efekrkyn/UGV-01/UGV-01/docs/renders/UGV-01-A1-exterior-concept.png

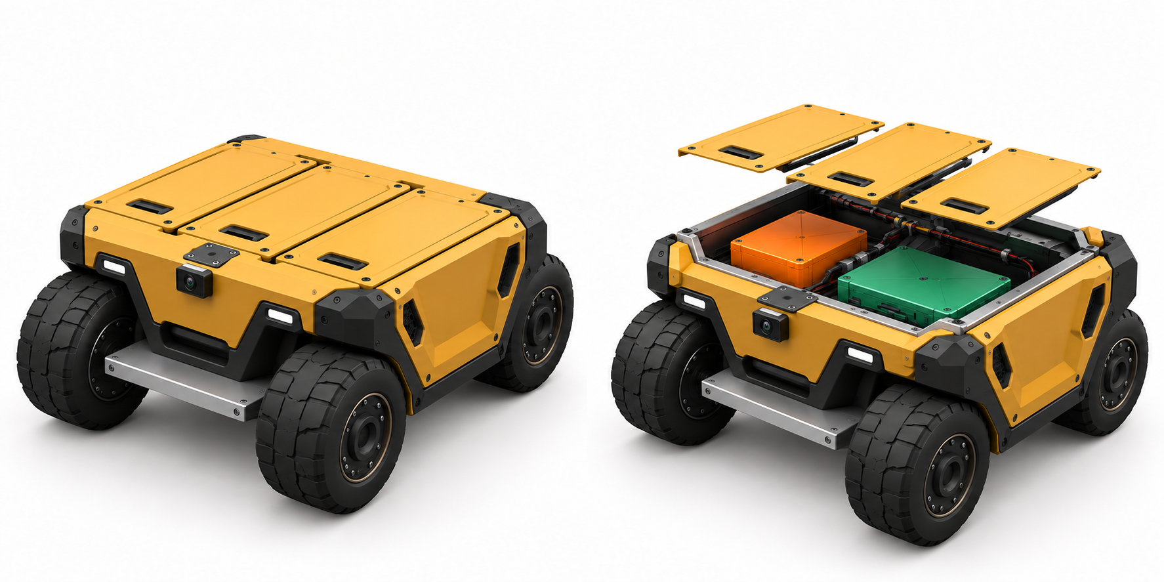
UGV-01/docs/renders/UGV-01-A1-exterior-concept.png
