efekrkyn/UGV-01/README.md

# UGV-01

Küçük, dört tekerli, iki kamera gözlü ve 5 eksenli kollu bir 3D baskı Ar-Ge robotu. Sesli komut ve yapay zekâ ile yönetilecek şekilde tasarlandı; her komut yerelde denetlenir, "dur" ve donanım acil stop her zaman öndedir.

- **Proje, CAD, elektronik, firmware ve yazılım:** [UGV-01/README.md](UGV-01/README.md)
- **Tanıtım filmi ve müziği:** [UGV-01/media/film](UGV-01/media/film/README.md)

Durum: tasarım ve masaüstü kontrolleri tamam; baskı ve fiziksel testler henüz yapılmadı.
