efekrkyn/UGV-01/UGV-01/electronics/ugv_lite_01/README.md

# UGV-LITE-01 bağlantı şeması

A3 Lite: hazır modüllerle (ESP32-S3-DevKitC-1, 2 × TB6612FNG, 3 × Mini560 (mantık rayı + M3'te iki servo rayı A/B, EN = `ACT_EN`), 2 × VL53L0X, 74AHCT1G125) delikli pertinaks kurulumu. DD69: her motor çıkışında 7,5 Ω 10 W balast (R301–R304), dört motorda enkoder A kanalı, E-stop'un ikinci NC kontağı GPIO2'de (SW903, R921/R922/C921), batarya bölücüsü 100 k/22 k. [Şema](lite_wiring.kicad_sch) ve [PDF](lite_wiring.pdf) `tools/build_lite_wiring.py` ile [pin haritasından](../../config/esp32_pinmap.json) üretilir; `tests/check_lite_wiring.py` netlist ve ERC'yi denetler. Ayrıntı: [Lite elektronik](../../docs/lite_electronics_A3.md). **PCB değildir; modül pin sıraları satın alınan kartla doğrulanır.**
