efekrkyn/UGV-01/UGV-01/docs/design_review_response.md

# D2A bağımsız tasarım incelemesi — teknik karşılık

23.09.2026 · Kaynak: [gelen inceleme](design_review_findings.md). Bu belge karar ve açık kanıtları ayırır. Masaüstü kontrolü üretim, montaj veya saha PASS sonucu değildir. Raporda “8” denmesine karşın TIM1/TIM8 başlığıyla **dokuzuncu** teknik bulgu da vardır.

| Bulgu | Doğrulama ve karar | Bu revizyonda yapılan | Kapanış kanıtı |
|---|---|---|---|
| 1.1 J-PWR montajı | İncelemenin z81'i çıplak PCB yüzeyi sayması düzeltildi: z57–81 **kart+bileşen hacmi**, önerilen PCB yüzeyi z58,6; 16,78 mm takılı yükseklik z75,38'e çıkar. Bu yalnız nominal dikey uygunluktur. 4 pin dik açılı **76825-0004** adayı korunur; yatay çıkış/servis ve dış y kenarı hâlâ açık. | [Pin/footprint sözleşmesi](../config/pwr_mcu_connector.json), KiCad pad testi, [kesit ve servis hesabı](electronics_packaging_gate.md) kaydedildi. | Üretici 3B model + mating housing + AWG12 büküm ve mandal/alet süpürmesi tam montaj CAD'inde çakışmasız; sökme sırası belgeli; termal pin derating geçer. **Açık/P0.** |
| 1.2 Kütle | D2A `5,9328 kg` hesap, `67,2 g` boşluk. Kablo ve bağlantı elemanları için 0,30+0,20 kg **zaten bütçede**; tekrar eklemek çifte sayım olur. Gerçek kalemler bu tahsisleri aşabilir. 0,25 kg tasarım marjı için en az `0,1828 kg`, 0,30 kg için `0,2328 kg` ilave net kazanım gerekir. Dört taşıyıcıdan 25 g silmek yalnız 0,10 kg kazandırır; 101 g/parçanın yaklaşık %25'i olduğundan körlemesine cep açılmaz. | [Kütle bütçesi](mass_budget.md) ve karar kapısı düzeltildi. | Gerçek BOM/slicer/harness/vida tartımı; seçilen hafifletme için yatak ve M4 yük yolu/yorgunluk hesabı; montaj marjı ≥0,25 kg veya gerekçeli kütle gereksinimi revizyonu. **Açık/P1.** |
| 1.3 TPU yanağı | D1'de iki jant omzu ve sekiz tork tırnağı var; bunlar pozitif aksiyel kilit kanıtı değil. 8 kg dört teker statik eşit yükte μ=1 için yaklaşık 19,6 N/teker; rapordaki 40 N bir yük aktarımı/pivot tarama senaryosu olabilir, sabit ölçüm değildir. | Risk ve T16'ya yanağın işaretlenmesi/eksenel kayma kontrolü eklendi. | Beadlock/dovetail prototip CAD'i, sökülebilirlik ve baskı yönü; iki yönde 40 N ön tarama + pivot çevrimleri sonrası ayrılma yok. **Açık/P1.** |
| 1.4 Oldham/eksenel | Kaplin serbest diskli; CAD'deki `UGV-MECH-044` aslında **dış rulman bileziği**, kaplin `REF-RULAND-OLDHAM`. Mevcut 21,5 mm nominal zincir endplay'i kanıtlamıyor. Raporun “sıfır aksiyel boşluk” şartı tolerans/ısıl genleşmede rulmanı sıkıştırabilir; ölçülmüş kontrollü endplay gerekir. 1–1,5 mm kaplin aralığı da üretici ve gerçek motor miliyle doğrulanmadan sayısallaştırılamaz. | [Karar kaydı](design_decisions.md) ve test kapısı netleştirildi. | Üretici kaplin montaj açıklığı, rulman/segman/şim tolerans yığını, ölçülmüş sıcak/soğuk endplay ve eksenel yükte serbest dönüş. **Açık/P1.** |
| 2.1 Kabloda I²C | 0,4 m tek uçlu I²C, motor ortamı için doğrulanmamış; **P0 kabul edilmedi**. INA228 ve Kelvin şönt PWR üzerinde yakın kalır; 0,4 m yüksek ortak modlu mikrovolt Kelvin girişini MCU'ya taşımak da ölçüm/arıza riski yaratır. [NXP PCA9615](https://www.nxp.com/products/interfaces/ic-spi-i3c-interface-devices/ic-bus-repeaters-hubs-extenders/two-channel-multipoint-fast-mode-plus-differential-ic-bus-buffer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) ile SCL ve SDA ayrı diferansiyel çiftler olur. | J-SIG 10→12 pin, [KiCad kablo çizimi](../electronics/interconnect/pwr_mcu_harness.kicad_sch) 16 net; [iki PCA9615 referans devresi](../electronics/interconnect/differential_i2c_reference.kicad_sch) 3,3 V/5 V besleme, çift uç sonlandırma ve `EN` bağlantılarıyla ERC'den geçti. | `PGOOD` kaynakları ve PCA9615 gerçek kart şematiklerine taşınacak; 100 kHz EMI/tek damar kopuğu/bus recovery bench testi. Akım sınırlama ölçüm telemetrisinden bağımsız. **Referans devre çizildi; üretim kart devresi açık/P0.** |
| 2.2 PGND referansı | 50–150 mV DC düşüm tek başına tipik 3,3 V dijital eşikleri aşmaz; endüktif transient ve ortak dönüş akımı yine ölçülmelidir. RC'yi MCU_WDI'ya körlemesine koymak sağlıklı darbenin kenarını da bozabilir. PWR_ACT_EN fiziksel izin, yerel pulldown ve nSLEEP/break'e doğrudan etki etmeli. | [Arayüz sözleşmesinde](pwr_mcu_interface.md) tek-GND/ground-bounce ve test gereği korundu; sayısal eşik uydurulmadı. | T02'de 15 A yük/tek GND açık, osiloskopla referans ve kenar ölçümü; şematikte alıcı eşik/histerezis/filtre ve darbe genişliği hesabı; yanlış izin yok. **Açık/P1.** |
| 2.3 Geri besleme | PWR aktif/MCU kapalıyken gelen altı High hat ESD diyodu üzerinden rayı besleyebilir. 1 kΩ ile tek girişte yaklaşık `(3,3−0,7)/1000 ≈ 2,6 mA`; altı girişte yaklaşık 15,6 mA toplam olabilir. Seri direnç **tek başına** güçsüz rayı güvenli yapmaz. | [SN74LVC244APWR kısmi KiCad sayfası](../electronics/ugv_mcu_01/status_receiver.kicad_sch): VCC=0 `Ioff` ≤20 µA/pin, altı kanal, 10 kΩ çıkış pulldown ve OE pull-up netlistte doğrulandı; altı PWR sürücüsü henüz bağlı olmadığından ERC açık. | Gerçek kartta OE/`PGOOD` ve nSLEEP bağlantısı, 0–1,65 V brownout, tüm hatlar ve güç kombinasyonları için hesap + ölçüm; PWR_ACT_EN kopukta Low. **Parça ve kısmi çizim var; açık/P0.** |
| 3.1 E-stop eğim | `8×9,80665×sin(15°)≈20,3 N` geri kaydırır; coast elektriksel enerjiyi keser ama aracı tutmaz. `11` fren enerjisi/VM clamp/kesici sırası ölçülmeden E-stop'un güvenli duruşu yerine geçmez. | [Güvenlik sınırı](safety_architecture.md) ve [T16](test_plan.md) halat+takoz+geri kayma ölçümüne bağlandı. | T13/T16 düşük enerjili eğim testi; bağımsız tether. Sahipsiz eğim/park hedeflenirse normalde kapalı mekanik fren ek gereksinimi. **V1 operasyonel kısıt; fiziksel test açık/P1.** |
| 3.2 TIM1/TIM8 | İki timer faz kayması istenmeyen `11` darbesi oluşturabilir. Master/slave başlatma tek başına atomik güncelleme garantisi değildir; `00` ara durum, preload/update sırası ve break birlikte ölçülmeli. | [Firmware sözleşmesi](software_architecture.md) ve T05 logic analyzer kabulü eklendi. | Gerçek STM32 timer kurulumu, tüm dört IN1/IN2 izleri, reset/duty/yön geçişi ve fault testinde istenmeyen `11` yok. **Açık/P1.** |

Tam kart şematiği, tam montaj CAD'i, PCB layout ve fiziksel numune henüz yok. P0 arayüz tanımı, diferansiyel I²C referansı ve iki kısmi kart arayüz sayfası ilerledi; güvenlik zinciri ve fiziksel doğrulama bunların dışında. PH4/5/6/7 kapıları açık kalır. D2A'nın baskı ve gerçek testleri kullanıcının belirttiği süre boyunca beklemededir.
