efekrkyn/UGV-01/UGV-01/docs/k2_reference_schematic.md

# K2 referans şeması ve ayar zarfı

24.09.2026 · PH6/P0. [KiCad K2 referans şeması](../electronics/ugv_pwr_01/k2_reference.kicad_sch) ve [PDF](../electronics/ugv_pwr_01/k2_reference.pdf), `MID → Q1 → 1 mΩ Kelvin şönt → Q2 → ACT_BUS` adayını gerçek pinlerle gösterir. Bu, **tam UGV-PWR-01 şeması veya güvenlik onayı değildir**. Değerler [TI LM74900-Q1 Rev C](https://www.ti.com/lit/ds/symlink/lm74900-q1.pdf) ve [CSD18540Q5B Rev B](https://www.ti.com/lit/ds/symlink/csd18540q5b.pdf) üzerinden hesaplandı. Şöntün exact MPN/footprint'i, K1, ön şarj/bleed, güvenlik izni, motor yükü ve PCB bakırı henüz tamamlanmadı.

| Ağ / parça | Aday | İşlev ve sınır |
|---|---|---|
| Q1/Q2 | 2×CSD18540Q5BT, 60 V | Q1 ideal diyot, Q2 seri kesici; ortak dren bölgesine R1 girer. K2 kısa arızasında K1 bağımsız kesmelidir. |
| U1 | LM74900QRGERQ1, Texas RGE0024C 4×4 mm | `DGATE` Q1 gate; `HGATE` Q2 gate; `A=MID`, `C/VS` R1 önünde, `OUT=ACT_BUS`. Pad25 `RTN` **GND'ye bağlanmaz**; yalnız elektriksel olarak yüzen lehimli bakır ada. |
| R1/R2 | 1 mΩ ±%1 dört uçlu / 49,9 Ω ±%1 | R1'in iki Kelvin ucu kontrol pinlerine ayrılır; yüksek akım padleri ölçüm yolu değildir. R2 `CS+` ölçekleme direncidir. R1 footprint ve ≥3 W sınıfı sıcaklık/darbe kapasitesi exact ürünle kapanacak. |
| R3/R4/C1 | 31,6 kΩ ±%1 / 100 kΩ / 68 nF ±%10 | Yaklaşık 18,95 A nominal OCP; R4 üreticinin latch-off örneği; timer yaklaşık 0,99 ms nominal. OCP sonrası `EN` yeniden High edilerek kendiliğinden ARM yok: ayrı manuel-reset güvenlik kilidi gerekir. |
| `ISCP` | Pin18 doğrudan `VS`/şöntün yukarı tarafına | Varsayılan 20 mV kısa devre eşiği. `ISCP` boş bırakılamaz: bu, korumayı kaldırır. |
| C2/C3/C4 | 100 nF CAP–VS / 100 nF VS–PGND / 10 nF CS+–CS− | Yerleşimde IC ve şönt yakınlığı gerekli; CS filtresi hızlı SCP gecikmesini laboratuvarda etkilemediği gösterilmeli. İki FET'in katalog azami `Ciss` toplamı 8,46 nF, TI `C_CAP ≥ 10×ΣCiss` önerisi ≥84,6 nF; 100 nF nominal yalnız %10 kapasitör alt sınırında da 90 nF ile geçer. DC bias ve sıcaklık düşüşü ayrıca kontrol edilir. |
| R5 / `SAFE_EN` | 10 kΩ PGND pulldown, SLEEP=EN | Güvenlik donanımı `EN`'i Low tutar. `SLEEP Low / EN High` iç bypass nedeniyle E-stop değildir. `SAFE_EN` kaynağı [güvenlik kapısında](../electronics/ugv_pwr_01/safety_gate.kicad_sch) NC-B beslemeli SN74LVC1T45'tir (`SAFE_GATE ∧ K2_CMD`). |
| R8–R11 | UV 200k/10k, OV 300k/10k, ±%1 | UV kesme 11,55 V nominal, ilk yükselme 12,6 V; OV açma 18,6 V nominal. Bunlar BMS/TVS veya rejeneratif ACT clamp'in yerine geçmez. |
| R6/R7 | FLT için 10 kΩ 3,3 V pull-up; IMON için 5,6 kΩ PGND | FLT, [ARM I/O](../electronics/ugv_pwr_01/arming_io.kicad_sch) TCA9534A P6 girişine gider; UVLO'da da düştüğü için donanım latch girişi bilerek bağlanmadı. IMON 23 A tipikte yaklaşık 2,32 V; ADS1115 AIN3'e 1 kΩ seri dirençle gider. |

**Eşik toleransları:** TI OCP tipik formülü `I_OC = 12·RSET/(RSENSE·RILIM)` verir: `12·49,9/(0,001·31600)=18,95 A`. TI yükselen karşılaştırıcı sınırları 1,08/1,22/1,32 V ve üç direncin ±%1 kombinasyonu ile ilk yaklaşık OCP aralığı **16,28–21,13 A** olur. SCP katalog 17,86/20/22,77 mV ve 1 mΩ ±%1 ile **17,68–23,00 A** olur. SCP bazı tolerans köşelerinde OCP'den önce, bazı köşelerde sonra gelir; bu iki koruma aynı kesin sınır gibi sunulmaz. Katalog timer akımı 65–97 µA, kesme gerilimi 1,1–1,4 V ve C1 ±%10 ile basit `C·V/I` taraması **0,69–1,61 ms** verir; TI'nin nominal 82,3 µA formülü yaklaşık0,99 ms. PCB paraziti, filtre ve gerçek transient ayrıca ölçülecek.

**Neden 31,6 kΩ:** Dört DRV8874 için her köprüde 2,915 A statik üst akım sınırı taslağı 11,66 A eder. 6 V×4 A servo rayı, 12,4 V batarya ve varsayılan %85 verimde 2,28 A giriş ister; birlikte yaklaşık **13,94 A**. OCP'nin 15 A tipik seçimi alt toleransta yaklaşık12,8 A'a düşerek bu zarfı kesebilir. 31,6 kΩ'un alt köşesi 16,28 A'dır; yine servo stall/dinamik akım ölçülmeden yeterli marj ilan edilmez. F1=15 A sigorta anlık 15 A kıskacı değildir ve `I²t`/kablo koordinasyonu açık. K2'nin 15 A sürekli termal onayı da açık; OCP yüksek ayarı onu vermez. Motorlar normal çalışmada ayrı köprü akım sınırlaması ve MCU RMS kısıtı altında kalmalıdır.

**Güç/ısı:** R1'de 15/20/23 A için sırasıyla0,225/0,400/0,529 W; sıcak FET `RDS(on)=2×2,2 mΩ` senaryosunda iki FET toplamı1,98/3,52/4,66 W. Bu senaryo garantili sıcak maksimum değildir. 50 °C kasa havası ve her FET için 1 in²/2 oz bakıra dayanan 50 °C/W katalog termal koşulu 120×80 mm PWR kartında otomatik sağlanmaz. MOSFET SOA, 60 V dren transiyenti, ters/yenilemeli akım ve R1 sıcaklığı gerçek yerleşimle incelenmeden PCB serbest bırakılamaz.

**Şema kontrolü:** [Netlist testi](../tests/check_k2_reference.py) U1 fiziksel pinleri, iki FET, Kelvin ucu, EN/SLEEP ve elektriksel yüzen pad25'i kontrol eder. 24.09.2026'dan beri sayfa [UGV-PWR-01 kısmi hiyerarşisinin](pwr_safety_path.md) parçasıdır: sayfalar arası ağlar global etikettir ve `PGND` PWR_FLAG'i arayüz sayfasına taşındı. Tek başına ERC artık 1 beklenen hata (U1 GND pin13 `PGND`'nin sürücüsü başka sayfada) ve 4 uyarı verir: 3 yerel `UGV` kütüphane çözümlemesi ve harici `PWR_3V3` tek-pin etiketi. Birleşik kök ERC'si 0 hatadır; [check_pwr_board](../tests/check_pwr_board.py) `SAFE_EN` sürücüsünü, pad25'in yüzdüğünü ve izin mantığını denetler. Netlist/şema fiziksel T01/T13 ölçümü yerine geçmez.
