efekrkyn/UGV-01/UGV-01/docs/review_dd92_dd93_2026-09-30.md

# DD92–DD93 bağımsız doğrulama — 30.09.2026

**Sonuç: düzeltmelerin önemli bir bölümü doğrulandı; “A01–A08 ve M01–M03 tamamen kapandı” sonucu desteklenmiyor.** İki P1 ve dört P2 bulgu kaldı. Mevcut testlerin geçmesi bu karşı örnekleri kapsamıyor. Üretim veya sürüş onayı verilmedi.

İnceleme, `42524c9d271edaa842ca49b30e2747520887d61b` üzerine bırakılmış, commit edilmemiş DD92/DD93 çalışma ağacına yapıldı. Kaynak, config ve mevcut dokümanlar değiştirilmedi. Yalnız bu rapor ve yeniden üretim kanıtları eklendi. Önceki [tam inceleme](review_full_2026-09-29.md) ve Claude'un [kapanış kaydı](review_full_closure_2026-09-29.md) korunmuştur. Bu rapor kapanış iddialarını doğrular; önceki tam incelemenin fiziksel kabul kapılarını kaldırmaz.

## Doğrulama sonucu

| Kontrol | Bağımsız sonuç | Sınır |
|---|---|---|
| `tests/README.md` masaüstü takımı | **34/34 PASS** | Modeller ve yazılım testleri |
| ESP-IDF 5.3.2 Docker derlemeleri | **ESP32-S3 ve ESP32-CAM PASS** | Donanıma yükleme yapılmadı |
| Graf/pin/hesap/CAD/baskı planı yeniden üretimi | **8/8 komut PASS**, manifestte anlamsal fark yok | İzole çalışma kopyasında |
| Üretilen mekanik | **103 STEP parçası, 74 baskı parçası, 42 M3 insert** | Satın alınan referans zarfları da STEP sayısında |
| Nominal kol açıklığı | park→kaldır **4,75 mm**, hazır→öne-orta **5,26 mm** | 1° örnekleme; sürekli hareket ispatı değil |
| Parktaki ±1° beş eklem toleransı | **4,1 mm**, 32 köşe | Baskı, boşluk, esneme ve kalibrasyon ölçülmedi |
| Fiziksel T01–T20 / TL1–TL6 | **NOT_RUN** | Tasarımın çalıştığı iddiası kurulamaz |
| Başlangıç kaynak parmak izleri | **219/219 değişmemiş** | İnceleme sırasında mevcut dosyalar korunmuş |

Komutlar ve sonuçlar [verification.json](review_evidence/dd92_dd93_2026-09-30/verification.json) içindedir. Yeni karşı örnekler aşağıda ayrıca listelenmiştir; bunları mevcut 34 testin PASS sonucuna katmadım.

## Önceki bulguların kapanışı

| Kimlik | Durum | Gerekçe |
|---|---|---|
| A01 | Doğrulandı | 32 baytlık anahtar şartı; eksik/geçersiz anahtarla komut ve telemetri reddi |
| A02 | **Kısmi — R01** | Eski `1200 mm + hata` örneği kapanmış; `8190/8191 + hata` hâlâ açık yol |
| A03 | Doğrulandı | Gerçek yerel WebSocket sunucusunda yabancı/eksik Origin 403, ikinci sahip 1008, yanıt doğru sokete, kopuşta izin düşüyor |
| A04 | Eski örnek kapandı; **yeni R02 açık** | Kaybolan aç komutu sürüşü serbest bırakmıyor; reset ve manuel park pençe bilgisini güvenli biçimde uzlaştırmıyor |
| A05 | **Kısmi — R03** | Tek hedefte 255 cevapsız komut hatası doğru; tekrarlanan hedeflerde 12 bit yankı yine alias yapıyor |
| A06 | Doğrulandı | Semantik olarak reddedilen kenar uygulanmış-komut yankısını ilerletmiyor |
| A07 | Doğrulandı | Açık yeniden kurma yeni oturum ve doğrulanmış telemetriyle bağı yeniliyor; reset ortasında hareket sahte başarıya dönüşmüyor |
| A08 | Ana sayısal düzeltmeler doğrulandı | 15 A, baş 1,6 mm, açıklık taraması 1°, güncel CG kayıtları; yeni pençe kavrama datumu için R06 kaldı |
| M01 | **Kısmi — R05/R06** | Hareketli çeneler gerçekten modellenmiş; B çenesinin eksenel tutma/montajı ve gerçek kavrama noktası tamamlanmamış |
| M02 | Bağlantı konsepti doğrulandı | Sekiz cıvata ve insert/delikler var; aşağıdaki G01 dayanım doğrulaması açık |
| M03 | **Kısmi — R04** | Omuz bileziği/pul var; sol üst kolun sonraki bağlantısının yük yolu yok |

## Kalan bulgular

### R01 — P1: Geçersiz ToF sonucu açık yol olarak kullanılıyor

Kaynak: [vl53l0x.c:150](../firmware/lite/vl53l0x.c#L150), özellikle `reading()` içindeki `status 4/6/9 && mm >= 8190` dalı. [Mevcut test](../tests/vl53l0x_test.c#L125) bu istisnayı beklenen davranış olarak kodluyor.

Gerçek sürücüyü register modeliyle çalıştırdım: iki sensörde raw status 4, 6 ve 9 + 8190 mm ayrı ayrı **8190,8190** döndürüyor. Çekirdek bu sayıyı geçerli uzak mesafe gibi kullanıyor; sıfır/200 mm engel kilidi devreye girmiyor. Raw kod ile API `RangeStatus` kodu aynı şey değildir; bu kodların sinyal/faz hatası olması, ortamın boş olduğunu kanıtlamaz. ST, sinyal hatasını yetersiz mesafe güveni, faz hatasını wraparound/gürültü olarak tanımlar. [ST UM2039, §5.3/Table 1](https://www.st.com/resource/en/user_manual/um2039-world-smallest-timeofflight-ranging-and-gesture-detection-sensor-application-programming-interface-stmicroelectroni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).

Bu, fiziksel olarak siyah/cam bir hedefe çarpıldığı iddiası değildir; yazılımın güvensiz ölçümü “açık” sınıfına yükselttiğinin kanıtıdır. Açık alanda bir kez aynı kodu görmek bu ayrımı doğrulamaz. Geçersiz ölçümü bilinmeyen/engelli tut; açık alan politikasını gerekiyorsa ayrıca tasarla ve açıkça sınırlandır. Kalıcı testte 8190 ve 8191 dahil tüm hata kombinasyonları eski geçerli ölçümü düşürmeli ve ileri kilidini korumalı.

Kanıt: [tof_invalid.c](review_evidence/dd92_dd93_2026-09-30/tof_invalid.c).

### R02 — P1: Yeniden başlatma ve manuel park pençe güvenlik durumunu geri getiriyor

Kaynak: [lite_core.c:29](../firmware/lite/lite_core.c#L29), [park_confirm():38](../firmware/lite/lite_core.c#L38).

İki bağımsız C karşı örneği:

1. `ready`de pençeyi tamamen aç → IDLE ile aktüatörleri kapat → elle kol parkı için 0x123 → yeniden ARM. **Kol STOW, pençe hedefi/konumu 6000, PWM 2167 µs, ACT_EN=1.** `park_confirm` beş kol eklemini parkta varsayıyor, pençenin eski açık hedefini koruyor. Operatör pençeyi elle kapatmış olsa bile yeniden kurulunca eski açık PWM geri gönderilir. Açık STOW katı modelinde çene 055 ile yan panel 010 kesişimi **236,965 mm³**; ayrıca kapak/çamurluk kesişimleri var. DD93'ün kendi mekanik kuralına göre de parkta açık çene yan duvara çarpar; yeni bir “aç” komutu gerekli değildir. Bu fiziksel çarpışma deneyi değil, gerçek firmware çıkışı ile CAD'in birlikte gösterdiği tehlikedir.
2. `reach_low`da kavrama kapanışı → park: **empty=0, sürüş yasak**. MCU yeniden başlat → IDLE/park onayı/ARM; pençe açılmadan **empty=1, sürüş izinli, dört PWM=287‰**. `lite_core_init` nesnenin bırakıldığına ilişkin kanıt olmadan boş işaretini geri kuruyor. Bu bir durum modeli karşı örneğidir; gerçek bir nesneyle fiziksel deney yapılmadı.

Ek gözlem: `ready`de aç→kapat da boş işaretini temizlemiyor; yalnız üç GRASP düğümü nesne kavrayabilir varsayımı mekanik olarak garanti edilmiyor. Bunu reset düzeltmesinden ayrı bir politika testi olarak ele al.

Kurtarmada kol, pençe hedefi/konumu ve boş/bilinmeyen bilgisi birlikte uzlaştırılmalı. Otomatik açma veya kapanmayı parkta çözüm sayma; yeni hareket güvenli poz bilinmeden başlatılmamalı. Manuel onay kullanılacaksa operatörün **kapalı ve boş pençeyi** doğruladığı açık sözleşme, host mesajı ve firmware kapısı olmalı. Watchdog, güç kesme, IDLE, E-stop, eski aç hedefi, paket kaybı ve yeni oturum kombinasyonlarını kalıcı testlere taşı.

Kanıt: [gripper_park_open.c](review_evidence/dd92_dd93_2026-09-30/gripper_park_open.c), [gripper_empty_reset.c](review_evidence/dd92_dd93_2026-09-30/gripper_empty_reset.c).

### R03 — P2: 12 bit ACK tekrarlanan hatalarda hâlâ sahte onay veriyor

Kaynak: [vehicle.py:194](../software/ugv_lite/vehicle.py#L194), özellikle `_answers`, `set_arm` ve `hold_arm`.

Aynı oturumda **bütün 0x122 paketlerini düşür**, `arm stow` isteğini 17 kez tekrarla. İlk 16 istek 255 gönderimde doğru hata verir. 17. istekte **seq=4097, echo=0, answered=True, sonuç ok=True**. Çekirdek hiçbir kol komutu almamıştır. Yeni hedef `arm_fault`u temizler; hedef başına 255 sınırı toplam cevapsız akışı 4096'dan önce durdurmaz.

Bu örnekte kol zaten stow'dadır; yanlış duruşa ulaşıldığı veya doğrudan çarpışma olduğu iddia edilmez. Sorun “çekirdek bu isteği aldı” sözleşmesinin bozulmasıdır. Önceki ACK ile yeni komut penceresini alias yapamayacak biçimde ayır; cevapsız hatadan sonra açık oturum kurtarması da bir seçenek. Yalnız sıfır yankıyı atlamak yetmez: eski sıfır olmayan ACK de 4096 sonra eşleşebilir. Testler ardışık başarısız hedefleri, hold, eski sıfır olmayan yankı ve 16 bit sarımını kapsamalı.

Kanıt: [software_recheck.py](review_evidence/dd92_dd93_2026-09-30/software_recheck.py).

### R04 — P2: Pasif sol kolun A→B bağlantısı modellenmemiş

Kaynak: [build_concept.py:548](../cad/assembly/build_concept.py#L548), [sağ kola özel adaptör:606](../cad/assembly/build_concept.py#L606); [mekanik belge](lite_mechanical_A3.md) “sol eklemler kendi cıvatalarıyla sabit” diyor.

Sol kol sağın boş servo/rulman yuvalarını kullanıyor. B'nin iki M3 deliği sağ kolda 059 adaptörüne gider; **sol 059, twist rulmanı veya bunların yerini alan sabit bağlantı yok**. Bağımsız CAD ölçümünde sol 050 ve 051 arasında **1,0 mm minimum boşluk** var. Omuzda tasarlanan bilezik bu sonraki eklemi bağlamaz; vida listesi de sol için tamamlanmış alternatif bağlantı vermez.

Pasif sol uzuvlar için gerçek sabit bağlantı/ara parça tasarla veya açıkça tanımlanmış birleşik üretim parçasına dönüştür. Cıvata karşılıkları, eksenel tutma ve yük yolu CAD/BOM/montajda bulunmalı. Diğer pasif eklemleri de aynı yük yolu incelemesinden geçir; yalnız çarpışma testi yeterli değildir.

### R05 — P2: B çenesinin pim bağlantısında sıkma ile dönme ayrılmamış

Kaynak: [palm postu:585](../cad/assembly/build_concept.py#L585), [B çenesi:603](../cad/assembly/build_concept.py#L603), [vida listesi:140](../tools/print_plan.py#L140).

7 mm kalınlıktaki dönen çene M3 geçiş deliğiyle, avucun 2,5 mm pilot deliğine giren M3×16 vida altında tutuluyor. Post ile çene arasında 0,5 mm açıklık var. **Omuzlu pim, sıkmayı taşıyan burç/spacer, belirlenmiş eksenel boşluk veya gevşek vidayı kilitleme prosedürü yok.** Vida normal montaj gibi sıkılırsa çeneyi sıkıştırır; gevşek bırakılacaksa boşluk ve tutma tarif edilmemiştir. İdeal eksen etrafında CAD dönüşü bu montaj sorununu denetlemiyor.

Bu bulgu fiziksel sıkışma ölçümü değil, tekrarlanabilir üretim/montaj tarifinin eksikliğidir. Eksenel tutma ve serbest dönmeyi ayıran bir çözüm seç, ölçülendir, BOM'a ekle; çene/post boşluğu ve montaj torkunu tanımla. Kupon testinde vida son montaj koşulundayken 0–60° hareketi ve boşluğu ölç.

### R06 — P2: Yeni çenelerin gerçek kavrama merkezi eski datumdan yaklaşık 18 mm farklı

Kaynak: [grip_point():723](../cad/assembly/build_concept.py#L723), [TPU pedler:622](../cad/assembly/build_concept.py#L622), [payload hesabı:98](../tools/body_mass_screen.py#L98).

`grip_point()` hâlâ eski `xw+L3, side*YA, zs` noktasını “kavrama merkezi” olarak yayınlıyor. Yeni kapalı TPU pedlerin ortak yüzünün orta noktasını katılardan bağımsız hesapladım:

| Poz | Belgelenen/manifest nokta mm | Gerçek ped orta noktası mm | Fark |
|---|---|---|---:|
| öne-orta | 265,3 / −10,0 / 45,3 | 281,13 / −11,83 / 53,53 | **17,94 mm** |
| depola | 125,0 / −25,8 / 233,0 | 108,50 / −18,95 / 231,42 | **17,93 mm** |

Diğer pozlarda da yaklaşık aynı rijit ofset var. Bu nokta belge ve manifestin yanı sıra eldeki nesne/kargodaki yük yerleşimi hesabına giriyor. Kargo ağzının kaçırıldığı veya mevcut devrilme kriterinin bozulduğu gösterilmedi; mevcut yayınlanan kavrama koordinatı gerçek parçayla aynı değil.

Gerçek tool/grasp datumunu çene/ped geometrisinden tek kaynakta tanımla; kapalı/açık ve farklı nesne kalınlıklarının anlamını belirt. Manifest, doküman, fizik modeli ve ilgili dönüşümleri yeniden üret. Gerçek kargo merkezini, bırakma noktasından ayrı tut. Geometriye karşı datum testi ekle; kalibre edilmiş kamera→kol dönüşümü daha sonra bunun üzerine kurulmalı.

Kanıt: [geometry_recheck.py](review_evidence/dd92_dd93_2026-09-30/geometry_recheck.py), [ölçümler](review_evidence/dd92_dd93_2026-09-30/geometry_measured.json).

## Açık doğrulama kapıları

**G01 — Şasi eki dayanımı:** sekiz bağlantı gerçekten var. Ancak mekanik belgedeki “3,5 N·m → 90 N cıvata kesmesi → 6 MPa PETG ezilmesi → 6 kat pay” hesabı, düşey cıvatalı plaka/kiriş ekinin düzlem dışı eğilmede oluşturduğu **eksenel cıvata/insert çekmesi, plaka esnemesi ve prying** yüklerini kapsamıyor. Mevcut hesabı tüm ekin doğrulanmış güvenlik katsayısı gibi kullanma. Serbest cisim diyagramı ve gerçek kol mesafeleriyle yük yolunu hesapla; baskı yönü, insert çekip çıkarma ve sehim deneyi gerekli.

**G02 — Baskı/servo/pençe:** park toleransının 4,1 mm olması olumlu. Bağımsız ek **0,25° çene taramasında 241 örnekte kendi parçalarıyla çarpışma yok**. Park→kaldır boyunca 91 omuz açısı ×32 adet ±1° hata köşesinde, sağ yan panellere minimum açıklık **4,100013 mm**. Bu ikinci tarama yalnız yan duvarlara yöneliktir; bütün engellerin toleranslı taraması değildir. Katı model sonuçları gerçek servo hatası, dişli boşluğu, kablo yükü ve PETG esnemesini kapsamaz. 150 g tutma kuvveti ve TPU sürtünmesi katalog/model varsayımıdır. Sol omuz için 0,24/(0,0151×0,5) ≈32 N hesabı tutarlı; gerçek sürtünme ve creep ölçülmemiştir.

**G03 — Elektrik ve özgün kapsam:** E-stop DC kesme değeri, 15 A sigorta koordinasyonu, Mini560 EN ve termal/geri sürülme sınırları önceki rapordaki gibi açık. Aktif revizyon A3 Lite ESP32 + MacBook mimarisidir; ilk CM5/STM32/özel PCB/ROS 2 hedefinin tamamlandığı anlamına gelmez. Tanıtım filmi yeni çenelerin doğrulama kanıtı değildir.

## Yeniden üretim

Depo kökünde çalıştır. Gerçek anahtar, donanım veya ücretli API kullanılmaz. C karşı örnekleri mevcut test yardımcılarını yeniden kullanır. Betiklerde kusurlu mevcut çıktıların assert edilmesi **hata üretildi** demektir; güvenli davranış kabul testi PASS'i değildir. Düzeltirken beklentileri güvenli davranışa çevirip kalıcı testlere taşı.

```sh
cc -std=c11 -Wall -Wextra -Werror docs/review_evidence/dd92_dd93_2026-09-30/tof_invalid.c firmware/lite/vl53l0x.c -o /tmp/ugv-review-tof
/tmp/ugv-review-tof
cc -std=c11 -Wall -Wextra -Werror docs/review_evidence/dd92_dd93_2026-09-30/gripper_park_open.c firmware/lite/lite_core.c firmware/lite/arm_path.c firmware/lite/lite_link.c firmware/lite/hmac_sha256.c firmware/stm32/can_protocol.c firmware/stm32/servo_control.c firmware/stm32/light_bar.c -lm -o /tmp/ugv-review-park
/tmp/ugv-review-park
cc -std=c11 -Wall -Wextra -Werror docs/review_evidence/dd92_dd93_2026-09-30/gripper_empty_reset.c firmware/lite/lite_core.c firmware/lite/arm_path.c firmware/lite/lite_link.c firmware/lite/hmac_sha256.c firmware/stm32/can_protocol.c firmware/stm32/servo_control.c firmware/stm32/light_bar.c -lm -o /tmp/ugv-review-empty
/tmp/ugv-review-empty
python3 docs/review_evidence/dd92_dd93_2026-09-30/software_recheck.py
python3 docs/review_evidence/dd92_dd93_2026-09-30/websocket_recheck.py
.venv/bin/python docs/review_evidence/dd92_dd93_2026-09-30/geometry_recheck.py
```

WebSocket kontrolü kurulu `websockets` paketini gerektirir; CAD venv'inde bulunmayabilir. Geometri betiği ihracat yapmaz, sonuçları stdout'a yazar ve uzun tarama birkaç dakika sürebilir.

## Claude'a verilecek düzeltme promptu

```text
UGV-01 deposunda docs/review_dd92_dd93_2026-09-30.md raporunu ve
docs/review_evidence/dd92_dd93_2026-09-30/ kanıtlarını oku. DD92/DD93'ün
mevcut 34/34 ve iki ESP32 build PASS sonuçları tüm bulguların kapanışı değildir.

Önce karşı örnekleri mevcut kodla yeniden üret. Sırasıyla:
1. R01: hatalı ToF sonucunu 8190/8191 olsa da açık yol sayma. Raw/API kodlarını
   ayır; hata ölçümü eski değeri düşürsün. İleri engel kilidini uçtan uca test et.
2. R02: reset/IDLE/E-stop/manuel park/yeniden ARM sırasında kol ve pençe
   durumunu birlikte uzlaştır. Eski açık hedef STOW'da PWM'e geri dönmesin;
   nesne boş bilgisi resetle kazanılmasın. Manuel kapalı+boş onayı kullanılacaksa
   açık operatör sözleşmesini host/protokol/firmware'e birlikte uygula.
   READY/STORE kapanışının boş varsayımını da gözden geçir.
3. R03: tekrarlanan başarısız hedeflerde 12 bit ACK alias'ını kökten önle.
   17 ardışık kayıp, eski sıfır olmayan ACK, hold ve 16 bit sarımı test et.
4. R04: pasif sol kol için gerçek sabit A→B bağlantısı ve diğer eklemlerin
   yük yolunu CAD, vida karşılıkları, BOM ve montajda tamamla.
5. R05: B çenesinin piminde eksenel tutma ile serbest dönmeyi ayır;
   boşluk, kilitleme ve montaj torkunu tanımla, gerçek montaj kupon testi ekle.
6. R06: gerçek kavrama datumunu çene/ped geometrisinden yönet; manifest,
   belge ve payload/kargo modellerini güncelle. Kargo CG'sini bırakma noktasıyla
   aynı kabul etme. Geometriye karşı koordinat testi ekle.
7. G01'in şasi eki eğilme/insert çekmesi/prying hesabını tamamla; yalnız
   cıvata kesmesinden çıkarılan 6 kat payı tüm ek için doğrulanmış sayma.

Yeni güvenlik kararlarını design_decisions.md'ye kaydet. Üretilen dosyaları
kaynaklardan yeniden üret; mevcut test takımını ve iki ESP-IDF build'ini çalıştır.
Her kimliği ancak kendi karşı örneği ve güvenli davranış testiyle kapat.
Mevcut Codex raporlarını yeniden yazma; yeni kapanış kaydında kanıt göster.
Donanım deneylerini NOT_RUN tut; üretim/sürüş onayı veya proje %100 iddiası yazma.
Gerçek .env/anahtarları okuma, ücretli API çağırma, commit/push yapma.
```
