efekrkyn/UGV-01/UGV-01/docs/review_dd94_2026-10-01.md

# DD94 bağımsız kapanış incelemesi — 01.10.2026

Claude'un R01–R06 ve G01 düzeltmelerinin büyük kısmı doğrulandı. **Bütün bulguların kapandığını henüz doğrulayamıyorum:** kurtarılan sürümde iki yazılım hatası ve bir mekanik belge tutarsızlığı var. İncelenen kaynak, Claude'un bildirdiği son sürümün eksiksiz kopyası değildir.

## Kapsam ve sürüm

İlk okumada çalışma ağacında DD94 vardı. İnceleme sırasında dışarıdan yapılan reset/temizlik sonrasında ana depo temiz DD91 durumuna döndü: `42524c9d271edaa842ca49b30e2747520887d61b`. Reflog'da 01.10.2026 00:47:23 +03 reset kaydı var; bu işlem Codex tarafından yapılmadı.

Git'teki `5176afb2fab9e48603102e4c3349ef1a9e6b772c` WIP anlık görüntüsü (00:39:52 +03) geçici dizine çıkarıldı. Kaynak, config, CAD, baskı planı, firmware ve kontroller burada incelendi. **Ana depoya DD94 geri yüklenmedi.** Bu görüntüde Claude'un sonradan düzelttiğini söylediği kütle testi hâlâ eski; dört yeni inceleme/kapanış belgesi de yok. Dolayısıyla bulgular bu kurtarılan sürüme aittir; son DD94 kaynaklarında tekrar doğrulanmalıdır. Aşağıdaki kaynak bağlantıları DD91'e değil, bu geçici inceleme dizinine gider.

**Yöntem:** ce-code-review; kullanıcı talebine göre yalnız inceleme ve kanıt dosyaları. Kaynak düzeltmesi, commit veya push yapılmadı. Doğruluk, testler, proje kuralları, bakım, insan/AI arayüzü ve geçmiş kararlar incelendi; oturum değişikliği için güvenilirlik, güvenlik ve sınır durumları ayrıca kontrol edildi.

## Kontrol sonuçları

| Kontrol | Sonuç | Kapsam |
|---|---|---|
| Masaüstü kontrol takımı | 32/34 PASS | İki başarısızlık aşağıda açıklanıyor |
| ESP32-S3 | PASS, 0 derleyici uyarısı | ESP-IDF 5.3.2, temiz Docker derlemesi |
| ESP32-CAM | PASS, 0 derleyici uyarısı | ESP-IDF 5.3.2, ayrı temiz Docker derlemesi |
| CAD yeniden üretim | PASS | 115 STEP parçası, manifest anlamlı farkı yok |
| Baskı planı | PASS | 84 baskı parçası, 50 insert |
| Görüntüleyici yeniden üretim | PASS | 115 parça, 290.956 üçgen |
| Görüntüleyici rota testleri | 3/3 PASS | Yeniden üretimden sonra çalıştırıldı |
| Yeni pençe karşı örneği | Hata doğrulandı | Gerçek C çekirdeği + bellek içi bağlantı |
| Yeni oturum yarış karşı örneği | Hata doğrulandı | İmzalı paketler + iki thread |
| Fiziksel T01–T20 / TL1–TL6 | NOT_RUN | Donanım kabulü yapılmadı |

Derlemeler ve ağır CAD işlemleri sırayla çalıştırıldı. ESP32-S3 imajı `0xcd770`, kamera imajı `0xed7e0` byte; uygulama bölmelerinde sırasıyla %20 ve %37 yer kalıyor.

**32/34 sonucunun açıklaması:** `check_body_mass.py:47`, parkta tutulan nesnenin CG'sinin y sınırı dışında olmasını bekliyor. Yeni sol kol ile hesap y=−8,947 mm; 10 mm sınırının içinde. Ondan önceki grup kütleleri, filament ve izin verilen sürüş duruşlarının CG kontrolleri geçti. Bu eski negatif örnek artık geçerli değil; kullanıcı mesajında Claude'un tam da bu testi sonradan düzelttiği bildiriliyor. `check_markdown_links.py` ise anlık görüntüde bulunmayan dört belge nedeniyle kırıldı: 29.09 genel inceleme ve kapanışı, 30.09 DD92/DD93 incelemesi ve 01.10 kapanışı. **Bu iki sonucu son Claude sürümünde hata veya başarısız test iddiası olarak kullanmıyorum.** Son sürüm olmadan 34/34 iddiasını da onaylayamıyorum.

Kanıt: [verification.json](review_evidence/dd94_2026-10-01/verification.json), [kütle logu](review_evidence/dd94_2026-10-01/check_logs/04.log), [belge logu](review_evidence/dd94_2026-10-01/check_logs/26.log), [S3 logu](review_evidence/dd94_2026-10-01/build_logs/esp32s3.log), [kamera logu](review_evidence/dd94_2026-10-01/build_logs/eye.log). SHA-256 kayıtları hangi kaynakların incelendiğini belirtir.

## Doğrulanan bulgular

### P2 — Orta

| # | Dosya | Sorun | İnceleme | Güven |
|---|---|---|---|---|
| 1 | [docs/lite_mechanical_A3.md:56](</var/folders/43/yr2vdg1x1hn35fd2b1l0drkm0000gn/T/ugv-dd94-recovered-20261001-9o0a_yli/checkout/UGV-01/docs/lite_mechanical_A3.md:56>) | Duruş tablosu eski kavrama koordinatlarını veriyor | bakım, ana inceleme | 100 |
| 2 | [firmware/lite/lite_core.c:332](</var/folders/43/yr2vdg1x1hn35fd2b1l0drkm0000gn/T/ugv-dd94-recovered-20261001-9o0a_yli/checkout/UGV-01/firmware/lite/lite_core.c:332>) | PWM kapalıyken pençe başarı bildiriyor | doğruluk, sınır durumları, ana inceleme | 100 |
| 3 | [software/ugv_lite/vehicle.py:141](</var/folders/43/yr2vdg1x1hn35fd2b1l0drkm0000gn/T/ugv-dd94-recovered-20261001-9o0a_yli/checkout/UGV-01/software/ugv_lite/vehicle.py:141>) | Eski telemetri yeni oturuma yazılabiliyor | güvenilirlik, ana inceleme | 100 |

- **#1:** R06 paragrafı yeni kavrama noktasını doğru tanımlıyor; 56–65. satırlardaki tablo eski noktaya ait. Örneğin park tablosu `(−151, −138, 163)`, manifest `stow` ise `(−156, −143, 146,5)` mm. `reach_center` tabloda `(265, −10, 45)`, CAD'de `(281,1, −11,8, 53,5)` mm. Ayrıca 44. satır hâlâ eski 96 mm kavrama mesafesini kullanıyor; yeni nokta 101 mm ve düzlemden y/z ofsetli. Bu değerler montaj veya kalibrasyon referansı olarak birlikte kullanılamaz. Tabloyu manifestin `grip_mm` verilerinden üret veya güncelle; nominal uzuv boyu ile gerçek ped kavrama noktasını açıkça ayır.

- **#2:** Kol `ready` durumunda pençeyi aç, disarm et, 0x123 park onayı vermeden yeniden arm et, ardından pençeyi kapat. DD94 doğru biçimde pençe PWM'ini sıfırda tutuyor. Ancak servo modeli ilerliyor; 0x1A2 bit3 `gripper_settled` veriyor ve MacBook `gripper close` için `ok=True` dönüyor. Bağımsız tekrar çalıştırmada `arm=limp`, `gripper=closed`, **`servo_us[7]=0`** gözlendi. İlgili akış: `lite_core.c:274–279`, `:332–334`, `vehicle.py:286–294`, `executor.py:259–275`. Sürüş kilidi korunuyor; kontrolsüz sürüş gösterilmedi. Sorun, hiç sürülmeyen pençenin tamamlanmış sayılması. Limp/bilinmeyen durum pençe tamamlanmasını da geçersiz kılmalı: host `unknown` görmeli, komut başarıya ulaşmamalı; firmware yerleşti/boş modelini PWM bastırılırken geçerli hareket kanıtı üretmeyecek şekilde yönetmeli.

- **#3:** `pump()` paket doğrulaması ve kabulünü kilit dışında yapıyor (88–107); `request_arm()` ise aynı anda kilit içinde oturumu, sayaçları ve telemetriyi sıfırlıyor (133–144). Eski oturumda doğrulanmış bir paket araya reset girdikten sonra yeni `last_ext` ve `status` alanına yazılabiliyor. İki thread ile eski `DRIVING`, lease=70000 paketi doğrulandıktan hemen sonra re-arm yapıldı: host eski durumu kabul etti ve `armed=True` döndü. Geçerli yeni oturum `IDLE`, lease=1 paketi imzası doğru olmasına rağmen sıralama kapısında reddedildi. Eski durum bayatlayınca host artık armed görmüyor; yeni sayaç eski sayıyı geçene veya yeni, yarışsız bir reset yapılana kadar toparlanma bozuluyor. Gerçek gateway'de pump ve görev ayrı thread'lerdir (`gateway.py:209–218`); bu yalnız yapay bir API çağrı düzeni değildir. Fiziksel kontrolsüz hareket doğrulanmadı. Oturuma bağlı doğrulama/kabul ve reset aynı atomik korumayı kullanmalı; alternatif olarak kabul anında kilit içinde oturum nesli kontrol edilmeli.

### Düzeltme kuyruğu

| # | Dosya | İş | Yönlendirme | Kontrol |
|---|---|---|---|---|
| 2 | `firmware/lite/lite_core.c:332` | Limp pençenin geçerlilik ve başarı bilgisini düzelt | downstream-resolver | PWM=0 iken başarı yok |
| 3 | `software/ugv_lite/vehicle.py:141` | Telemetri kabulünü oturum resetiyle eşleştir | downstream-resolver | Eşzamanlı re-arm testi |
| 1 | `docs/lite_mechanical_A3.md:56` | Kavrama tablosunu güncel CAD ile eşleştir | downstream-resolver | Tablo/manifest fark kontrolü |

Kanıt betikleri: [pençe](review_evidence/dd94_2026-10-01/repro_unknown_claw.py), [oturum yarışı](review_evidence/dd94_2026-10-01/repro_rearm_telemetry_race.py). Her ikisi de açıkça verilen UGV-01 dizinini kullanır; gerçek anahtar, cihaz veya ücretli API istemez. Bunlar **hatalı davranışı doğrulayan tanı betikleridir**; başarılı çıkışları aracın güvenli olduğu anlamına gelmez. Düzeltme sırasında güvenli sonucu isteyen kalıcı regresyon testlerine çevrilmelidir.

## R01–R06 / G01 kapanış durumu

| Kimlik | Kurtarılan sürümde doğrulama | Kalan |
|---|---|---|
| R01 | `no-target` ayrı kör değer; geçerli/invalid okuma ayrılıyor; çekirdek sürünme hedefi 100 mm/s; AI segmenti 0,3 m'de duruyor | Koyu/cam hedef fiziksel davranışı; panel kör durumu görünürlüğü |
| R02 | Reset boş varsayımı kaldırılmış; kapalı+boş park onayı zorunlu; eski açık PWM park sonrası geri gelmiyor | #2 nedeniyle tam kapanmadı |
| R03 | ACK oturum boyunca izleniyor; 255 yanıtsız komut sınırı; hata kilitli; 12-bit echo alias örneği tekrar bulunmadı | Yeni oturum/toparlanma için #3 |
| R04 | 14 nominal arayüz teması geçiyor; taklitler ve montaj elemanları tanımlı; sol kol modeli üretilebiliyor | Pasif twist açısal boşluğu için tolerans ve tutunma kontrolü |
| R05 | Ø5 burç, Ø5,2 delik, 7/7,5 mm istif; vida burcu sıkıyor; nominal dönme boşluğu var | Basılmış parçada sıkma torku ve serbest dönme kuponu |
| R06 | Kavrama noktası ped yüzü orta noktasına <0,1 mm uyuyor; kütle hesabı güncel datum kullanıyor | #1 nedeniyle belge kapanışı eksik |
| G01 | Serbest cisim momenti, kiriş gerilmesi, cıvata/insert yükleri incelendi | Insert çekme ve ek yeri sehim deneyi; malzeme varsayımları |

G01'de 5,1 kg, 210 mm aks açıklığı ve arkadan 70 mm ek yeri için statik moment 1,167 N·m; 3g ile 3,50 N·m ve kiriş başına 1,75 N·m doğru. Kiriş hesabı 3,9 MPa, eksenel kuvvet çifti yaklaşık 88 N/cıvata ve 5,8 MPa yataklama veriyor; 15/30 mm istasyonlarda 23/47 N çekme momenti karşılıyor. **Kesme kuvvet çifti ve prying, tam momenti ayrı ayrı taşıyan iki idealize yük yolu olarak sunulmalı**, iki tam-moment yükü birlikte toplanmamalı. 300 N insert tutunması ölçülmüş sonuç değildir.

Kütle kontrolü, kol grubunun yaklaşık 708 g baskı/model tahminini 720 g tahsis içinde doğruluyor. Kalan yaklaşık 12 g pay ölçülmüş parça ağırlığı değildir; vida/kablo ve gerçek baskı farkları fiziksel doğrulamada korunmalı.

## Fiziksel ve arayüz açıkları

- Pasif twist taklidi 066, A cebi ve kapak tarafından tutuluyor; **serbestçe dönüyor veya hiç bağlı değil** iddiası doğru değil. STEP dönüş kontrolü nominalde yaklaşık 0,5/1 mm duvar boşluğu, yaklaşık 2,5–3° dönmeden sonra duvar teması gösteriyor. 14 temas testi bu açısal boşluğu değerlendirmiyor. İzin verilen park açısı toleransını ve kapakla tutunmayı tanımla; kabul edilen tolerans sağlanmıyorsa boşluğu azalt veya anti-rotation geometrisi ekle. Şu aşamada üretim hatası kesinleşmiş değildir.
- `front_blind` AI durumuna gidiyor, fakat panel `say/ask/status` mesajlarını gösteriyor; kör sürünme başlangıcını canlı belirtmiyor. Operatör denetimine dayanan kabulün arayüzde görünürlüğü eksik. Kör moda giriş/çıkış bilgisini göster veya denetimin nasıl yapılacağını açıkça belgele.
- Kör 0,3 m bütçesi her hareket çağrısında yenileniyor; iki çağrıda toplam 0,6 m mümkün. Her hareket sonucu yeni kamera görüntüleriyle modele sunuluyor. Bu, mevcut "dur ve tekrar bak" politikasına uyuyor; tek başına yazılım hatası sayılmadı. Kesintisiz körlük boyunca toplam 0,3 m isteniyorsa bu **yeni bir politika** ve kalıcı kilit gerektirir.
- Servo modeli gerçek nesne bırakılmasını veya fiziksel yerleşmeyi ölçmez. Bu açıklanan tasarım varsayımı, #2'de PWM hiç uygulanmadan başarı verilmesinden ayrı tutulmalı.
- Baskı anisotropisi, insert çekme, burç sürtünmesi, pasif omuz ön yükü, gerçek servo sapması, termal sınırlar ve gerçek yüzeyde ToF davranışı T/TL testleriyle ölçülmeden fiziksel kabul yok. Mevcut park ±1° taraması ve nominal açıklıklar bu testleri ikame etmez.

## Önceden var olan davranış

`request_arm()`/`disarm()` eski teker hız hedeflerini koruyabiliyor. Doğrudan API ile tekrar hareket üretilebilir; ancak bu davranış DD94'ten önce de vardı ve üretim gateway görev sonundaki `stop()` + `disarm()` yolu hedefleri sıfırlıyor. Bu incelemede normal gateway akışından ulaşılabilir bir DD94 regresyonu olarak sayılmadı. Paylaşılan driver ileride başka arayüzden kullanılırsa re-arm'ın sıfır hedefle başlaması için koruma ve test eklenmeli.

## Kapsam ve eleme

Üç birincil bulgu, ana incelemede doğrudan tekrar doğrulandı. P0/P1 doğrulanmadı. Güvenlik kontrolünde imza/oturum reddi, yalnız operatör park onayı, strict JSON `true`, görev sırasında park reddi ve lokal panel sınırı korundu. ACK sınır taraması, geç/yinelenen/bayat/yabancı oturum paketleri ek bir R03 alias hatası göstermedi. Tüm değerlendirici çıktıları geçici ce-code-review çalışma dizininde saklandı.

Sınırsız pasif twist iddiası geometrik cep tutunması nedeniyle elendi; yalnız tolerans açığı korundu. Eski parça/insert sayılarının belgede kaldığı yönündeki bir aday elendi: kontrol ve baskı bölümleri zaten 115/84/50 güncel değerlerini veriyor. Kör bütçenin çağrı başına olması mevcut gözlem politikasıyla çelişmediği için hata listesine alınmadı. Tam DD94 kapanış belgeleri ve son kütle testi mevcut olmadığından bu tur **nihai sürüm incelemesi değildir**.

---

> **Karar:** DD94 için tam kapanış onayı verilmiyor.
>
> **Gerekçe:** Kurtarılan sürümde #2 ve #3 davranış hataları, #1 belge tutarsızlığı var; Claude'un son kaynak ve kapanış dosyaları eksiksiz doğrulanamadı.
>
> **Düzeltme sırası:** Tam DD94 sürümünü belirle -> #2 pençe -> #3 oturum yarışı -> #1 tablo -> son sürümde bütün kontroller ve derlemeler -> fiziksel kapılar.

## Claude'a verilecek devam promptu

```text
UGV-01 DD94 düzeltmelerinin son sürümünü tamamla ve yeniden doğrula.
Önce docs/review_dd94_2026-10-01.md ve docs/review_evidence/dd94_2026-10-01/verification.json dosyalarını oku.

Sürüm sınırını koru: Codex incelemesi sırasında ana depo dışarıdan DD91/42524c9'a resetlendi. İncelenen DD94, Git WIP5176afb'nin kurtarılan ARA sürümüdür. Son kütle testi düzeltmesi ve dört untracked inceleme/kapanış belgesi bu görüntüde yok. Önce kendi tam son DD94 kaynaklarını ve kapanış belgelerini bulup doğrula; eski DD91'e körlemesine patch uygulama. git reset/clean ile kullanıcı işini silme. 32/34 sonucunu son sürümün sonucu veya üretim onayı diye sunma.

1. arm_limp iken pençe PWM=0 kalırken modelin tamamlandı demesini düzelt. Firmware telemetrisi ve LiteVehicle.gripper_state bilinmeyen pençeyi başarı saymasın; executor gripper close için ok=True dönmesin. Mevcut sürüş kilidini koru. ready -> open -> disarm -> rearm (0x123 yok) -> close karşı örneğini önce doğrula; sonra PWM=0 ve başarı yok koşullarını kalıcı teste bağla. Geçerli operatör park onayı sonrasında normal pençe komutları çalışmalı.
2. LiteVehicle.pump telemetri doğrulama/kabulü ile request_arm oturum resetini atomik eşleştir. Eski oturumda doğrulanıp yeni oturum açıldıktan sonra kabul edilen paket yeni status/last_ext alanına yazılamasın. İki thread ile doğrulama sonrası reset yarışını test et: yeni oturumdan ext0/1 paketleri kabul edilmeli, eski DRIVING yeni armed durumu olamamalı. Bloklayan I/O varsa kilidi buna göre sınırla.
3. lite_mechanical_A3.md duruş tablosunu manifest grip_mm koordinatlarıyla güncelle; 96 mm nominal referans ile 101 mm gerçek ofsetli kavrama datumunu ayır. Tek kaynaktan üretme veya fark kontrolü ekle.
4. R04 pasif twist cebinin yaklaşık 2,5–3 derece boşluğu için izin verilen açısal toleransı ve tutunma kontrolünü tanımla. Parça cebin içinde tutuluyor; sınırsız dönüyor iddiasına göre yeniden tasarlama. Tolerans karşılanmazsa uygun düzeltme yap.
5. Operatör denetimiyle kabul edilen kör sürünme durumunun panelde görünmesini sağla veya denetim koşulunu açıkça belgele. Çağrı başına 0,3 m + her sonuçta yeni kamera görüntüsü mevcut politikadır; bunun toplam mesafe limiti olduğu izlenimini verme.
6. Son DD94 kütle testi düzeltmesini ve eksik dört kapanış belgesini tamamla. Codex eski inceleme/kanıtlarını değiştirme. Yeni düzeltme kaydı aç; kimlik bazında karşı örnek, düzeltme, test ve açık fiziksel kapıyı göster.
7. Tam kaynak sürümünde CAD, baskı planı ve viewer üret; bellek için işlemleri ve 34 kontrolü sırayla çalıştır. İki ESP-IDF temiz derlemesini son firmware değişikliğinden sonra tekrar çalıştır, uyarıları ve kaynak SHA'larını kaydet. T01–T20/TL1–TL6 donanım olmadan NOT_RUN kalmalı.
Gerçek .env/anahtarları veya ücretli AI API'sini testlerde kullanma. Bu prompt commit/push onayı değildir.
```
