efekrkyn/UGV-01/UGV-01/docs/front_camera_A1.md

# A1 ön kamera mekanik tahsisi — seçim kapısı

> **A2 ile yerini aldı (24.09.2026):** ön tek kamera kaldırıldı; iki göz kamerası boyunlu başa taşındı. Güncel sınırlar: [A2 karakter revizyonu](exterior_language_A2.md). Bu belge A1 kaydı olarak korunur.

24.09.2026. A1 için tek sabit öne bakan RGB kamera öngörülür; çift kameralı göz/pan-tilt sonraki revizyona bırakılmıştır. Satın alma kararı açık olan BOM B14, başlangıçta UVC öneriyordu. A1 CAD tahsisinde ölçüsü belgeli **Raspberry Pi Camera Module 3 Standard** mekanik referans olarak kullanıldı; bu, CSI/UVC işletim sistemi seçimini kesinleştirmez.

[Raspberry Pi ürün sayfası](https://www.raspberrypi.com/products/camera-module-3/) standard modülün 25×24×11,5 mm, 4 g ve 15 pin/1 mm FPC olduğunu belirtir; [mekanik çizim](https://datasheets.raspberrypi.com/camera/camera-module-3-standard-mechanical-drawing.pdf) delik/lens yerlerini gösterir. [CM5 IO Board](https://www.raspberrypi.com/products/compute-module-5-io-board/) 22 pin/0,5 mm MIPI FPC kullanır; [Raspberry Pi kamera bağlantı kılavuzu](https://www.raspberrypi.com/documentation/accessories/camera.html) bu kombinasyon için Standard–Mini kamera kablosu gerektiğini söyler. 200 mm stok FPC uzunluğu tedarikçide doğrulanır; kablo bükülmesi ve EMI/strain relief CAD'de henüz yer almaz. Ubuntu 24.04 üzerindeki kamera sürücüsü/görüntü gecikmesi de gerçek CM5 ile T18'de ölçülür.

Koordinat kabulü: Kamera tahsis kutusu 11,5 mm **x derinlik** ×25 mm **y genişlik** ×24 mm **z yükseklik**, merkezi (156,0,132) mm'dir. Dış yüzün azami x'i 161,75 mm; mevcut 330 mm teker/araç dış zarfının ön sınırı x165 ile yalnız **3,25 mm** kalır. Altı z120 mm'de mevcut tampon üstüyle nominal düzlem teması yapar. Ön duvardaki 24×16 mm açıklık merkez z130'dadır; 25×24 mm kart buradan **geçemez**. Bu açıklık, gelecek kablo/pencere adaptörü için kavram arayüzüdür; kart dıştan sökülebilir bir podda tutulmalıdır.

**P0 açık işler:** Dış podun en az iki duvarı + pencere + montaj toleransı mevcut 3,25 mm x payına sığdığı kanıtlanmadı. Podun takılma/çıkarılma yönü, M2 kamera kartı delik konumlarının üretici çiziminden aktarımı, lens optik ekseni, FPC geçişi/servis kıvrımı, gövde içi su/toz yolu ve ön darbe yükü çözülmelidir. Gerekirse kamera üst küçük çıkıntısı veya ön bumper geometrisi, 330 mm hedefinin mühendislik revizyonuyla değiştirilir. A1 kutusu yalnız **çakışmasız hacim kontrolüdür**, üretilebilir kamera yuvası değildir.
