efekrkyn/UGV-01/UGV-01/docs/k2_separator_selection.md

# K2 elektronik ayırıcı — koşullu bileşen seçimi

23.09.2026 · PH6/P0. Bu dosya hesaplı **aday** seçimidir; tamamlanmış şematik, emniyet onayı veya sipariş listesi değildir. K2, `F1 → K1 → MID → K2 → ACT_BUS` hattında ikinci seri kesicidir. K1 kaynaklı kalırsa K2 tek başına 16,8 V motor/servo barasını ayırabilmelidir; ters yönden enerjiyi de bloke etmelidir. K2'nin çevresindeki **anahtarlı** 470 Ω ön şarj kolu ayrı bir bypass'tır ve [tek hata tanısı](precharge_and_separator_diagnostics.md) kapsamındadır.

24.09.2026 ek: İki FET, LM74900 pinleri ve 1 mΩ Kelvin şöntü içeren [ayrı K2 referans şeması ve tolerans hesabı](k2_reference_schematic.md) çizildi. Aynı gün ön şarj/bleed/test kolu ve NC-B beslemeli `SAFE_EN` sürücüsü [güç/güvenlik yolu sayfalarına](pwr_safety_path.md) eklendi; birleşik ERC 0 hata. Termal, SOA, şönt MPN ve fiziksel testler açık olduğundan aşağıdaki PH6 bırakma kapısı açık kalır.

| Öğe | Aday / üretici verisi | Tasarım sonucu |
|---|---|---|
| Kontrolcü | [TI LM74900QRGERQ1](https://www.ti.com/product/LM74900-Q1/part-details/LM74900QRGERQ1), 24 pin VQFN, 3–65 V çalışma, iki common-drain N-FET için `DGATE/HGATE` | Giriş 12,4–16,8 V içinde; ters besleme, OV/UV ve aşırı akım fonksiyonları hesaplanacak. Sipariş/stok açık. |
| Seri FET, Q1/Q2 | 2 × [TI CSD18540Q5BT](https://www.ti.com/product/CSD18540Q5B/part-details/CSD18540Q5BT), 60 V, `VGS=±20 V`, `RDS(on)≤2,2 mΩ` @ 10 V/25 °C, `Qg≤53 nC` @ 10 V | İki FET seri; tek FET güvenlik ayırıcı değildir. 60 V drain transient sınırı TVS/yerleşim hesabıyla korunacak. Sipariş/stok açık. |

**Topoloji ve kapatma:** LM74900'un [veri sayfası](https://www.ti.com/lit/ds/symlink/lm74900-q1.pdf), Q1 ideal diyot ve Q2 yük ayırıcı olarak ortak dren yerleşimi tarif eder. `SAFE_GATE=0`, `EN` girişini **donanımla Low** yapar; `EN` için harici varsayılan Low bias gerekir. `SLEEP=Low` / `EN=High` çıkışa tipik 7 Ω iç yol ile yaklaşık 100 mA tepe akım sağlayabildiğinden **E-stop yolu olamaz**; kullanılmayan SLEEP üretici önerisiyle EN'e bağlanır. K2 kapatıldığında Q1/Q2 gate'leri kaynaklarına çekilmelidir. `FLT` açık-drenaj çıkışı latch'e girer; kontrolcünün varsayılan aşırı akım döngüsü kendiliğinden yeniden açabileceğinden yalnız otomatik retry'e güvenilmez. TMR'ye yaklaşık 100 kΩ paralel dirençle üreticinin latch-off seçeneği incelenir; eşiği, zamanlaması ve manuel reset bağlantısı henüz seçilmedi. Kontrolcünün açık termal pad'i üreticiye göre **floating** kalmalıdır; KiCad pad'i GND'ye bağlanmayacak.

**İletim hesabı:** 15 A motor dalı tasarım zarfında, 25 °C katalog maksimumlarıyla `P(Q1+Q2)=15²×2×0,0022=0,99 W`, her FET yaklaşık 0,495 W. 20 A arıza/başlangıç taramasında toplam 1,76 W, FET başına 0,88 W; F1=15 A sigorta 20 A'yı anında kesen akım regülatörü değildir. Sıcak `RDS(on)` için veri sayfası normalize eğrisinden yaklaşık **2,0× senaryo varsayımı** uygulanır; bu garantili sıcak maksimum değildir. Böylece 15 A'da çift 1,98 W / FET 0,99 W, 20 A'da çift 3,52 W / FET 1,76 W çıkar. [MOSFET veri sayfasındaki](https://www.ti.com/lit/ds/symlink/csd18540q5b.pdf) `RθJA≤50 °C/W` yalnız FET başına 1 in² 2 oz bakır için; minimum pad'de `≤125 °C/W` örneklenir. 50 °C yerel hava ve 50 °C/W **gerçekten sağlanırsa**, sıcak senaryoda tahmini Tj 15 A için ~100 °C, 20 A için ~138 °C olur. Minimum-pad 125 °C/W ile 15 A bile ~174 °C'ye çıkar ve 175 °C mutlak sınırına dayanır. Bu yüzden 120×80 mm PWR tahsisi içinde her FET için gerçek bakır, via, komşu ısı kaynakları ve muhafaza hava sıcaklığı termal model/ölçümle kapanmadan 15 A sürekli akım onayı yoktur.

**Ek kayıplar ve kapatma:** LM74900 akım/short algısı için K2 yolunda **ayrı Kelvin şönt** gerektirebilir; mevcut 2 mΩ paket INA228 şöntü STAR önündedir ve denetleyicinin `CS+ / CS−` pinlerine doğrudan ikame edilmez. Örnek 1 mΩ şönt, 15 A'da 0,225 W ve 20 A'da 0,4 W harcar; eşik/tolerans/soğuk-stall akımıyla birlikte seçilmelidir. FET iletim hesabı şöntü, via/iz/kontak kaybını ve anahtarlama/transient enerjisini **içermez**. `Qg≤53 nC` ve kontrolcünün gate akımıyla gerçek `EN Low→ACT akım kesilmesi` süresi osiloskopta ölçülür; veri sayfasındaki 0,5 µs ters-akım algısı bu kapatma süresi diye kullanılamaz. Gate-source clamp, TVS, giriş/çıkış lokal kapasitansı ve hat endüktansı 60 V sınırına göre seçilir. Aktüatör barasında rejenerasyon için [ayrı dump clamp](electrical_architecture.md) zorunludur; ideal diyotun ters akım blokajı bunu ortadan kaldırmaz.

**PH6 bırakma kapısı:** Tam K2 + ayrı şönt + ön şarj/bleed/test kolu şematiği; üretici footprint ve termal pad ERC/DRC; 12,4–16,8 V ve 50 °C hava için sürekli/20 A kısa termal tarama; 60 V transient/SOA; `EN` ve SLEEP güç dizisi; `FLT` latch/reset; K1 kaynaklı/K2 kısa/ön şarj kısa fault enjeksiyonu; son WDI→K2 ayırma ≤150 ms dahil T13 osiloskop izi. Bu kanıtlar tamamlanana kadar C12/C13 BOM kalemleri koşulludur.
