efekrkyn/UGV-01/UGV-01/cad/assembly/concept_preview.png

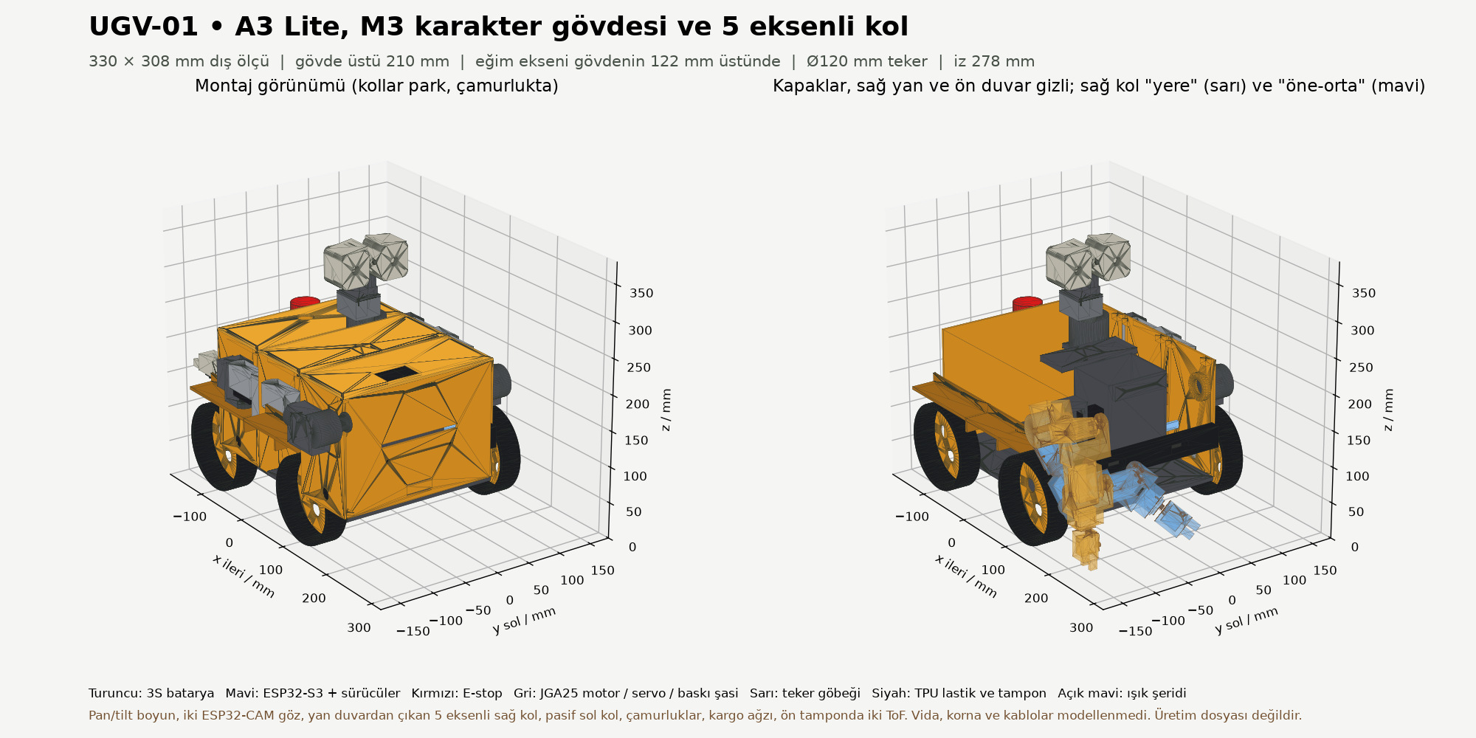
UGV-01/cad/assembly/concept_preview.png
