efekrkyn/UGV-01/UGV-01/cad/drivetrain/module_preview.png

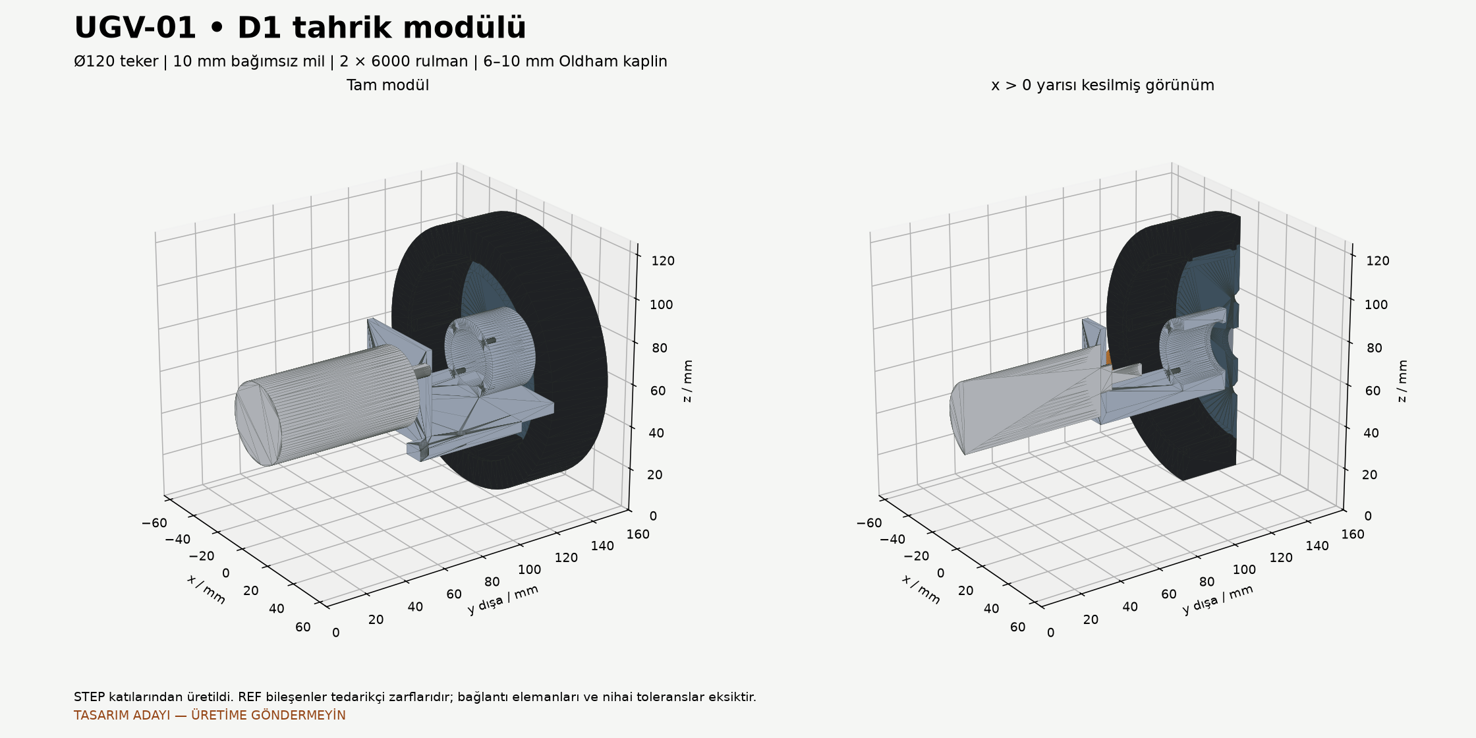
UGV-01/cad/drivetrain/module_preview.png
