efekrkyn/UGV-01/UGV-01/docs/revisions/A1/concept_preview.png

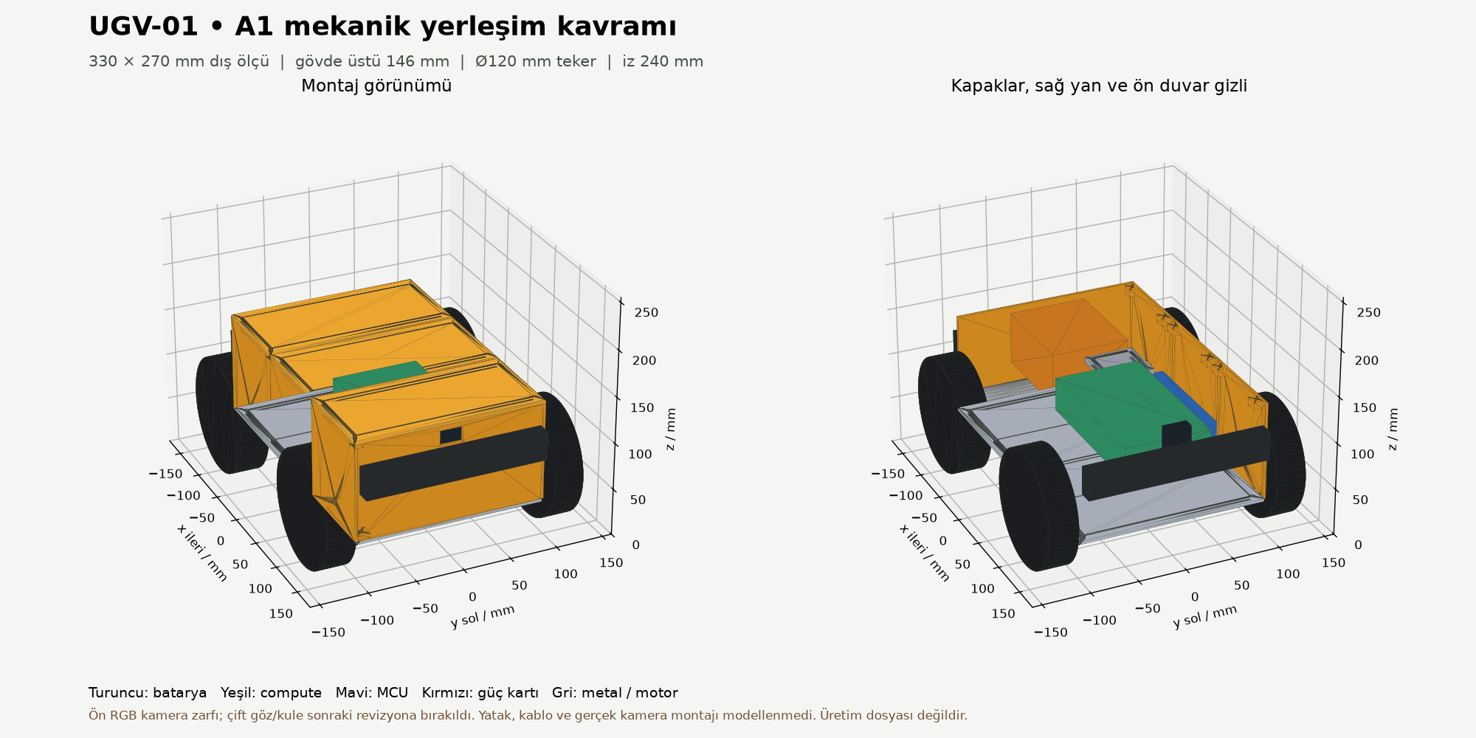
UGV-01/docs/revisions/A1/concept_preview.png
