efekrkyn/UGV-01/UGV-01/docs/revisions/A2/concept_preview.png

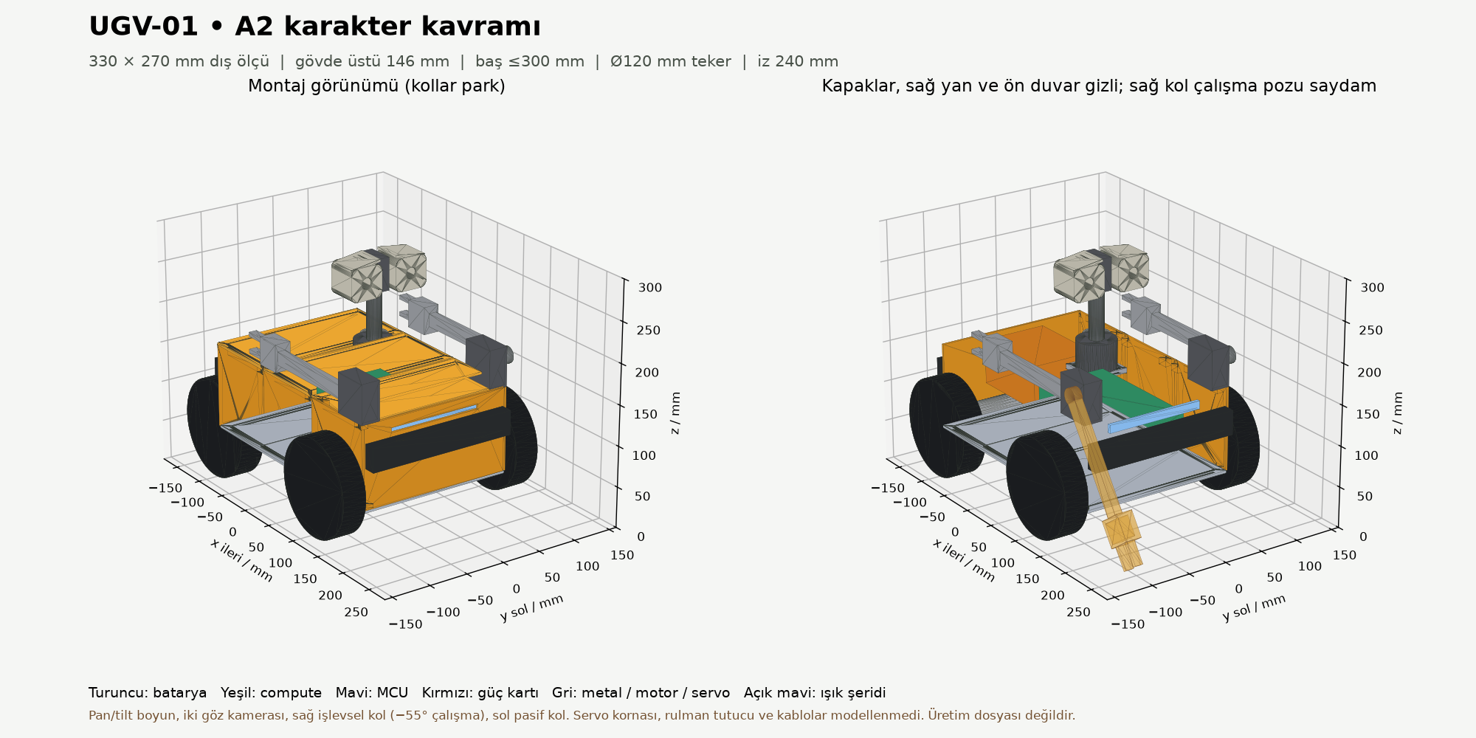
UGV-01/docs/revisions/A2/concept_preview.png
