efekrkyn/UGV-01/UGV-01/docs/sources/motor-drawing.png

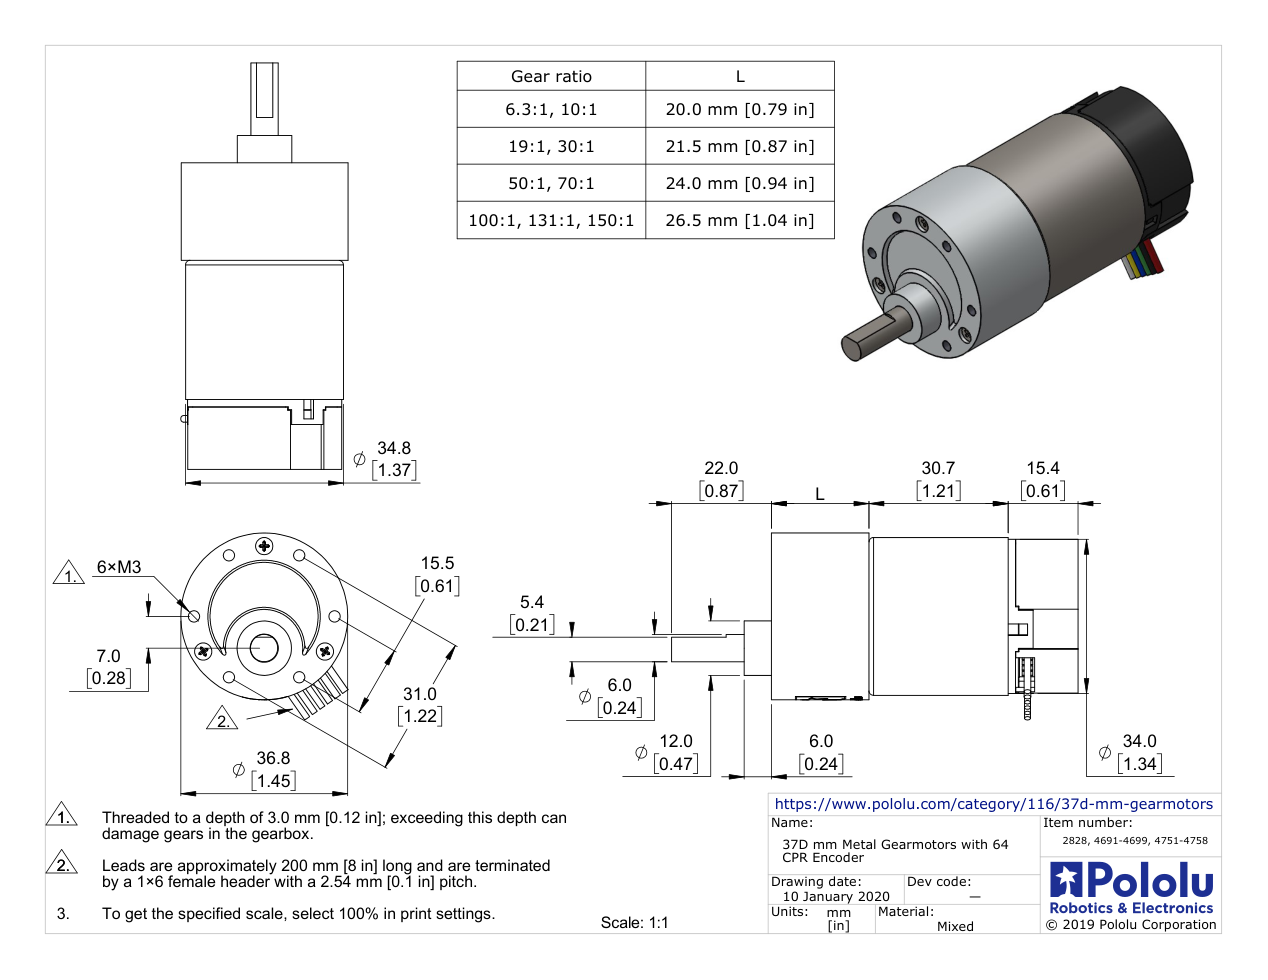
UGV-01/docs/sources/motor-drawing.png
