efekrkyn/UGV-01/UGV-01/manufacturing/bom/initial_bom.csv

id | manufacturer | manufacturer_part_number | description | quantity | estimated_unit_usd | alternative | procurement_status | source | cost_scope
B01 | Pololu | 4754 | 70:1 12 V 37D quadrature motor | 4 | 55 | 4755 100:1; hız yeniden hesap | Ürün doğrulandı; yerel stok sorgulanmadı | https://www.pololu.com/product/4754 | V1
B02 | Raspberry Pi | CM5108032 | CM5 8GB 32GB eMMC wireless | 1 | 195 | CM5104032; RAM bütçesi yeniden ölç | Ürün/fiyat brief kontrol; yerel stok sorgulanmadı | https://pip-assets.raspberrypi.com/categories/944-raspberry-pi-compute-module-5/documents/RP-008181-DS-8-cm5-product-brief.pdf | V1
B03 | Raspberry Pi | Compute Module 5 IO Board | 160x90mm prototip carrier; sipariş SKU teyidi | 1 | 30 | Uyumlu üçüncü taraf CM5 IO; güç/ölçü tekrar doğrula | Ürün doğrulandı; fiyat tahmini | https://www.raspberrypi.com/products/compute-module-5-io-board/ | V1
B04 | Raspberry Pi | Compute Module 5 Cooler | CM5 soğutucu ve fan; sipariş SKU teyidi | 1 | 12 | Özgün heatsink/fan; ısıl doğrulama | Teklif alınacak | https://www.raspberrypi.com/products/compute-module-5/ | V1
B05 | PEAK-System | IPEH-004022 | PCAN-USB FD izole USB-CAN adaptörü | 1 | 350 | SocketCAN uyumlu izole USB-CAN; kernel testi | Ürün doğrulandı; bütçe tahmini | https://www.peak-system.com/products/hardware/external-pc-interfaces/pcan-usb-fd/ | V1
B06 | Molicel | INR-21700-P45B | 4.5Ah hücre; paket üreticisinden eşleşmiş lot | 8 | 9 | P42A; kapasite ve boyut yeniden hesap | Ürün doğrulandı; yetkili tedarik teklifi gerekli | https://www.molicel.com/product/inr-21700-p45b/ | V1
B07 | Paket üreticisi seçilecek | SELECTION-OPEN-BMS | 4S >=20A BMS; hücre telemetrisi NTC balans; kaynak/izolasyon hizmeti | 1 | 100 | Belgeli komple 4S paket; ölçüleri yeniden doğrula | MPN ve üretici seçimi açık; hücre maliyeti hariç | docs/electrical_architecture.md | V1
B08 | Şarj cihazı üreticisi seçilecek | SELECTION-OPEN-CHARGER | 16.8V 2A 4S Li-ion CC/CV şarj cihazı | 1 | 40 | Paket üreticisi onaylı 4S şarj cihazı | Onaylı ürün teklifi bekleniyor | docs/electrical_architecture.md | V1
B09 | UGV-01 / PCBA üreticisi | UGV-MCU-01 | İlk adet özel kontrol kartı komple üretim/montaj bütçesi | 1 | 150 | Revizyon B; aynı arayüz | Tasarım öncesi bütçe; aşağıdaki IC kalemlerini içerir | electronics/ugv_mcu_01/README.md | V1
B10 | UGV-01 / PCBA üreticisi | UGV-PWR-01 | İlk adet güç kartı üretim/montaj bütçesi | 1 | 180 | Modüler prototip DC/DC; kalıcı çözüm özel kart | Tasarım öncesi bütçe; kart IC kalemlerini içerir | electronics/ugv_pwr_01/README.md | V1
B11 | Güvenlik bileşeni üreticisi seçilecek | SELECTION-OPEN-ESTOP | Kilitlenen fiziksel çift NC buton + yerel reset | 1 | 35 | Belgeli çift NC buton; mekanik ölçü tekrar | MPN DC hat/loop gereksinimiyle seçilecek | docs/safety_architecture.md | V1
B12 | Röle üreticisi seçilecek | SELECTION-OPEN-K1 | 4S motor bus DC seri ayırıcı; regüle bobin ve kaynaklı kontak tanısı | 1 | 30 | TE T9AS1D17-5 5V paketleme adayı; Panasonic ACTE3CH2A05V yalnız regüle12V ve14V yük sınırıyla | 16.8V motor yükü kesme ve coil clamp/feedback açık; siparişe hazır değil | docs/k1_relay_selection.md | V1
B13 | Direnç üreticisi seçilecek | SELECTION-OPEN-DUMP | 1.5 ohm şasi direnç; >=20J darbe doğrulaması | 1 | 25 | Enerji/pulse eğrisi eşdeğer direnç | Kesin MPN açık; 100W sınıfı sadece bütçe | https://www.vishay.com/en/resistors/resistor-pulse-selector/ | V1
B14 | Raspberry Pi | Camera Module 3 Standard (SKU doğrulanacak) | A2 iki göz kamerası; 15 pin FPC; CM5 IO CAM0/CAM1 | 2 | 25 | Camera Module 3 Wide; FOV ve stereo kalibrasyon yeniden | Ürün sınıfı seçildi; SKU/stok sorgulanmadı | https://www.raspberrypi.com/products/camera-module-3/ | V1
B15 | Servo üreticisi seçilecek | SELECTION-OPEN-MG90S | A2 pan/tilt/pençe 9 g metal dişli servo; 6 V | 3 | 6 | SG90 yalnız pan için; tork düşük | Taklit riski; tork/stall akımı gelen partide ölçülecek | docs/a2_electronics.md | V1
B16 | AMASS / Molex / JST | HARNESS-ASSEMBLY-A0 | XT60H tutucu; J-PWR Mega-Fit 768250004 dik açılı/1700010104/768230322 AWG12 ACT+ ve 2 GND; 768230321 AWG16 5V+; JST GH BM12B-GHS-TBT/GHR-12V-S 12 pin AWG26 sinyal; sigortalar | 1 | 90 | Aynı akım/anahtarlama özellikli kilitli aileler | Aday MPN; iki uç/krimp/derating/kütle/fiyat teklifle doğrulanacak | docs/pwr_mcu_interface.md | V1
B17 | Metal işleme tedarikçisi | UGV-MECH-001..005 | 6061 alt plaka destek motor yatağı hub ve mil | 1 | 250 | Aynı çizimi sağlayan CNC tedarikçisi | Çizim sonrası teklif; malzeme dahil | docs/mechanical_architecture.md | V1
B18 | Rulman tedarikçisi seçilecek | SELECTION-OPEN-BEARING | Teker başına iki destek yatak başlangıç bütçesi | 8 | 5 | Mil/yatak paketine göre farklı seri | MPN/geçme/yük seçimi PH4 | docs/mechanical_architecture.md | V1
B19 | Filament üreticileri | PRINT-MATERIAL-A0 | ASA PAHT-CF TPU; ilk baskı ve kupon sarf bütçesi | 1 | 100 | PETG sadece uygun serin prototip parçaları | Malzeme üretici TDS ve kurutma profili seçilecek | docs/mechanical_architecture.md | V1
B20 | Bağlantı elemanı tedarikçisi | FASTENERS-A0 | M3/M4 cıvata somun insert pul; gerilim tahliye | 1 | 35 | Aynı malzeme/kalite sınıfı | Kesin boy/adet PH4 çizimlerden | docs/mechanical_architecture.md | V1
B21 | Servo üreticisi seçilecek | SELECTION-OPEN-DS3218MG | A2 sağ omuz 20 kg·cm sınıfı dijital servo; 6 V | 1 | 15 | Eşdeğer 20 kg·cm 25T spline servo | Satıcı tork verisi doğrulanmadı; stall akımı ölçülecek | docs/exterior_language_A2.md | V1
B22 | Rulman tedarikçisi seçilecek | 6804-2RS | A2 pan boynu ince kesitli rulman 20×32×7 mm | 1 | 4 | 61804 eşdeğeri | Tutucu/geçme tasarımı açık | docs/exterior_language_A2.md | V1
B23 | LED şerit tedarikçisi seçilecek | SELECTION-OPEN-LEDBAR | A2 ön ışık şeridi; 8 adreslenebilir LED (WS2812B/SK6812 sınıfı) 5 V | 1 | 5 | SK6812 mini | Firmware parlaklık tavanı ≤0.5 W; IP ve renk seçimi açık | docs/a2_electronics.md | V1
B24 | STMicroelectronics | VL53L1X modülü (kart seçimi açık) | A2 ön tampon ToF mesafe sensörü; I2C + XSHUT | 2 | 12 | VL53L4CD kısa menzil | Modül MPN/pencere/kalibrasyon açık | https://www.st.com/en/imaging-and-photonics-solutions/vl53l1x.html | V1
B25 | Raspberry Pi | Standard–Mini kamera kablosu (boy seçilecek) | CM5 IO 22 pin ↔ kamera 15 pin FPC; boyun burulma yolu | 2 | 3 | Özel FPC uzatma; EMI yeniden | Uzunluk boyun kablo yoluna göre seçilecek | https://www.raspberrypi.com/documentation/accessories/camera.html | V1
B26 | Regülatör üreticisi seçilecek | SELECTION-OPEN-SERVO-BUCK | MCU kartında ACT_BUS→6 V/4 A servo buck; EN girişli | 1 | 6 | Hazır 6 V/5 A buck modülü yalnız prototipte | IC/manyetik alt proje 5; B09 dışı bütçe | docs/a2_electronics.md | V1
C01 | STMicroelectronics | STM32G474VET6 | LQFP100 MCU; B09 içinde | 1 | 12 | STM32G474VET6 eşdeğer tedarik; farklı MCU pin uyumu garanti değil | Aktif ürün; stok sorgulanmadı | https://www.st.com/en/microcontrollers-microprocessors/stm32g474ve.html | DETAIL_INCLUDED
C02 | Texas Instruments | DRV8874PWPR | H-köprü; B09 içinde | 4 | 5 | DRV8243 sınıfı; şema/layout yeniden tasarım | Aday; kesin ambalaj teyidi | https://www.ti.com/product/DRV8874 | DETAIL_INCLUDED
C03 | Bosch Sensortec | BMI088 | SPI IMU; B09 içinde | 1 | 15 | ICM-42688-P; driver/footprint yeniden tasarım | Aday; stok sorgulanmadı | https://www.bosch-sensortec.com/products/motion-sensors/imus/bmi088/ | DETAIL_INCLUDED
C04 | Texas Instruments | LM61495 | 5.1V6A compute buck IC; exact suffix PH6; B10 içinde | 1 | 8 | Uygun36V giriş buck; manyetik/layout değişir | IC aday; kesin sipariş kodu açık | https://www.ti.com/product/LM61495 | DETAIL_INCLUDED
C05 | Texas Instruments | INA228 | Paket akım/enerji ölçümü; B10 içinde | 1 | 6 | INA238 + firmware integrasyon; özellik farkı | IC aday; exact suffix açık | https://www.ti.com/product/INA228 | DETAIL_INCLUDED
C07 | NXP | PCA9615DP | Diferansiyel I2C kablo tamponu; B09/B10 içinde | 2 | 4 | Eşdeğer diferansiyel I2C tamponu ancak şema tekrar tasarım | Aday; 3.3V kart/5V kablo referans devresi hazır; güç sırası ve kart şematiği açık | https://www.nxp.com/products/interfaces/ic-spi-i3c-interface-devices/ic-bus-repeaters-hubs-extenders/two-channel-multipoint-fast-mode-plus-differential-ic-bus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 | DETAIL_INCLUDED
C08 | Texas Instruments | SN74LVC244APWR | Güçsüz PWR durum girişleri için sekiz kanallı Ioff tampon; B09 içinde | 1 | 2 | Aynı Ioff ve pin uyumlu tampon; elektriksel yeniden inceleme | Aday; OE/PGOOD brownout ve nSLEEP bağlantısı açık | https://www.ti.com/product/SN74LVC244A | DETAIL_INCLUDED
C09 | Microchip | MCP2562-E/SN | 5V VDD ve 3.3V VIO CAN transceiver; B09 içinde | 1 | 2 | MCP2562FD-E/SN; footprint/power-up tekrar inceleme | Aday; TVS/terminasyon/güç sırası açık | https://www.microchip.com/en-us/product/MCP2562 | DETAIL_INCLUDED
C06 | Texas Instruments | TPS3431SDRBR | Harici watchdog; 100pF C0G CWD ve PGOOD ile; B09/B10 içinde | 1 | 3 | Uygun bağımsız watchdog; aynı <=100ms azami trip kanıtı gerekir | Aday; 100pF ve besleme sırası PH6 incelemesi açık | https://www.ti.com/lit/ds/symlink/tps3431.pdf | DETAIL_INCLUDED
C10 | Texas Instruments | TCA9534APWR | PWR üzerinde 8-bit I2C ARMING kumanda expander; B10 içinde | 1 | 2 | Eşdeğer güçte giriş resetli I2C GPIO; şema tekrar tasarım | Aday; harici pulldown ve WD/NC gate kanıtı açık | https://www.ti.com/product/TCA9534A/part-details/TCA9534APWR | DETAIL_INCLUDED
C11 | Texas Instruments | ADS1115IDGSR | PWR üzerinde üç ray gerilimi ve bir yedek kanal ADC; B10 içinde | 1 | 4 | Eşdeğer dört kanallı ADC; giriş koruma ve yazılım yeniden tasarım | Aday; güçsüz giriş koruması ve analog hata bütçesi açık | https://www.ti.com/lit/ds/symlink/ads1115.pdf | DETAIL_INCLUDED
C12 | Texas Instruments | LM74900QRGERQ1 | K2 iki NFET ideal-diyot/ayırıcı kontrolcü; B10 içinde | 1 | 6 | LM74910-Q1; OCP ve güç dizisi yeniden doğrula | Koşullu aday; TI doğrudan stok yok; EN/OCP/termal şema açık | https://www.ti.com/product/LM74900-Q1/part-details/LM74900QRGERQ1 | DETAIL_INCLUDED
C13 | Texas Instruments | CSD18540Q5BT | K2 60V 2.2mOhm max @10V/25C seri NFET; B10 içinde | 2 | 3 | Eşdeğer >=60V <=2.2mOhm @10V; termal ve gate yeniden hesap | Koşullu aday; TI doğrudan stok yok; PCB bakır/termal açık | https://www.ti.com/product/CSD18540Q5B/part-details/CSD18540Q5BT | DETAIL_INCLUDED
C14 | Texas Instruments | INA180A2IDBVR | Servo rayı akım yükselteci 50 V/V; B09 içinde | 1 | 1 | INA181A2; pin/kazanç yeniden kontrol | Aday; ADC2_IN5 filtresi 1k/10n | https://www.ti.com/product/INA180 | DETAIL_INCLUDED
C15 | Texas Instruments | SN74LVC1G08DBVR | Servo rayı EN = MCU isteği AND PWR izni; B09 içinde | 1 | 1 | Eşdeğer tek AND kapı | Aday; güçsüz giriş davranışı incelenecek | https://www.ti.com/product/SN74LVC1G08 | DETAIL_INCLUDED
C16 | Texas Instruments | SN74AHCT1G125DBVR | Işık şeridi 3.3 V→5 V veri tamponu; B09 içinde | 1 | 1 | SN74HCT1G125; hız ve VIH kontrol | Aday | https://www.ti.com/product/SN74AHCT1G125 | DETAIL_INCLUDED
C17 | Direnç üreticisi seçilecek | SELECTION-OPEN-SHUNT-2512 | Servo rayı 10 mΩ %1 1 W 2512 şönt; B09 içinde | 1 | 1 | Kelvin 2512 şönt | MPN ve Kelvin iz yerleşimi açık | electronics/ugv_mcu_01/servo_light.kicad_sch | DETAIL_INCLUDED
F01 | Texas Instruments | TPS55288 | 12V2A expansion buck-boost | 1 | 10 | Uygun dört anahtarlı buck-boost | V1 DNP; PH6 tasarım rezervi | https://www.ti.com/product/TPS55288 | FUTURE
F02 | UGV-01 | UGV-COMPUTE-01 | Özel CM5 carrier; 6 katman kontrollü empedans | 1 | 250 | V1 resmi IO korunabilir | Gelecek faz bütçesi; IC/fab kesin değil | electronics/ugv_compute_01/README.md | FUTURE
F03 | Microchip | MCP2518FD | SPI CAN controller; future carrier | 1 | 5 | USB CAN controller; firmware/host değişir | Aday; transceiver ayrıca gerekli | https://www.microchip.com/en-us/product/MCP2518FD | FUTURE
