efekrkyn/UGV-01/UGV-01/cad/assembly/generated/UGV-MECH-003-RR.step

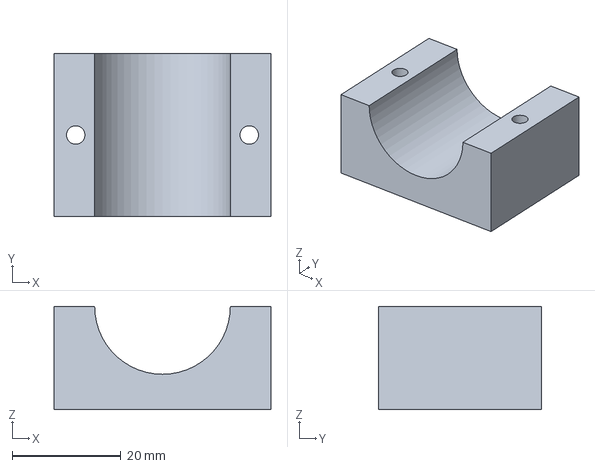
[picture p7: CAD file, 2026-09-30]
UGV-01/cad/assembly/generated/UGV-MECH-003-RR.step
40.0 x 30.0 x 19.0 mm
