efekrkyn/UGV-01/UGV-01/cad/drivetrain/generated/lightweight/UGV-MECH-042-B.step

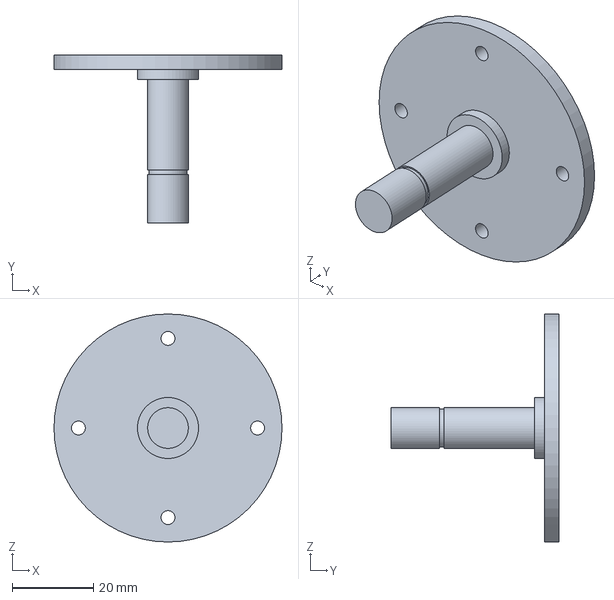
[picture p8: CAD file, 2026-09-27]
UGV-01/cad/drivetrain/generated/lightweight/UGV-MECH-042-B.step
56.0 x 41.2 x 56.0 mm
