efekrkyn/UGV-01/UGV-01/cad/drivetrain/generated/REF-RULAND-OLDHAM.step

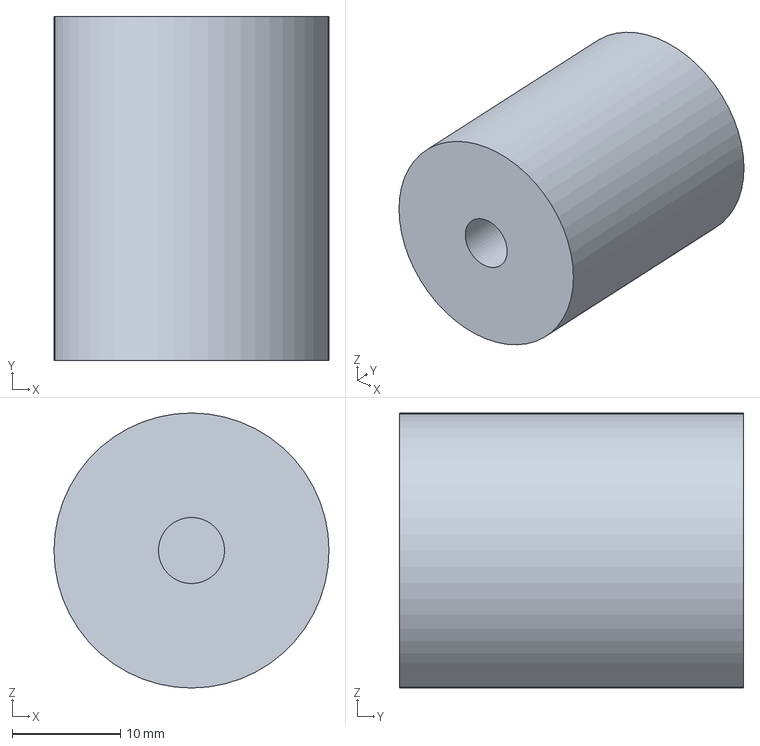
[picture p9: CAD file, 2026-09-27]
UGV-01/cad/drivetrain/generated/REF-RULAND-OLDHAM.step
25.4 x 31.8 x 25.4 mm
