efekrkyn/UGV-01/UGV-01/docs/revisions/A2/UGV-01-A2-concept.step

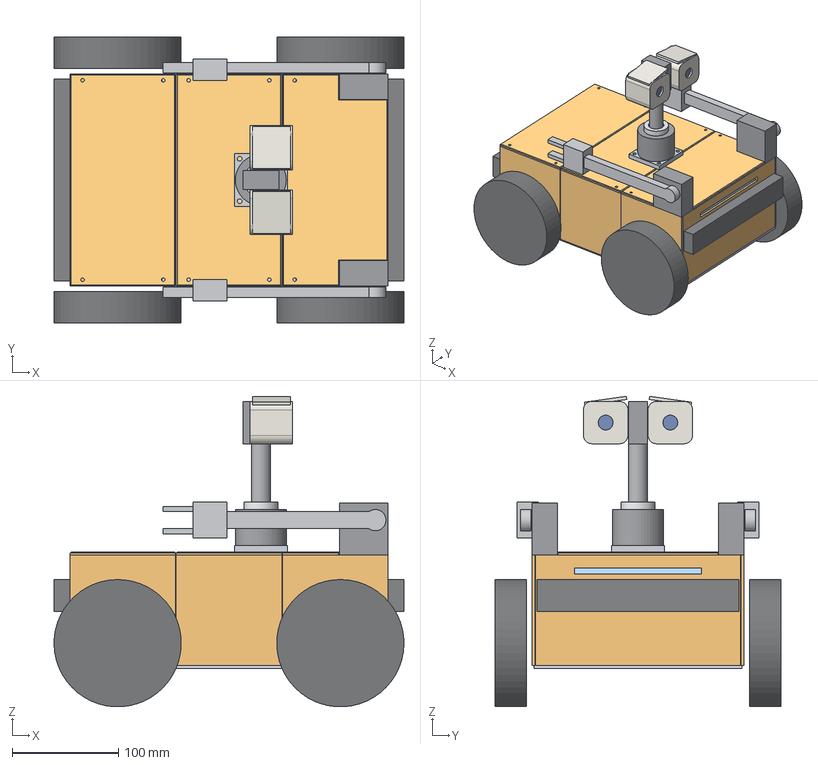
[picture p11: CAD file, 2026-09-27]
UGV-01/docs/revisions/A2/UGV-01-A2-concept.step
330.0 x 270.0 x 292.7 mm
UGV-MECH-001
UGV-MECH-002--1
UGV-MECH-002-+1
UGV-MECH-010--1
UGV-MECH-010-+1
UGV-MECH-013-1
UGV-MECH-011--1
UGV-MECH-011-+1
UGV-MECH-013-2
UGV-MECH-012--1
UGV-MECH-012-+1
UGV-MECH-013-3
UGV-MECH-022--1
UGV-MECH-017--1
UGV-MECH-022-+1
UGV-MECH-017-+1
REF-WHEEL-RR
REF-MOTOR-RR
REF-WHEEL-RL
REF-MOTOR-RL
REF-WHEEL-FR
REF-MOTOR-FR
REF-WHEEL-FL
REF-MOTOR-FL
REF-BATTERY
REF-CM5-IO
REF-PWR-PCB
REF-MCU-PCB
UGV-MECH-030
REF-LIGHT-BAR
UGV-MECH-040
REF-SERVO-PAN
REF-BEARING-PAN
UGV-MECH-041
UGV-MECH-042
REF-SERVO-TILT
UGV-MECH-043--1
REF-EYE-CAMERA--1
UGV-MECH-043-+1
REF-EYE-CAMERA-+1
UGV-MECH-050--1
UGV-MECH-051--1
UGV-MECH-050-+1
UGV-MECH-051-+1
REF-SERVO-SHOULDER-R
REF-SERVO-GRIPPER-R
