efekrkyn/UGV-01/UGV-01/cad/assembly/generated/UGV-MECH-015-RL.step

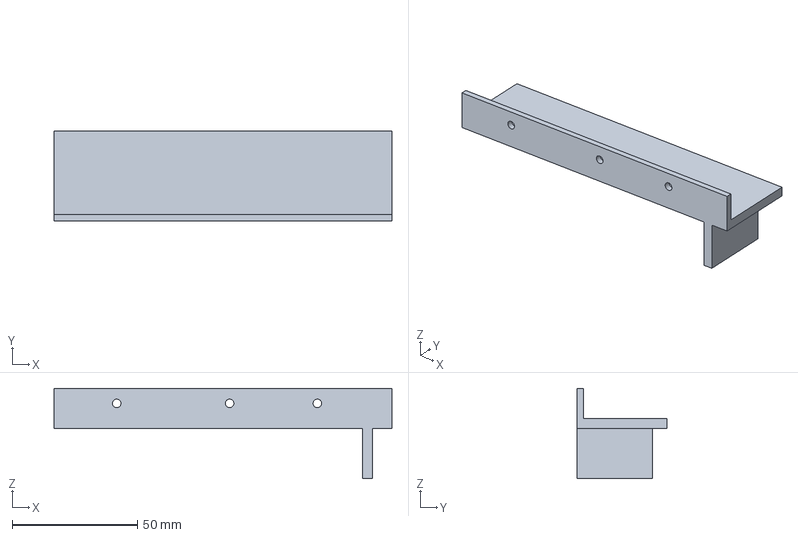
[picture p12: CAD file, 2026-09-30]
UGV-01/cad/assembly/generated/UGV-MECH-015-RL.step
134.8 x 35.8 x 36.0 mm
