efekrkyn/UGV-01/UGV-01/cad/drivetrain/generated/lightweight/UGV-MECH-047-B.step

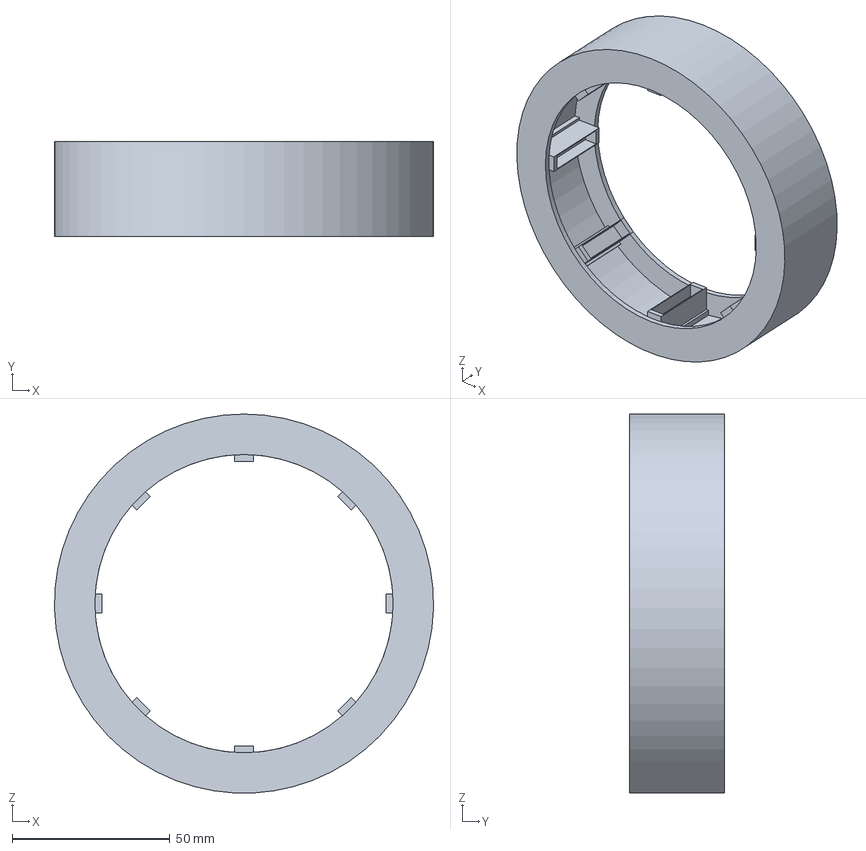
[picture p13: CAD file, 2026-09-27]
UGV-01/cad/drivetrain/generated/lightweight/UGV-MECH-047-B.step
120.0 x 30.0 x 119.9 mm
