efekrkyn/UGV-01/UGV-01/cad/drivetrain/generated/UGV-MECH-043.step

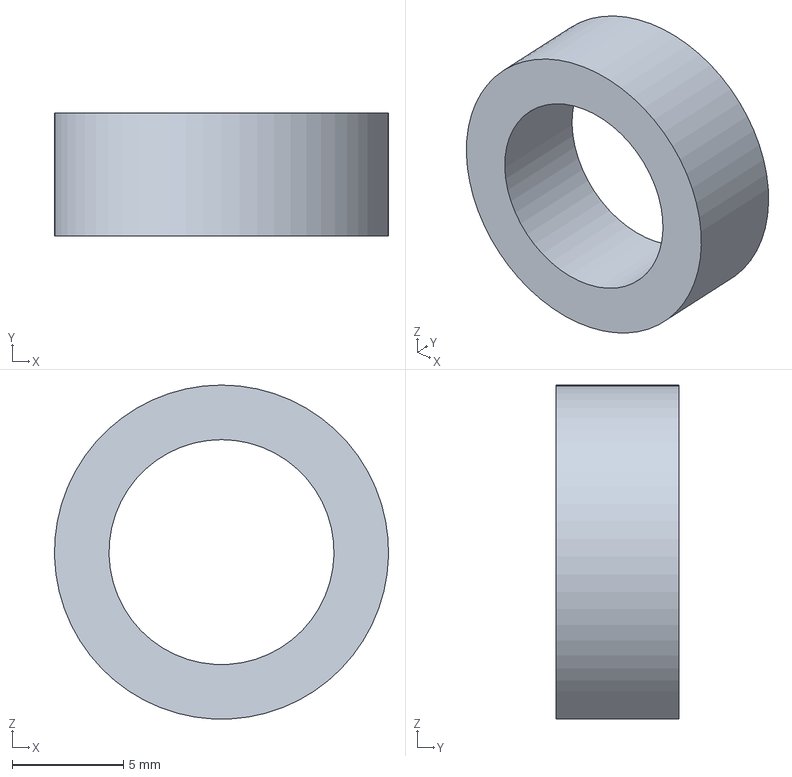
[picture p14: CAD file, 2026-09-27]
UGV-01/cad/drivetrain/generated/UGV-MECH-043.step
15.0 x 5.50 x 15.0 mm
