efekrkyn/UGV-01/UGV-01/cad/assembly/generated/UGV-MECH-046.step

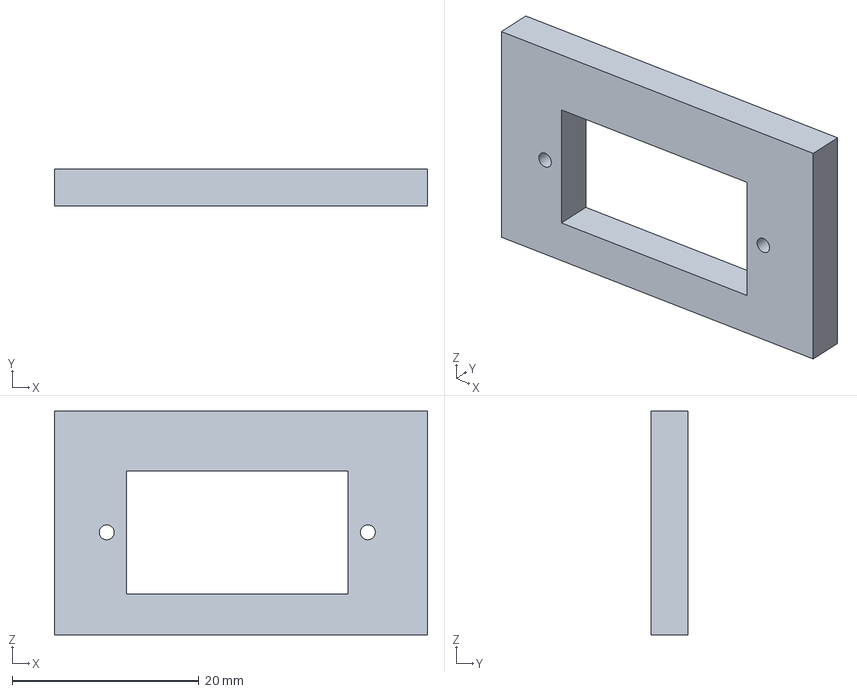
[picture p15: CAD file, 2026-09-30]
UGV-01/cad/assembly/generated/UGV-MECH-046.step
40.0 x 4.00 x 24.0 mm
