efekrkyn/UGV-01/UGV-01/cad/drivetrain/generated/lightweight/UGV-MECH-046-B.step

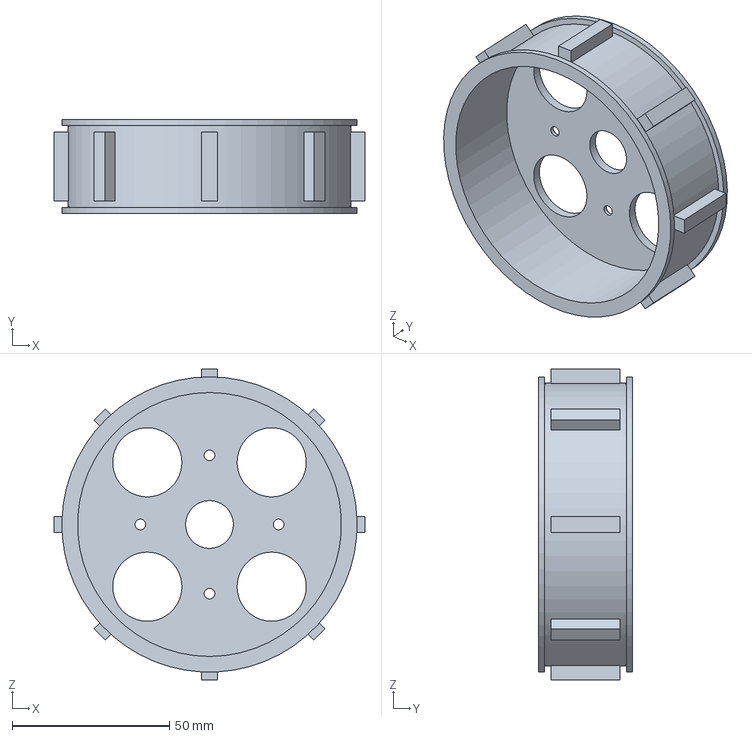
[picture p16: CAD file, 2026-09-27]
UGV-01/cad/drivetrain/generated/lightweight/UGV-MECH-046-B.step
99.0 x 30.0 x 99.0 mm
