efekrkyn/UGV-01/UGV-01/cad/drivetrain/generated/REF-RETAINING-RING-10.step

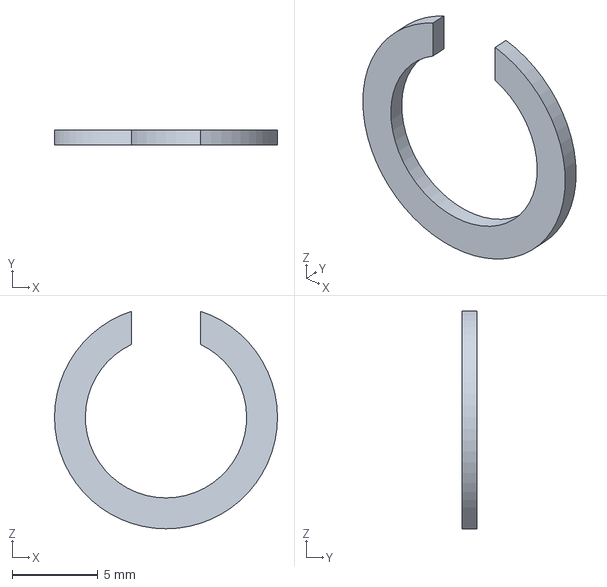
[picture p17: CAD file, 2026-09-27]
UGV-01/cad/drivetrain/generated/REF-RETAINING-RING-10.step
13.0 x 0.9 x 12.7 mm
