efekrkyn/UGV-01/UGV-01/cad/drivetrain/generated/REF-6000-2RSH-1.step

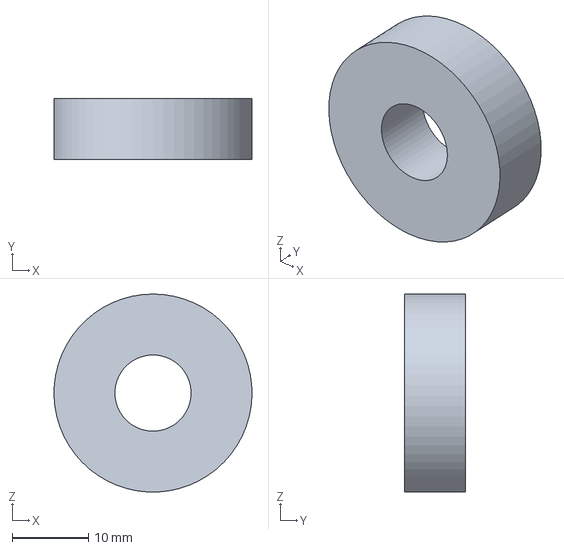
[picture p18: CAD file, 2026-09-27]
UGV-01/cad/drivetrain/generated/REF-6000-2RSH-1.step
26.0 x 8.00 x 26.0 mm
