efekrkyn/UGV-01/UGV-01/cad/drivetrain/generated/UGV-MECH-040.step

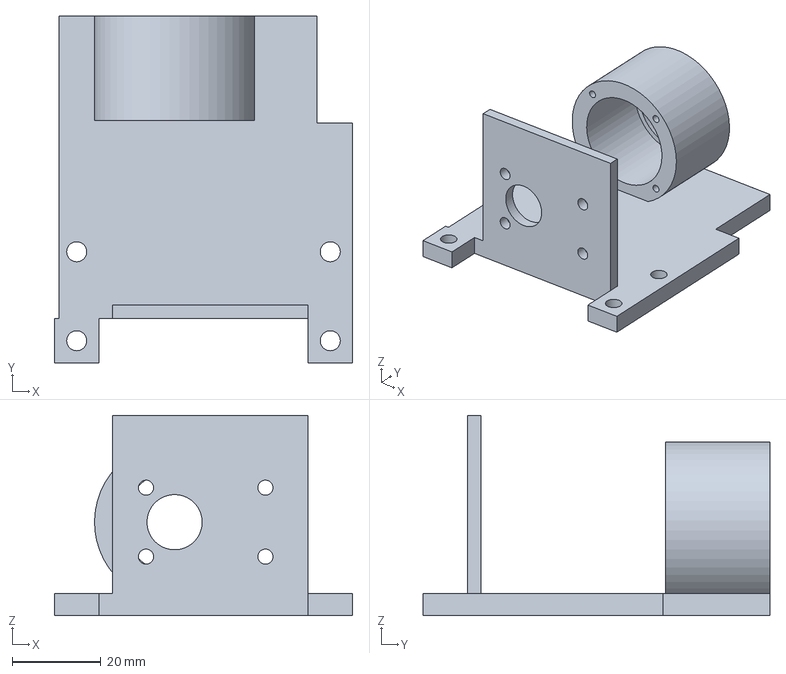
[picture p20: CAD file, 2026-09-27]
UGV-01/cad/drivetrain/generated/UGV-MECH-040.step
67.0 x 78.0 x 45.0 mm
