efekrkyn/UGV-01/UGV-01/cad/assembly/generated/UGV-MECH-073.step

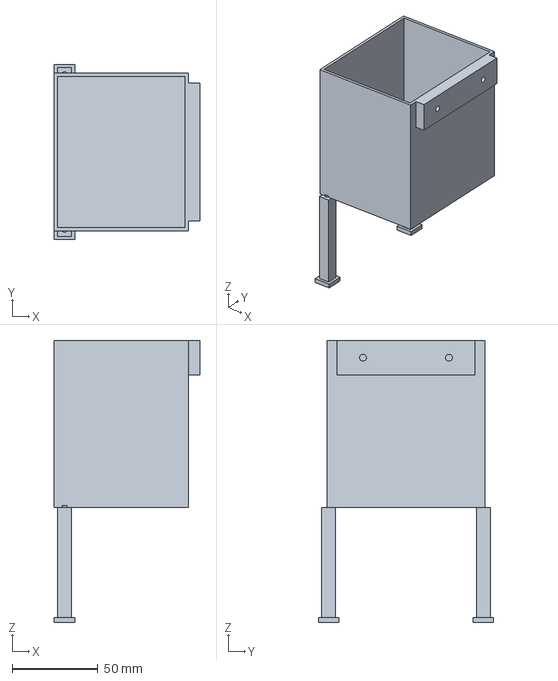
[picture p21: CAD file, 2026-09-30]
UGV-01/cad/assembly/generated/UGV-MECH-073.step
84.8 x 102.0 x 164.0 mm
