efekrkyn/UGV-01/UGV-01/cad/drivetrain/generated/UGV-MECH-040-base-interface-D1.dxf

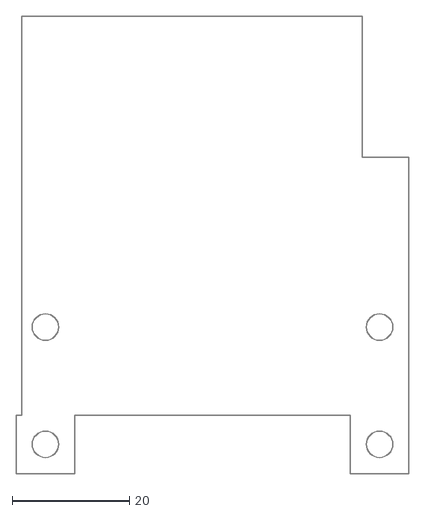
[picture p22: CAD file, 2026-09-27]
UGV-01/cad/drivetrain/generated/UGV-MECH-040-base-interface-D1.dxf
67.0 x 78.0
