efekrkyn/UGV-01/UGV-01/cad/assembly/generated/REF-BALLAST-1.step

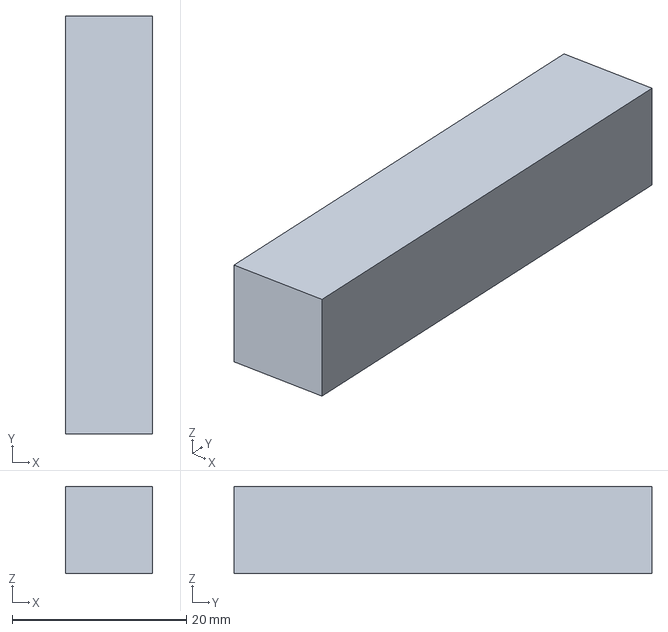
[picture p23: CAD file, 2026-09-30]
UGV-01/cad/assembly/generated/REF-BALLAST-1.step
10.0 x 48.0 x 10.0 mm
