efekrkyn/UGV-01/UGV-01/cad/drivetrain/generated/UGV-MECH-041.step

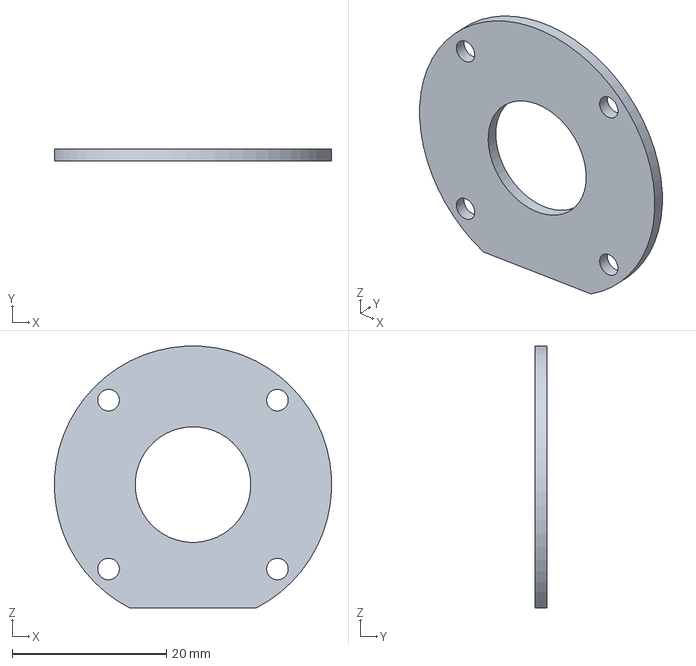
[picture p24: CAD file, 2026-09-27]
UGV-01/cad/drivetrain/generated/UGV-MECH-041.step
36.0 x 1.50 x 34.0 mm
