efekrkyn/UGV-01/UGV-01/cad/assembly/generated/UGV-MECH-075-+1.step

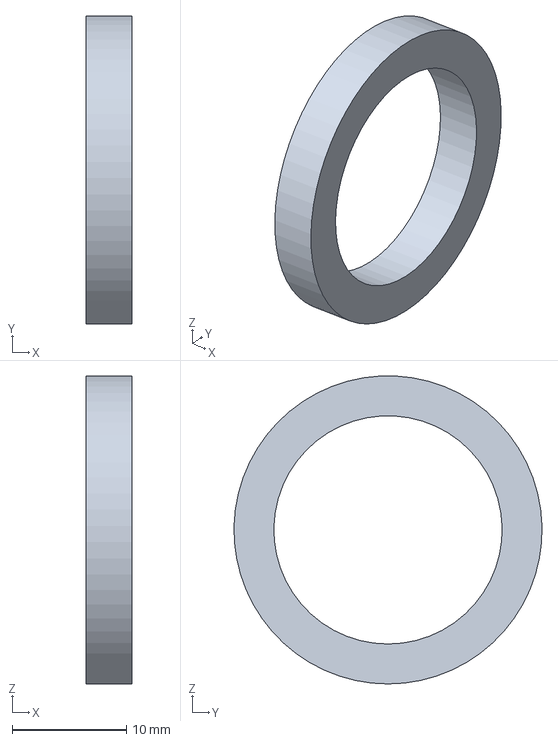
[picture p25: CAD file, 2026-09-30]
UGV-01/cad/assembly/generated/UGV-MECH-075-+1.step
4.00 x 27.0 x 27.0 mm
