efekrkyn/UGV-01/UGV-01/cad/drivetrain/generated/UGV-MECH-040-motor-face-interface-D1.dxf

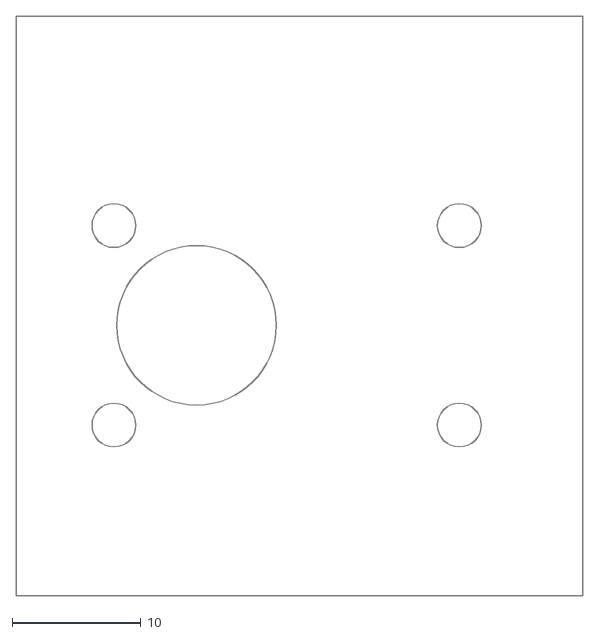
[picture p26: CAD file, 2026-09-27]
UGV-01/cad/drivetrain/generated/UGV-MECH-040-motor-face-interface-D1.dxf
44.0 x 45.0
