efekrkyn/UGV-01/UGV-01/cad/assembly/generated/REF-SERVO-PAN.step

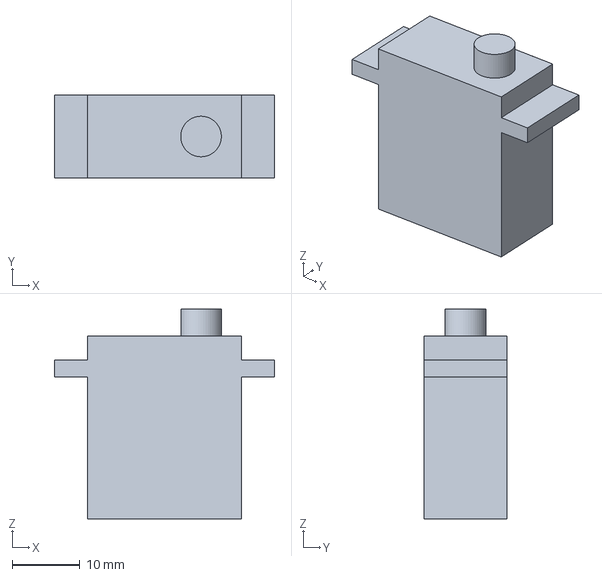
[picture p27: CAD file, 2026-09-30]
UGV-01/cad/assembly/generated/REF-SERVO-PAN.step
32.5 x 12.2 x 31.0 mm
