efekrkyn/UGV-01/UGV-01/cad/drivetrain/generated/UGV-01-D1-drivetrain.step

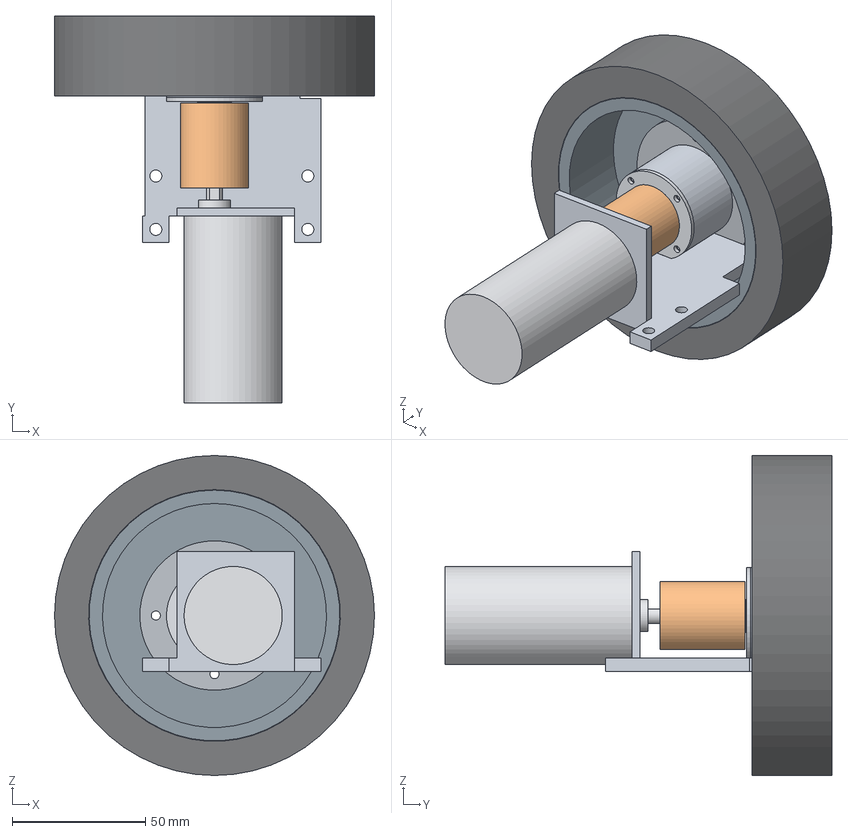
[picture p28: CAD file, 2026-09-27]
UGV-01/cad/drivetrain/generated/UGV-01-D1-drivetrain.step
120.0 x 145.1 x 120.0 mm
UGV-MECH-040
UGV-MECH-041
UGV-MECH-042
UGV-MECH-043
UGV-MECH-044
UGV-MECH-045
UGV-MECH-046
UGV-MECH-047
REF-6000-2RSH-1
REF-6000-2RSH-2
REF-POLOLU-4754
REF-RULAND-OLDHAM
REF-RETAINING-RING-10
