efekrkyn/UGV-01/UGV-01/cad/assembly/generated/UGV-MECH-041.step

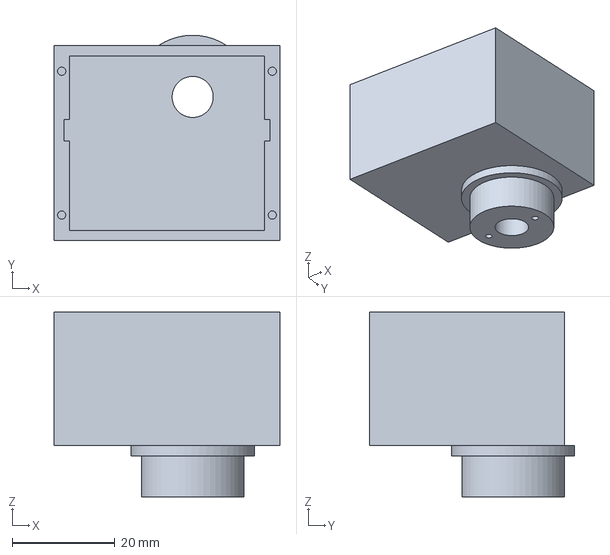
[picture p29: CAD file, 2026-09-30]
UGV-01/cad/assembly/generated/UGV-MECH-041.step
44.0 x 40.0 x 36.0 mm
