efekrkyn/UGV-01/UGV-01/cad/drivetrain/generated/UGV-01-D1-packaging.step

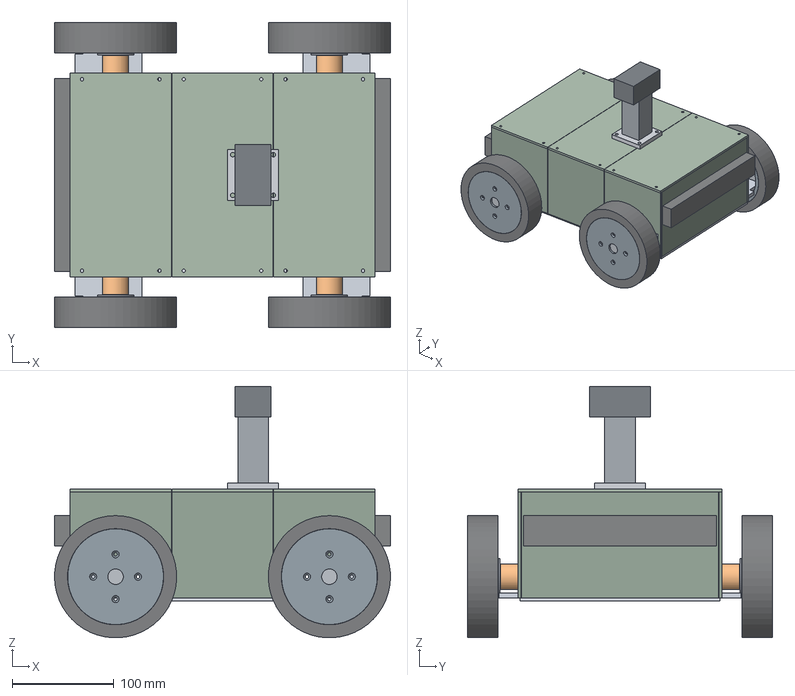
[picture p30: CAD file, 2026-09-27]
UGV-01/cad/drivetrain/generated/UGV-01-D1-packaging.step
330.0 x 300.0 x 246.9 mm
UGV-MECH-001
UGV-MECH-002--1
UGV-MECH-002-+1
UGV-MECH-010--1
UGV-MECH-010-+1
UGV-MECH-013-1
UGV-MECH-011--1
UGV-MECH-011-+1
UGV-MECH-013-2
UGV-MECH-012--1
UGV-MECH-012-+1
UGV-MECH-013-3
UGV-MECH-022--1
UGV-MECH-017--1
UGV-MECH-022-+1
UGV-MECH-017-+1
REF-BATTERY
REF-CM5-IO
REF-PWR-PCB
REF-MCU-PCB
UGV-MECH-030
REF-MAST-COLUMN
REF-CAMERA
UGV-MECH-040-RR
UGV-MECH-041-RR
UGV-MECH-042-RR
UGV-MECH-043-RR
UGV-MECH-044-RR
UGV-MECH-045-RR
UGV-MECH-046-RR
UGV-MECH-047-RR
REF-6000-2RSH-1-RR
REF-6000-2RSH-2-RR
REF-POLOLU-4754-RR
REF-RULAND-OLDHAM-RR
REF-RETAINING-RING-10-RR
UGV-MECH-040-RL
UGV-MECH-041-RL
UGV-MECH-042-RL
UGV-MECH-043-RL
UGV-MECH-044-RL
UGV-MECH-045-RL
UGV-MECH-046-RL
UGV-MECH-047-RL
REF-6000-2RSH-1-RL
REF-6000-2RSH-2-RL
REF-POLOLU-4754-RL
REF-RULAND-OLDHAM-RL
REF-RETAINING-RING-10-RL
UGV-MECH-040-FR
UGV-MECH-041-FR
UGV-MECH-042-FR
UGV-MECH-043-FR
UGV-MECH-044-FR
UGV-MECH-045-FR
UGV-MECH-046-FR
UGV-MECH-047-FR
REF-6000-2RSH-1-FR
REF-6000-2RSH-2-FR
REF-POLOLU-4754-FR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
