efekrkyn/UGV-01/UGV-01/cad/assembly/generated/UGV-MECH-002-+1.step

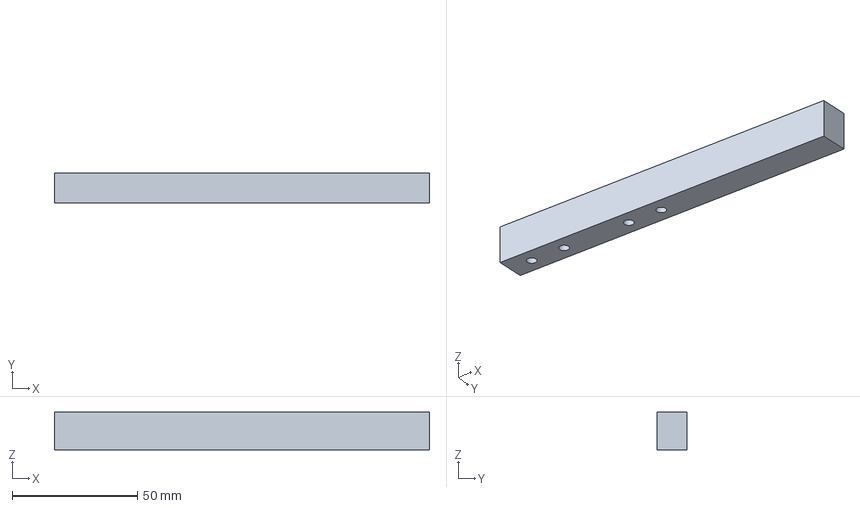
[picture p31: CAD file, 2026-09-30]
UGV-01/cad/assembly/generated/UGV-MECH-002-+1.step
150.0 x 12.0 x 15.0 mm
