efekrkyn/UGV-01/UGV-01/cad/drivetrain/generated/UGV-MECH-045.step

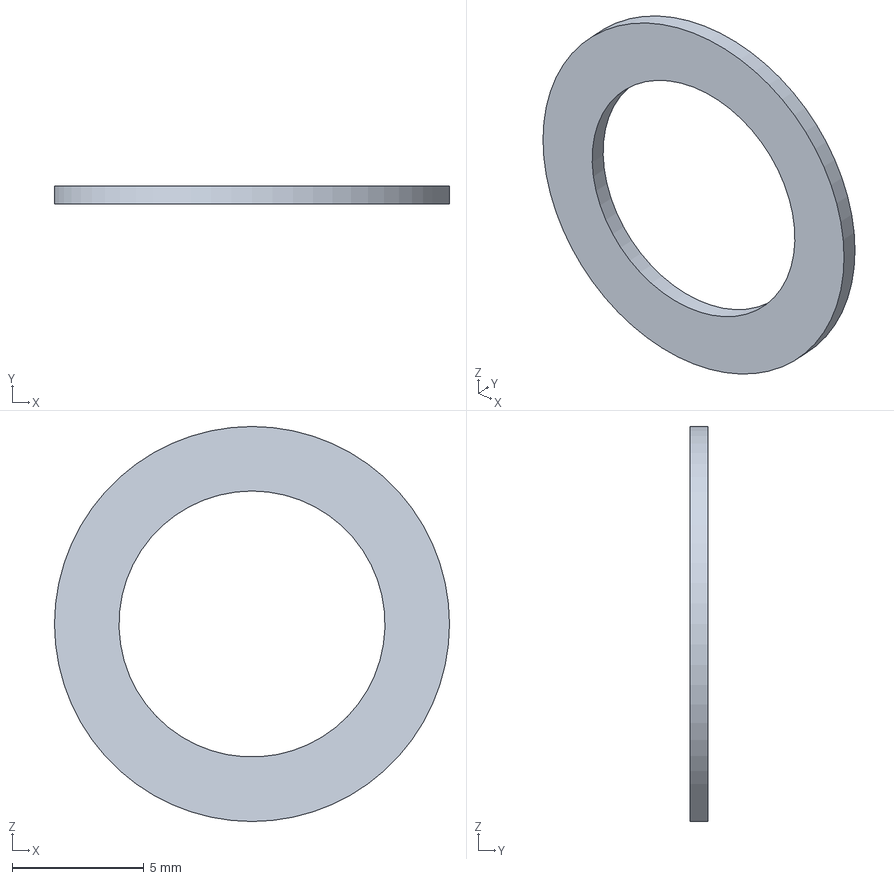
[picture p32: CAD file, 2026-09-27]
UGV-01/cad/drivetrain/generated/UGV-MECH-045.step
15.0 x 0.7 x 15.0 mm
