efekrkyn/UGV-01/UGV-01/cad/assembly/generated/UGV-MECH-069-+1.step

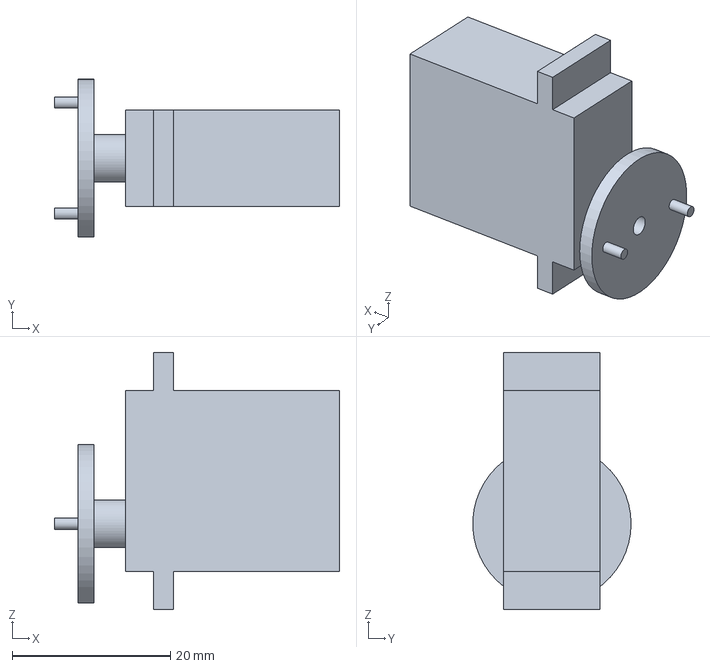
[picture p33: CAD file, 2026-09-30]
UGV-01/cad/assembly/generated/UGV-MECH-069-+1.step
36.0 x 20.0 x 32.5 mm
