efekrkyn/UGV-01/UGV-01/cad/assembly/generated/UGV-MECH-077-+1.step

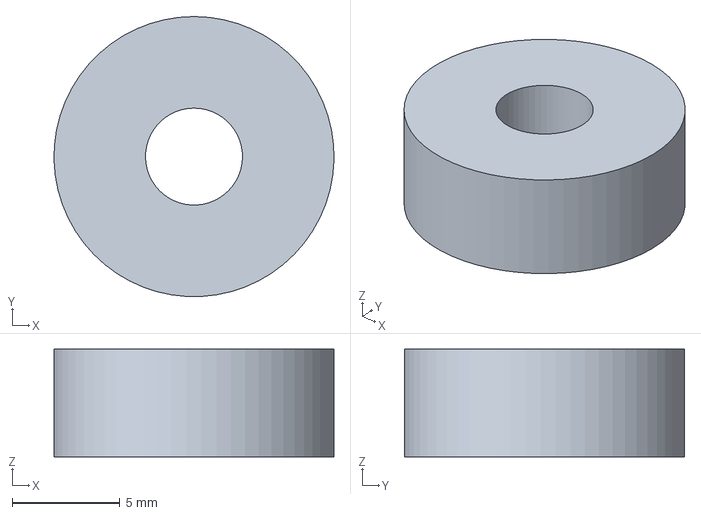
[picture p34: CAD file, 2026-09-30]
UGV-01/cad/assembly/generated/UGV-MECH-077-+1.step
13.0 x 13.0 x 5.00 mm
