efekrkyn/UGV-01/UGV-01/cad/drivetrain/generated/UGV-MECH-044.step

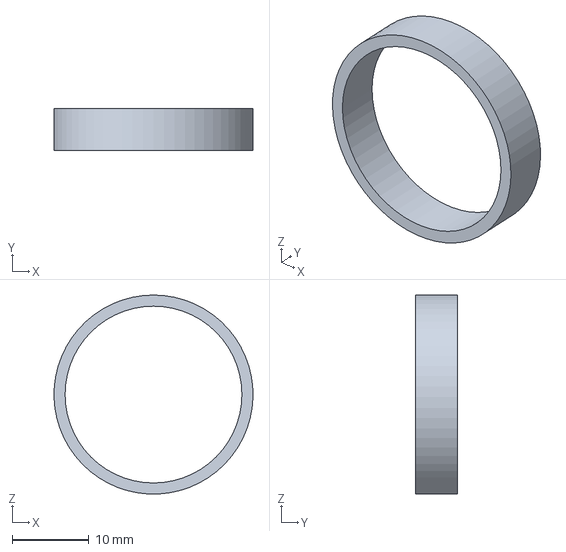
[picture p35: CAD file, 2026-09-27]
UGV-01/cad/drivetrain/generated/UGV-MECH-044.step
25.9 x 5.50 x 25.9 mm
