efekrkyn/UGV-01/UGV-01/cad/assembly/generated/REF-MOTOR-FL.step

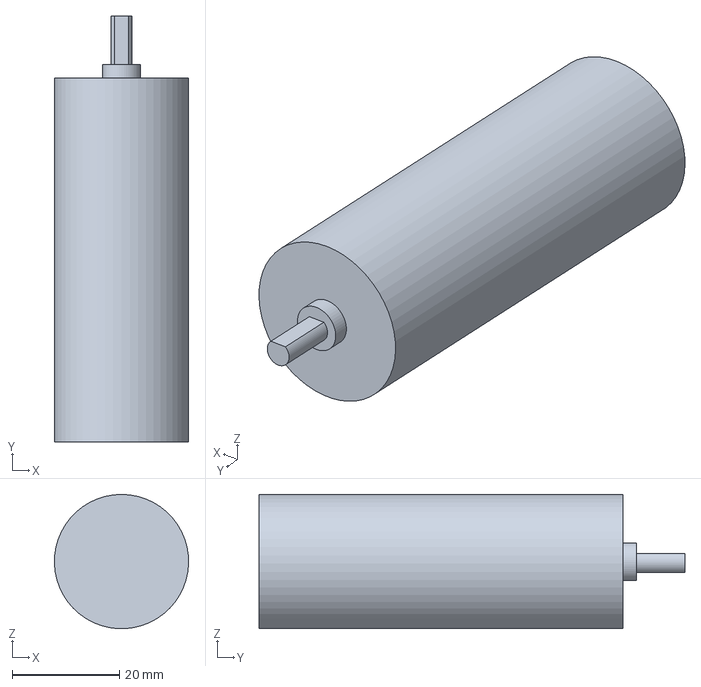
[picture p36: CAD file, 2026-09-30]
UGV-01/cad/assembly/generated/REF-MOTOR-FL.step
25.0 x 79.3 x 25.0 mm
