efekrkyn/UGV-01/UGV-01/cad/assembly/generated/UGV-MECH-013-1.step

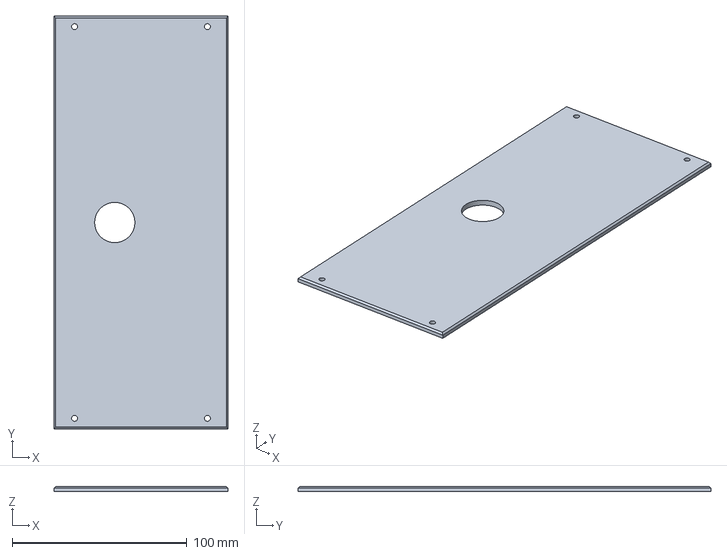
[picture p37: CAD file, 2026-09-30]
UGV-01/cad/assembly/generated/UGV-MECH-013-1.step
99.5 x 236.0 x 3.00 mm
