efekrkyn/UGV-01/UGV-01/cad/drivetrain/generated/UGV-MECH-047.step

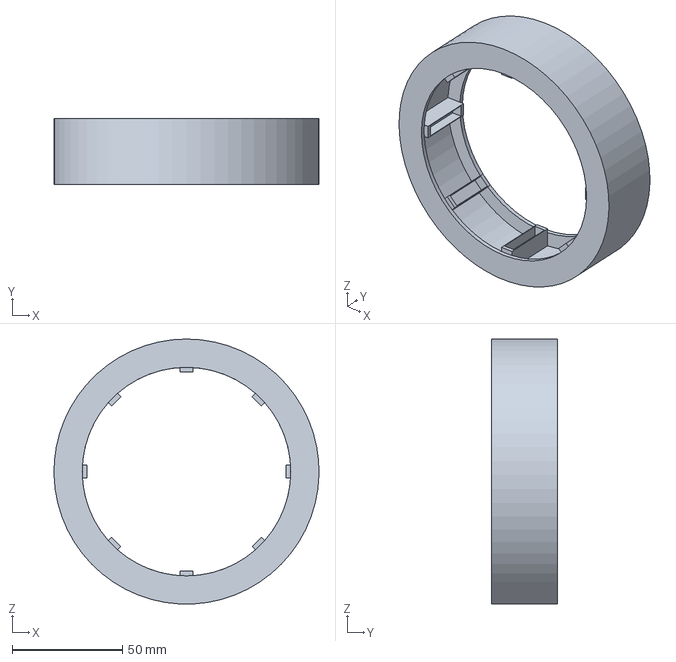
[picture p38: CAD file, 2026-09-27]
UGV-01/cad/drivetrain/generated/UGV-MECH-047.step
120.0 x 30.0 x 119.9 mm
