efekrkyn/UGV-01/UGV-01/cad/drivetrain/generated/REF-POLOLU-4754.step

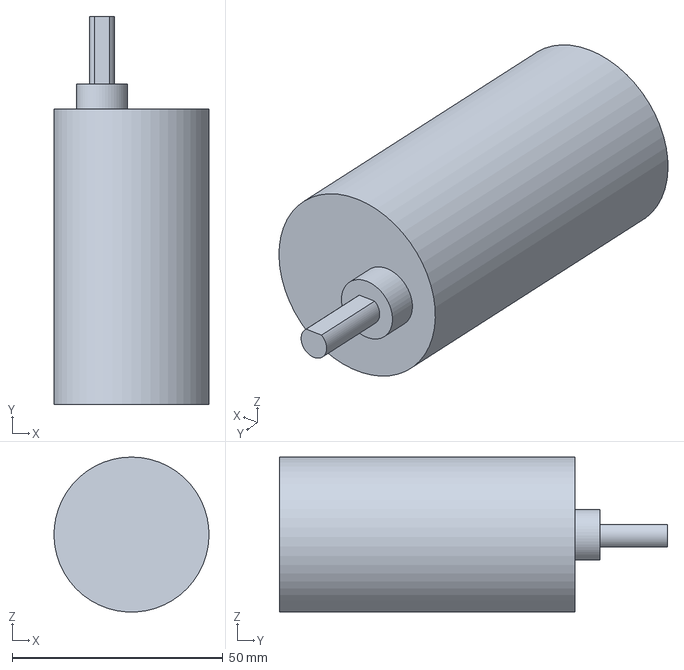
[picture p39: CAD file, 2026-09-27]
UGV-01/cad/drivetrain/generated/REF-POLOLU-4754.step
36.8 x 92.1 x 36.8 mm
