efekrkyn/UGV-01/UGV-01/cad/drivetrain/generated/UGV-MECH-046.step

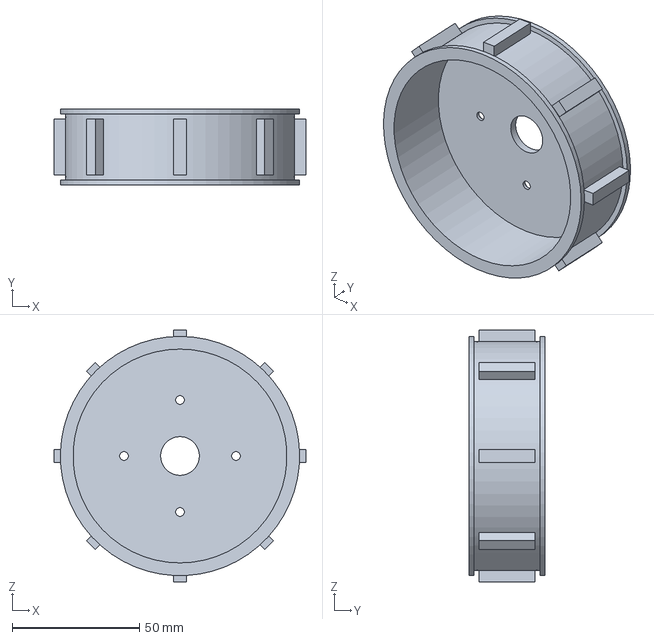
[picture p41: CAD file, 2026-09-27]
UGV-01/cad/drivetrain/generated/UGV-MECH-046.step
99.0 x 30.0 x 99.0 mm
