efekrkyn/UGV-01/UGV-01/cad/assembly/generated/UGV-MECH-053-+1.step

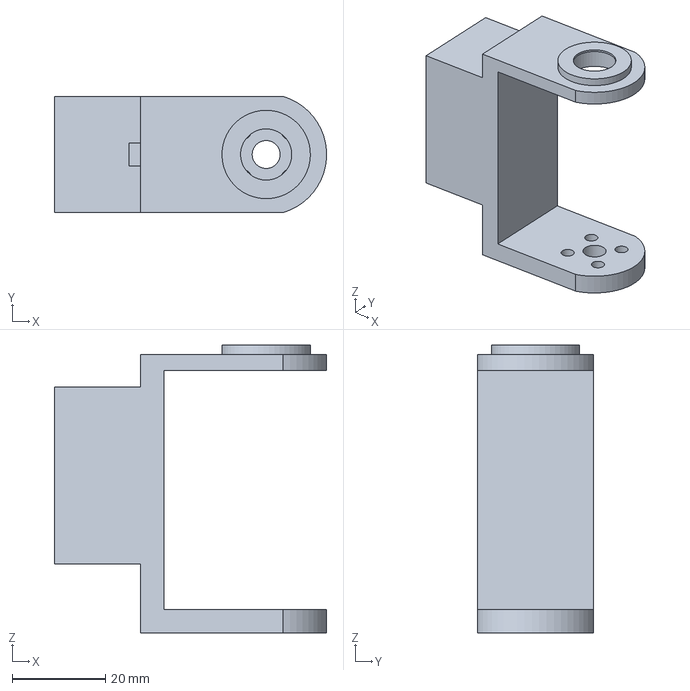
[picture p42: CAD file, 2026-09-30]
UGV-01/cad/assembly/generated/UGV-MECH-053-+1.step
58.5 x 25.0 x 61.9 mm
