efekrkyn/UGV-01/UGV-01/cad/assembly/generated/REF-SERVO-ELBOW-R.step

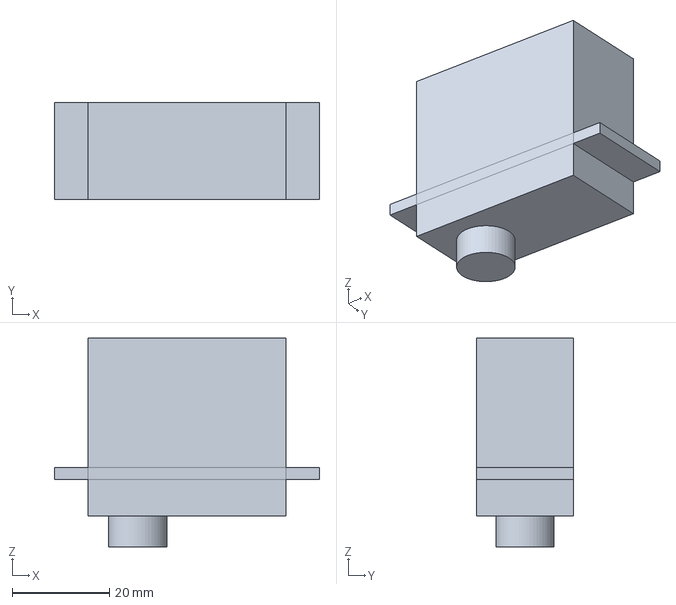
[picture p43: CAD file, 2026-09-30]
UGV-01/cad/assembly/generated/REF-SERVO-ELBOW-R.step
54.5 x 20.0 x 42.9 mm
