efekrkyn/UGV-01/UGV-01/cad/assembly/generated/UGV-MECH-001-concept.dxf

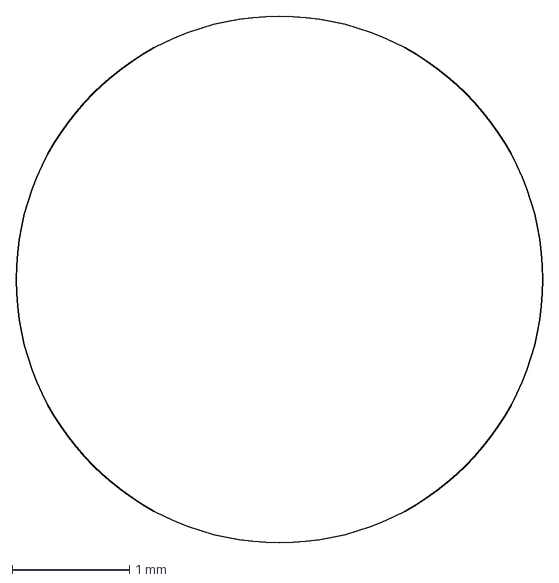
[picture p44: CAD file, 2026-09-30]
UGV-01/cad/assembly/generated/UGV-MECH-001-concept.dxf
4.50 x 4.50 mm
