efekrkyn/UGV-01/UGV-01/cad/assembly/generated/UGV-MECH-004-RL.step

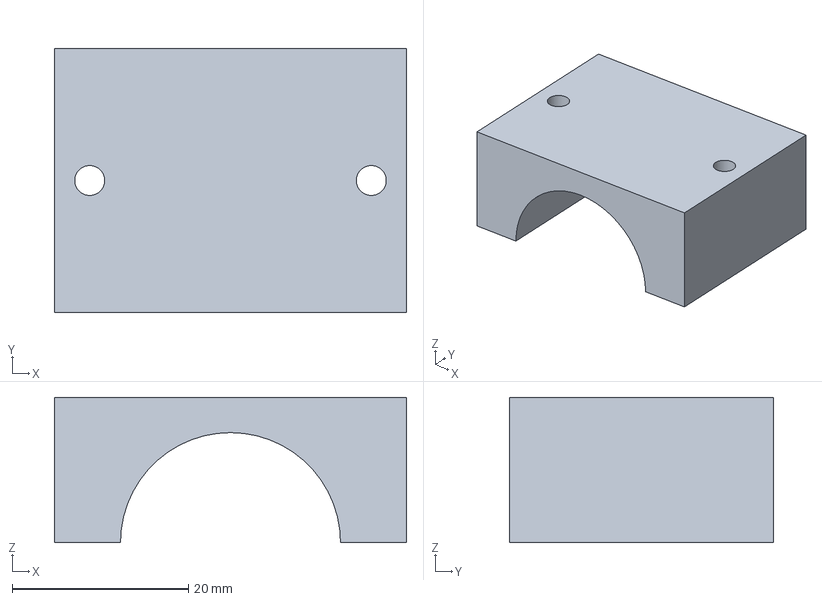
[picture p45: CAD file, 2026-09-30]
UGV-01/cad/assembly/generated/UGV-MECH-004-RL.step
40.0 x 30.0 x 16.5 mm
