efekrkyn/UGV-01/UGV-01/cad/assembly/generated/UGV-MECH-052-+1.step

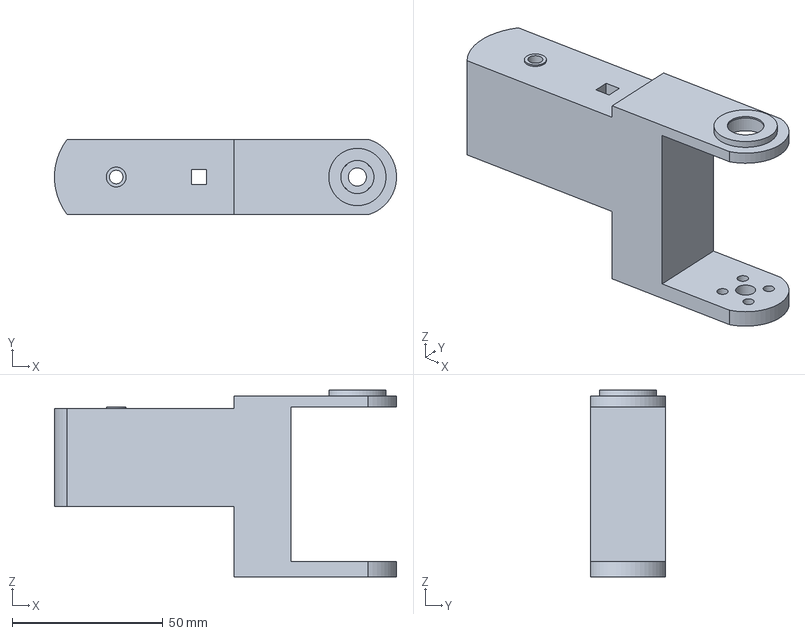
[picture p46: CAD file, 2026-09-30]
UGV-01/cad/assembly/generated/UGV-MECH-052-+1.step
113.4 x 25.0 x 61.9 mm
