efekrkyn/UGV-01/UGV-01/cad/assembly/generated/UGV-MECH-063--1.step

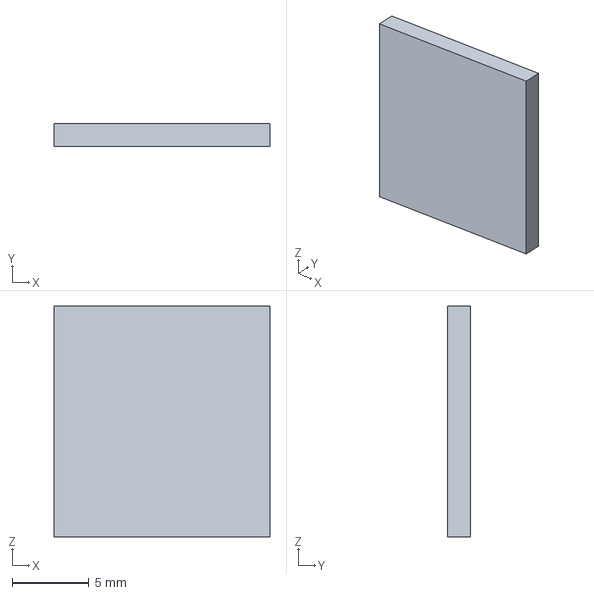
[picture p47: CAD file, 2026-09-30]
UGV-01/cad/assembly/generated/UGV-MECH-063--1.step
14.0 x 1.50 x 15.0 mm
