efekrkyn/UGV-01/UGV-01/cad/assembly/generated/REF-SERVO-SHOULDER-R.step

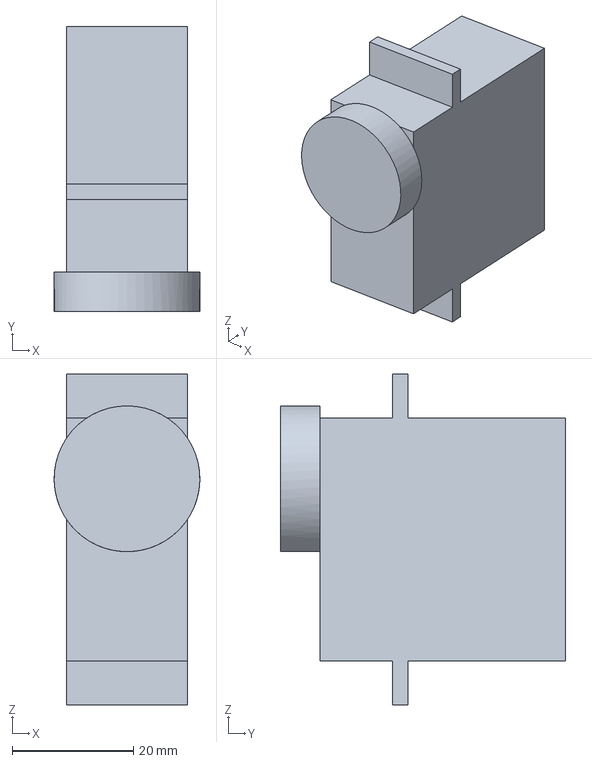
[picture p48: CAD file, 2026-09-30]
UGV-01/cad/assembly/generated/REF-SERVO-SHOULDER-R.step
24.0 x 47.0 x 54.5 mm
