efekrkyn/UGV-01/UGV-01/cad/assembly/generated/UGV-MECH-061-FR.step

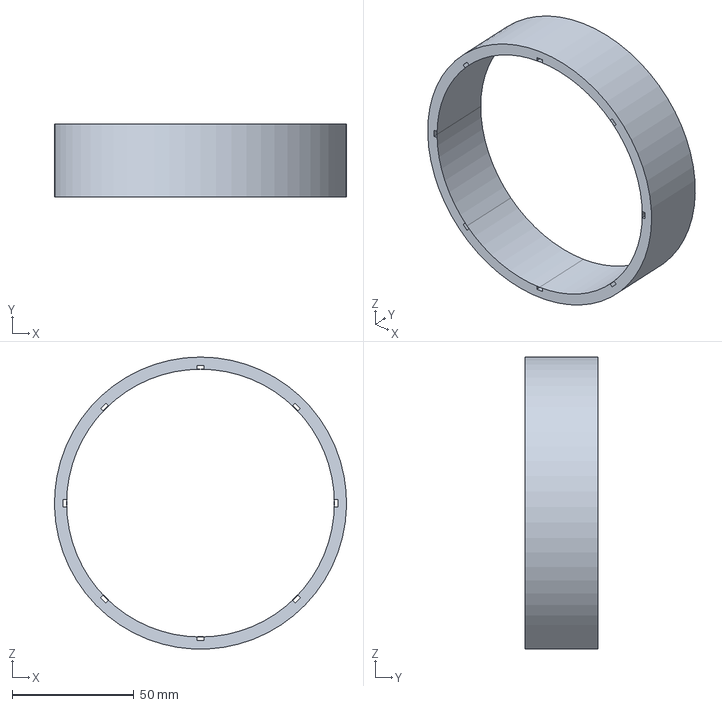
[picture p49: CAD file, 2026-09-30]
UGV-01/cad/assembly/generated/UGV-MECH-061-FR.step
120.0 x 30.0 x 119.9 mm
