efekrkyn/UGV-01/UGV-01/cad/assembly/generated/UGV-MECH-001-R.step

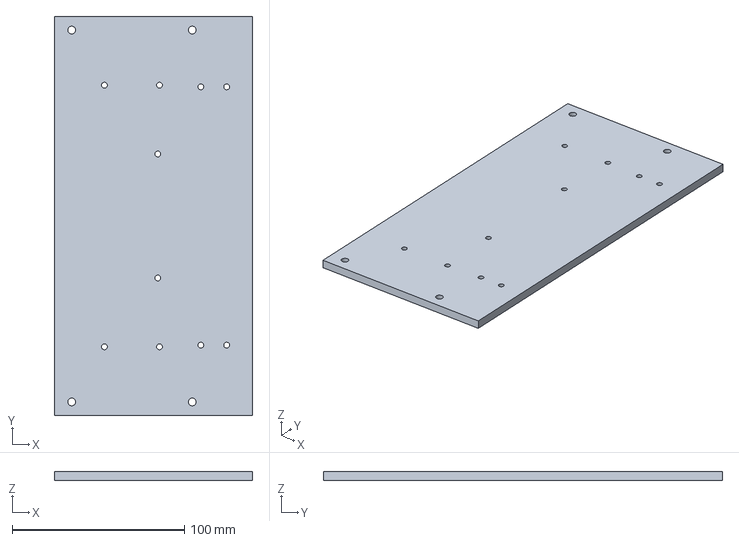
[picture p50: CAD file, 2026-09-30]
UGV-01/cad/assembly/generated/UGV-MECH-001-R.step
115.0 x 232.0 x 5.00 mm
