efekrkyn/UGV-01/UGV-01/cad/assembly/generated/UGV-MECH-018.step

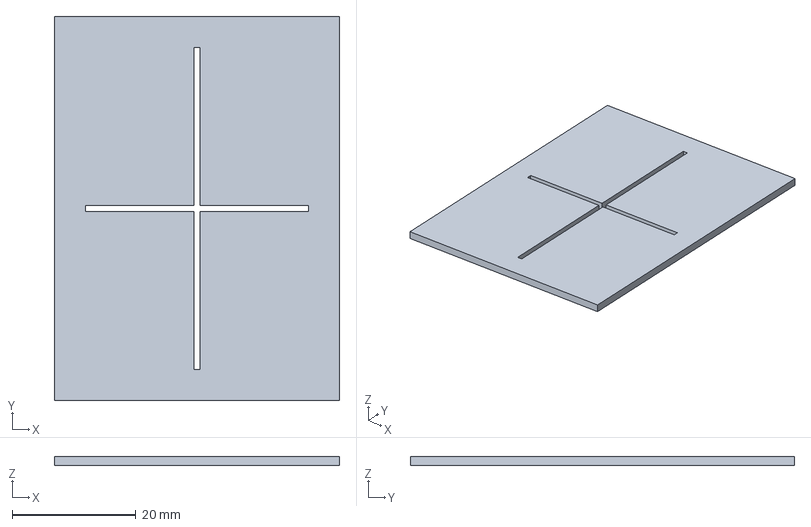
[picture p51: CAD file, 2026-09-30]
UGV-01/cad/assembly/generated/UGV-MECH-018.step
46.0 x 62.0 x 1.50 mm
