efekrkyn/UGV-01/UGV-01/cad/assembly/generated/UGV-MECH-057-+1.step

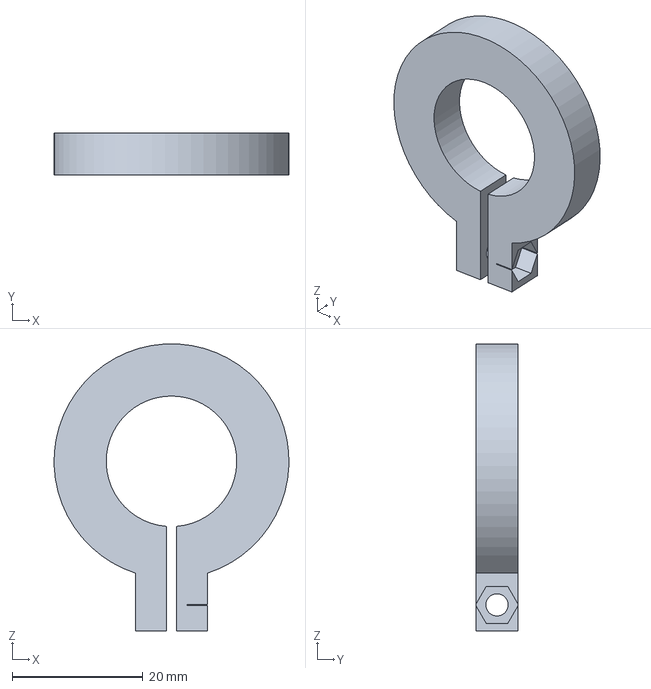
[picture p52: CAD file, 2026-09-30]
UGV-01/cad/assembly/generated/UGV-MECH-057-+1.step
36.0 x 6.50 x 44.0 mm
