efekrkyn/UGV-01/UGV-01/cad/assembly/generated/UGV-MECH-059-+1.step

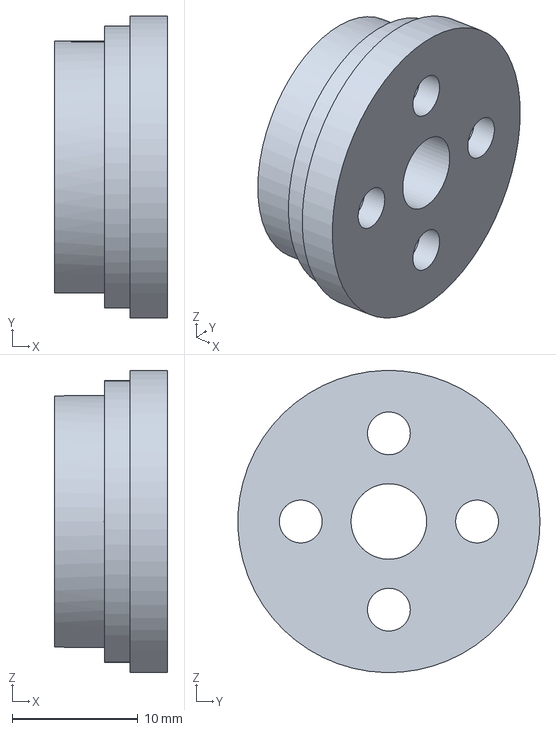
[picture p53: CAD file, 2026-09-30]
UGV-01/cad/assembly/generated/UGV-MECH-059-+1.step
9.00 x 24.0 x 24.0 mm
