efekrkyn/UGV-01/UGV-01/cad/assembly/generated/UGV-MECH-062-+1.step

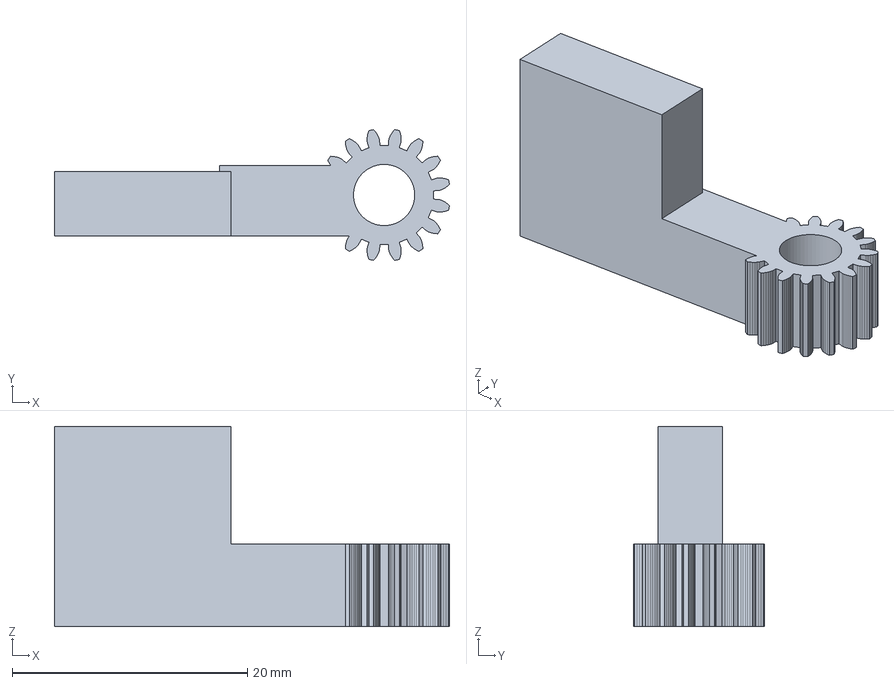
[picture p54: CAD file, 2026-09-30]
UGV-01/cad/assembly/generated/UGV-MECH-062-+1.step
33.6 x 11.1 x 17.0 mm
