efekrkyn/UGV-01/UGV-01/cad/assembly/generated/REF-LIGHT-BAR.step

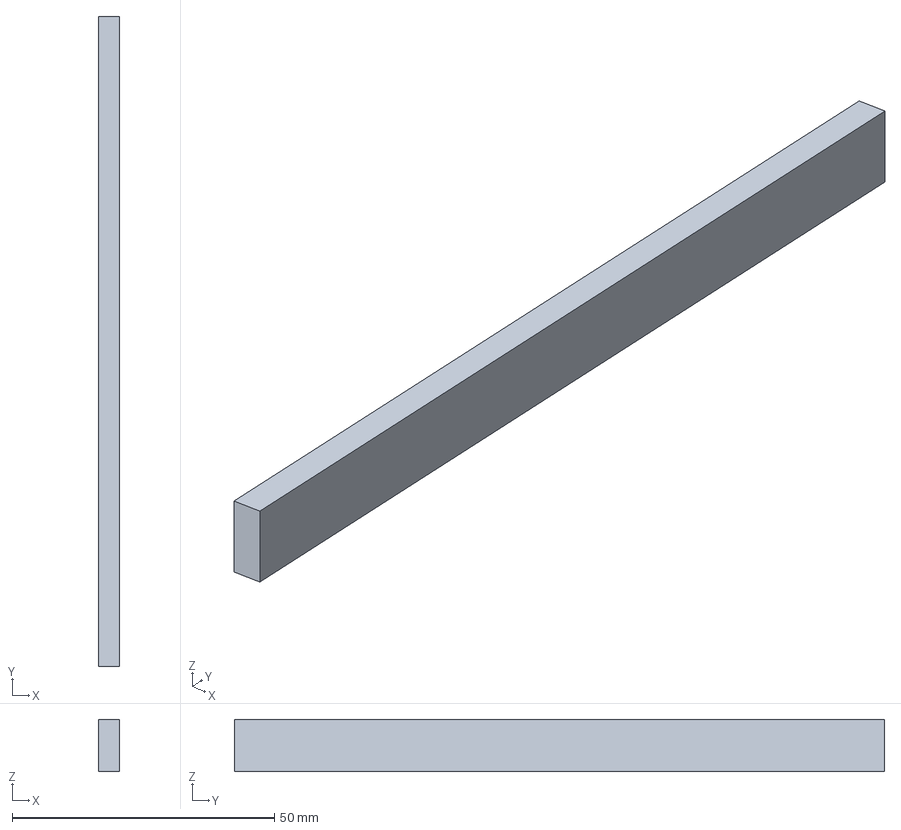
[picture p55: CAD file, 2026-09-30]
UGV-01/cad/assembly/generated/REF-LIGHT-BAR.step
4.00 x 124.0 x 10.0 mm
