efekrkyn/UGV-01/UGV-01/cad/assembly/generated/UGV-MECH-066-+1.step

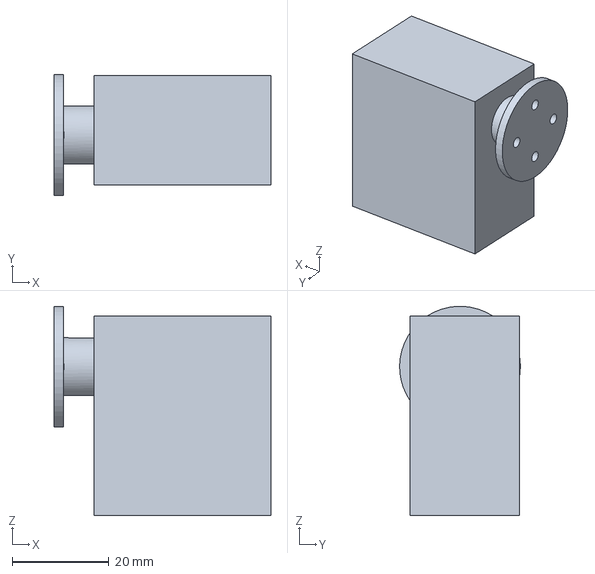
[picture p56: CAD file, 2026-09-30]
UGV-01/cad/assembly/generated/UGV-MECH-066-+1.step
44.9 x 25.0 x 43.3 mm
