efekrkyn/UGV-01/UGV-01/cad/assembly/generated/UGV-MECH-031.step

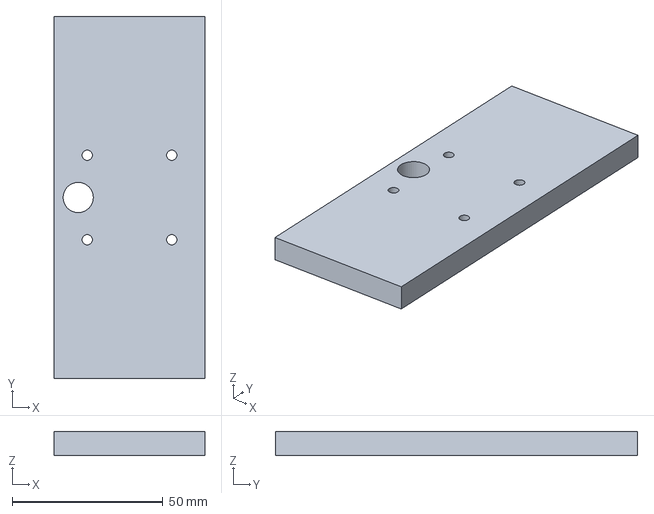
[picture p57: CAD file, 2026-09-30]
UGV-01/cad/assembly/generated/UGV-MECH-031.step
50.0 x 120.0 x 8.00 mm
