efekrkyn/UGV-01/UGV-01/cad/assembly/generated/UGV-MECH-044-+1.step

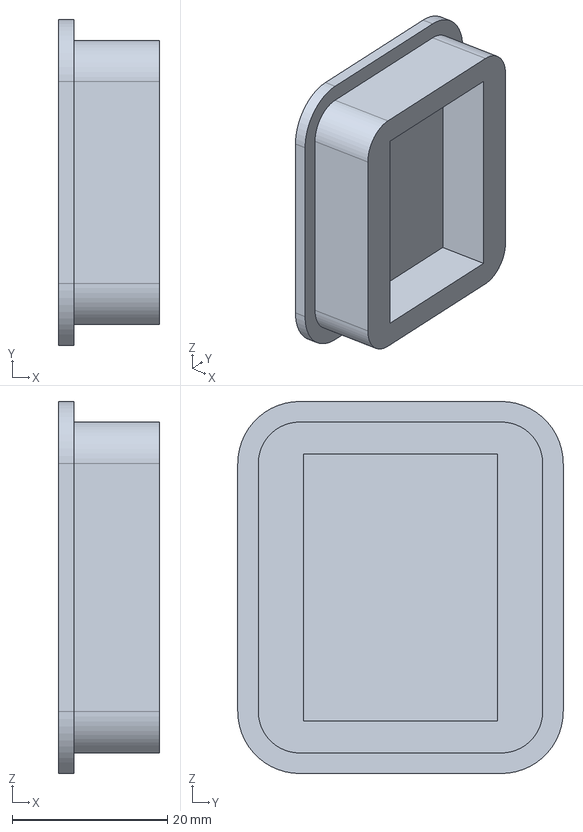
[picture p58: CAD file, 2026-09-30]
UGV-01/cad/assembly/generated/UGV-MECH-044-+1.step
13.0 x 42.0 x 48.0 mm
