efekrkyn/UGV-01/UGV-01/cad/assembly/generated/UGV-MECH-042.step

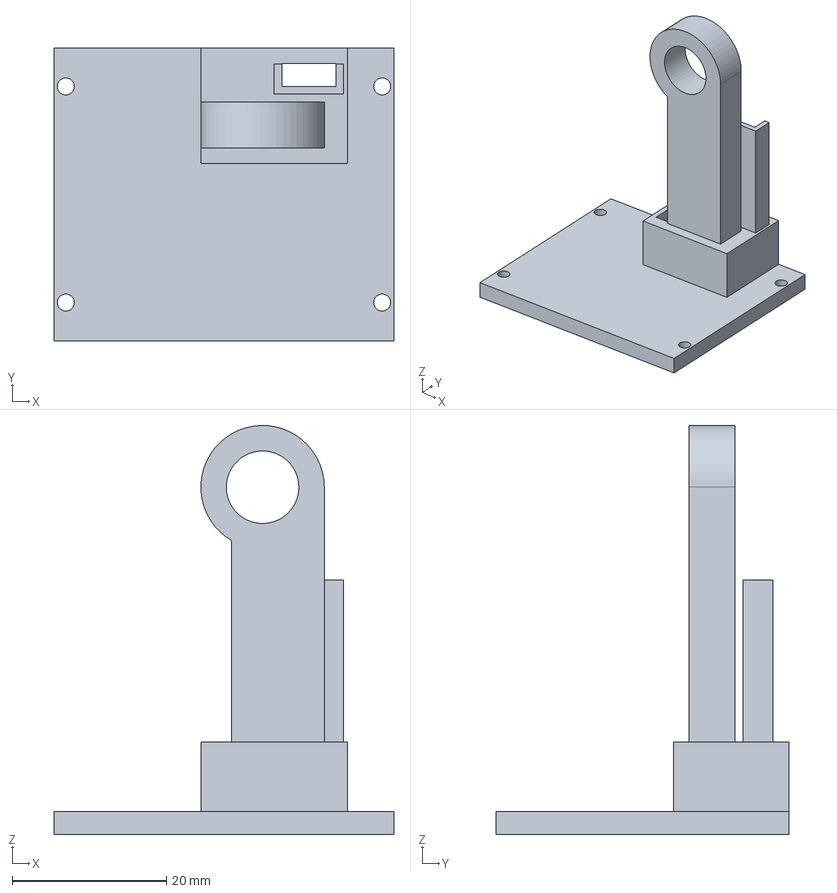
[picture p59: CAD file, 2026-09-30]
UGV-01/cad/assembly/generated/UGV-MECH-042.step
44.0 x 38.0 x 53.0 mm
