efekrkyn/UGV-01/UGV-01/cad/assembly/generated/REF-TOF-+1.step

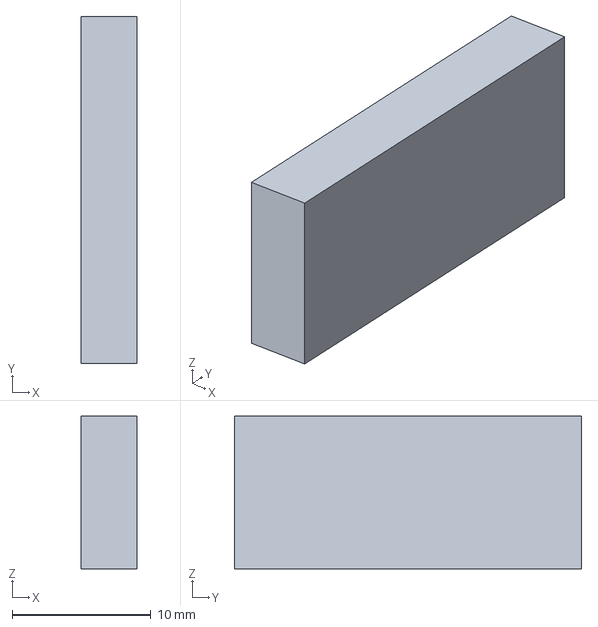
[picture p60: CAD file, 2026-09-30]
UGV-01/cad/assembly/generated/REF-TOF-+1.step
4.00 x 25.0 x 11.0 mm
