efekrkyn/UGV-01/UGV-01/cad/assembly/generated/UGV-MECH-051-+1.step

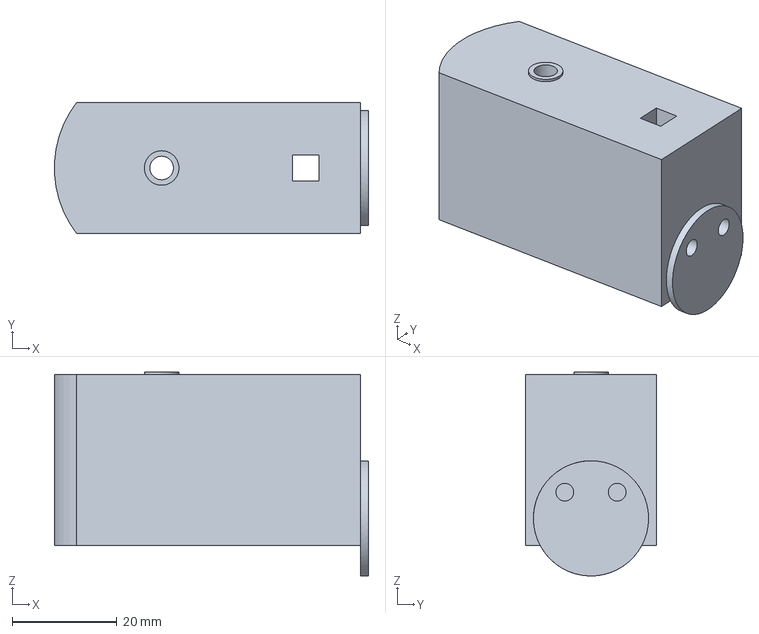
[picture p61: CAD file, 2026-09-30]
UGV-01/cad/assembly/generated/UGV-MECH-051-+1.step
60.0 x 25.0 x 38.9 mm
