efekrkyn/UGV-01/UGV-01/cad/assembly/generated/UGV-MECH-060-RL.step

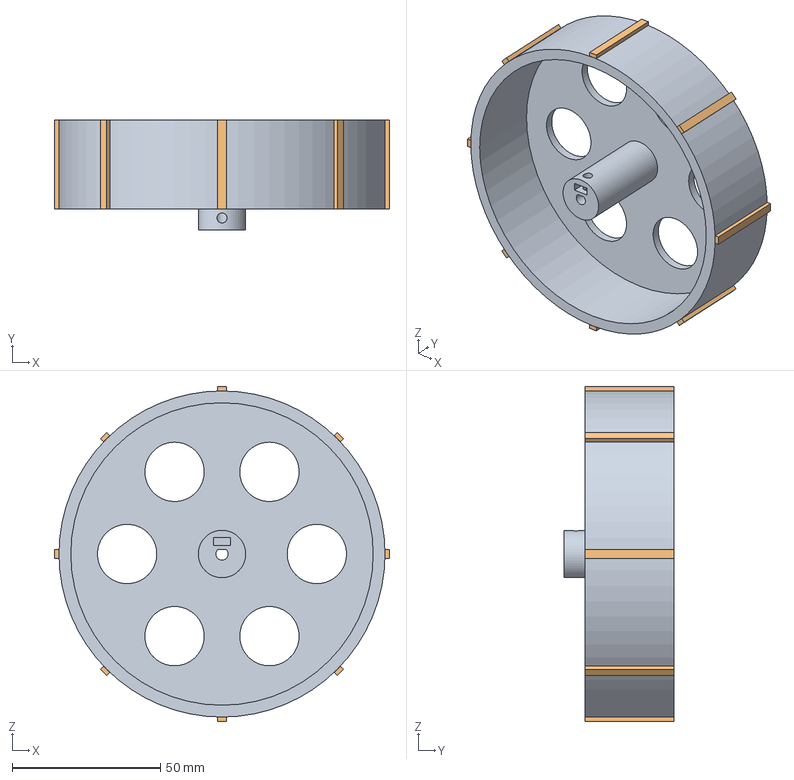
[picture p62: CAD file, 2026-09-30]
UGV-01/cad/assembly/generated/UGV-MECH-060-RL.step
113.0 x 37.0 x 113.0 mm
