efekrkyn/UGV-01/UGV-01/cad/assembly/generated/UGV-MECH-015-FR.step

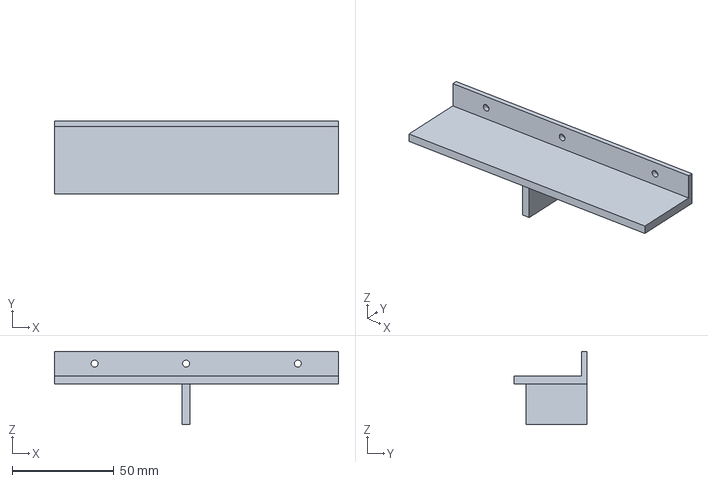
[picture p63: CAD file, 2026-09-30]
UGV-01/cad/assembly/generated/UGV-MECH-015-FR.step
139.8 x 35.8 x 36.0 mm
