efekrkyn/UGV-01/UGV-01/cad/assembly/generated/REF-SERVO-TWIST-R.step

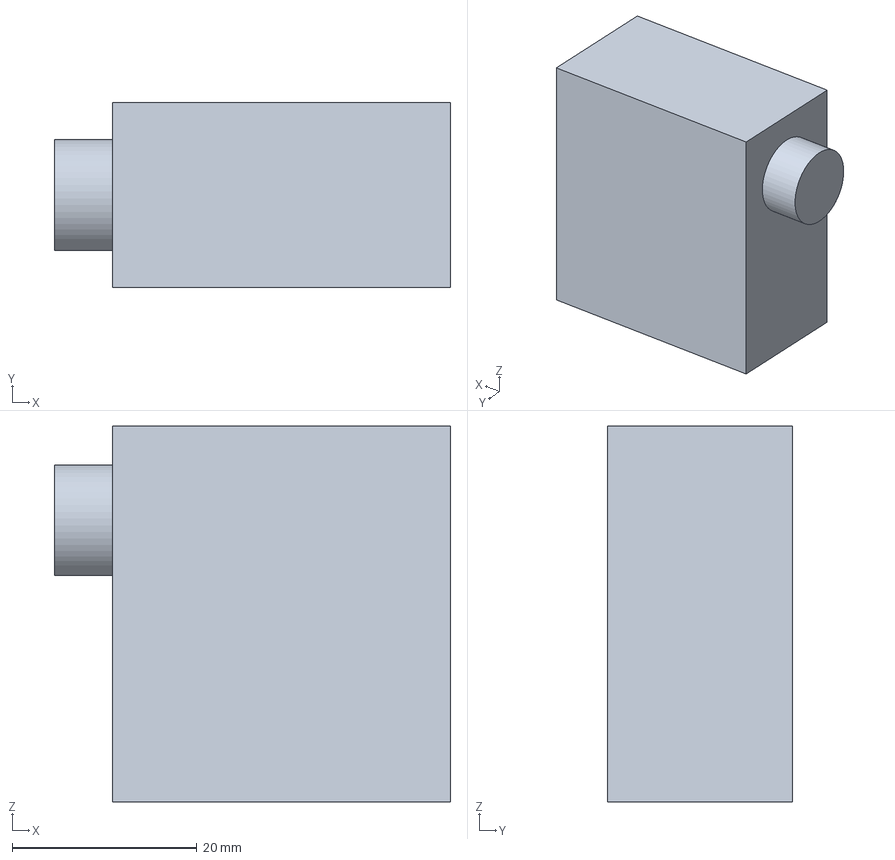
[picture p64: CAD file, 2026-09-30]
UGV-01/cad/assembly/generated/REF-SERVO-TWIST-R.step
42.9 x 20.0 x 40.7 mm
