efekrkyn/UGV-01/UGV-01/cad/assembly/generated/UGV-MECH-071.step

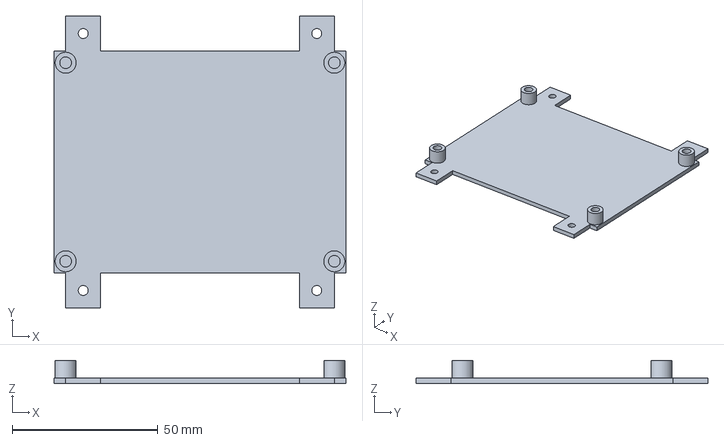
[picture p65: CAD file, 2026-09-30]
UGV-01/cad/assembly/generated/UGV-MECH-071.step
100.0 x 100.0 x 8.00 mm
