efekrkyn/UGV-01/UGV-01/cad/assembly/generated/REF-ESTOP.step

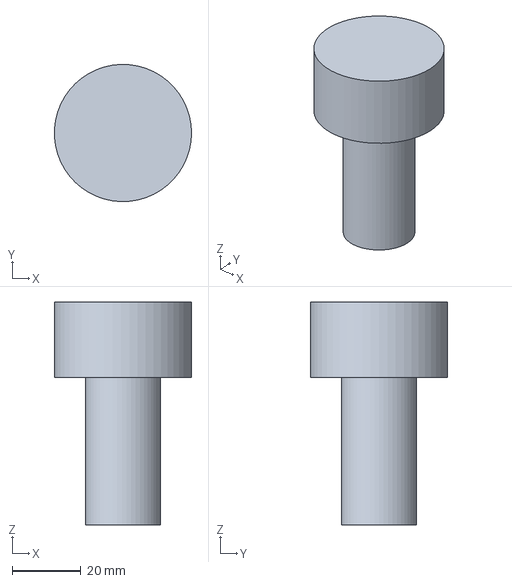
[picture p66: CAD file, 2026-09-30]
UGV-01/cad/assembly/generated/REF-ESTOP.step
40.0 x 40.0 x 65.0 mm
