efekrkyn/UGV-01/UGV-01/cad/assembly/generated/UGV-MECH-012-+1.step

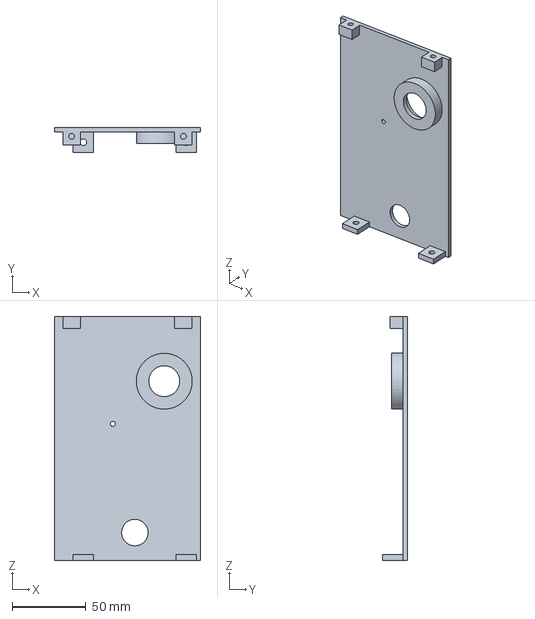
[picture p67: CAD file, 2026-09-30]
UGV-01/cad/assembly/generated/UGV-MECH-012-+1.step
99.5 x 17.0 x 166.0 mm
