efekrkyn/UGV-01/UGV-01/cad/assembly/generated/UGV-MECH-013-3.step

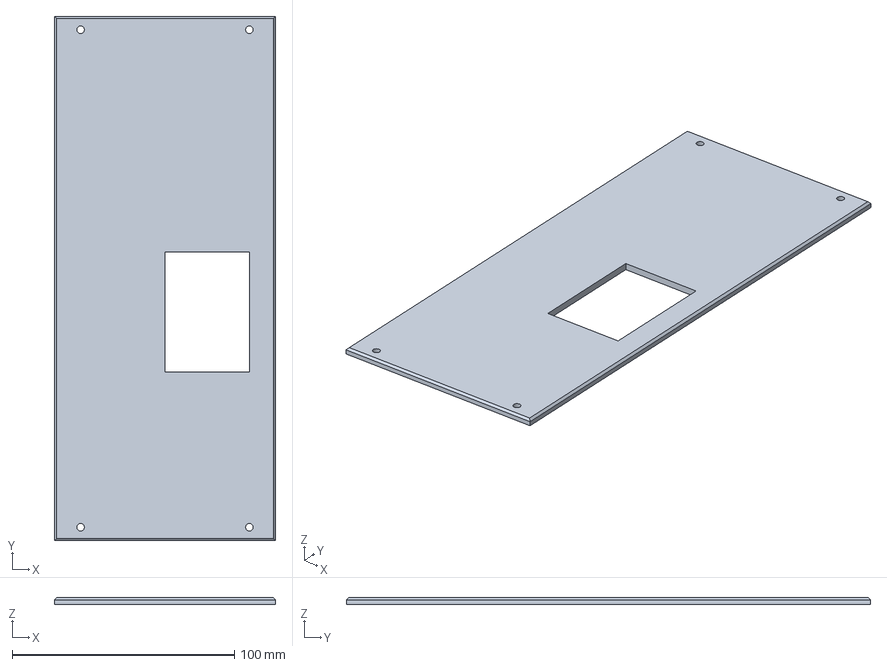
[picture p68: CAD file, 2026-09-30]
UGV-01/cad/assembly/generated/UGV-MECH-013-3.step
99.5 x 236.0 x 3.00 mm
