efekrkyn/UGV-01/UGV-01/cad/assembly/generated/UGV-MECH-072.step

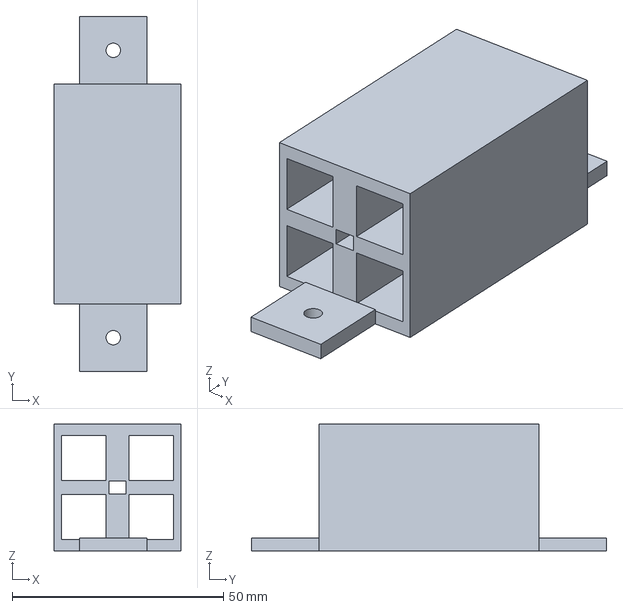
[picture p69: CAD file, 2026-09-30]
UGV-01/cad/assembly/generated/UGV-MECH-072.step
30.0 x 84.0 x 30.0 mm
