efekrkyn/UGV-01/UGV-01/cad/assembly/generated/REF-ELECTRONICS.step

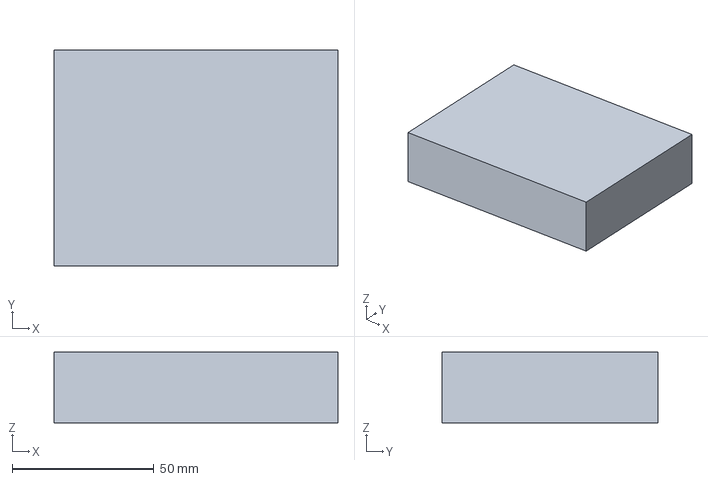
[picture p70: CAD file, 2026-09-30]
UGV-01/cad/assembly/generated/REF-ELECTRONICS.step
100.0 x 76.0 x 25.0 mm
