efekrkyn/UGV-01/UGV-01/cad/assembly/generated/UGV-MECH-017-+1.step

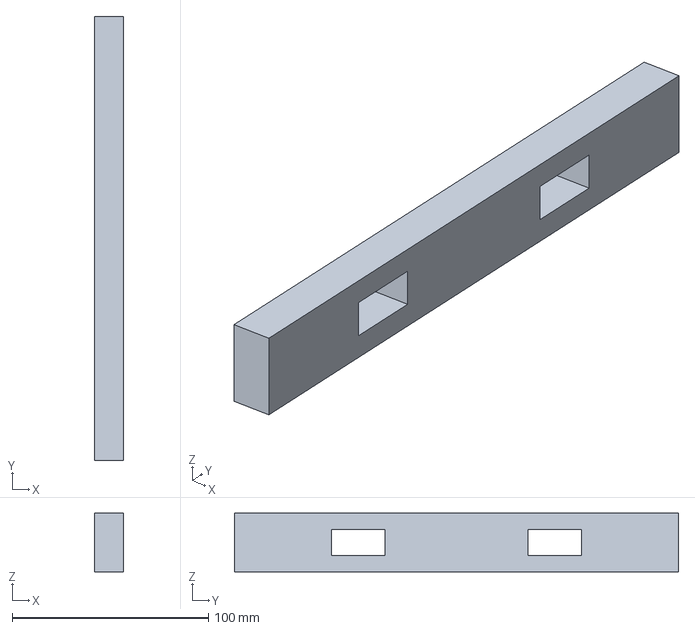
[picture p71: CAD file, 2026-09-30]
UGV-01/cad/assembly/generated/UGV-MECH-017-+1.step
15.0 x 226.0 x 30.0 mm
