efekrkyn/UGV-01/UGV-01/cad/assembly/generated/UGV-MECH-043-+1.step

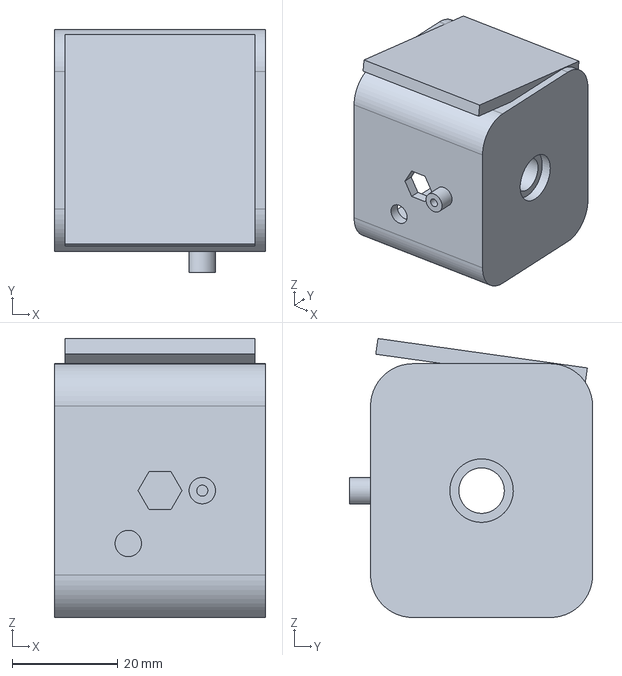
[picture p72: CAD file, 2026-09-30]
UGV-01/cad/assembly/generated/UGV-MECH-043-+1.step
40.0 x 46.0 x 52.8 mm
