efekrkyn/UGV-01/UGV-01/cad/assembly/generated/UGV-MECH-045.step

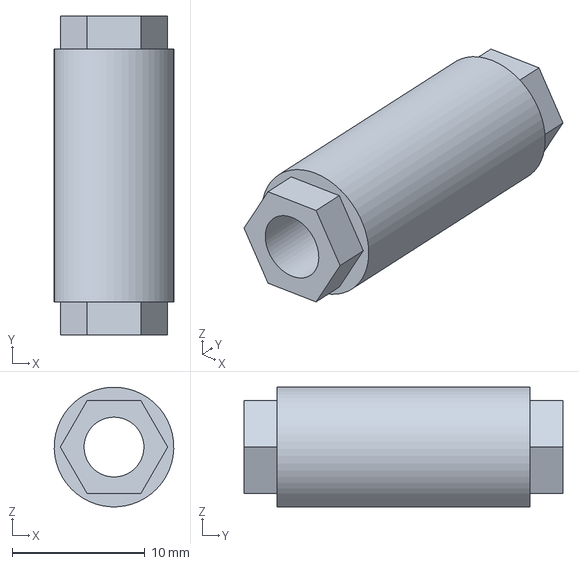
[picture p73: CAD file, 2026-09-30]
UGV-01/cad/assembly/generated/UGV-MECH-045.step
9.00 x 24.0 x 8.99 mm
