efekrkyn/UGV-01/UGV-01/cad/assembly/generated/UGV-MECH-070.step

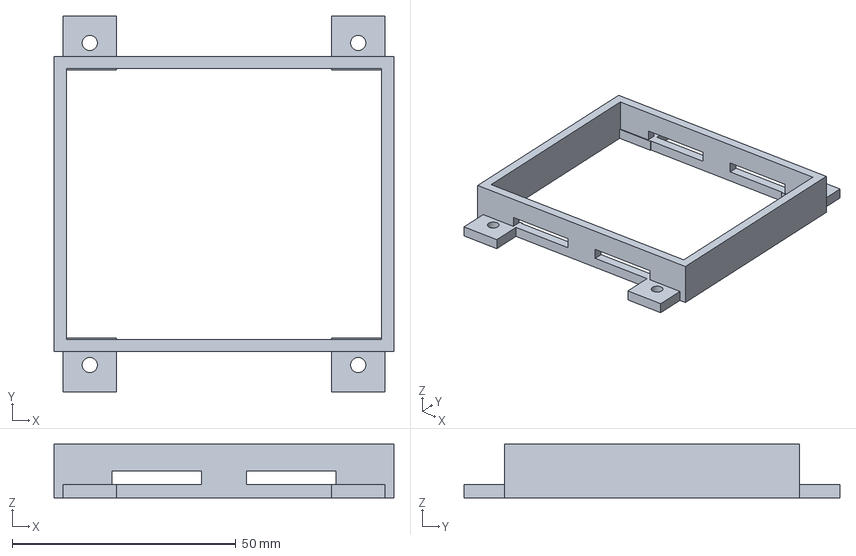
[picture p74: CAD file, 2026-09-30]
UGV-01/cad/assembly/generated/UGV-MECH-070.step
76.0 x 84.0 x 12.0 mm
