efekrkyn/UGV-01/UGV-01/cad/assembly/generated/REF-BEARING-SHOULDER-+1.step

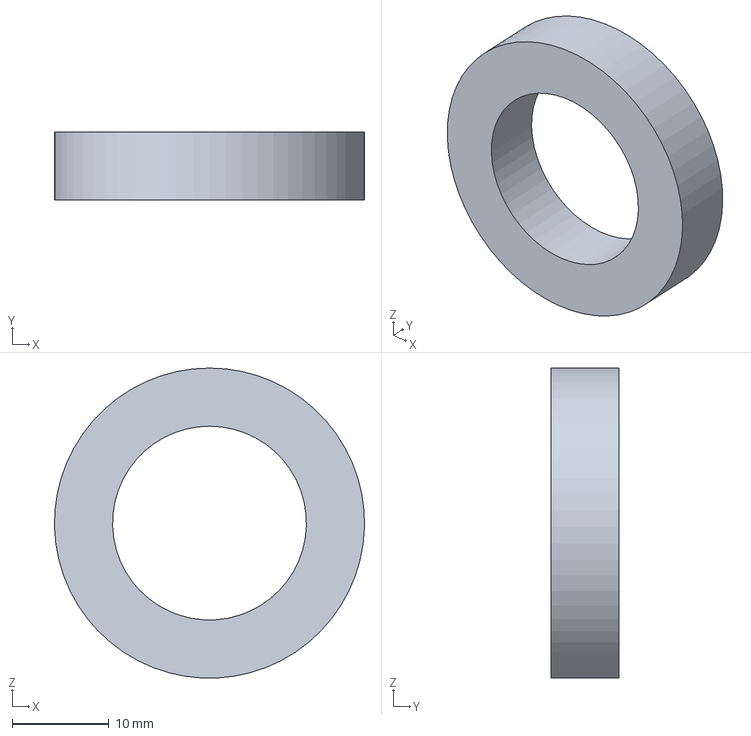
[picture p75: CAD file, 2026-09-30]
UGV-01/cad/assembly/generated/REF-BEARING-SHOULDER-+1.step
32.0 x 7.00 x 32.0 mm
