efekrkyn/UGV-01/UGV-01/cad/assembly/generated/UGV-MECH-001-F.step

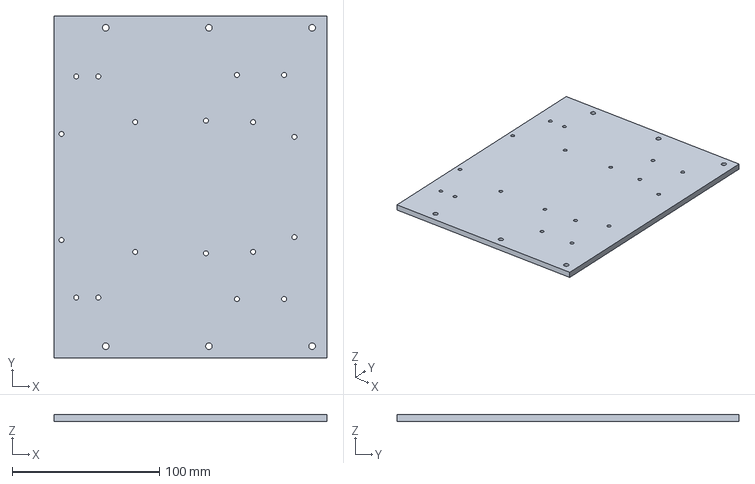
[picture p76: CAD file, 2026-09-30]
UGV-01/cad/assembly/generated/UGV-MECH-001-F.step
185.0 x 232.0 x 5.00 mm
