efekrkyn/UGV-01/UGV-01/cad/assembly/generated/UGV-MECH-068-+1.step

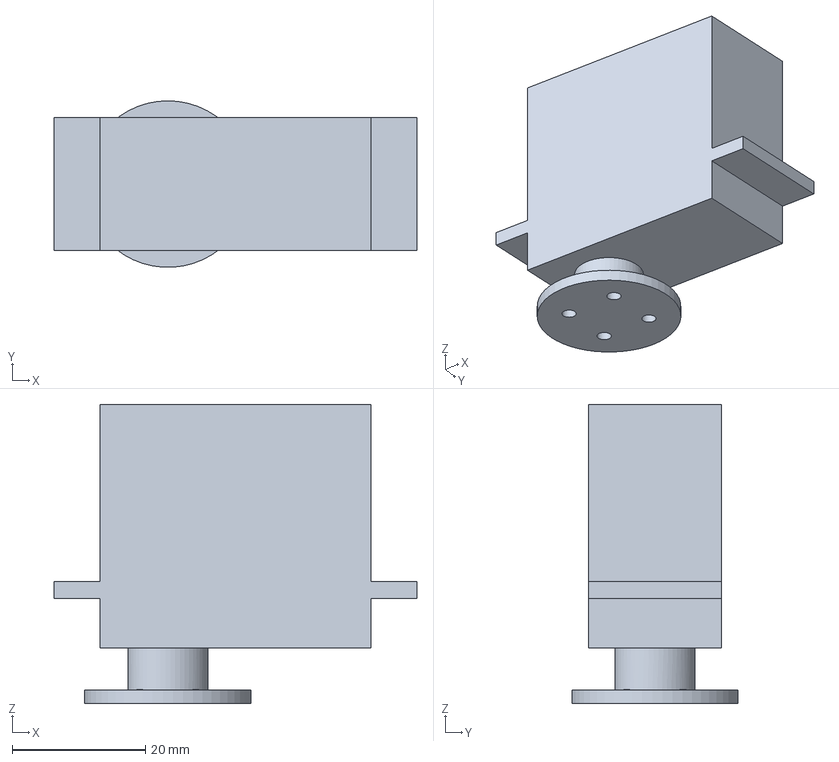
[picture p77: CAD file, 2026-09-30]
UGV-01/cad/assembly/generated/UGV-MECH-068-+1.step
54.5 x 25.0 x 44.9 mm
