efekrkyn/UGV-01/UGV-01/cad/assembly/generated/REF-TILT-ROD.step

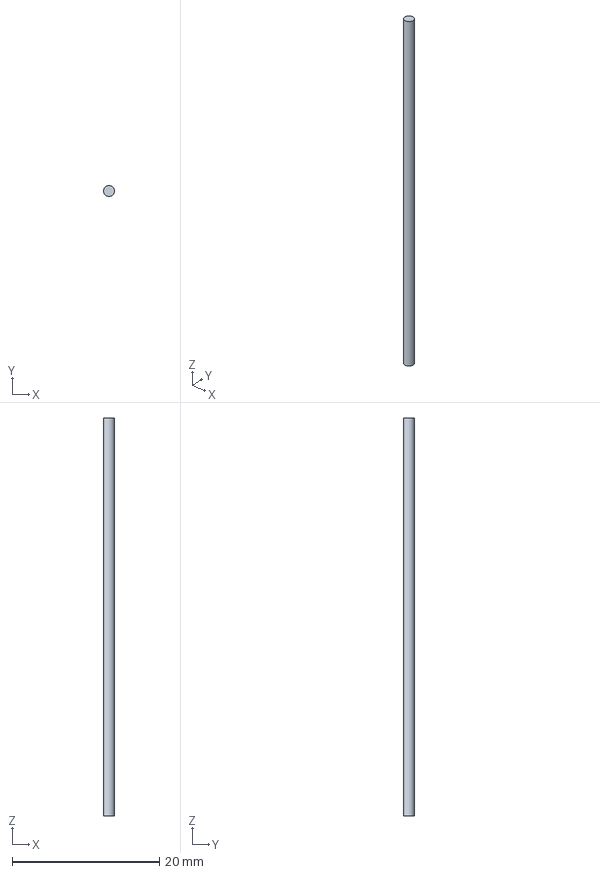
[picture p78: CAD file, 2026-09-30]
UGV-01/cad/assembly/generated/REF-TILT-ROD.step
1.50 x 1.50 x 54.0 mm
