efekrkyn/UGV-01/UGV-01/cad/assembly/generated/REF-EYE-CAMERA-+1.step

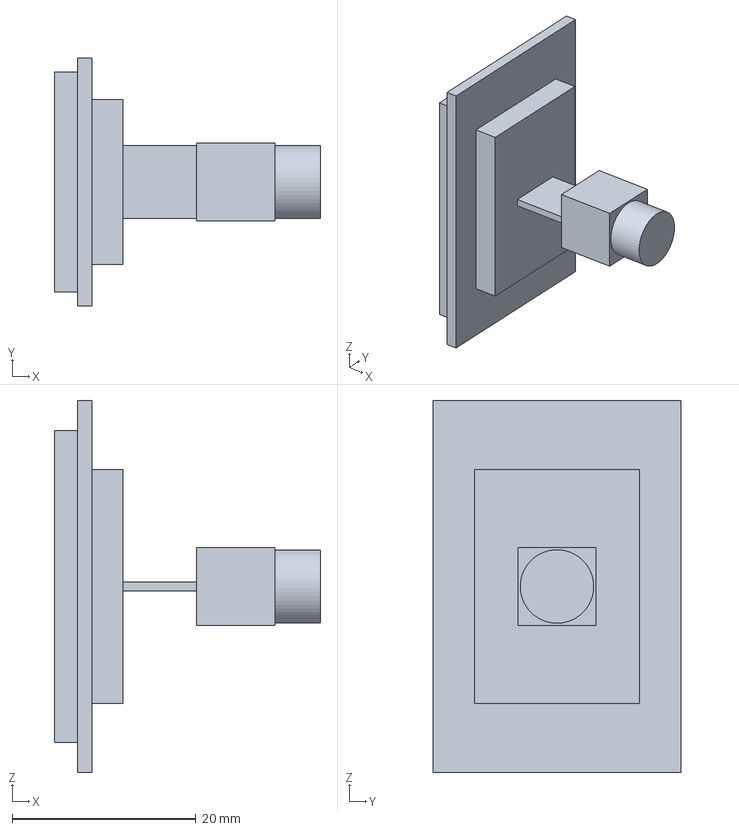
[picture p79: CAD file, 2026-09-30]
UGV-01/cad/assembly/generated/REF-EYE-CAMERA-+1.step
29.0 x 27.0 x 40.5 mm
