efekrkyn/UGV-01/UGV-01/cad/assembly/generated/UGV-MECH-055-+1.step

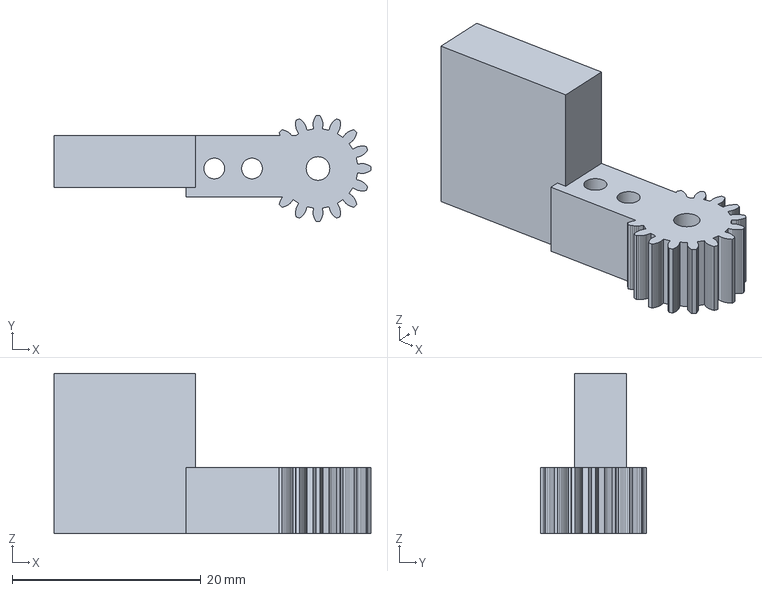
[picture p80: CAD file, 2026-09-30]
UGV-01/cad/assembly/generated/UGV-MECH-055-+1.step
33.6 x 11.2 x 17.0 mm
