efekrkyn/UGV-01/UGV-01/cad/assembly/generated/UGV-MECH-054-+1.step

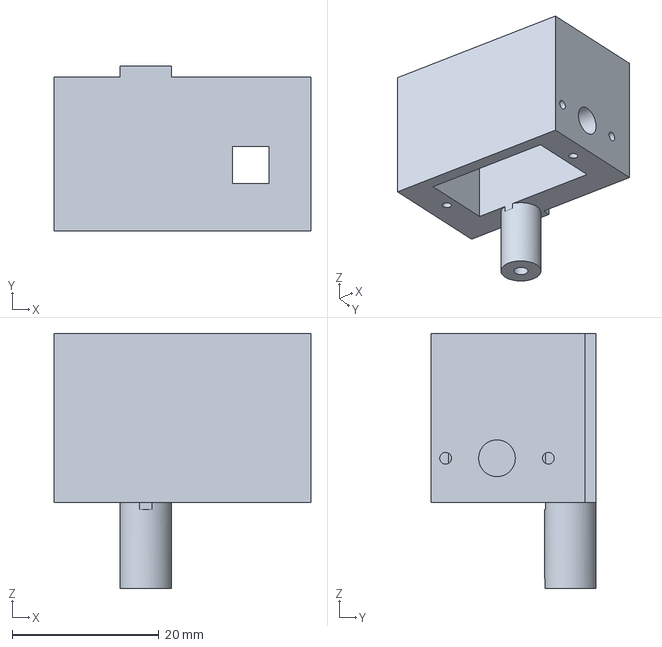
[picture p81: CAD file, 2026-09-30]
UGV-01/cad/assembly/generated/UGV-MECH-054-+1.step
35.0 x 22.5 x 34.8 mm
