efekrkyn/UGV-01/UGV-01/cad/assembly/generated/UGV-MECH-050-+1.step

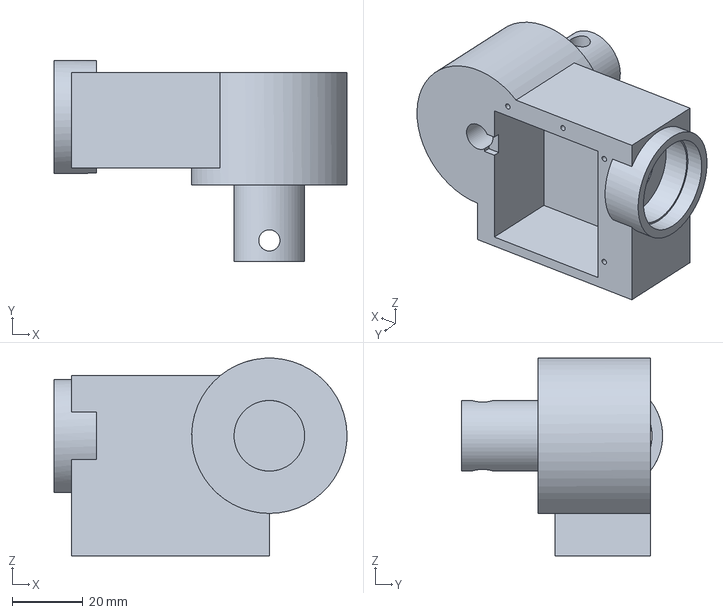
[picture p82: CAD file, 2026-09-30]
UGV-01/cad/assembly/generated/UGV-MECH-050-+1.step
83.0 x 57.0 x 56.0 mm
