efekrkyn/UGV-01/UGV-01/cad/assembly/generated/UGV-MECH-065-+1.step

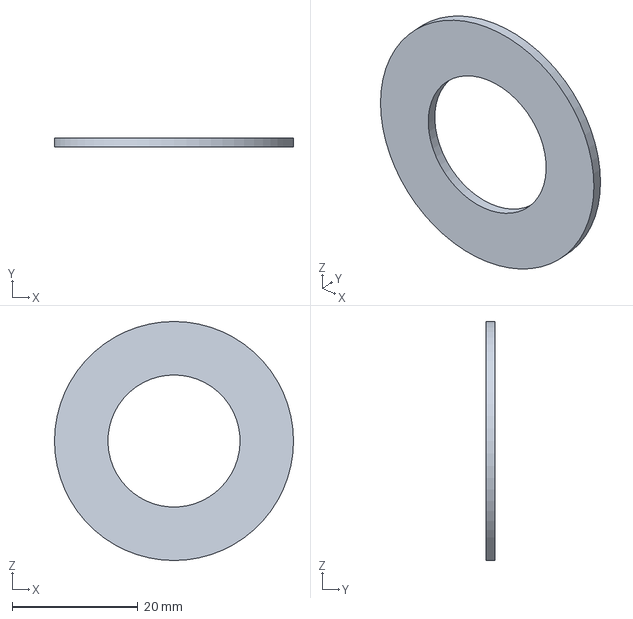
[picture p83: CAD file, 2026-09-30]
UGV-01/cad/assembly/generated/UGV-MECH-065-+1.step
38.0 x 1.50 x 38.0 mm
