efekrkyn/UGV-01/UGV-01/cad/assembly/generated/UGV-MECH-030.step

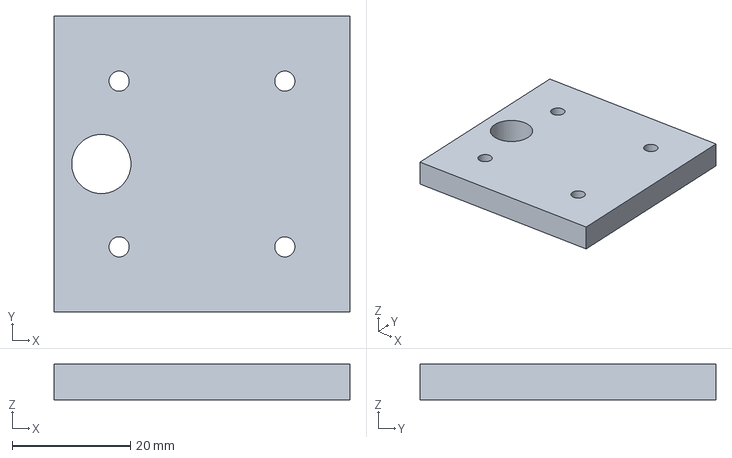
[picture p84: CAD file, 2026-09-30]
UGV-01/cad/assembly/generated/UGV-MECH-030.step
50.0 x 50.0 x 6.00 mm
