efekrkyn/UGV-01/UGV-01/cad/assembly/generated/UGV-MECH-056--1.step

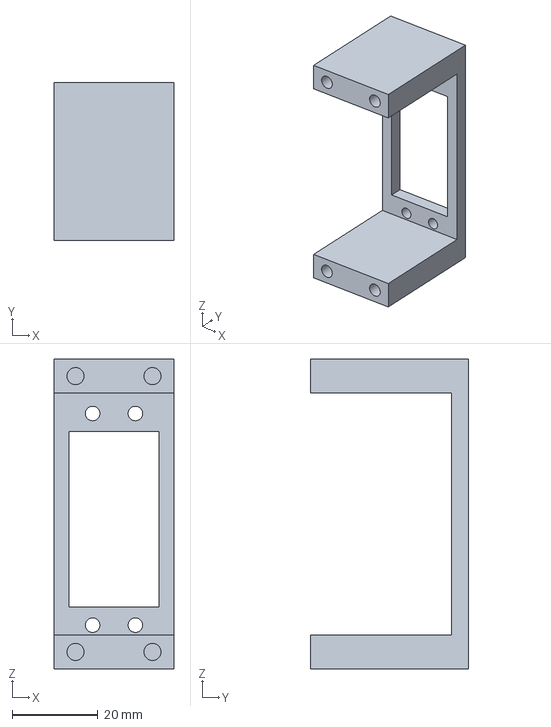
[picture p85: CAD file, 2026-09-30]
UGV-01/cad/assembly/generated/UGV-MECH-056--1.step
28.0 x 37.0 x 72.5 mm
