efekrkyn/UGV-01/UGV-01/cad/assembly/generated/REF-SPACER-JAWB-L.step

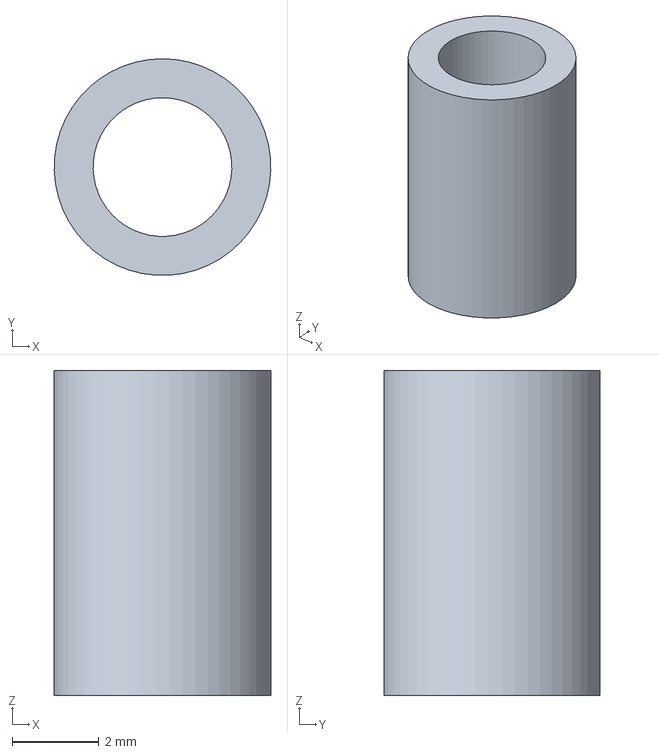
[picture p86: CAD file, 2026-09-30]
UGV-01/cad/assembly/generated/REF-SPACER-JAWB-L.step
5.00 x 5.00 x 7.50 mm
