efekrkyn/UGV-01/UGV-01/cad/assembly/generated/UGV-MECH-040.step

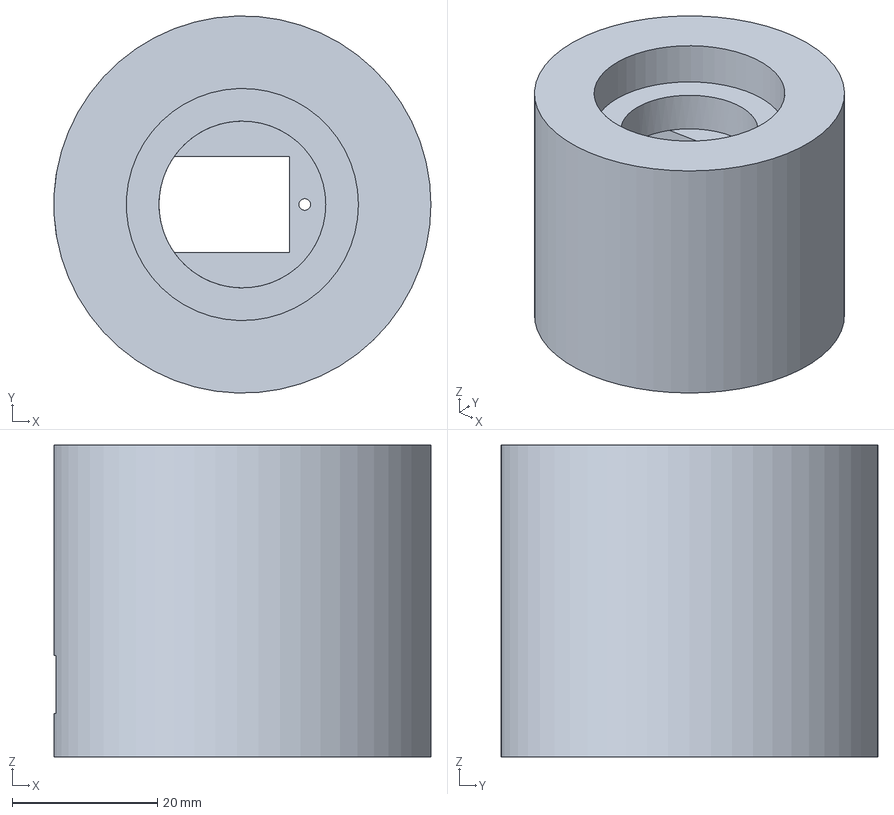
[picture p87: CAD file, 2026-09-30]
UGV-01/cad/assembly/generated/UGV-MECH-040.step
52.0 x 52.0 x 43.0 mm
