efekrkyn/UGV-01/UGV-01/cad/assembly/generated/UGV-MECH-058-+1.step

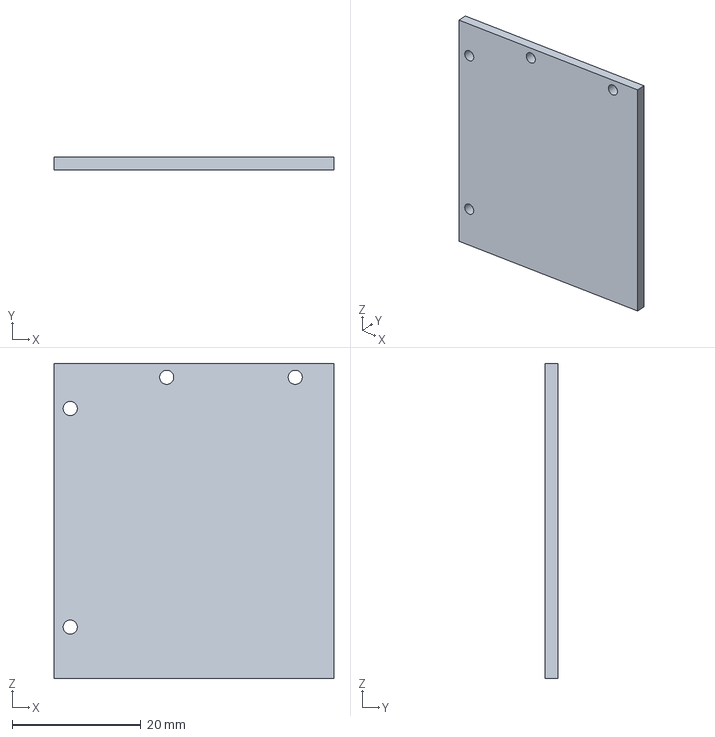
[picture p88: CAD file, 2026-09-30]
UGV-01/cad/assembly/generated/UGV-MECH-058-+1.step
43.5 x 2.00 x 49.0 mm
