efekrkyn/UGV-01/UGV-01/cad/assembly/generated/UGV-MECH-022-+1.step

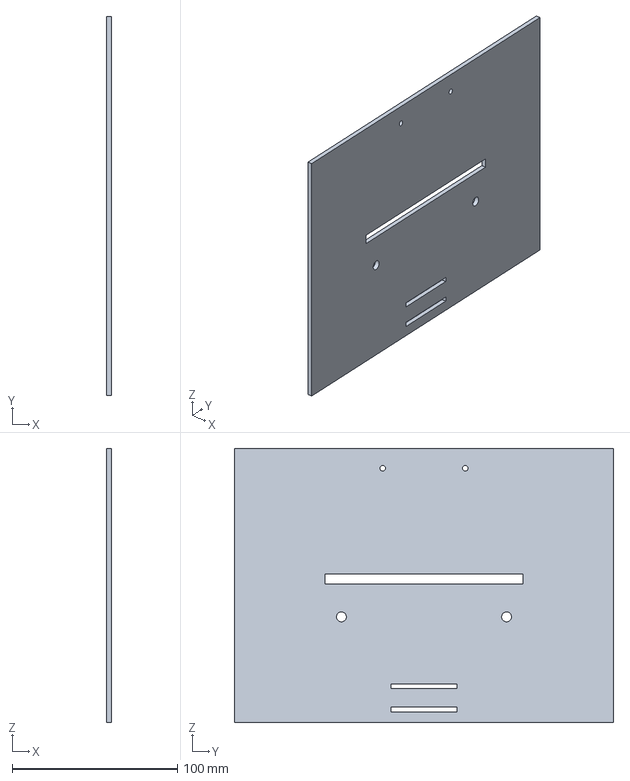
[picture p89: CAD file, 2026-09-30]
UGV-01/cad/assembly/generated/UGV-MECH-022-+1.step
3.00 x 229.5 x 166.0 mm
