efekrkyn/UGV-01/UGV-01/cad/assembly/generated/REF-BATTERY.step

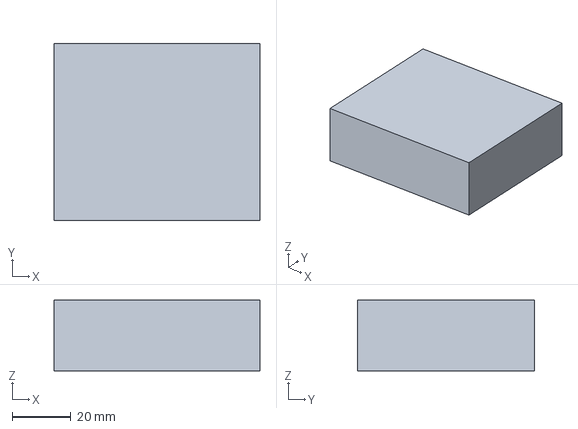
[picture p90: CAD file, 2026-09-30]
UGV-01/cad/assembly/generated/REF-BATTERY.step
70.0 x 60.0 x 24.0 mm
