efekrkyn/UGV-01/UGV-01/cad/assembly/generated/UGV-01-A3-concept.step

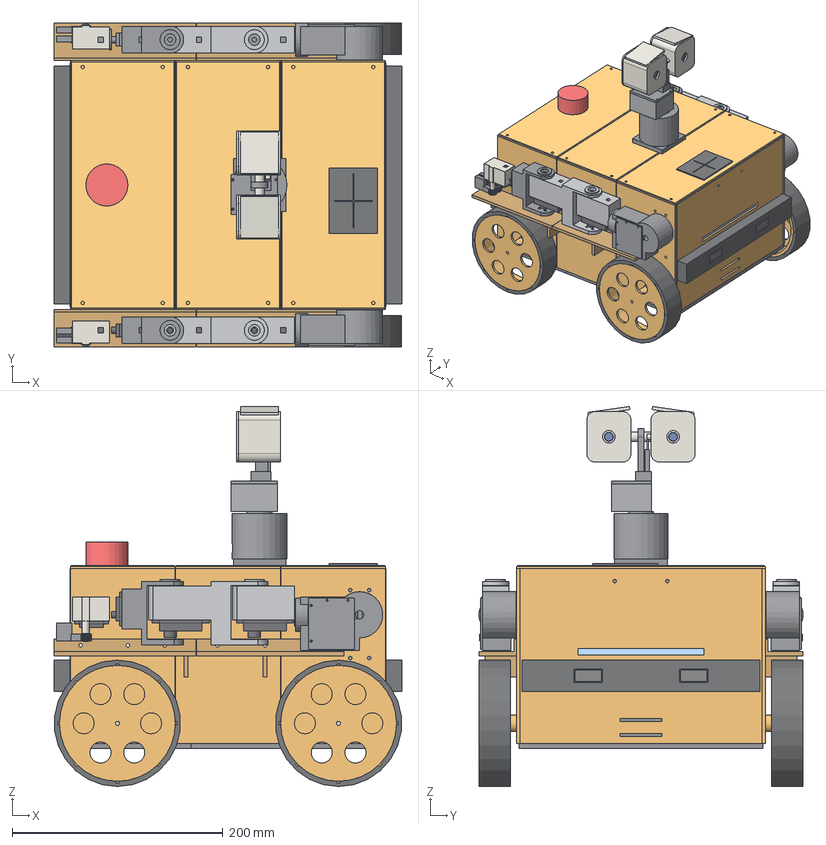
[picture p91: CAD file, 2026-09-30]
UGV-01/cad/assembly/generated/UGV-01-A3-concept.step
330.0 x 308.0 x 360.8 mm
UGV-MECH-001-R
UGV-MECH-001-F
UGV-MECH-002--1
UGV-MECH-002-+1
UGV-MECH-010--1
UGV-MECH-010-+1
UGV-MECH-013-1
UGV-MECH-011--1
UGV-MECH-011-+1
UGV-MECH-013-2
UGV-MECH-012--1
UGV-MECH-012-+1
UGV-MECH-013-3
UGV-MECH-022--1
UGV-MECH-017--1
UGV-MECH-022-+1
UGV-MECH-017-+1
REF-MOTOR-RR
UGV-MECH-003-RR
UGV-MECH-004-RR
UGV-MECH-060-RR
UGV-MECH-061-RR
UGV-MECH-015-RR
REF-MOTOR-RL
UGV-MECH-003-RL
UGV-MECH-004-RL
UGV-MECH-060-RL
UGV-MECH-061-RL
UGV-MECH-015-RL
REF-MOTOR-FR
UGV-MECH-003-FR
UGV-MECH-004-FR
UGV-MECH-060-FR
UGV-MECH-061-FR
UGV-MECH-015-FR
REF-MOTOR-FL
UGV-MECH-003-FL
UGV-MECH-004-FL
UGV-MECH-060-FL
UGV-MECH-061-FL
UGV-MECH-015-FL
REF-BATTERY
REF-ELECTRONICS
UGV-MECH-070
UGV-MECH-071
REF-BALLAST-1
REF-BALLAST-2
REF-BALLAST-3
REF-BALLAST-4
UGV-MECH-072
UGV-MECH-073
UGV-MECH-018
REF-ESTOP
REF-TOF--1
REF-TOF-+1
UGV-MECH-030
UGV-MECH-031
REF-LIGHT-BAR
UGV-MECH-040
REF-SERVO-PAN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
