efekrkyn/UGV-01/UGV-01/cad/assembly/generated/UGV-MECH-074-+1.step

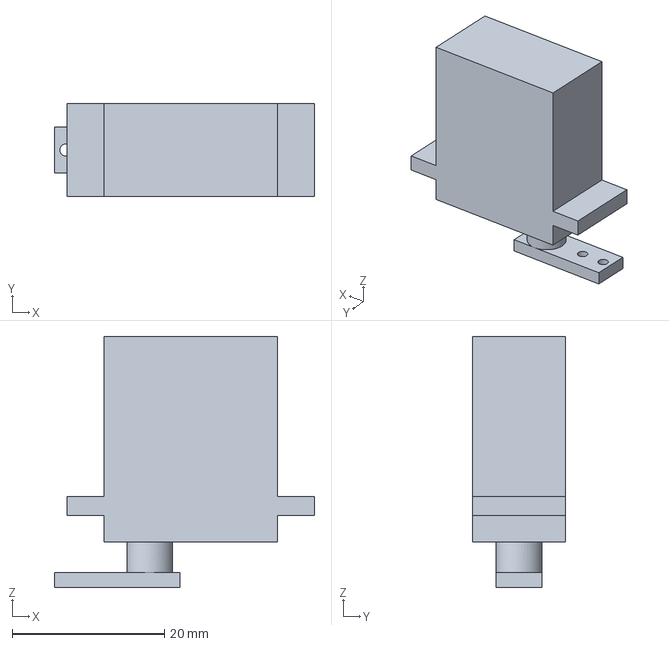
[picture p92: CAD file, 2026-09-30]
UGV-01/cad/assembly/generated/UGV-MECH-074-+1.step
34.2 x 12.2 x 33.0 mm
