efekrkyn/UGV-01/(list of files, cad)

Other CAD files:
UGV-01/cad/assembly/generated/UGV-MECH-003-FL.step
UGV-01/cad/drivetrain/generated/REF-6000-2RSH-2.step
UGV-01/cad/drivetrain/generated/UGV-MECH-042.step
UGV-01/cad/assembly/generated/UGV-MECH-003-FR.step
UGV-01/cad/assembly/generated/REF-SERVO-ROLL-R.step
UGV-01/cad/assembly/generated/UGV-MECH-015-RR.step
UGV-01/cad/assembly/generated/UGV-MECH-076-+1.step
UGV-01/cad/assembly/generated/REF-BALLAST-4.step
UGV-01/cad/assembly/generated/REF-MOTOR-RR.step
UGV-01/cad/assembly/generated/REF-BALLAST-2.step
UGV-01/cad/assembly/generated/REF-SERVO-TILT.step
UGV-01/cad/assembly/generated/UGV-MECH-004-FL.step
UGV-01/cad/assembly/generated/UGV-MECH-003-RL.step
UGV-01/cad/assembly/generated/REF-SERVO-WRIST-R.step
UGV-01/cad/assembly/generated/REF-BALLAST-3.step
UGV-01/cad/assembly/generated/UGV-MECH-061-FL.step
UGV-01/cad/assembly/generated/UGV-MECH-015-FL.step
UGV-01/cad/assembly/generated/REF-SERVO-GRIPPER-R.step
UGV-01/cad/assembly/generated/UGV-MECH-061-RL.step
UGV-01/cad/assembly/generated/UGV-MECH-060-FR.step
UGV-01/cad/assembly/generated/UGV-MECH-061-RR.step
UGV-01/cad/assembly/generated/UGV-MECH-060-RR.step
UGV-01/cad/assembly/generated/UGV-MECH-004-RR.step
UGV-01/cad/assembly/generated/REF-MOTOR-FR.step
UGV-01/cad/assembly/generated/UGV-MECH-067-+1.step
UGV-01/cad/assembly/generated/UGV-MECH-064--1.step
UGV-01/cad/assembly/generated/REF-BEARING-PAN.step
UGV-01/cad/assembly/generated/REF-MOTOR-RL.step
UGV-01/cad/assembly/generated/REF-BEARING-TWIST-R.step
UGV-01/cad/assembly/generated/UGV-MECH-004-FR.step
UGV-01/cad/assembly/generated/UGV-MECH-011-+1.step
UGV-01/cad/assembly/generated/UGV-MECH-060-FL.step
UGV-01/cad/assembly/generated/REF-SPACER-JAWB-R.step
UGV-01/cad/assembly/generated/REF-BEARING-SHOULDER--1.step
UGV-01/cad/assembly/generated/REF-EYE-CAMERA--1.step
UGV-01/cad/assembly/generated/REF-TOF--1.step
UGV-01/cad/assembly/generated/UGV-MECH-001-F.stl
UGV-01/cad/assembly/generated/UGV-MECH-001-R.stl
UGV-01/cad/assembly/generated/UGV-MECH-002-+1.stl
UGV-01/cad/assembly/generated/UGV-MECH-002--1.step
UGV-01/cad/assembly/generated/UGV-MECH-002--1.stl
UGV-01/cad/assembly/generated/UGV-MECH-003-FL.stl
UGV-01/cad/assembly/generated/UGV-MECH-003-FR.stl
UGV-01/cad/assembly/generated/UGV-MECH-003-RL.stl
UGV-01/cad/assembly/generated/UGV-MECH-003-RR.stl
UGV-01/cad/assembly/generated/UGV-MECH-004-FL.stl
UGV-01/cad/assembly/generated/UGV-MECH-004-FR.stl
UGV-01/cad/assembly/generated/UGV-MECH-004-RL.stl
UGV-01/cad/assembly/generated/UGV-MECH-004-RR.stl
UGV-01/cad/assembly/generated/UGV-MECH-010-+1.stl
UGV-01/cad/assembly/generated/UGV-MECH-010--1.step
UGV-01/cad/assembly/generated/UGV-MECH-010--1.stl
UGV-01/cad/assembly/generated/UGV-MECH-011-+1.stl
UGV-01/cad/assembly/generated/UGV-MECH-011--1.step
UGV-01/cad/assembly/generated/UGV-MECH-011--1.stl
UGV-01/cad/assembly/generated/UGV-MECH-012-+1.stl
UGV-01/cad/assembly/generated/UGV-MECH-012--1.step
UGV-01/cad/assembly/generated/UGV-MECH-012--1.stl
UGV-01/cad/assembly/generated/UGV-MECH-013-1.stl
UGV-01/cad/assembly/generated/UGV-MECH-013-2.stl
UGV-01/cad/assembly/generated/UGV-MECH-013-3.stl
UGV-01/cad/assembly/generated/UGV-MECH-015-FL.stl
UGV-01/cad/assembly/generated/UGV-MECH-015-FR.stl
UGV-01/cad/assembly/generated/UGV-MECH-015-RL.stl
UGV-01/cad/assembly/generated/UGV-MECH-015-RR.stl
UGV-01/cad/assembly/generated/UGV-MECH-017-+1.stl
UGV-01/cad/assembly/generated/UGV-MECH-017--1.step
UGV-01/cad/assembly/generated/UGV-MECH-017--1.stl
UGV-01/cad/assembly/generated/UGV-MECH-018.stl
UGV-01/cad/assembly/generated/UGV-MECH-022-+1.stl
UGV-01/cad/assembly/generated/UGV-MECH-022--1.step
UGV-01/cad/assembly/generated/UGV-MECH-022--1.stl
UGV-01/cad/assembly/generated/UGV-MECH-030.stl
UGV-01/cad/assembly/generated/UGV-MECH-031.stl
UGV-01/cad/assembly/generated/UGV-MECH-040.stl
UGV-01/cad/assembly/generated/UGV-MECH-041.stl
UGV-01/cad/assembly/generated/UGV-MECH-042.stl
UGV-01/cad/assembly/generated/UGV-MECH-043-+1.stl
UGV-01/cad/assembly/generated/UGV-MECH-043--1.step
UGV-01/cad/assembly/generated/UGV-MECH-043--1.stl
UGV-01/cad/assembly/generated/UGV-MECH-044-+1.stl
UGV-01/cad/assembly/generated/UGV-MECH-044--1.step
UGV-01/cad/assembly/generated/UGV-MECH-044--1.stl
UGV-01/cad/assembly/generated/UGV-MECH-045.stl
UGV-01/cad/assembly/generated/UGV-MECH-046.stl
UGV-01/cad/assembly/generated/UGV-MECH-050-+1.stl
UGV-01/cad/assembly/generated/UGV-MECH-050--1.step
UGV-01/cad/assembly/generated/UGV-MECH-050--1.stl
UGV-01/cad/assembly/generated/UGV-MECH-051-+1.stl
UGV-01/cad/assembly/generated/UGV-MECH-051--1.step
UGV-01/cad/assembly/generated/UGV-MECH-051--1.stl
UGV-01/cad/assembly/generated/UGV-MECH-052-+1.stl
UGV-01/cad/assembly/generated/UGV-MECH-052--1.step
UGV-01/cad/assembly/generated/UGV-MECH-052--1.stl
UGV-01/cad/assembly/generated/UGV-MECH-053-+1.stl
UGV-01/cad/assembly/generated/UGV-MECH-053--1.step
UGV-01/cad/assembly/generated/UGV-MECH-053--1.stl
UGV-01/cad/assembly/generated/UGV-MECH-054-+1.stl
UGV-01/cad/assembly/generated/UGV-MECH-054--1.step
UGV-01/cad/assembly/generated/UGV-MECH-054--1.stl
UGV-01/cad/assembly/generated/UGV-MECH-055-+1.stl
UGV-01/cad/assembly/generated/UGV-MECH-055--1.step
UGV-01/cad/assembly/generated/UGV-MECH-055--1.stl
UGV-01/cad/assembly/generated/UGV-MECH-056--1.stl
UGV-01/cad/assembly/generated/UGV-MECH-057-+1.stl
UGV-01/cad/assembly/generated/UGV-MECH-058-+1.stl
UGV-01/cad/assembly/generated/UGV-MECH-058--1.step
UGV-01/cad/assembly/generated/UGV-MECH-059-+1.stl
UGV-01/cad/assembly/generated/UGV-MECH-059--1.step
UGV-01/cad/assembly/generated/UGV-MECH-059--1.stl
UGV-01/cad/assembly/generated/UGV-MECH-060-FL.stl
UGV-01/cad/assembly/generated/UGV-MECH-060-FR.stl
UGV-01/cad/assembly/generated/UGV-MECH-060-RL.stl
UGV-01/cad/assembly/generated/UGV-MECH-060-RR.stl
UGV-01/cad/assembly/generated/UGV-MECH-061-FL.stl
UGV-01/cad/assembly/generated/UGV-MECH-061-FR.stl
UGV-01/cad/assembly/generated/UGV-MECH-061-RL.stl
UGV-01/cad/assembly/generated/UGV-MECH-061-RR.stl
UGV-01/cad/assembly/generated/UGV-MECH-062-+1.stl
UGV-01/cad/assembly/generated/UGV-MECH-062--1.step
UGV-01/cad/assembly/generated/UGV-MECH-062--1.stl
UGV-01/cad/assembly/generated/UGV-MECH-063--1.stl
UGV-01/cad/assembly/generated/UGV-MECH-064--1.stl
UGV-01/cad/assembly/generated/UGV-MECH-065-+1.stl
UGV-01/cad/assembly/generated/UGV-MECH-066-+1.stl
UGV-01/cad/assembly/generated/UGV-MECH-067-+1.stl
UGV-01/cad/assembly/generated/UGV-MECH-068-+1.stl
UGV-01/cad/assembly/generated/UGV-MECH-069-+1.stl
UGV-01/cad/assembly/generated/UGV-MECH-070.stl
UGV-01/cad/assembly/generated/UGV-MECH-071.stl
UGV-01/cad/assembly/generated/UGV-MECH-072.stl
UGV-01/cad/assembly/generated/UGV-MECH-073.stl
UGV-01/cad/assembly/generated/UGV-MECH-074-+1.stl
UGV-01/cad/assembly/generated/UGV-MECH-075-+1.stl
UGV-01/cad/assembly/generated/UGV-MECH-076-+1.stl
UGV-01/cad/assembly/generated/UGV-MECH-077-+1.stl
UGV-01/cad/drivetrain/generated/UGV-MECH-046.stl
UGV-01/cad/drivetrain/generated/UGV-MECH-047.stl
UGV-01/cad/drivetrain/generated/lightweight/UGV-MECH-046-B.stl
UGV-01/cad/drivetrain/generated/lightweight/UGV-MECH-047-B.stl
