efekrkyn/UGV-01/UGV-01/cad/assembly/assembly_sequence.md

# Öngörülen montaj ve servis sırası

1. Metal plaka ve rijitleştiriciler: datum/çapak/delik kontrolü; mast ve drivetrain yük yolunu PH4 detaylarıyla bağla.
2. Dört motor taşıyıcı, ayrı yataklı mil/göbek ve encoder kabloları; mil eksenleri x±105,y±120,z60 referansıyla ölçülür. A1 montajdaki motor zarfı bağlantı braketi içermez.
3. PWR/MCU izolasyonlu raf mesnetleri; motor güç demetleri yan koridorlarda. Test noktaları üstten erişilebilir kalır.
4. Ön/orta/arka sol/sağ ASA paneller ve son duvarlar. Taban M4 somunları alttan erişilir; kablo geçişlerinde gerilim tahliye gerekir.
5. Compute rafı, CM5 IO, USB-CAN ve fan; kablo çıkışları sürtünmeden servis payı bırakır.
6. Kasa dahil batarya paketi, açık tutucu ve metal kayış; kutup başları yalıtılmış; ana sigorta pakete yakın. Paket z83–138 rezervine sığmalıdır.
7. Kapaklar ve ön tek RGB kamera; gerçek kamera/pencere braketi MPN sonrası çözülür. Üstteki düz kule flanşı gelecekteki modüller içindir; kule yükü servis kapağına bırakılmaz.
8. Batarya bağlamadan polarite/continuity; T01–T09; T13/T14 geçmeden zeminde hareket yok.

Servis: E-stop ardından ana servis izolasyonu ve kondansatör kontrolü; yalnız ilgili kapak açılır. Batarya +z yönünde çıkar; CM5 rafı sökülerek alt kartlara erişilir. Bu sıralama CAD zarf incelemesidir; gerçek konektörler/aletler ve 1:1 maketle montaj gösterimi yapılmadı.
