efekrkyn/UGV-01/UGV-01/docs/revisions/A2/README.md

# UGV-01 A2 arşivi

24.09.2026. A2 karakter kavramı ([config](vehicle.json), [STEP](UGV-01-A2-concept.step), [manifest](manifest.json), [önizleme](concept_preview.png)); bütçe revizyonu A3 Lite (DD65/DD66) tarafından değiştirildi. CM5, STM32G474, PWR kartı (K1/K2), 6061 plaka, Pololu 37D motorlar ve 4S2P paket içerir. D1/D2A tahrik araçları bu config'e göre çalışır. **Üretim dosyası değildir.**
