efekrkyn/UGV-01/UGV-01/docs/revisions/A1/README.md

# UGV-01 A1 arşivi

24.09.2026. A1 kavram montajı ([STEP](UGV-01-A1-concept.step), [manifest](manifest.json), [önizleme](concept_preview.png)); A2 tarafından değiştirildi. Tek ön RGB kamera podu ve düz sensör flanşı içerir. **Üretim dosyası değildir.**
