efekrkyn/UGV-01/UGV-01/docs/superpowers/plans/2026-09-25-m3-fix-n1-n2.md

# M3 düzeltmesi: N1 (kol yolu) ve N2 (hız döngüsü) — uygulama planı

> **For agentic workers:** REQUIRED SUB-SKILL: Use superpowers:executing-plans to implement this plan task-by-task. Steps use checkbox (`- [ ]`) syntax for tracking.

**Goal:** Codex'in yarım kalan M3 incelemesinde bulduğu ve doğrulanan iki sorunu kapatmak.

- **N1:** kol komutu 3 ayrı pakete bölünmüştü ve MacBook kendi sayacına göre "vardım" diyordu. 0x122 düşünce çekirdek, taranmamış karışık bir duruşta kaldı (J2 90°, dirsek 0°); yürütücü ise "reach_low" dedi.
- **N2:** firmware'de hız döngüsü yoktu, yalnız sabit ileri besleme vardı. Robot µ≥0,10 zeminde yerinde dönemiyor, dört teker STALL veriyordu. Hesaplar ise tam paket gerilimini varsayıyordu.

**Kullanıcı kararları (25.09.2026):**
1. Şimdi düzelt; Codex tam incelemeyi sonra yapar.
2. 9,2 V gerilim tavanını kaldır.

**Architecture:**
- **N1:**
  - Duruş grafiği config'ten `firmware/lite/arm_graph.h` olarak üretilir.
  - `firmware/lite/arm_path.{c,h}`, bu grafik üzerinde (kaynak, hedef, kesir) durumunu tutar. Yalnız kenar komutlarını kabul eder (aynı kenar, ters yön, ya da bir düğümden yeni kenar) ve beş eklemi birlikte, doğru üzerinde, 45°/s ile yürütür.
  - 0x122 = (kaynak, hedef, hedef kesir). 0x123 kalkar. 0x121 yalnız pençe ve AI bayrağını taşır.
  - Telemetri 0x1A2 (kaynak, hedef, kesir, hedef kesir, yerleşti) gönderir. MacBook bir sonraki kenara ancak telemetri yerleştiğini söyleyince geçer.
- **N2:**
  - Motor başına PI hız döngüsü.
  - Anti-windup, geri-EMK akım sınırlayıcı ve paket gerilimi içinde.
  - Stall kesmesi ve ısı bütçesi aynen kalır.
  - Hesapta dönüş akımı, sınırlayıcının izin verdiği akımla kırpılır; "300 mm/s tavanında duruk teker" satırı yerini "akım sınırlı duruk teker" satırına bırakır.

**Commit:** Yok. Fiziksel test NOT_RUN.

---

### Task 1: N2 hız döngüsü
- [x] Test → FAIL:
  - `lite_core_test`: µ=0,3 zeminde 0,45 rad/s dönüş, tekerler ~10 dev/dk'ya ulaşır, arıza yok;
  - µ=0,6'da (kapasite üstü) STALL ya da THERMAL ≤30 s içinde gelir;
  - duruk tekerde tahmini akım ≤ `LITE_I_LIMIT_A`;
  - hız döngüsü sürekli durumda komut hızını tutar.
- [x] `check_design`: `LITE_I_LIMIT_A` = config; akım sınırlı duruk teker ısısı; firmware'de sabit gerilim tavanı olmadığı.
- [x] `lite_core.c` PI + `calculations.py` → PASS

### Task 2: N1 firmware kol yolu
- [x] Test → FAIL:
  - her tikte beş eklem kenar doğrusunda, en hızlı eklem ≤45°/s;
  - kenar dışı ve süreksiz komut reddedilir;
  - ters yön ve tutma çalışır;
  - tek komutla, sonraki paketler kaybolsa bile hedefe varılır;
  - 0x1A2 yerleşti bilgisini verir;
  - `arm_graph.h` = config.
- [x] `gen_arm_graph.py`, `arm_path.c`, `can_protocol` 0x122, `lite_core` → PASS

### Task 3: N1 MacBook
- [x] Test → FAIL:
  - 0x122 paketlerinin %50'si düşse de kol hedefe varır ve çekirdek darbeleri doğrudur;
  - 0x122 hep düşerse yürütücü "vardım" demez (zaman aşımı), çekirdek parkta kalır.
- [x] `frames.py`, `vehicle.py` (telemetriye göre bacak bacak) → PASS

### Task 4: Belgeler
- [x] DD76, lite_software/electronics/mechanical, iletişim tablosu, hesap raporu.
- [x] Codex promptu güncellenir.
- [x] Bütün testler PASS.
