efekrkyn/UGV-01/UGV-01/electronics/interconnect/differential_i2c_reference.pdf

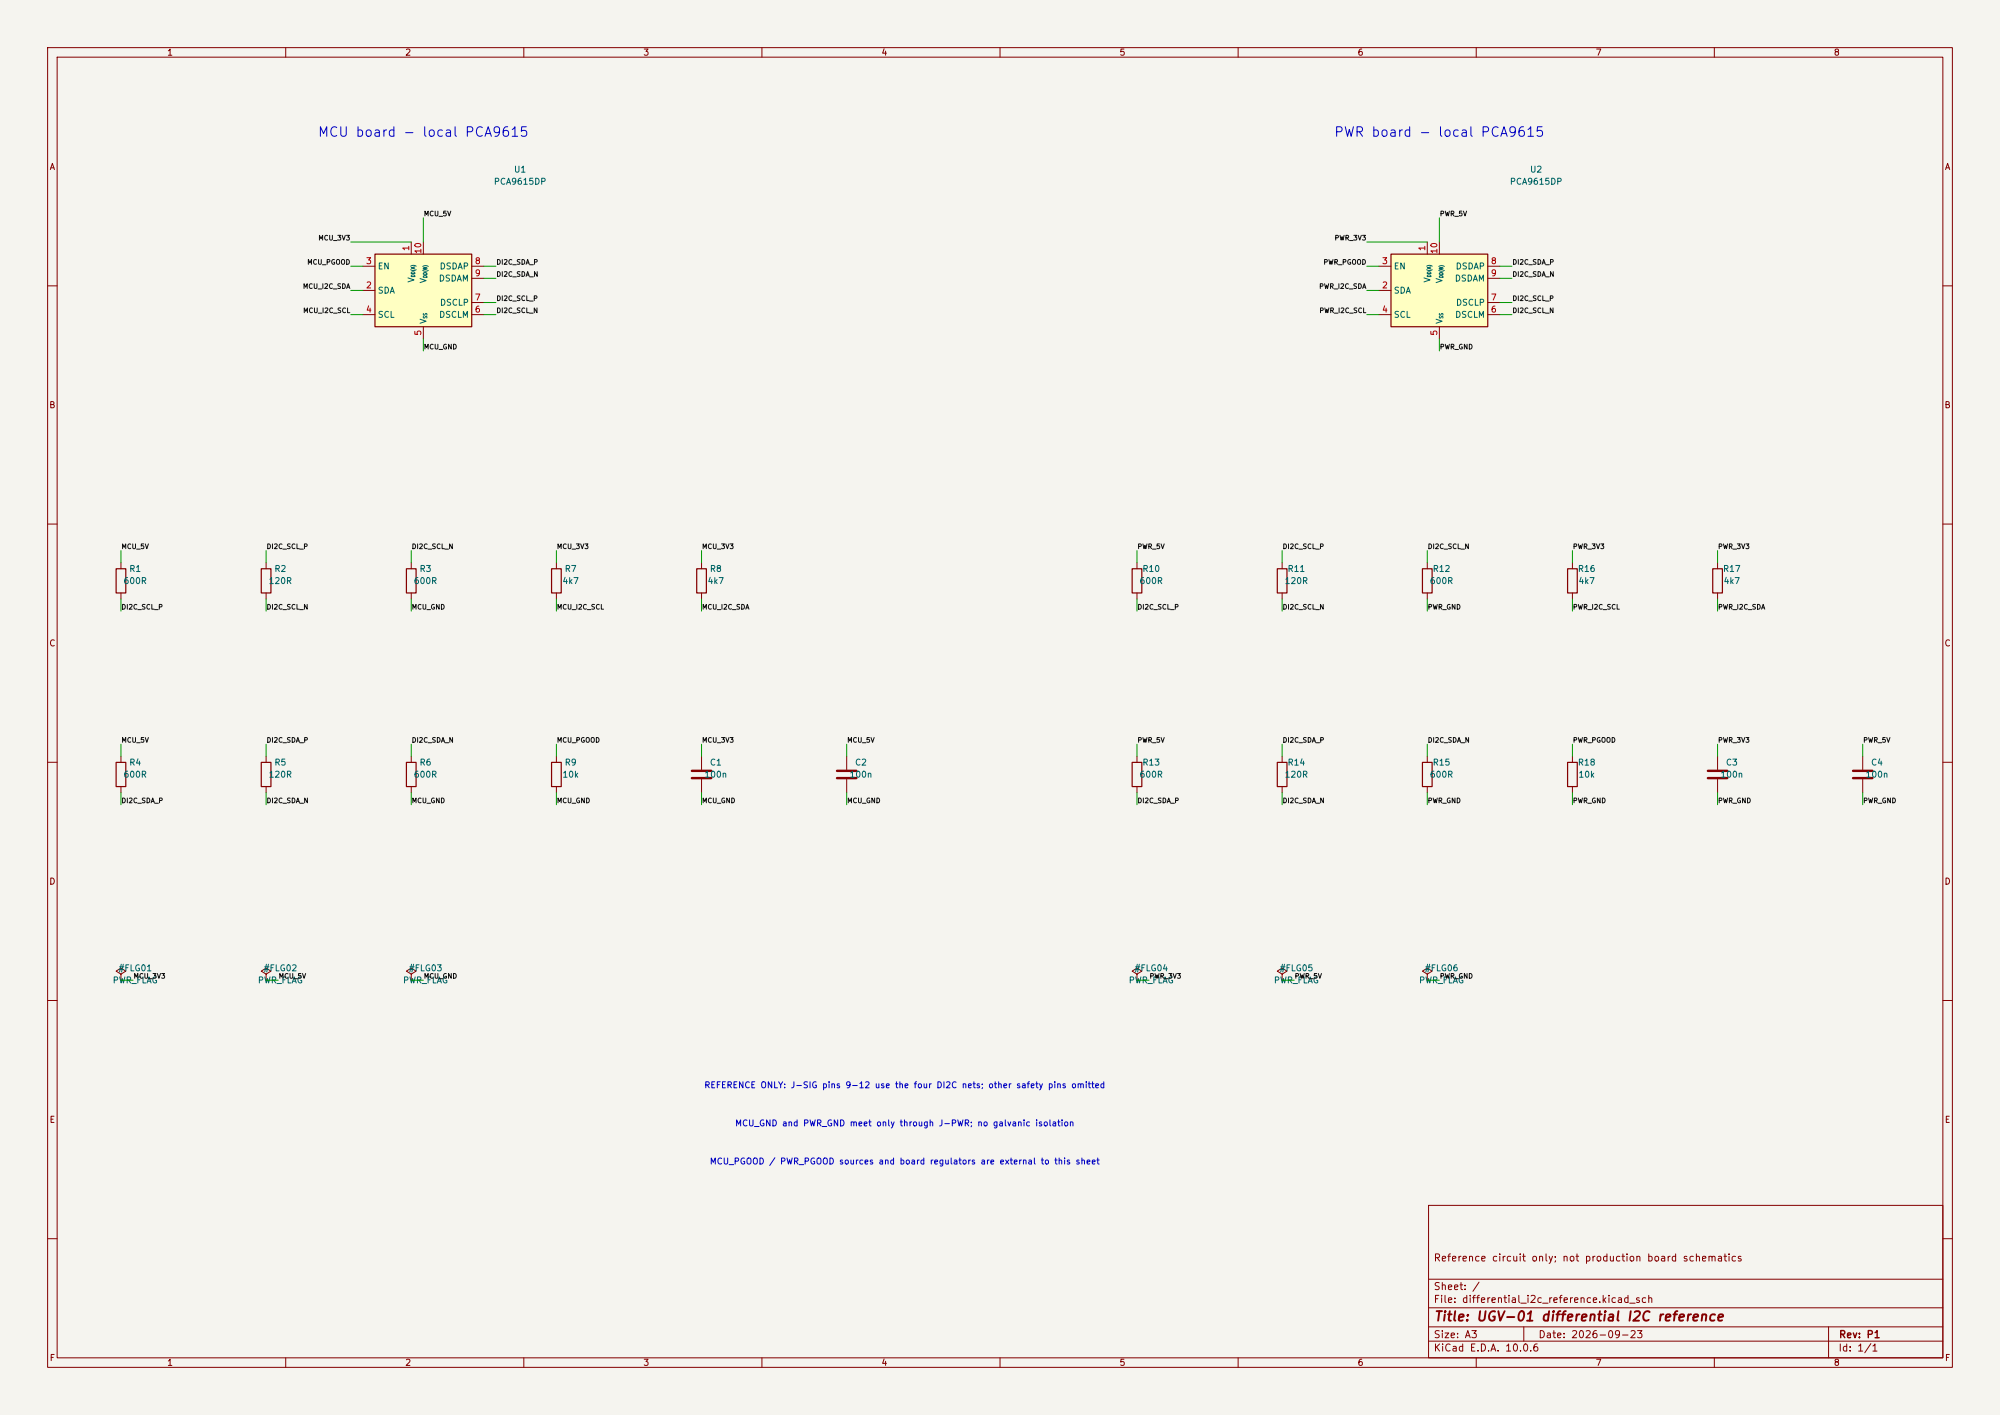
[picture p94: page 1]

VSS 5 DSCLM 6 DSCLP 7 DSDAP 8 DSDAM 9

REFERENCE ONLY: J-SIG pins 9-12 use the four DI2C nets; other safety pins omitted

Reference circuit only; not production board schematics

Sheet: /
File: differential_i2c_reference.kicad_sch
Title: UGV-01 differential I2C reference

Size: A3 | Rev: P1 | F Date: 2026-09-23
KiCad E.D.A. 10.0.6 | Id: 1/1
