efekrkyn/UGV-01/UGV-01/electronics/interconnect/pwr_mcu_harness.pdf

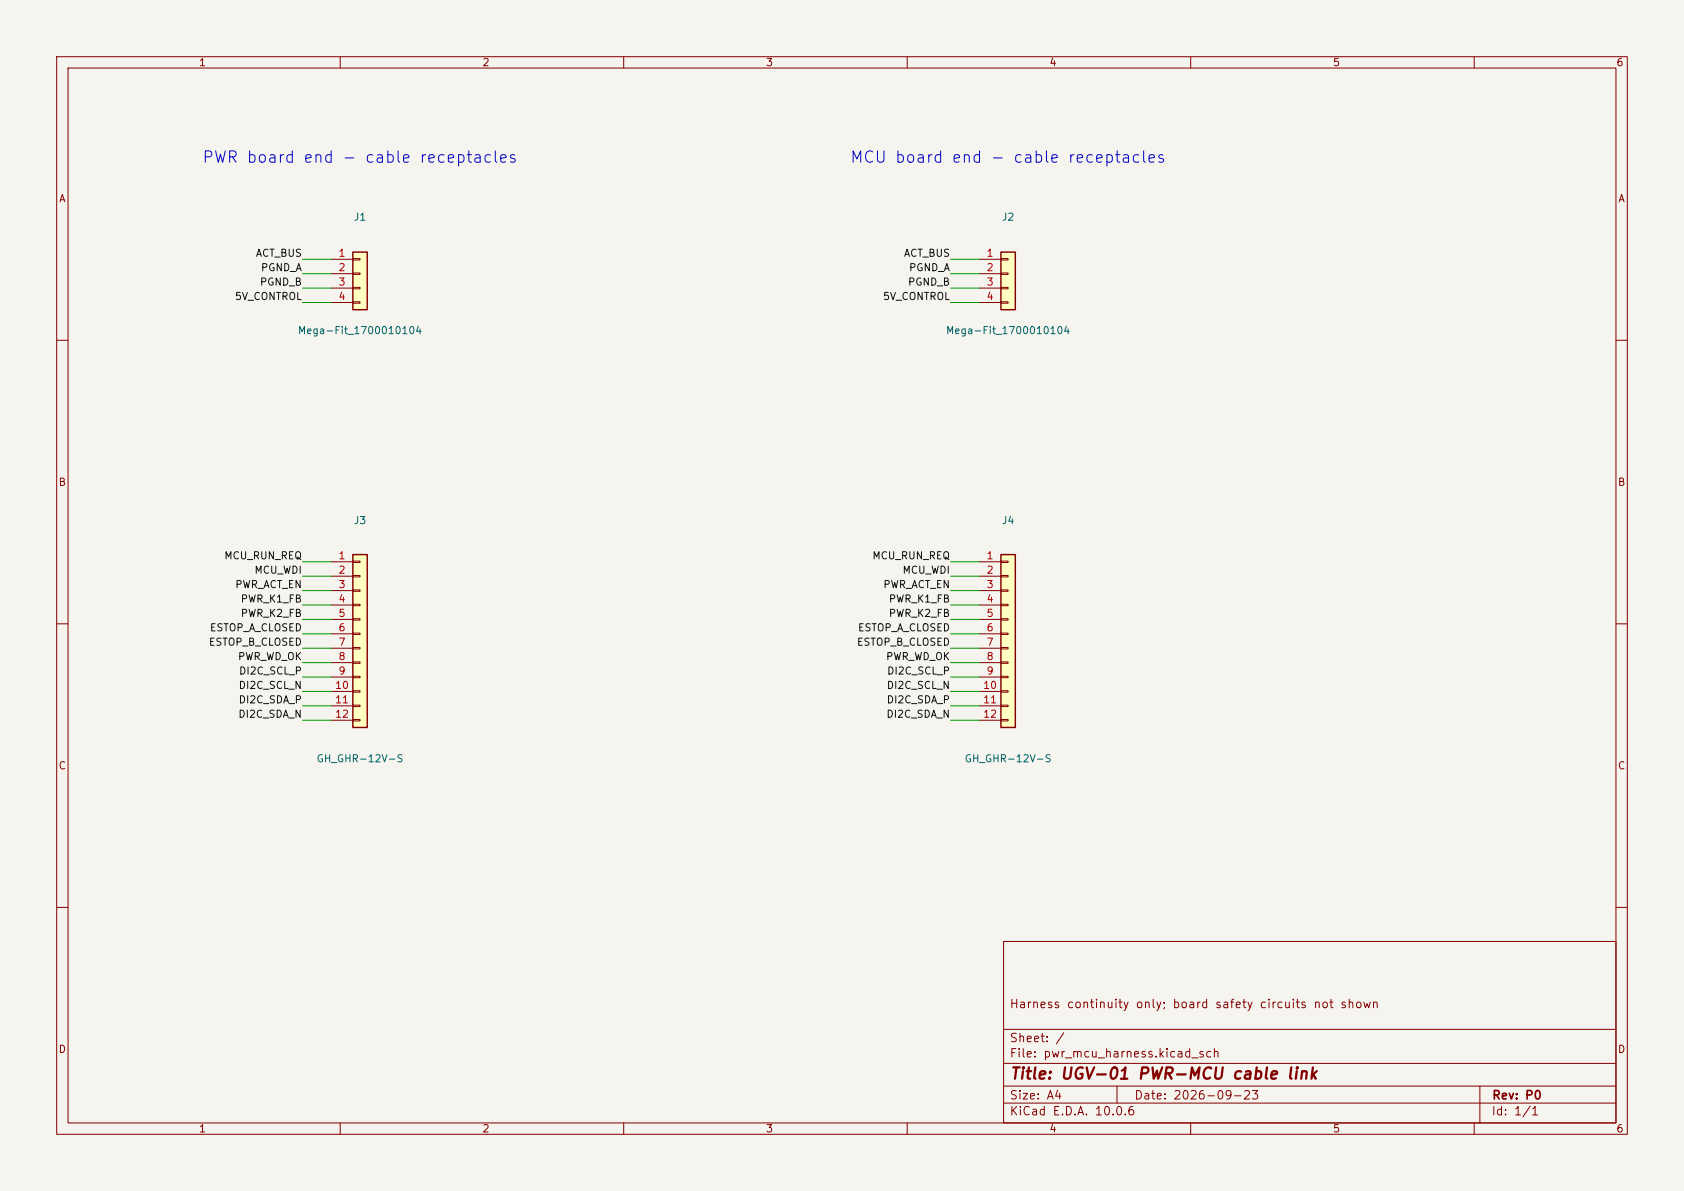
[picture p95: page 1]

Harness continuity only; board safety circuits not shown

Sheet: /
File: pwr_mcu_harness.kicad_sch
Title: UGV-01 PWR-MCU cable link

Size: A4 | Rev: P0
KiCad E.D.A. 10.0.6 | Id: 1/1
