efekrkyn/UGV-01/UGV-01/electronics/ugv_mcu_01/pwr_mcu_interface.pdf

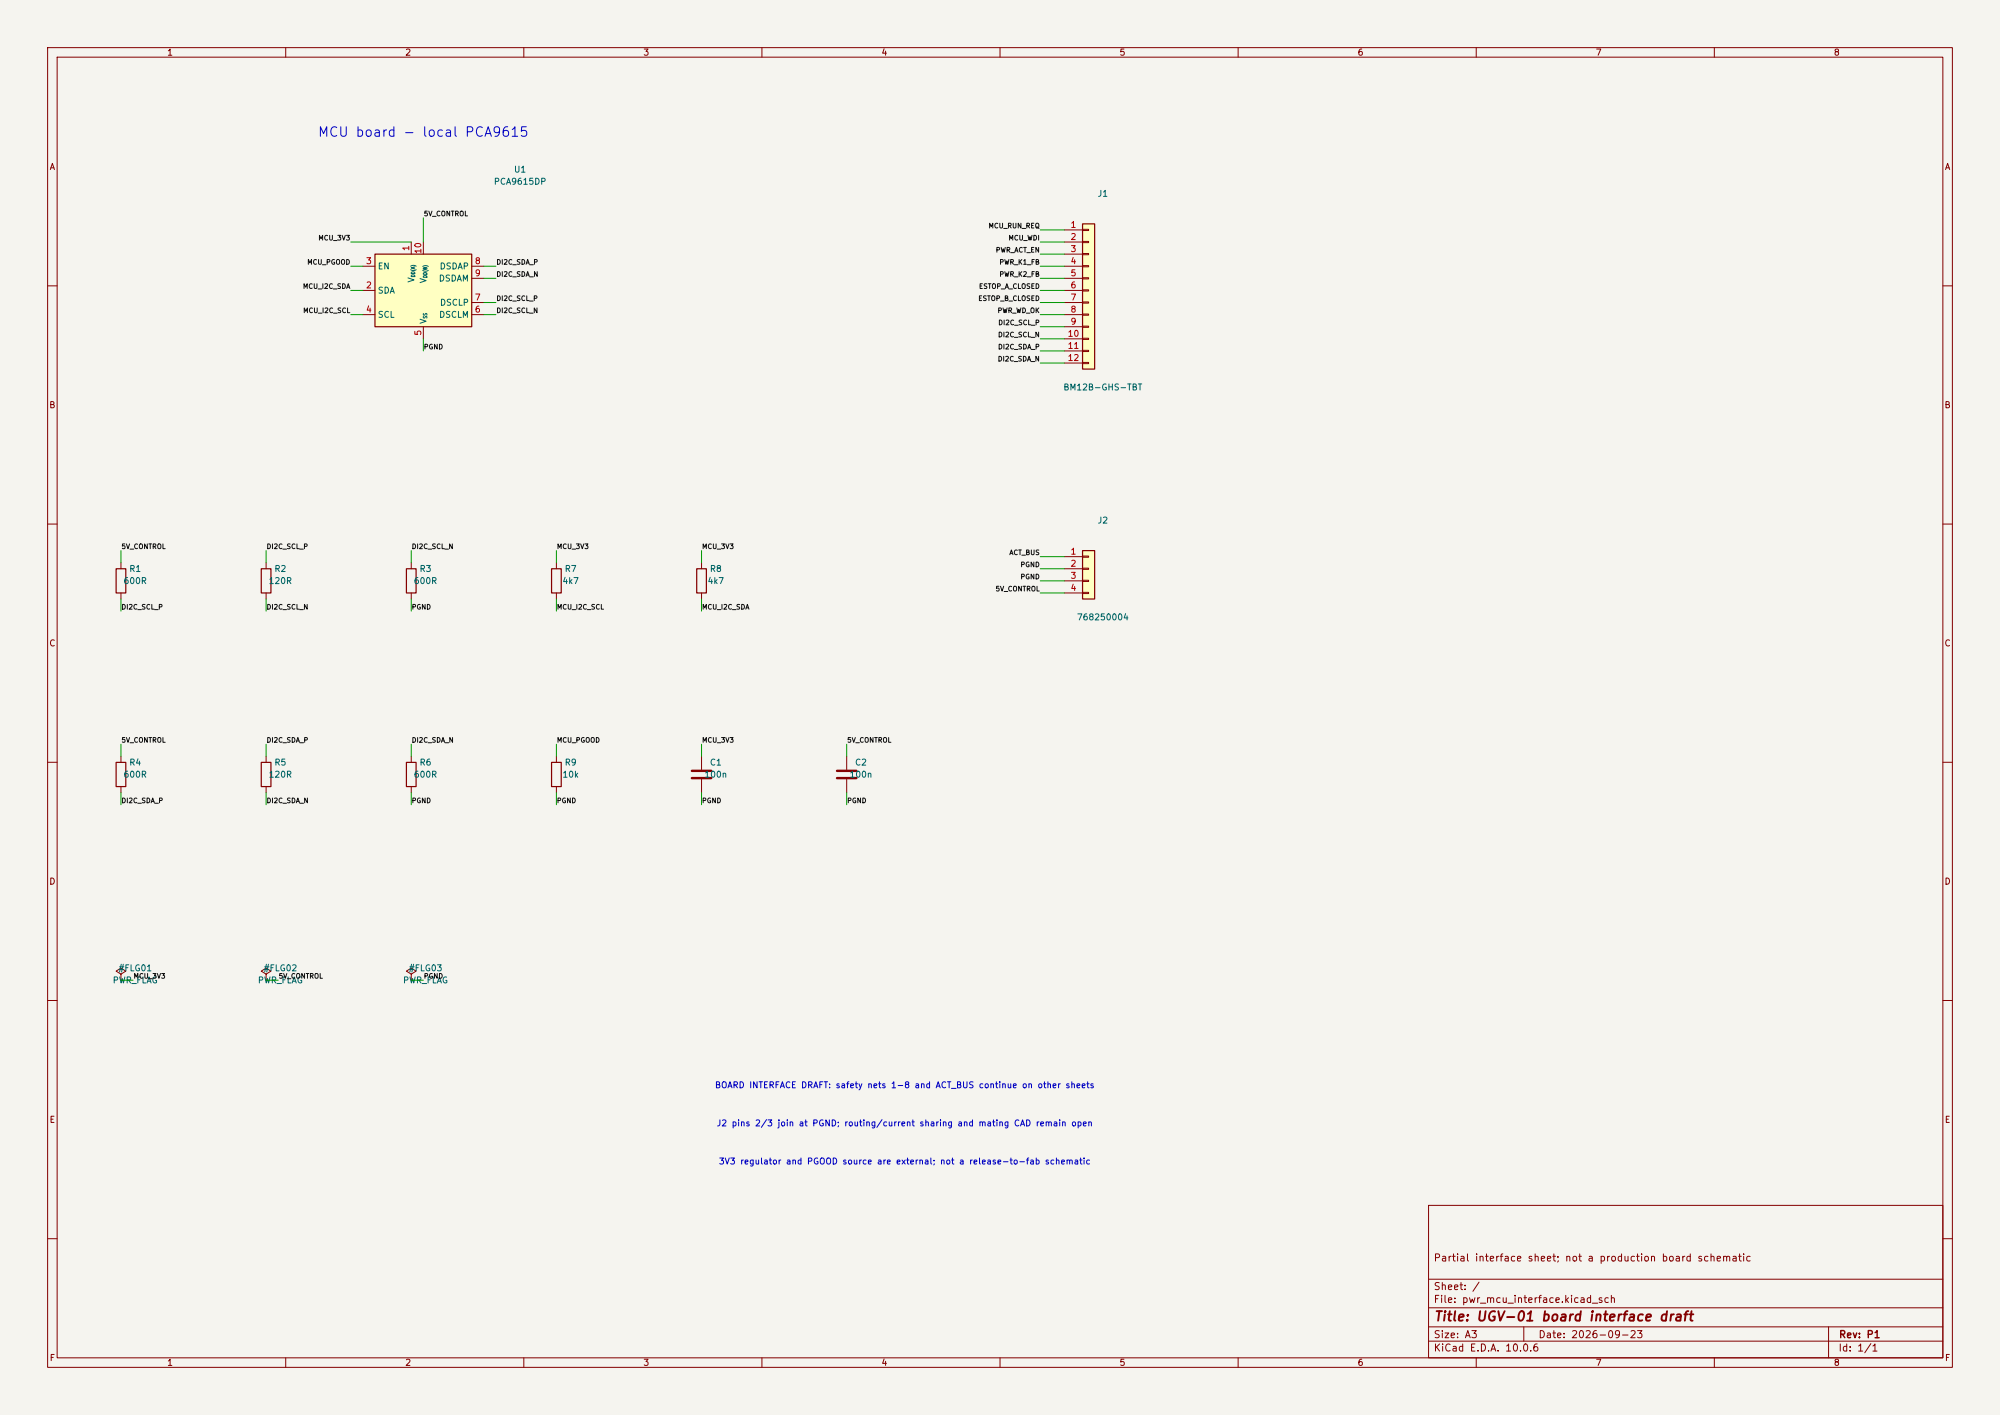
[picture p97: page 1]

VSS 5 DSCLM 6 DSCLP 7 DSDAP 8 DSDAM 9

J2 pins 2/3 join at PGND; routing/current sharing and mating CAD remain open BOARD INTERFACE DRAFT: safety nets 1-8 and ACT_BUS continue on other sheets 3V3 regulator and PGOOD source are external; not a release-to-fab schematic

Partial interface sheet; not a production board schematic

Sheet: /
File: pwr_mcu_interface.kicad_sch
Title: UGV-01 board interface draft

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
