efekrkyn/UGV-01/UGV-01/electronics/ugv_mcu_01/servo_light.pdf

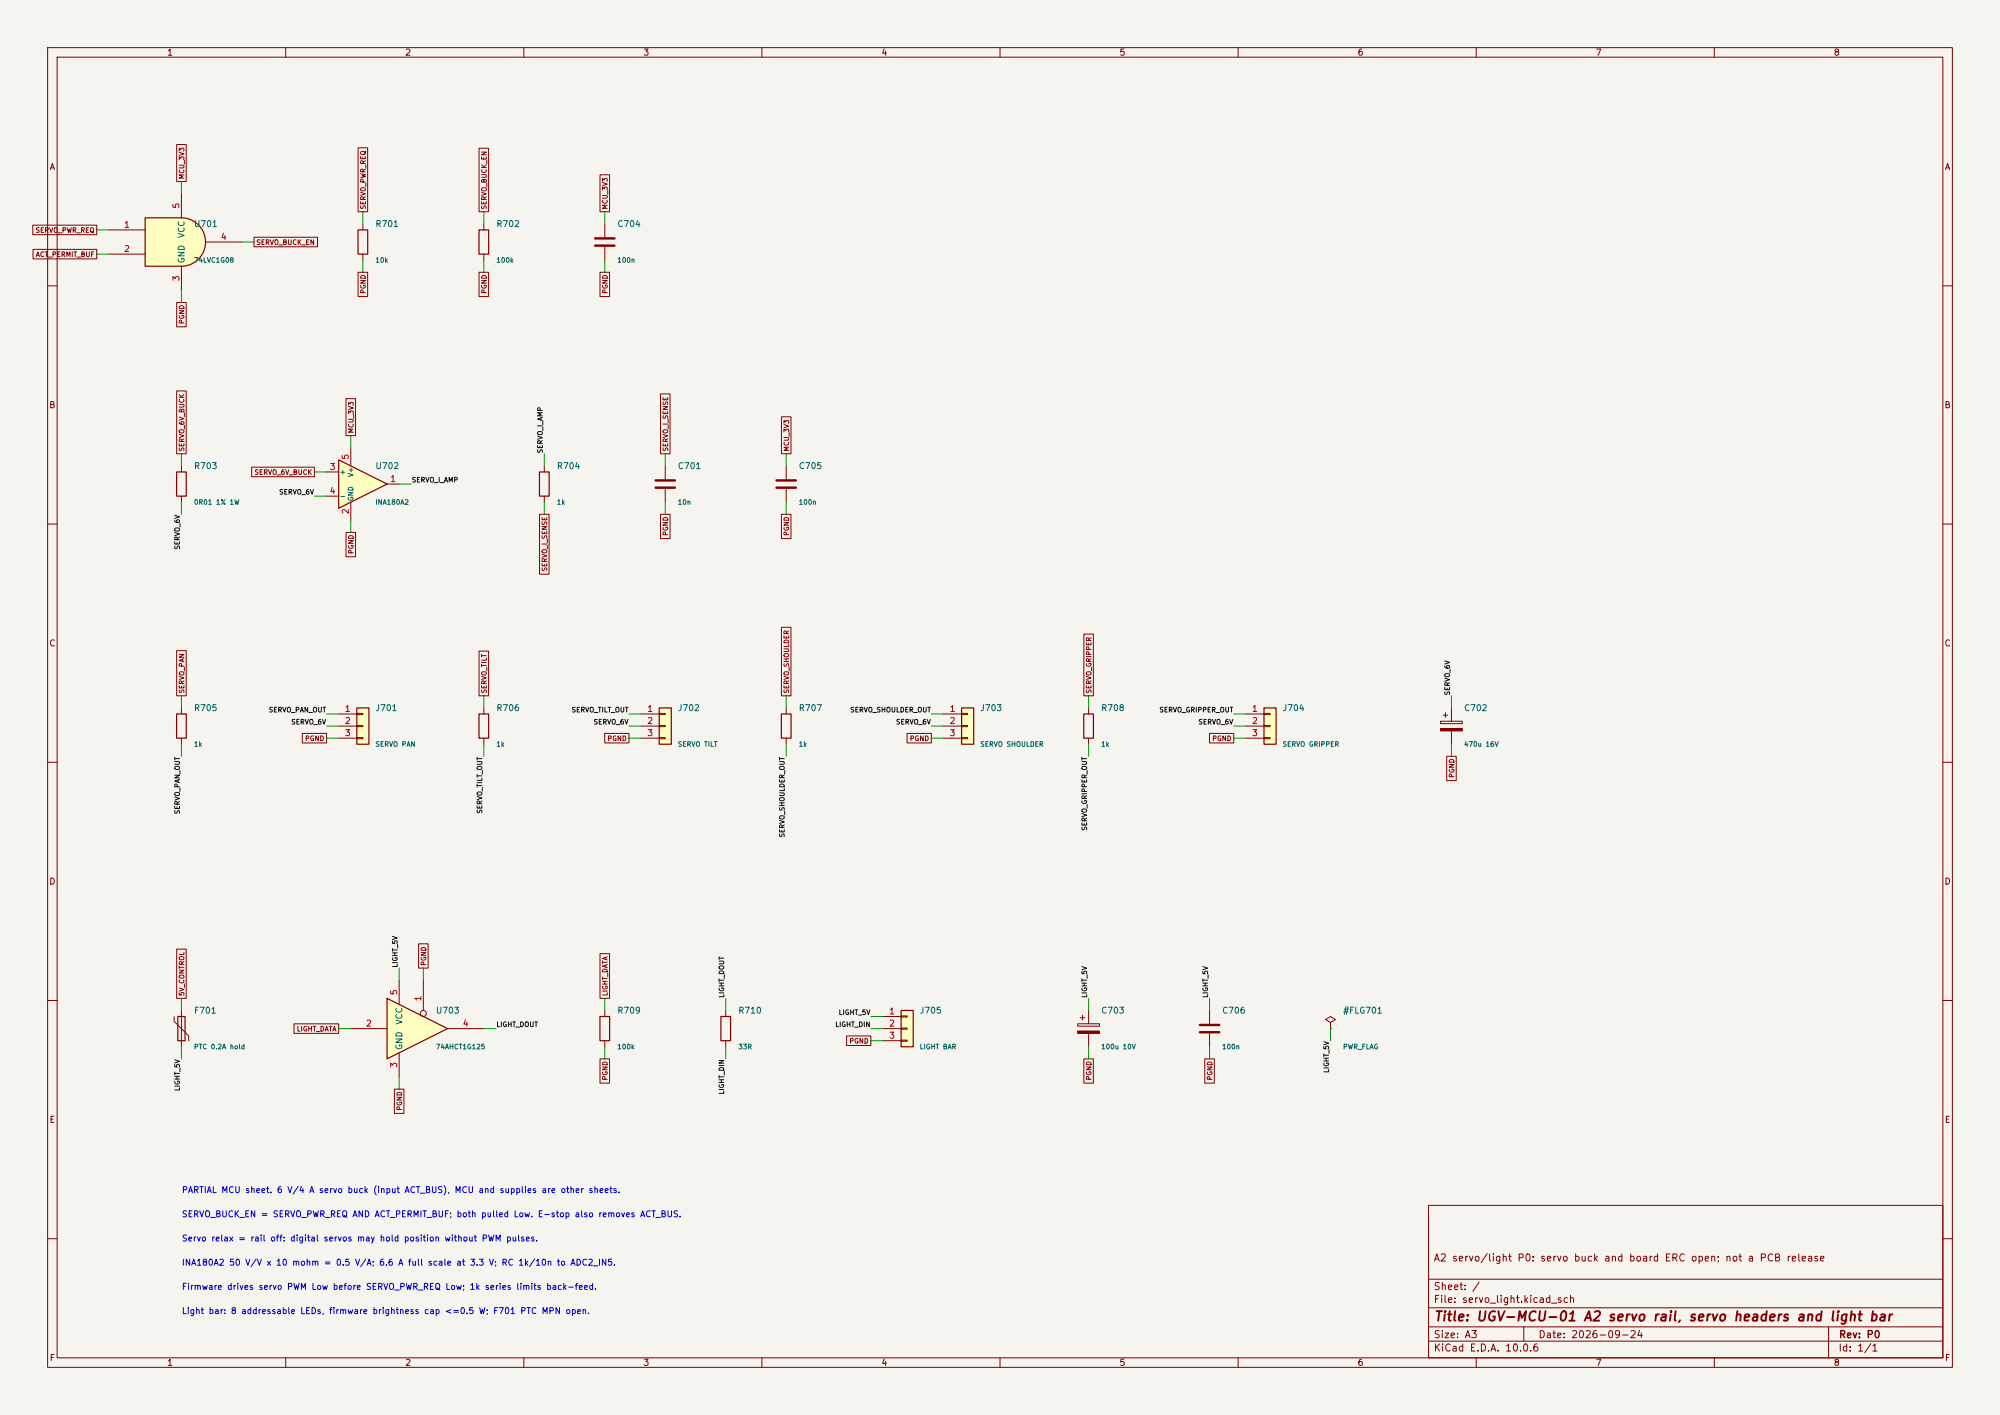
[picture p98: page 1]

A2 servo/light P0: servo buck and board ERC open; not a PCB release

INA180A2 50 V/V x 10 mohm = 0.5 V/A; 6.6 A full scale at 3.3 V; RC 1k/10n to ADC2_IN5. Firmware drives servo PWM Low before SERVO_PWR_REQ Low; 1k series limits back-feed. Light bar: 8 addressable LEDs, firmware brightness cap <=0.5 W; F701 PTC MPN open.

Sheet: /
File: servo_light.kicad_sch
Title: UGV-MCU-01 A2 servo rail, servo headers and light bar

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
