efekrkyn/UGV-01/UGV-01/electronics/ugv_mcu_01/status_receiver.pdf

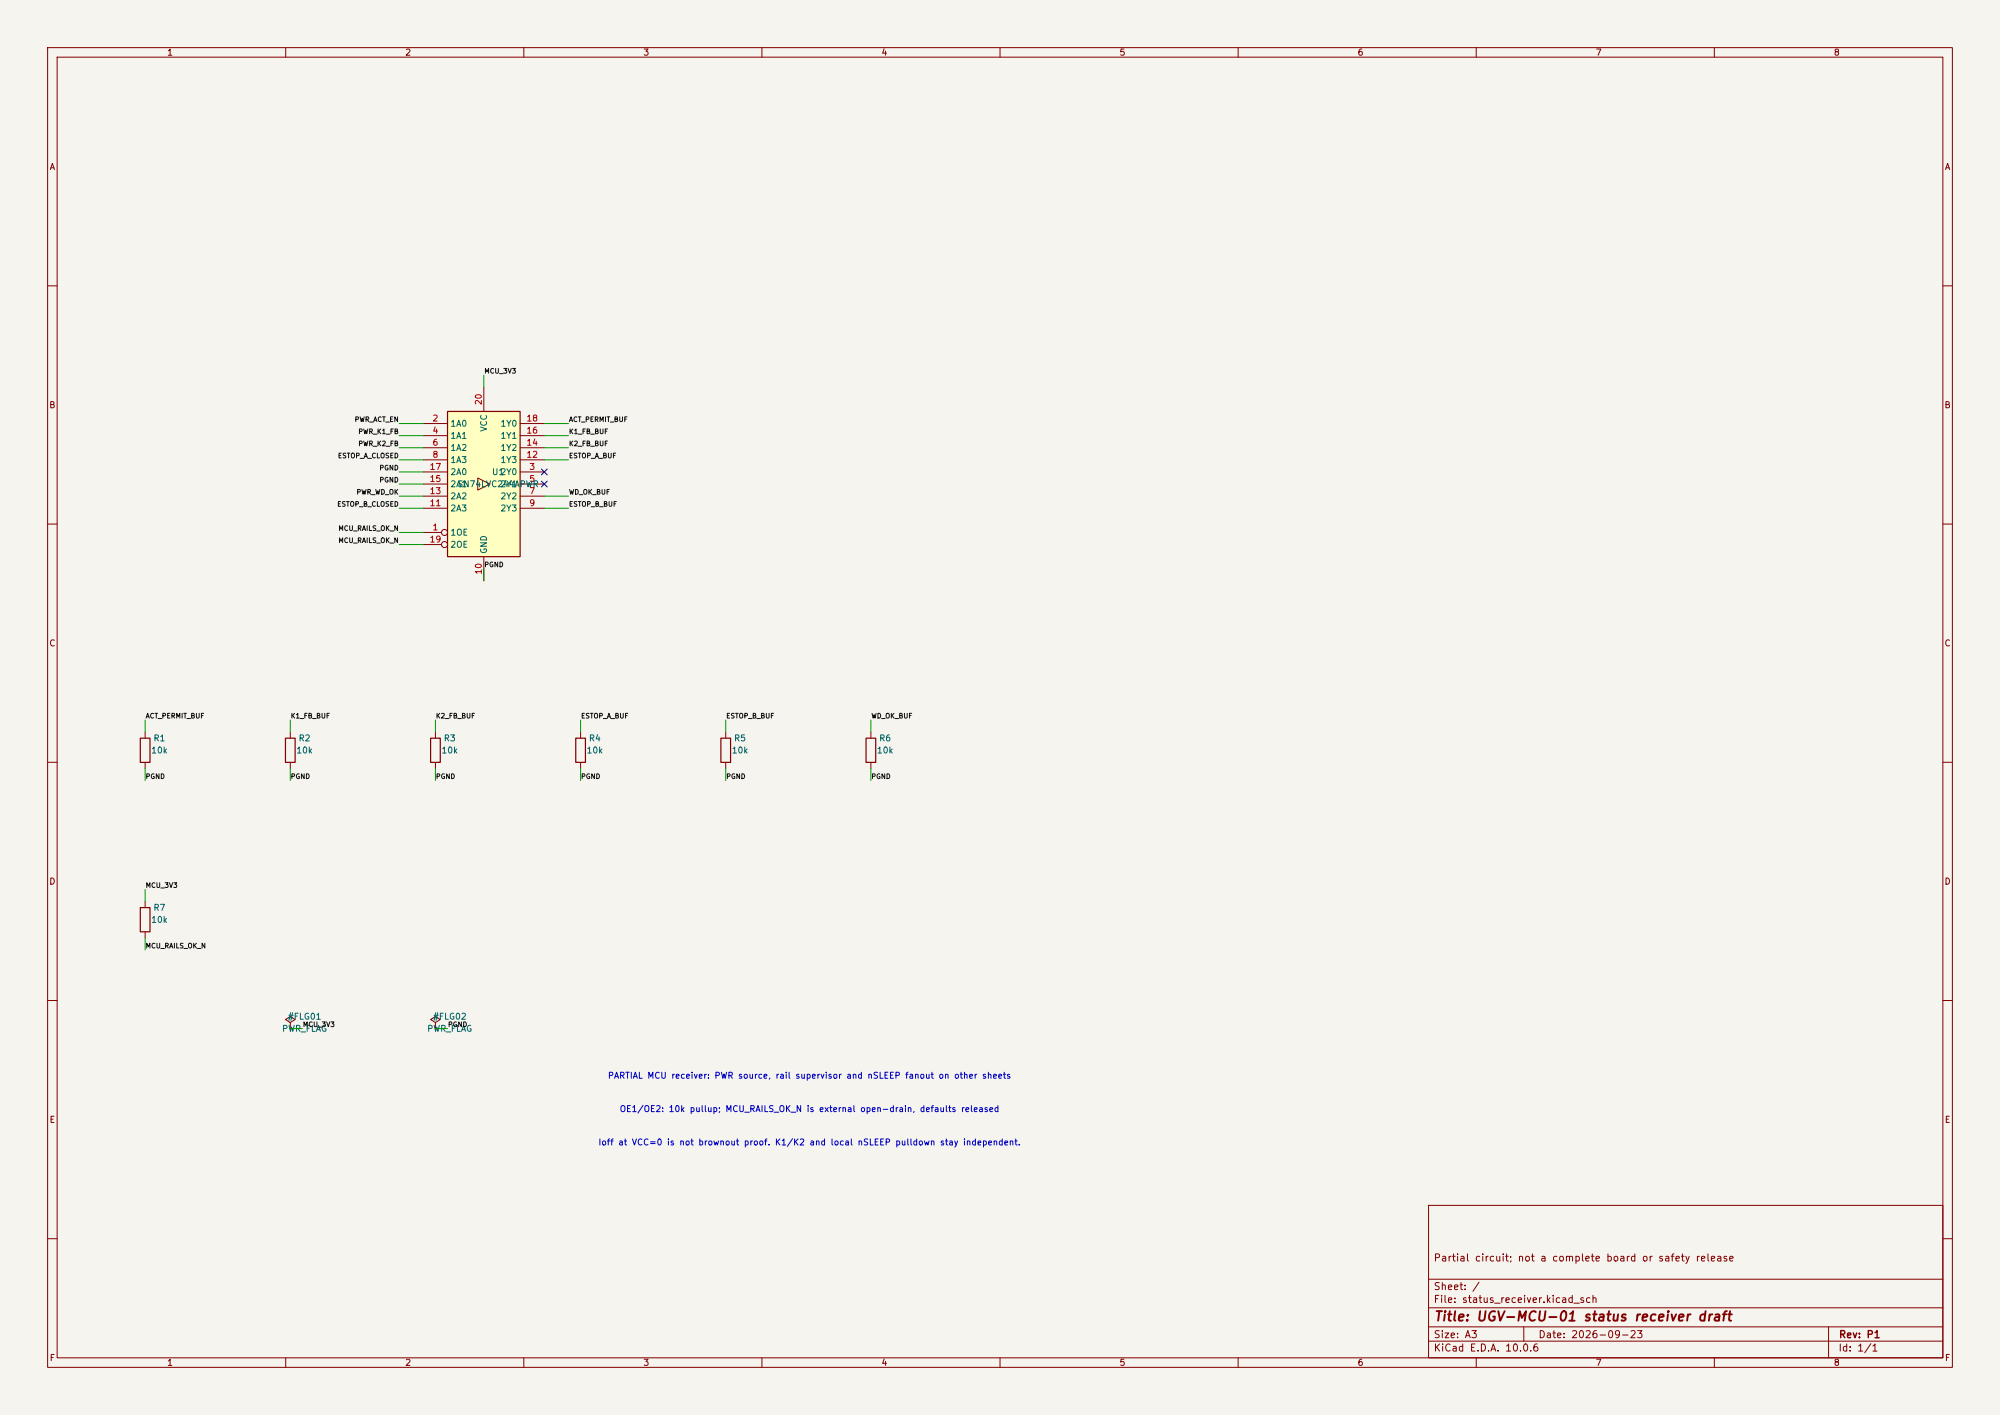
[picture p99: page 1]

ESTOP_A_BUF OE1/OE2: 10k pullup; MCU_RAILS_OK_N is external open-drain, defaults released PARTIAL MCU receiver: PWR source, rail supervisor and nSLEEP fanout on other sheets

Ioff at VCC=0 is not brownout proof. K1/K2 and local nSLEEP pulldown stay independent.

Partial circuit; not a complete board or safety release

Sheet: /
File: status_receiver.kicad_sch
Title: UGV-MCU-01 status receiver draft

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
