efekrkyn/UGV-01/UGV-01/electronics/ugv_pwr_01/k2_reference.pdf

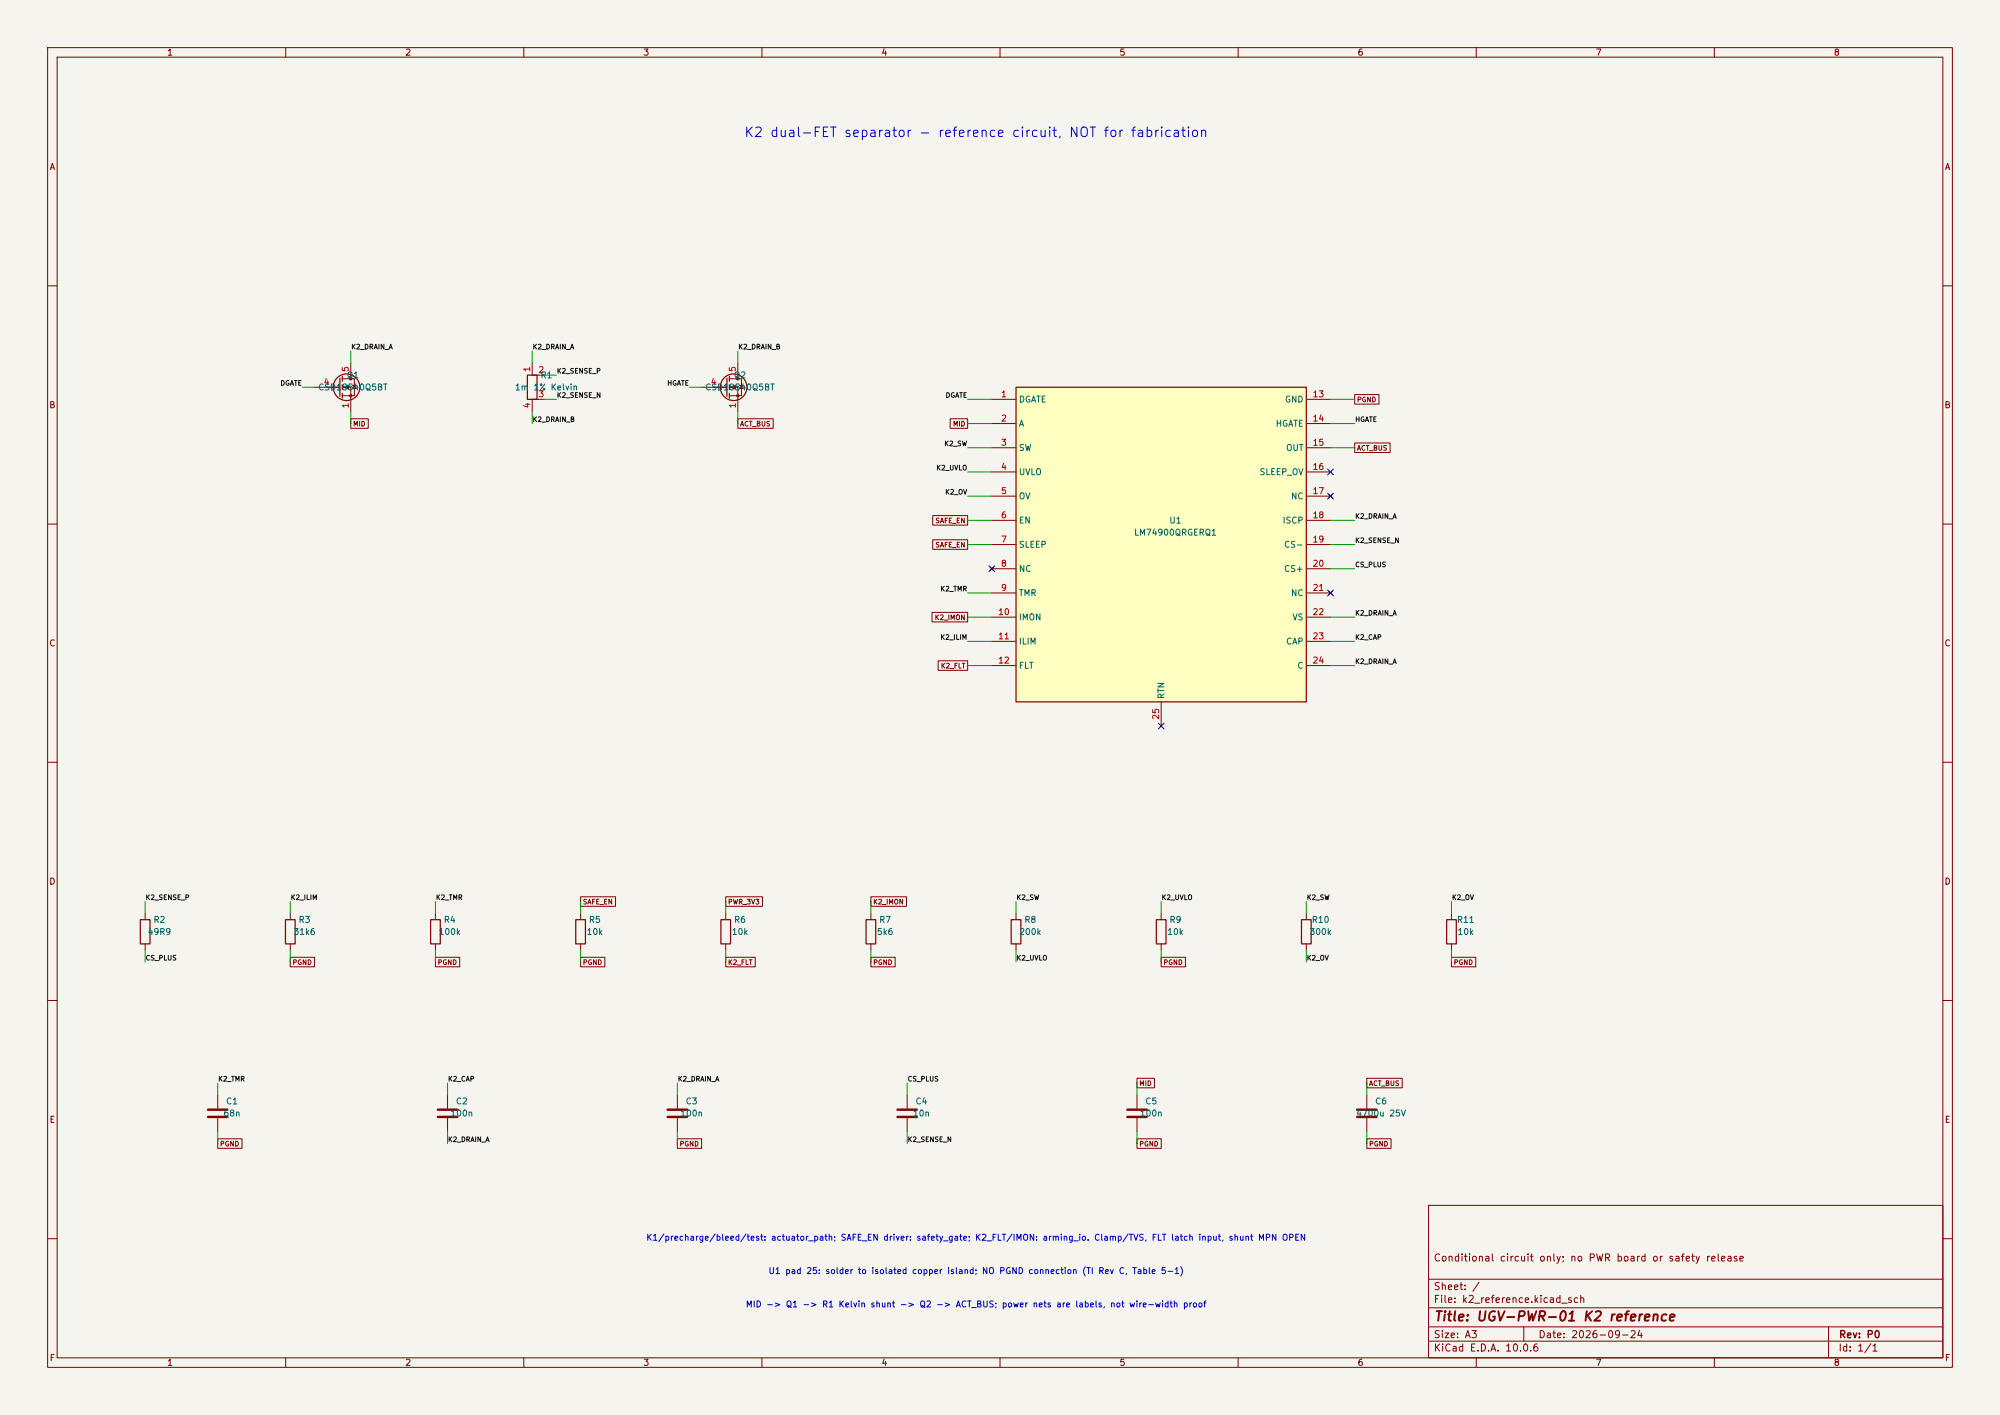
[picture p100: page 1]

K1/precharge/bleed/test: actuator_path; SAFE_EN driver: safety_gate; K2_FLT/IMON: arming_io. Clamp/TVS, FLT latch input, shunt MPN OPEN

Conditional circuit only; no PWR board or safety release

U1 pad 25: solder to isolated copper island; NO PGND connection (TI Rev C, Table 5-1)

Sheet: /
File: k2_reference.kicad_sch
Title: UGV-PWR-01 K2 reference

MID -> Q1 -> R1 Kelvin shunt -> Q2 -> ACT_BUS; power nets are labels, not wire-width proof

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
