efekrkyn/UGV-01/UGV-01/electronics/ugv_pwr_01/ugv_pwr_01.pdf

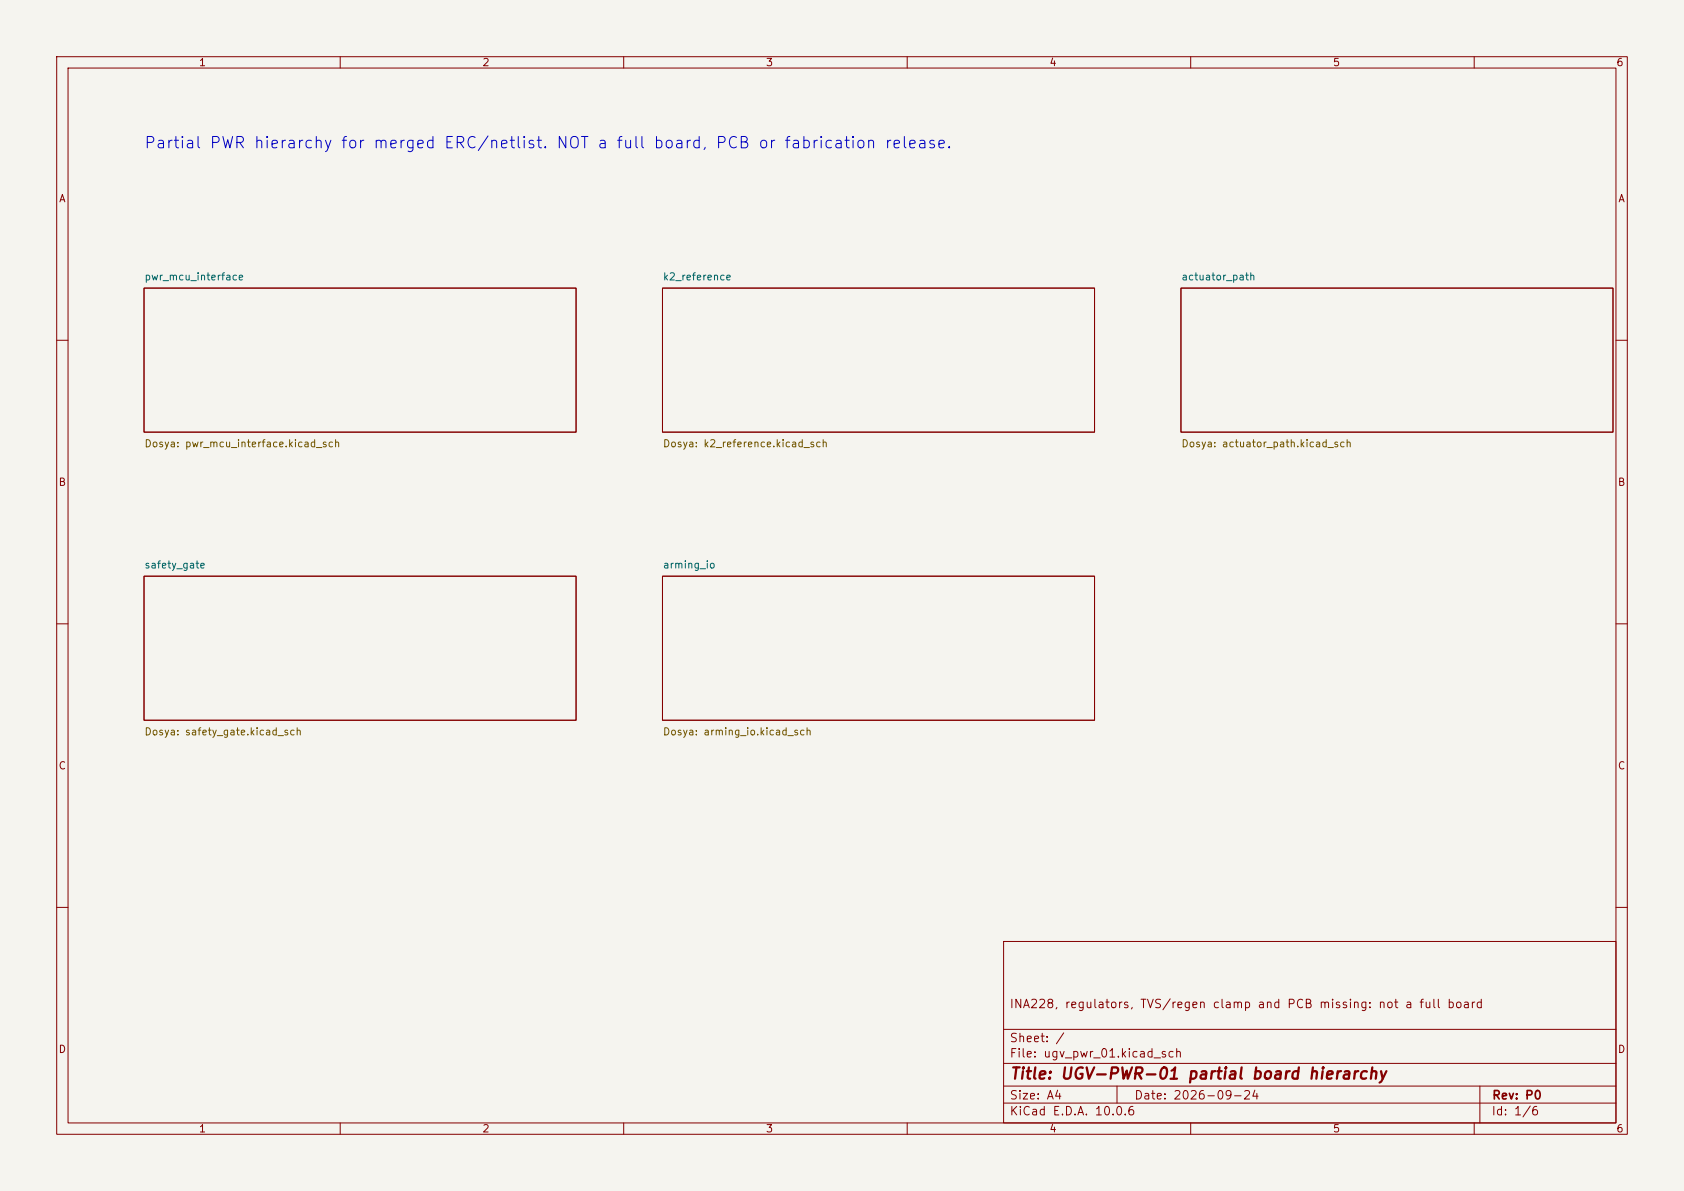
[picture p101: page 1]

Partial PWR hierarchy for merged ERC/netlist. NOT a full board, PCB or fabrication release.

INA228, regulators, TVS/regen clamp and PCB missing: not a full board

Sheet: /
File: ugv_pwr_01.kicad_sch
Title: UGV-PWR-01 partial board hierarchy

Size: A4 | Rev: P0
KiCad E.D.A. 10.0.6 | Id: 1/6

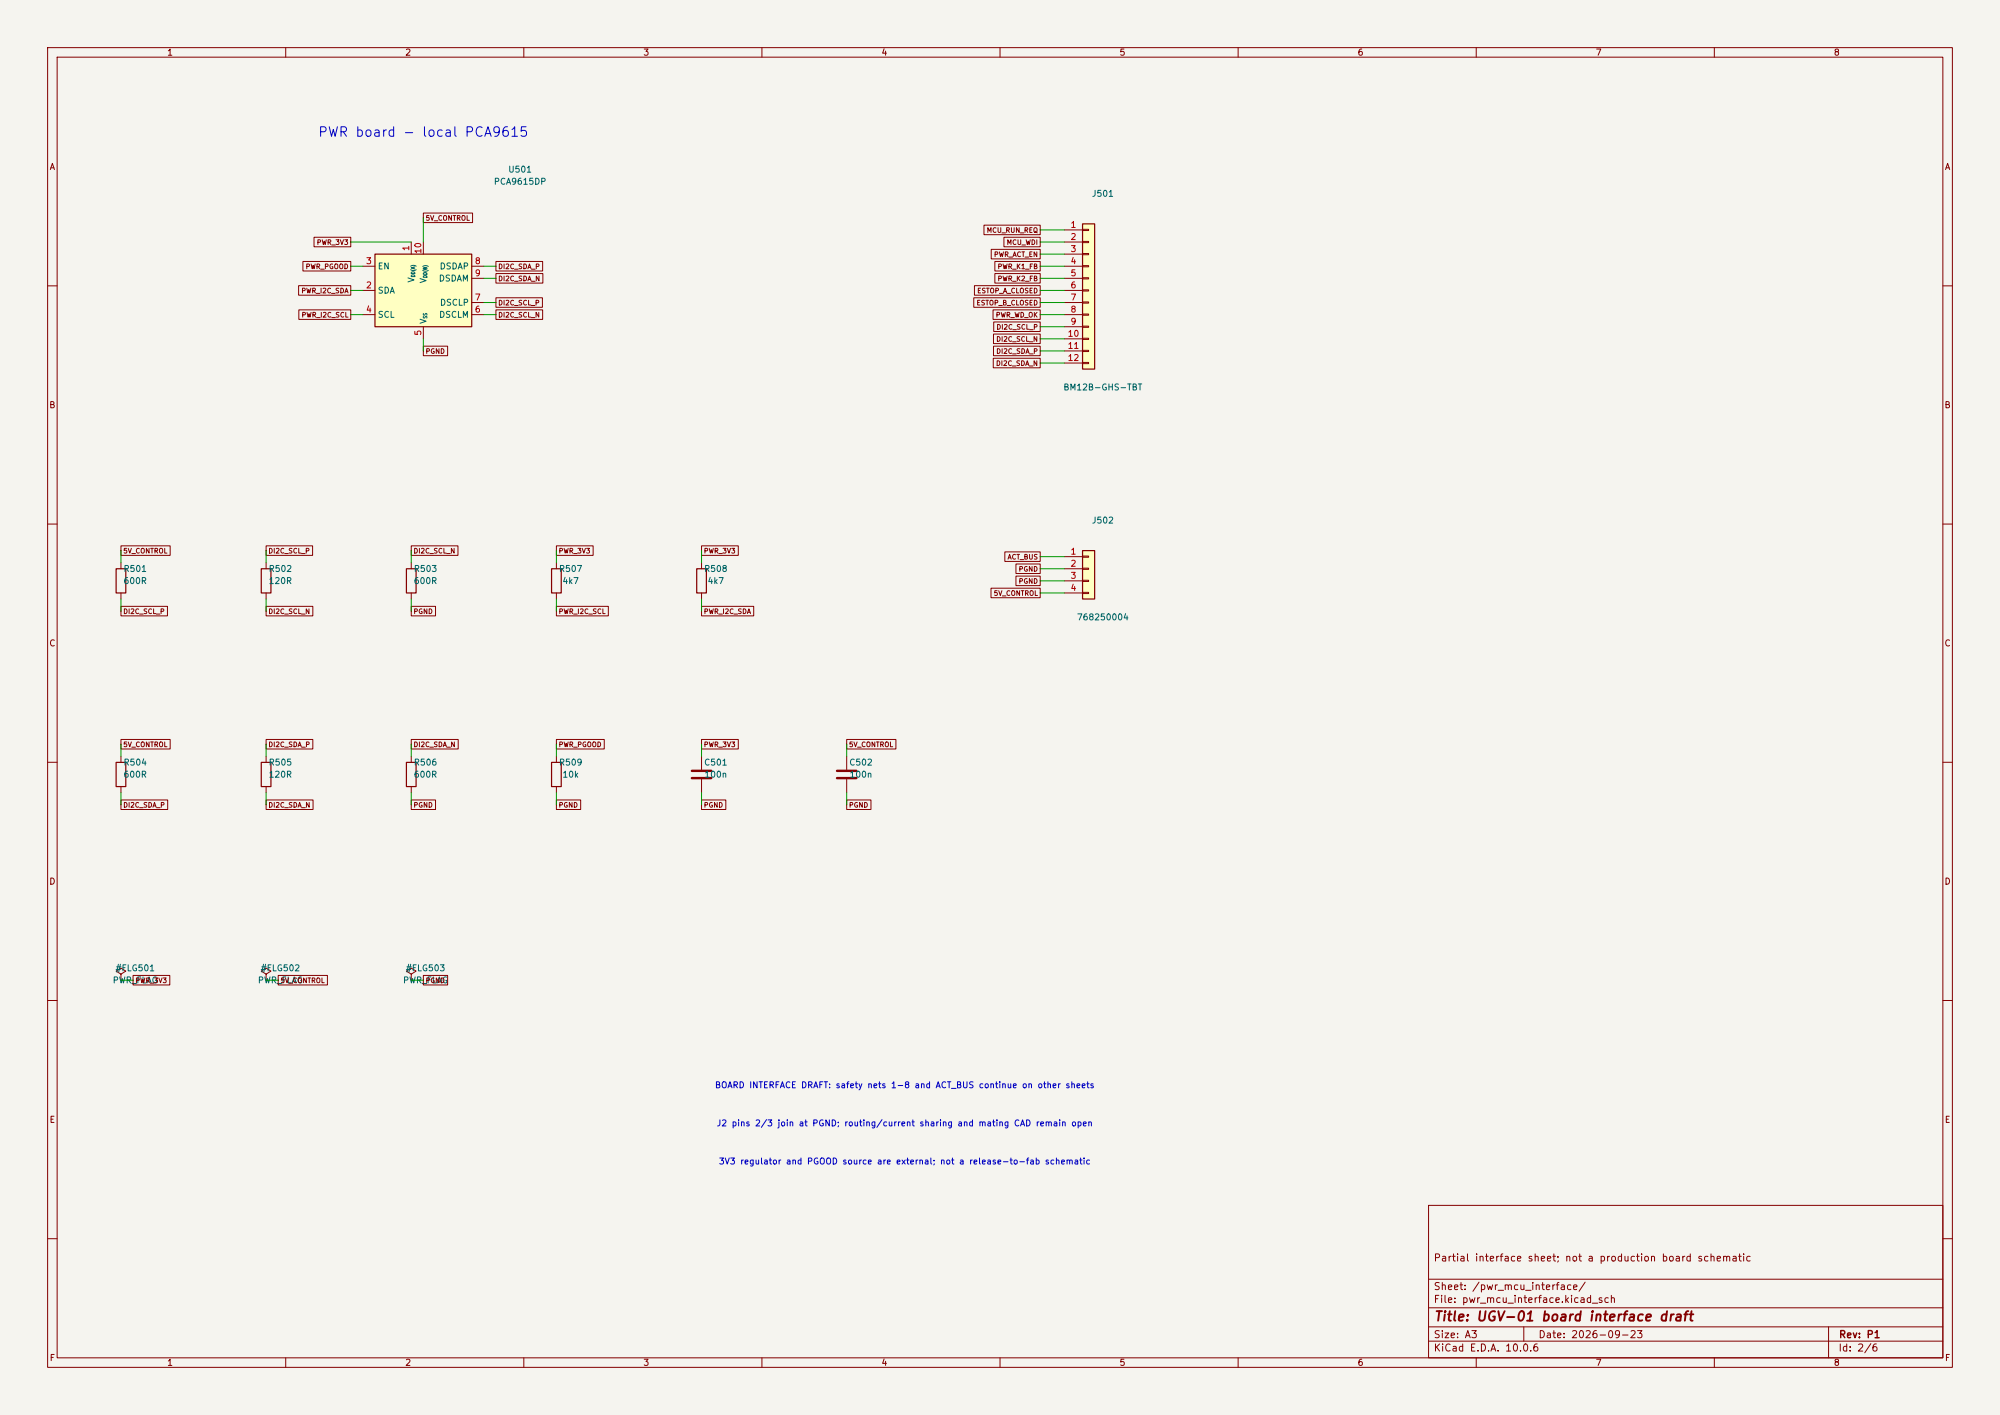
[picture p102: page 2]

VSS 5 DSCLM 6 DSCLP 7 DSDAP 8 DSDAM 9

J2 pins 2/3 join at PGND; routing/current sharing and mating CAD remain open BOARD INTERFACE DRAFT: safety nets 1-8 and ACT_BUS continue on other sheets 3V3 regulator and PGOOD source are external; not a release-to-fab schematic

Partial interface sheet; not a production board schematic

Sheet: /pwr_mcu_interface/
File: pwr_mcu_interface.kicad_sch
Title: UGV-01 board interface draft

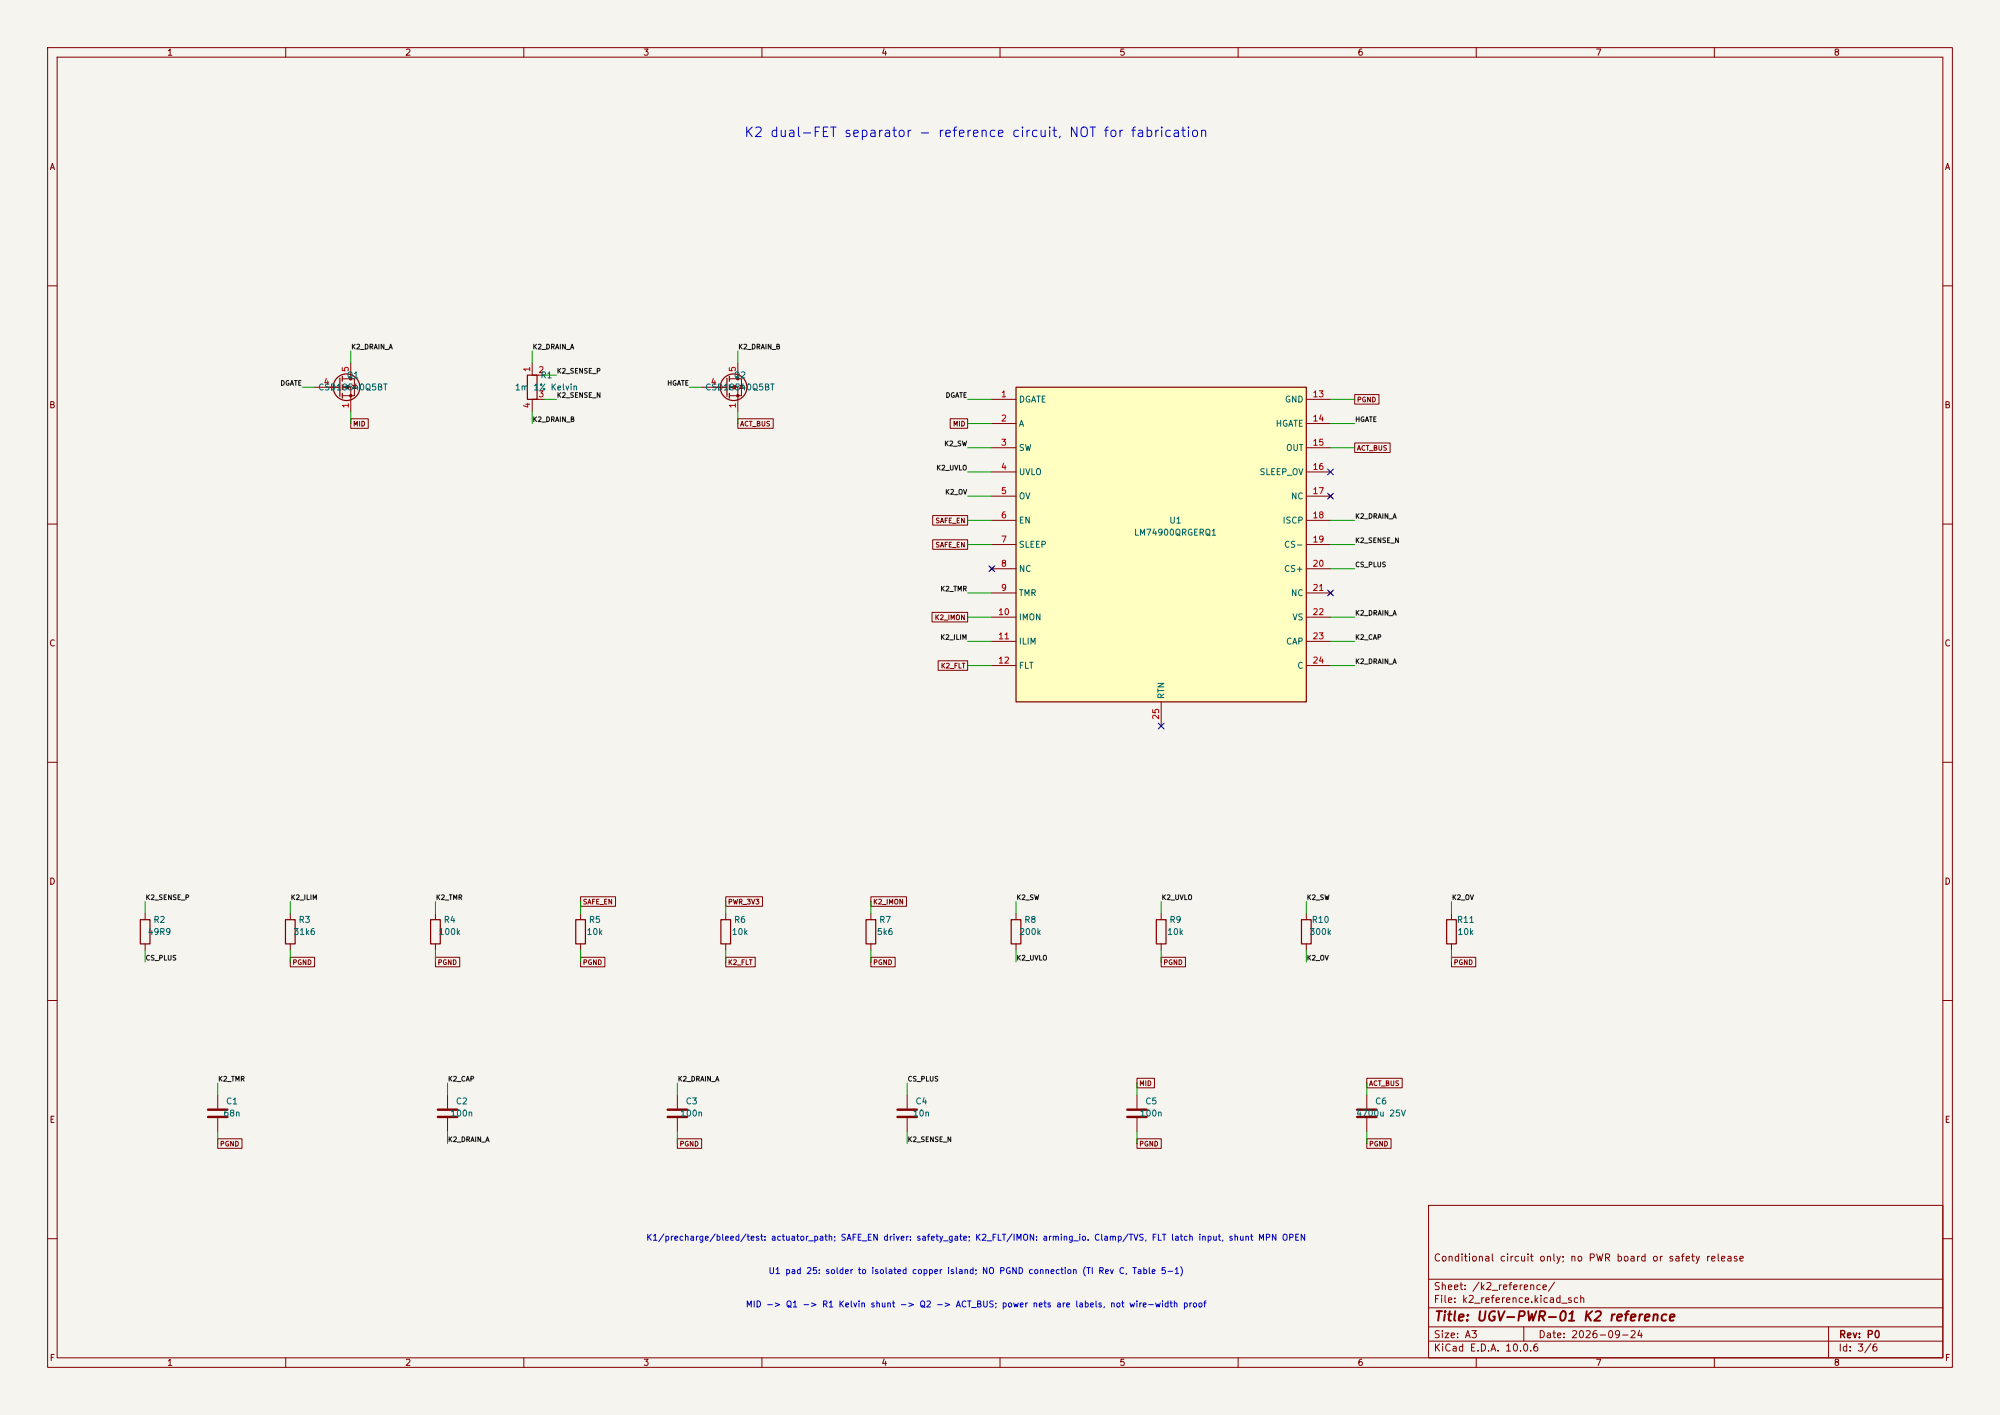
[picture p103: page 3]

K1/precharge/bleed/test: actuator_path; SAFE_EN driver: safety_gate; K2_FLT/IMON: arming_io. Clamp/TVS, FLT latch input, shunt MPN OPEN

Conditional circuit only; no PWR board or safety release

U1 pad 25: solder to isolated copper island; NO PGND connection (TI Rev C, Table 5-1)

Sheet: /k2_reference/
File: k2_reference.kicad_sch
Title: UGV-PWR-01 K2 reference

MID -> Q1 -> R1 Kelvin shunt -> Q2 -> ACT_BUS; power nets are labels, not wire-width proof

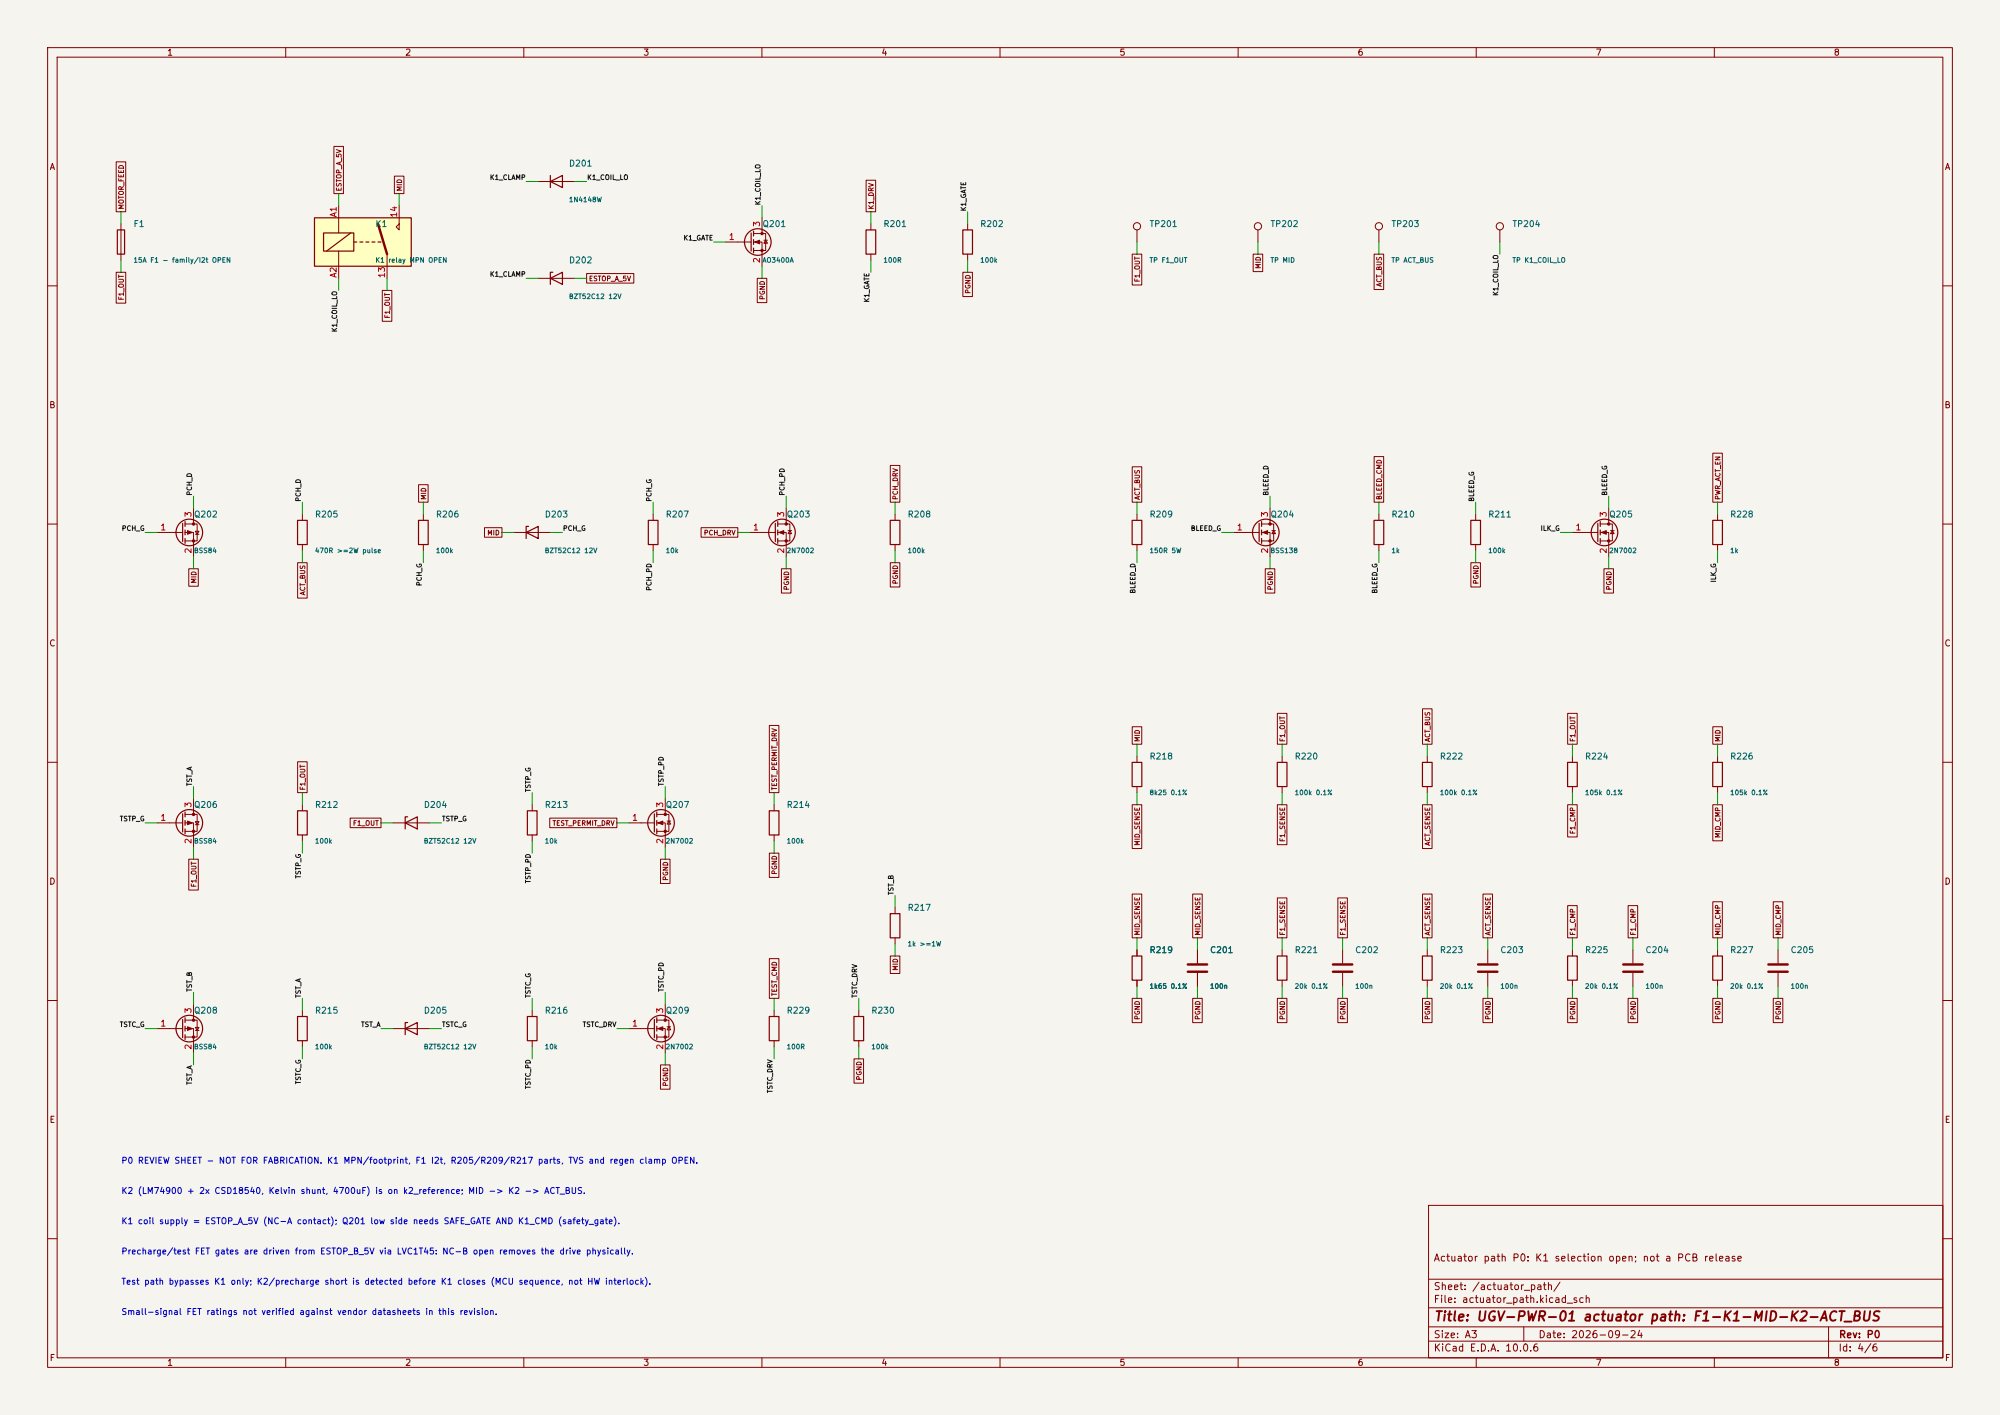
[picture p104: page 4]

TSTP_G Small-signal FET ratings not verified against vendor datasheets in this revision. Test path bypasses K1 only; K2/precharge short is detected before K1 closes (MCU sequence, not HW interlock).

Actuator path P0: K1 selection open; not a PCB release

Sheet: /actuator_path/
File: actuator_path.kicad_sch
Title: UGV-PWR-01 actuator path: F1-K1-MID-K2-ACT_BUS

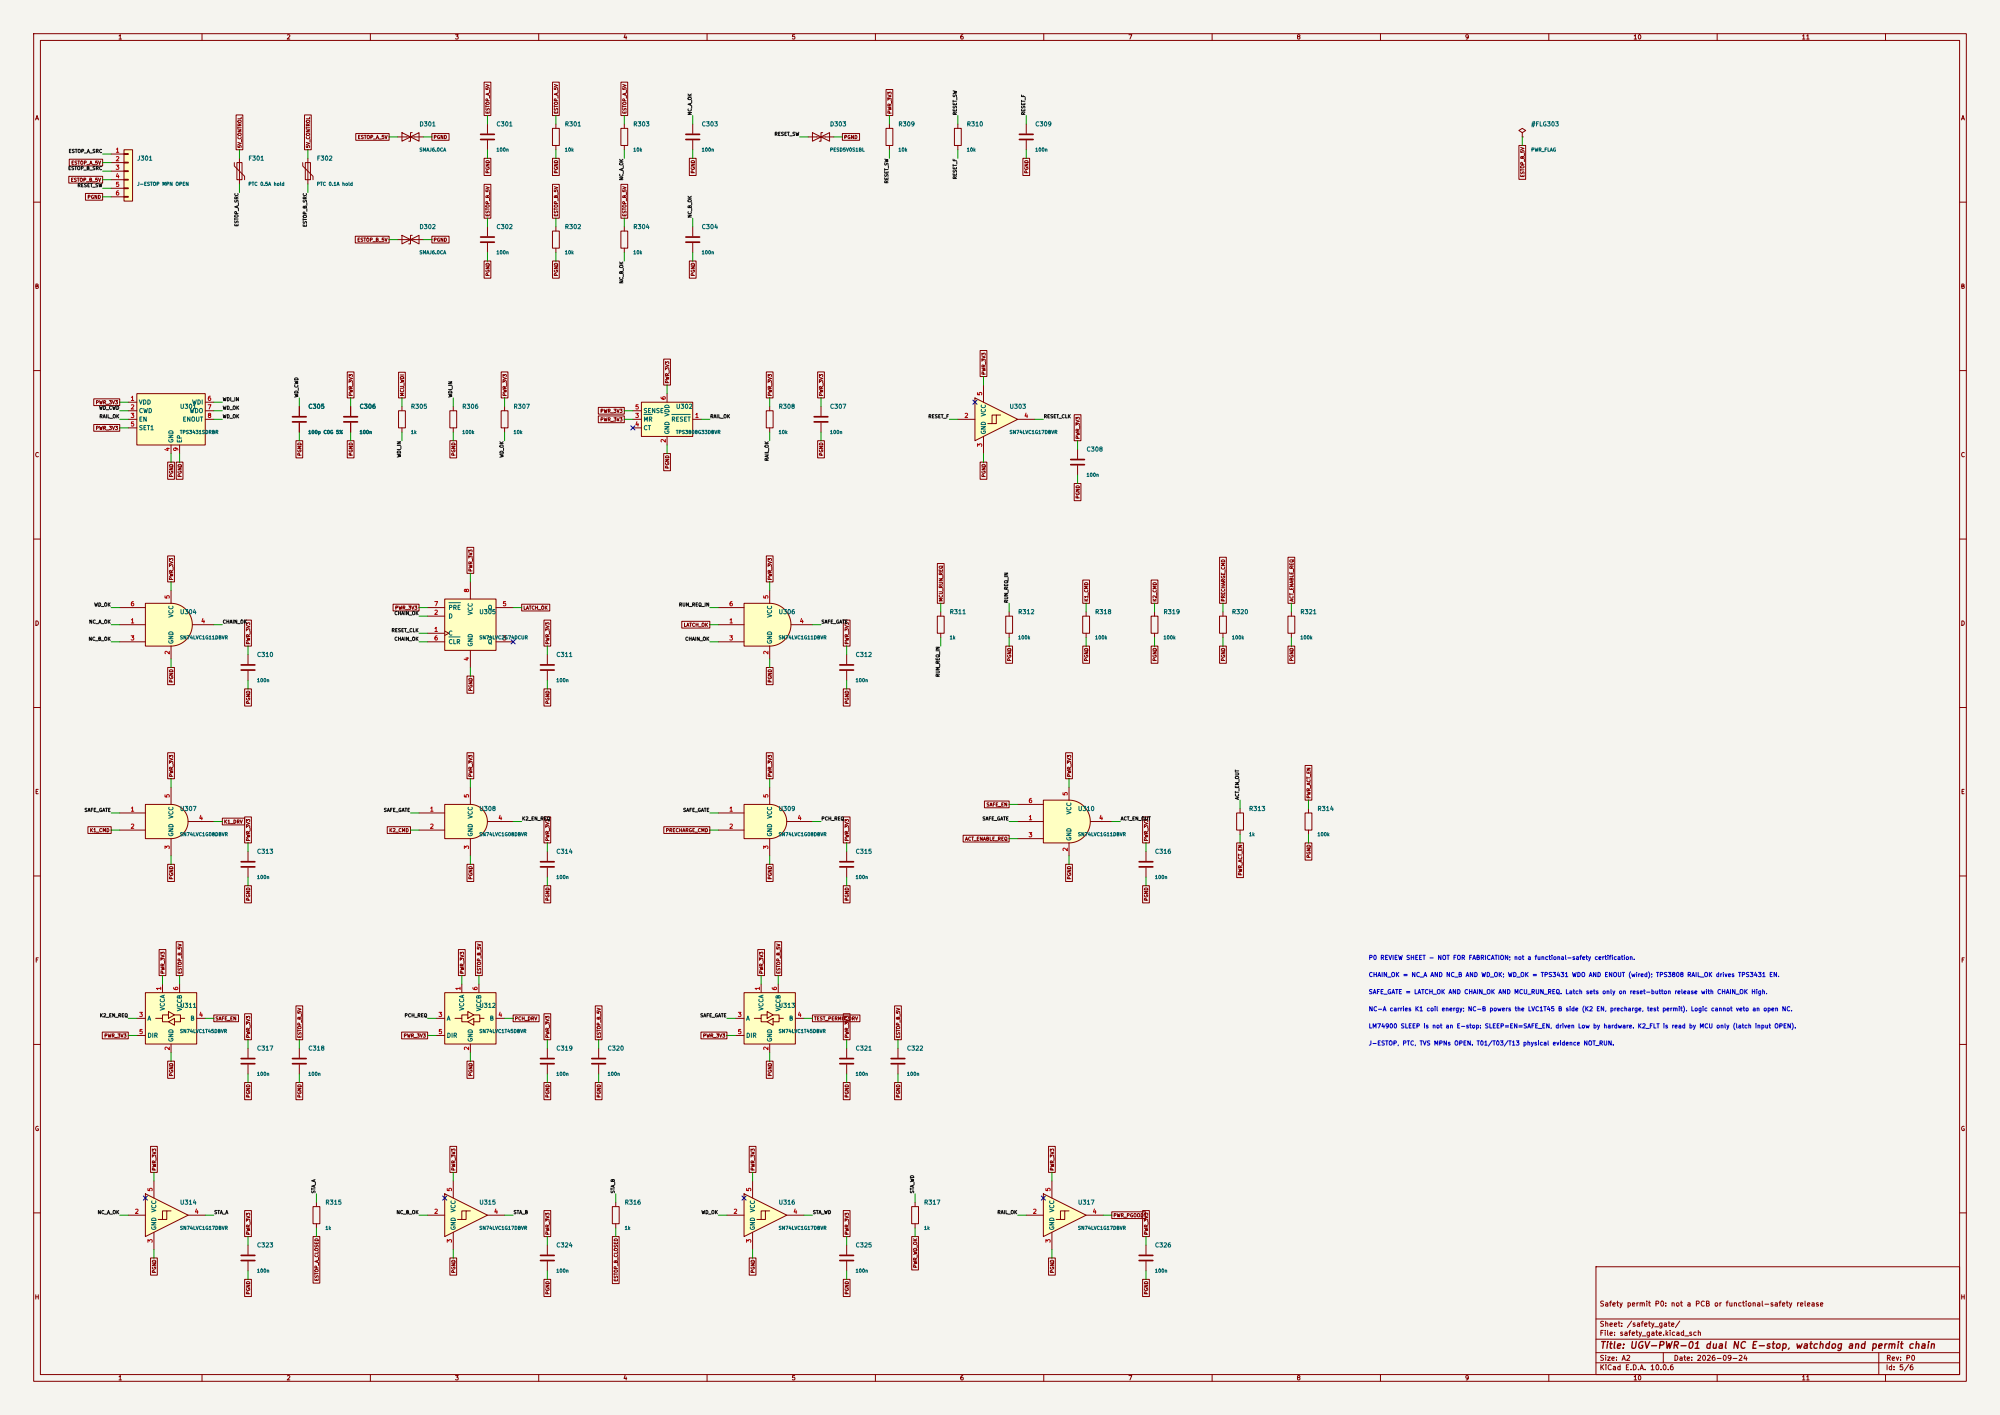
[picture p105: page 5]

J-ESTOP, PTC, TVS MPNs OPEN. T01/T03/T13 physical evidence NOT_RUN.

Safety permit P0: not a PCB or functional-safety release

Sheet: /safety_gate/
File: safety_gate.kicad_sch
Title: UGV-PWR-01 dual NC E-stop, watchdog and permit chain

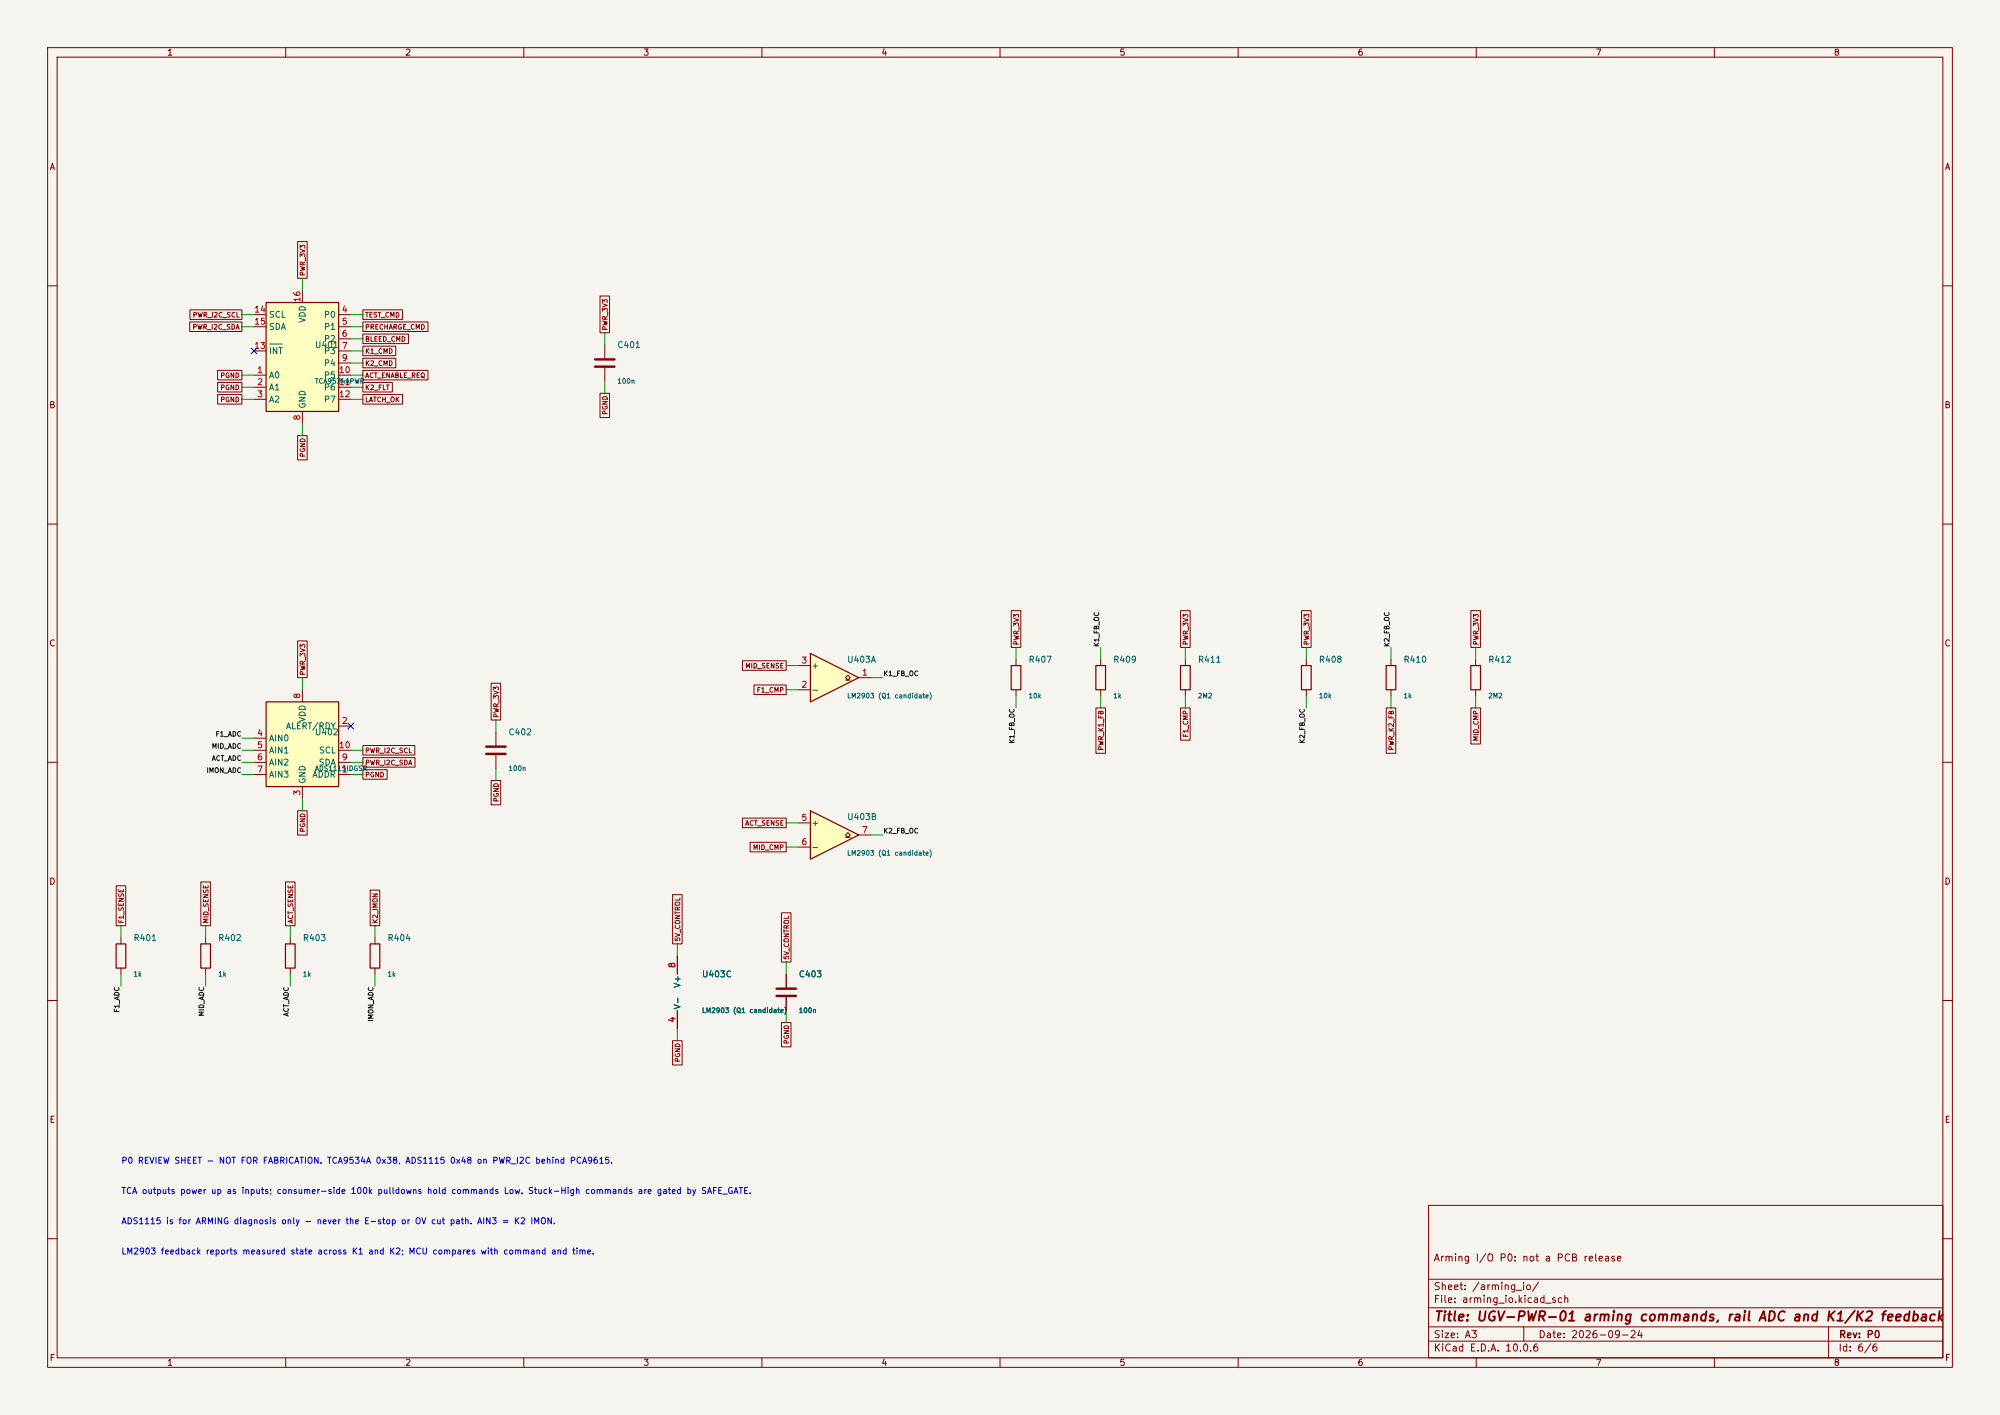
[picture p106: page 6]

Arming I/O P0: not a PCB release +

Sheet: /arming_io/
File: arming_io.kicad_sch
Title: UGV-PWR-01 arming commands, rail ADC and K1/K2 feedback
