efekrkyn/UGV-01/UGV-01/electronics/interconnect/differential_i2c_reference.kicad_sch

## KiCad design UGV-01/electronics/interconnect/differential_i2c_reference.kicad_sch (2026-09-27)

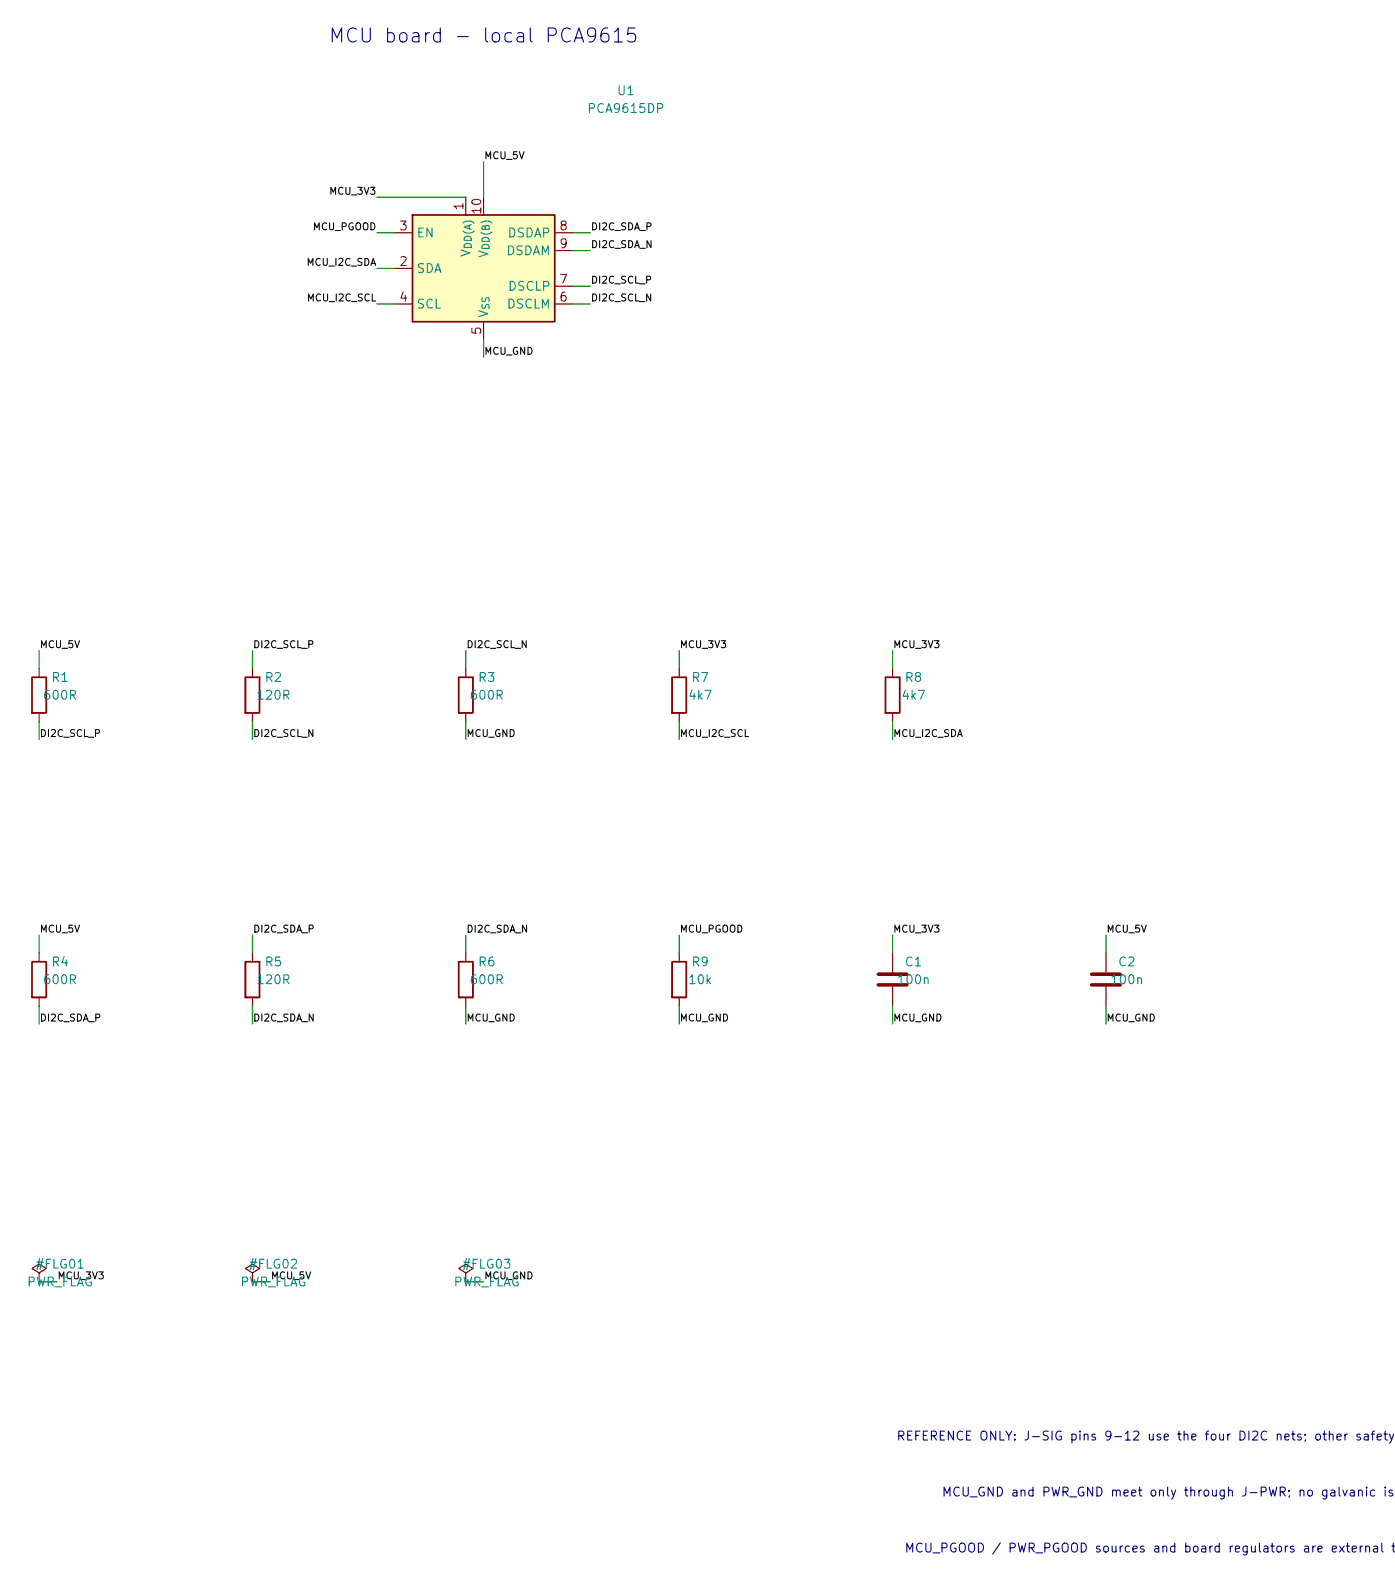
[picture p107: schematic differential_i2c_reference.kicad_sch, part in row 1, column 1]

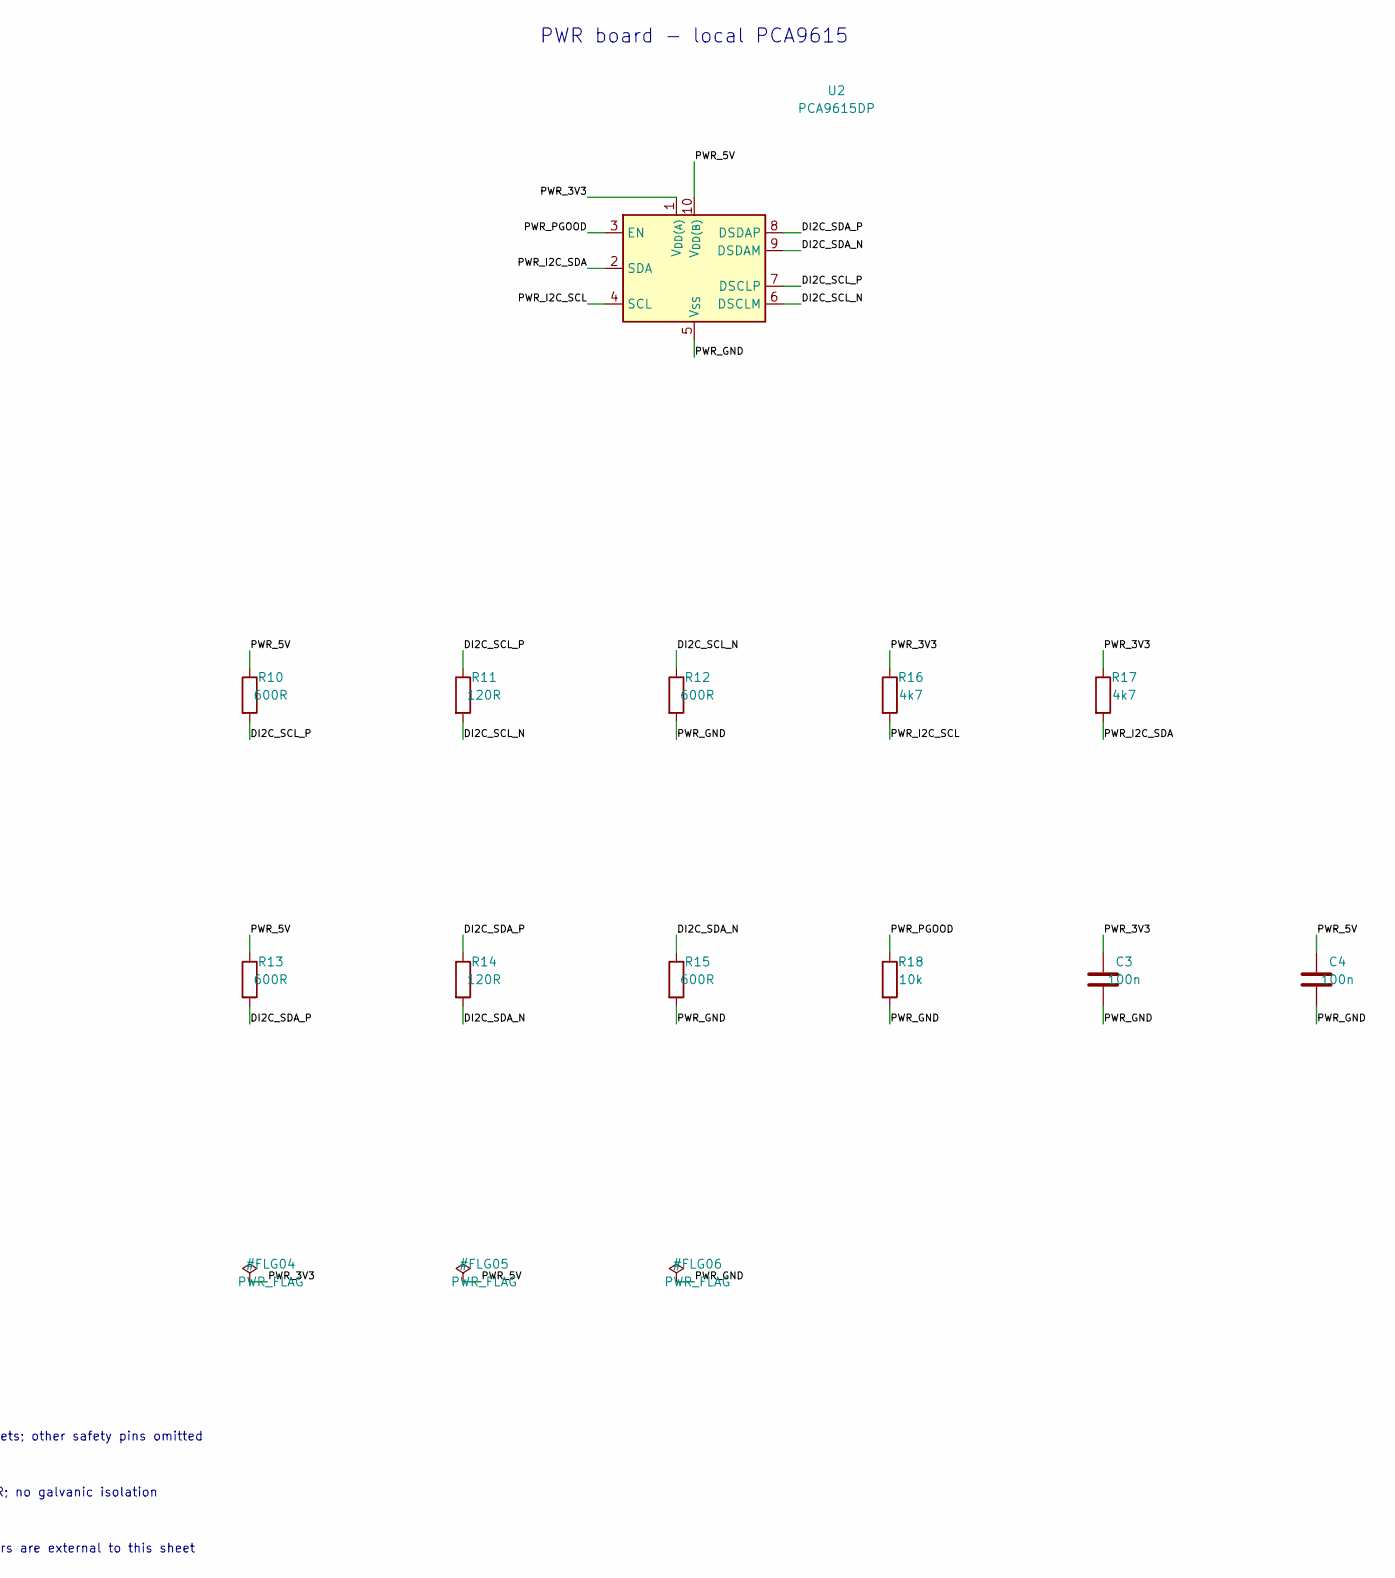
[picture p108: schematic differential_i2c_reference.kicad_sch, part in row 1, column 2]

Parts:
C1, C2, C3, C4: 100n; C_0603_1608Metric
R1, R3, R4, R6, R10, R12, R13, R15: 600R; R_0603_1608Metric
R2, R5, R11, R14: 120R; R_0603_1608Metric
R7, R8, R16, R17: 4k7; R_0603_1608Metric
R9, R18: 10k; R_0603_1608Metric
U1, U2: PCA9615DP; TSSOP-10_3x3mm_P0.5mm

Connections:
DI2C_SCL_N: R2.2, R3.1, R11.2, R12.1, U1.6 (DSCLM), U2.6 (DSCLM)
DI2C_SCL_P: R1.2, R2.1, R10.2, R11.1, U1.7 (DSCLP), U2.7 (DSCLP)
DI2C_SDA_N: R5.2, R6.1, R14.2, R15.1, U1.9 (DSDAM), U2.9 (DSDAM)
DI2C_SDA_P: R4.2, R5.1, R13.2, R14.1, U1.8 (DSDAP), U2.8 (DSDAP)
MCU_3V3: C1.1, R7.1, R8.1, U1.1 (V_{DD(A)})
MCU_5V: C2.1, R1.1, R4.1, U1.10 (V_{DD(B)})
MCU_GND: C1.2, C2.2, R3.2, R6.2, R9.2, U1.5 (V_{SS})
MCU_I2C_SCL: R7.2, U1.4 (SCL)
MCU_I2C_SDA: R8.2, U1.2 (SDA)
MCU_PGOOD: R9.1, U1.3 (EN)
PWR_3V3: C3.1, R16.1, R17.1, U2.1 (V_{DD(A)})
PWR_5V: C4.1, R10.1, R13.1, U2.10 (V_{DD(B)})
PWR_GND: C3.2, C4.2, R12.2, R15.2, R18.2, U2.5 (V_{SS})
PWR_I2C_SCL: R16.2, U2.4 (SCL)
PWR_I2C_SDA: R17.2, U2.2 (SDA)
PWR_PGOOD: R18.1, U2.3 (EN)

Notes on the sheet:
MCU board - local PCA9615
PWR board - local PCA9615
REFERENCE ONLY: J-SIG pins 9-12 use the four DI2C nets; other safety pins omitted
MCU_GND and PWR_GND meet only through J-PWR; no galvanic isolation
MCU_PGOOD / PWR_PGOOD sources and board regulators are external to this sheet
