efekrkyn/UGV-01/UGV-01/electronics/interconnect/pwr_mcu_harness.kicad_sch

## KiCad design UGV-01/electronics/interconnect/pwr_mcu_harness.kicad_sch (2026-09-27)

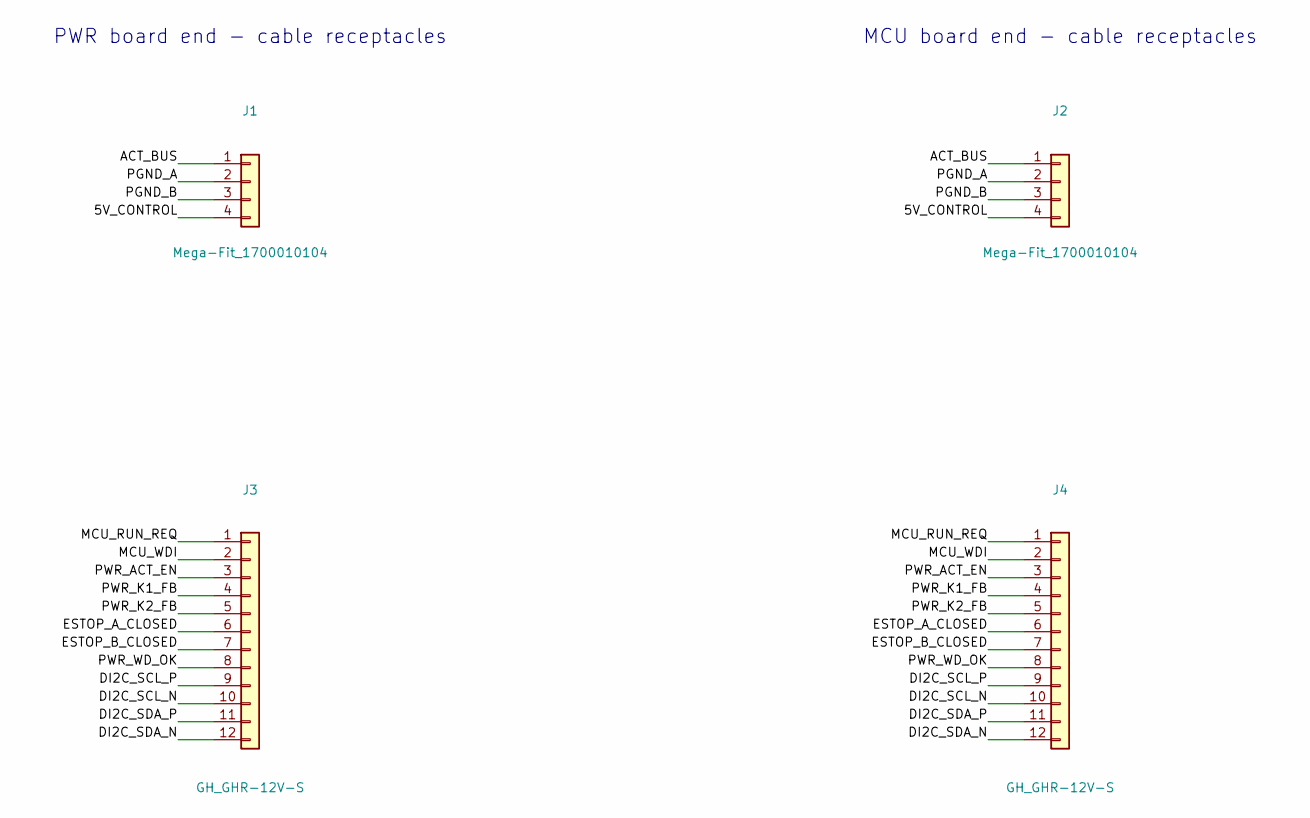
[picture p109: schematic pwr_mcu_harness.kicad_sch]

Parts:
J1, J2: Mega-Fit_1700010104
J3, J4: GH_GHR-12V-S

Connections:
5V_CONTROL: J1.4, J2.4
ACT_BUS: J1.1, J2.1
DI2C_SCL_N: J3.10, J4.10
DI2C_SCL_P: J3.9, J4.9
DI2C_SDA_N: J3.12, J4.12
DI2C_SDA_P: J3.11, J4.11
ESTOP_A_CLOSED: J3.6, J4.6
ESTOP_B_CLOSED: J3.7, J4.7
MCU_RUN_REQ: J3.1, J4.1
MCU_WDI: J3.2, J4.2
PGND_A: J1.2, J2.2
PGND_B: J1.3, J2.3
PWR_ACT_EN: J3.3, J4.3
PWR_K1_FB: J3.4, J4.4
PWR_K2_FB: J3.5, J4.5
PWR_WD_OK: J3.8, J4.8

Notes on the sheet:
PWR board end - cable receptacles
MCU board end - cable receptacles
