efekrkyn/UGV-01/UGV-01/electronics/ugv_lite_01/lite_wiring.kicad_sch

## KiCad design UGV-01/electronics/ugv_lite_01/lite_wiring.kicad_sch (2026-09-27)

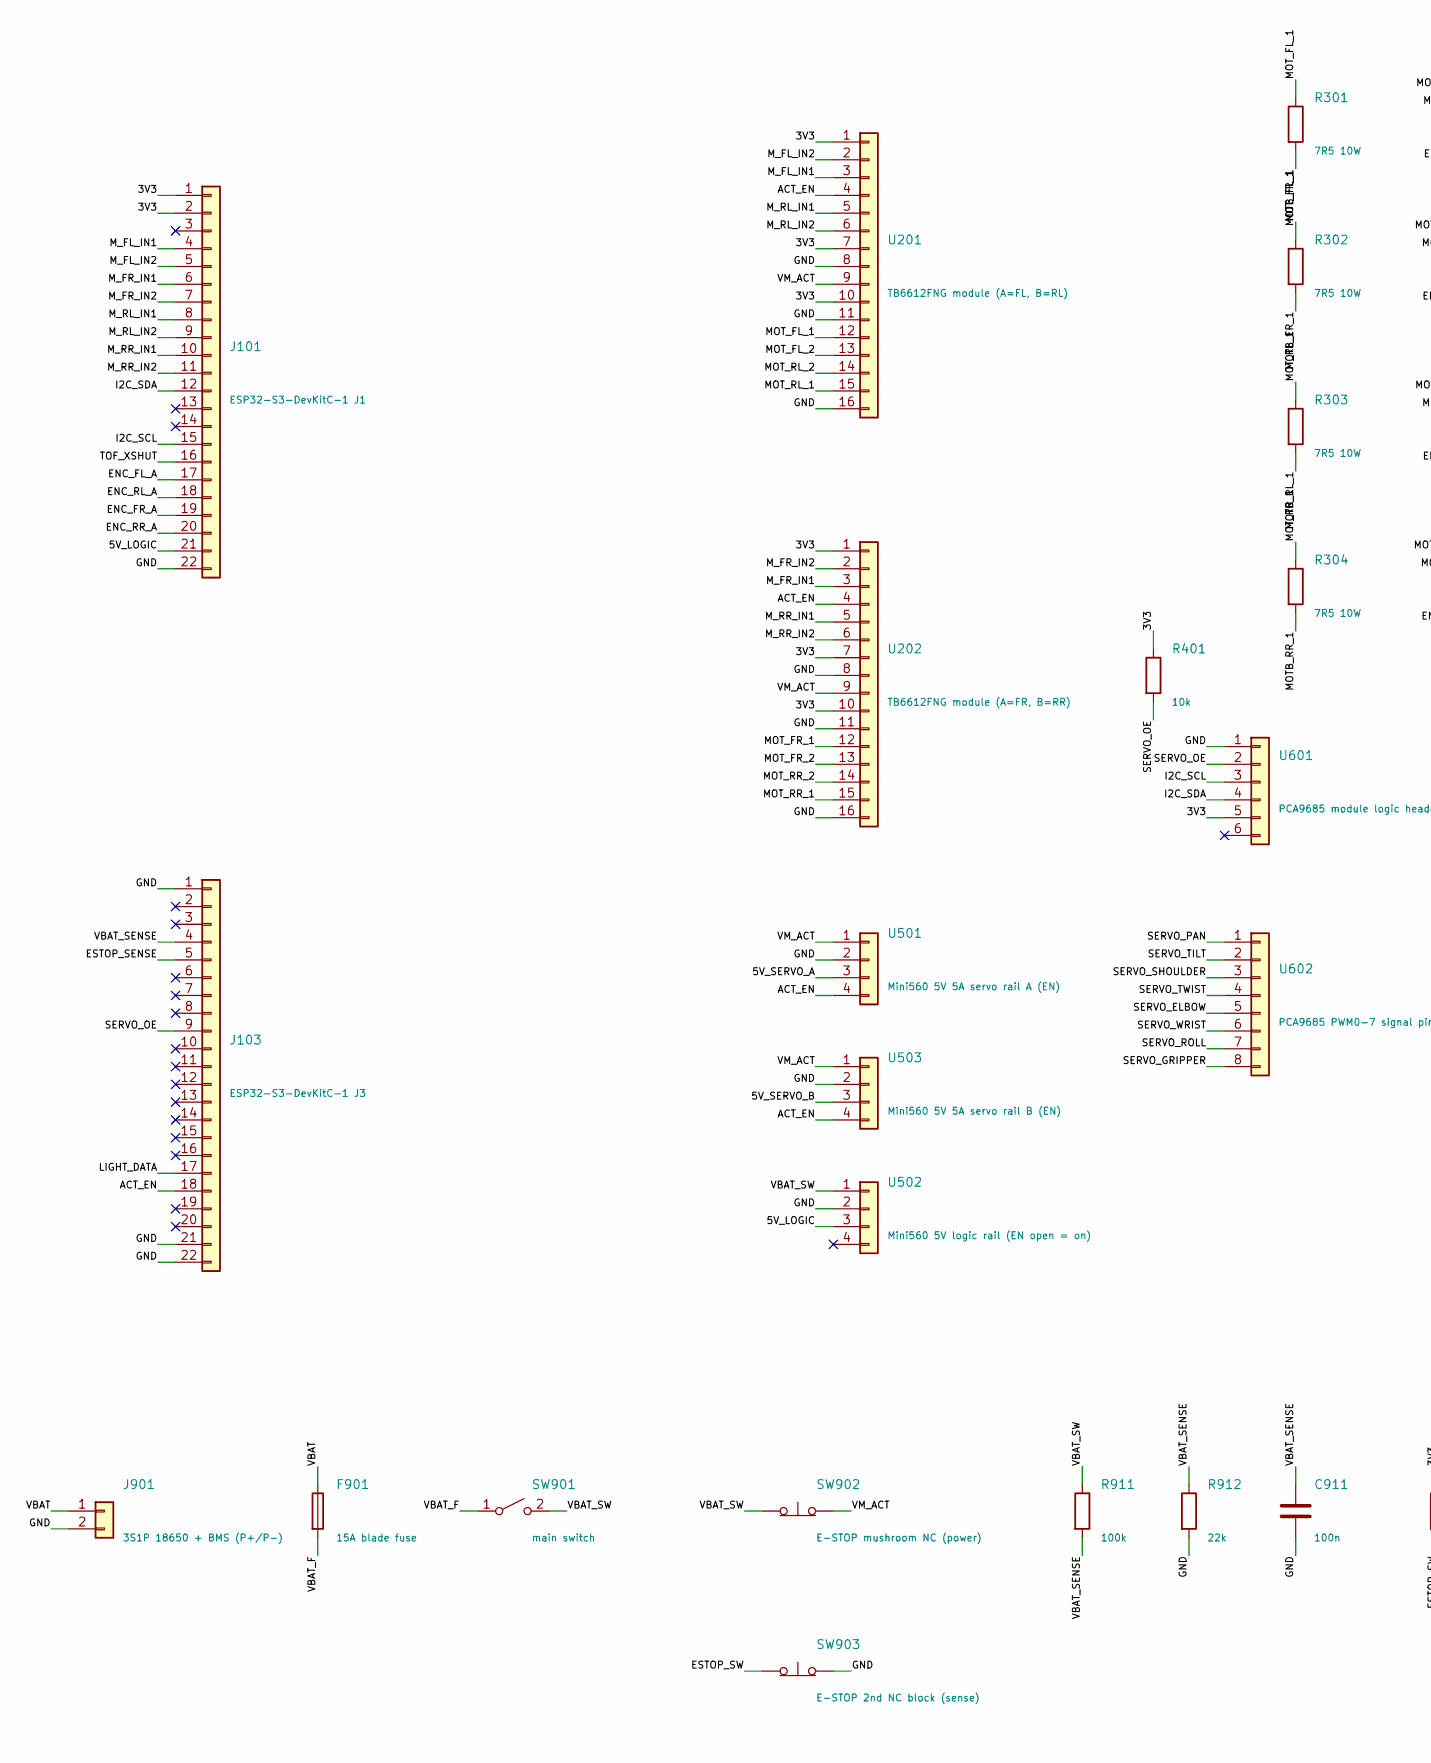
[picture p110: schematic lite_wiring.kicad_sch, part in row 1, column 1]

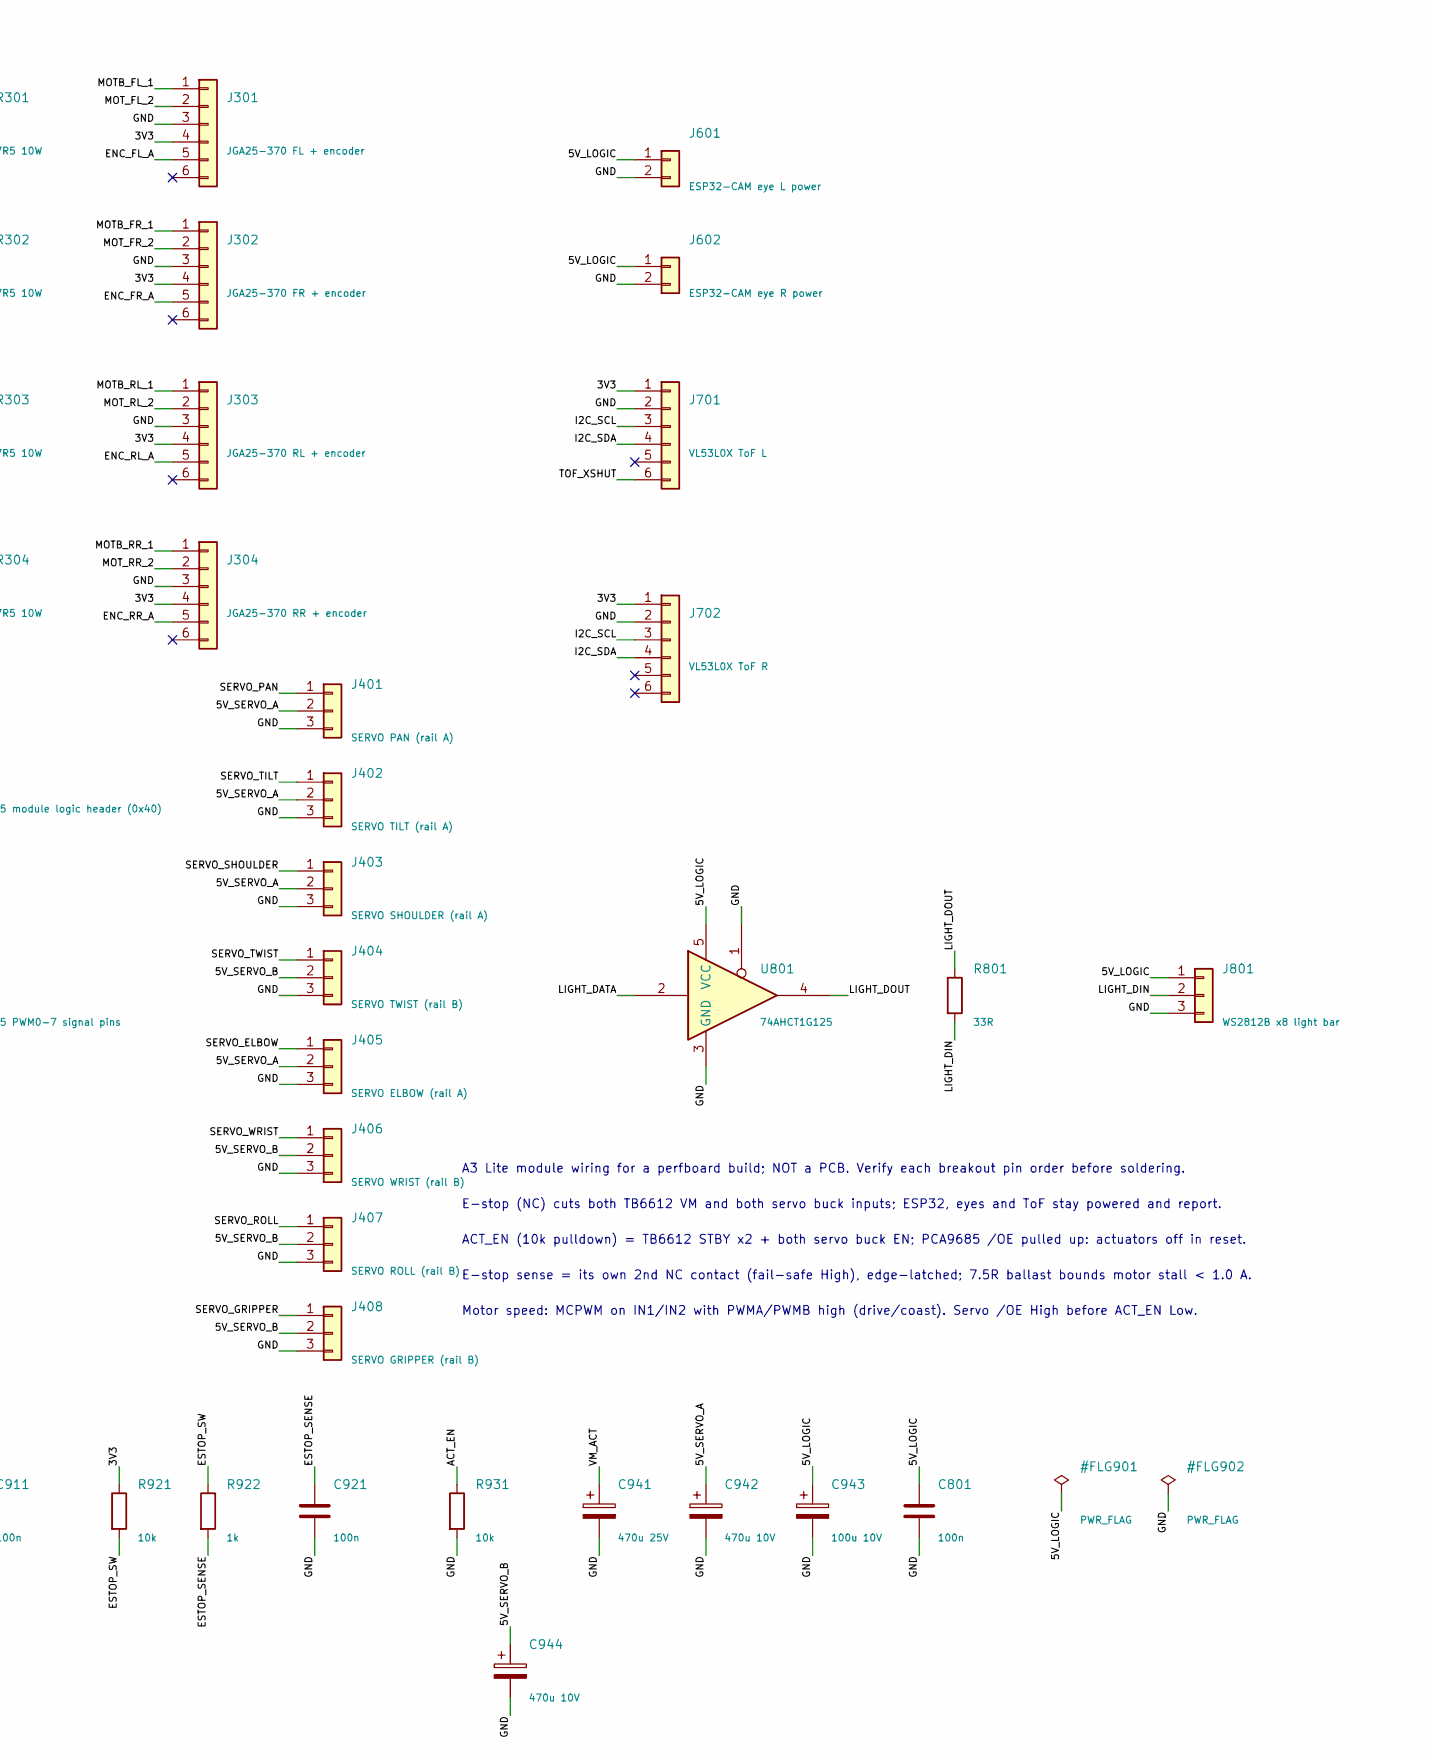
[picture p111: schematic lite_wiring.kicad_sch, part in row 1, column 2]

Parts:
C801, C911, C921: 100n
C941: 470u 25V
C942, C944: 470u 10V
C943: 100u 10V
F901: 15A blade fuse
J101: ESP32-S3-DevKitC-1 J1
J103: ESP32-S3-DevKitC-1 J3
J301: JGA25-370 FL + encoder
J302: JGA25-370 FR + encoder
J303: JGA25-370 RL + encoder
J304: JGA25-370 RR + encoder
J401: SERVO PAN (rail A)
J402: SERVO TILT (rail A)
J403: SERVO SHOULDER (rail A)
J404: SERVO TWIST (rail B)
J405: SERVO ELBOW (rail A)
J406: SERVO WRIST (rail B)
J407: SERVO ROLL (rail B)
J408: SERVO GRIPPER (rail B)
J601: ESP32-CAM eye L power
J602: ESP32-CAM eye R power
J701: VL53L0X ToF L
J702: VL53L0X ToF R
J801: WS2812B x8 light bar
J901: 3S1P 18650 + BMS (P+/P-)
R301, R302, R303, R304: 7R5 10W
R401, R921, R931: 10k
R801: 33R
R911: 100k
R912: 22k
R922: 1k
SW901: main switch
SW902: E-STOP mushroom NC (power)
SW903: E-STOP 2nd NC block (sense)
U201: TB6612FNG module (A=FL, B=RL)
U202: TB6612FNG module (A=FR, B=RR)
U501: Mini560 5V 5A servo rail A (EN)
U502: Mini560 5V logic rail (EN open = on)
U503: Mini560 5V 5A servo rail B (EN)
U601: PCA9685 module logic header (0x40)
U602: PCA9685 PWM0-7 signal pins
U801: 74AHCT1G125; SOT-23-5

Connections:
3V3: J101.1, J101.2, J301.4, J302.4, J303.4, J304.4, J701.1, J702.1, R401.1, R921.1, U201.1, U201.7, U201.10, U202.1, U202.7, U202.10, U601.5
5V_LOGIC: C801.1, C943.1, J101.21, J601.1, J602.1, J801.1, U502.3, U801.5 (VCC)
5V_SERVO_A: C942.1, J401.2, J402.2, J403.2, J405.2, U501.3
5V_SERVO_B: C944.1, J404.2, J406.2, J407.2, J408.2, U503.3
ACT_EN: J103.18, R931.1, U201.4, U202.4, U501.4, U503.4
ENC_FL_A: J101.17, J301.5
ENC_FR_A: J101.19, J302.5
ENC_RL_A: J101.18, J303.5
ENC_RR_A: J101.20, J304.5
ESTOP_SENSE: C921.1, J103.5, R922.2
ESTOP_SW: R921.2, R922.1, SW903.1 (A)
GND: C801.2, C911.2, C921.2, C941.2, C942.2, C943.2, C944.2, J101.22, J103.1, J103.21, J103.22, J301.3, J302.3, J303.3, J304.3, J401.3, J402.3, J403.3, J404.3, J405.3, J406.3, J407.3, J408.3, J601.2, J602.2, J701.2, J702.2, J801.3, J901.2, R912.2, R931.2, SW903.2 (B), U201.8, U201.11, U201.16, U202.8, U202.11, U202.16, U501.2, U502.2, U503.2, U601.1, U801.1, U801.3 (GND)
I2C_SCL: J101.15, J701.3, J702.3, U601.3
I2C_SDA: J101.12, J701.4, J702.4, U601.4
LIGHT_DATA: J103.17, U801.2
LIGHT_DIN: J801.2, R801.2
LIGHT_DOUT: R801.1, U801.4
MOTB_FL_1: J301.1, R301.2
MOTB_FR_1: J302.1, R302.2
MOTB_RL_1: J303.1, R303.2
MOTB_RR_1: J304.1, R304.2
MOT_FL_1: R301.1, U201.12
MOT_FL_2: J301.2, U201.13
MOT_FR_1: R302.1, U202.12
MOT_FR_2: J302.2, U202.13
MOT_RL_1: R303.1, U201.15
MOT_RL_2: J303.2, U201.14
MOT_RR_1: R304.1, U202.15
MOT_RR_2: J304.2, U202.14
M_FL_IN1: J101.4, U201.3
M_FL_IN2: J101.5, U201.2
M_FR_IN1: J101.6, U202.3
M_FR_IN2: J101.7, U202.2
M_RL_IN1: J101.8, U201.5
M_RL_IN2: J101.9, U201.6
M_RR_IN1: J101.10, U202.5
M_RR_IN2: J101.11, U202.6
SERVO_ELBOW: J405.1, U602.5
SERVO_GRIPPER: J408.1, U602.8
SERVO_OE: J103.9, R401.2, U601.2
SERVO_PAN: J401.1, U602.1
SERVO_ROLL: J407.1, U602.7
SERVO_SHOULDER: J403.1, U602.3
SERVO_TILT: J402.1, U602.2
SERVO_TWIST: J404.1, U602.4
SERVO_WRIST: J406.1, U602.6
TOF_XSHUT: J101.16, J701.6
VBAT: F901.1, J901.1
VBAT_F: F901.2, SW901.1 (A)
VBAT_SENSE: C911.1, J103.4, R911.2, R912.1
VBAT_SW: R911.1, SW901.2 (B), SW902.1 (A), U502.1
VM_ACT: C941.1, SW902.2 (B), U201.9, U202.9, U501.1, U503.1

Notes on the sheet:
A3 Lite module wiring for a perfboard build; NOT a PCB. Verify each breakout pin order before soldering.
E-stop (NC) cuts both TB6612 VM and both servo buck inputs; ESP32, eyes and ToF stay powered and report.
ACT_EN (10k pulldown) = TB6612 STBY x2 + both servo buck EN; PCA9685 /OE pulled up: actuators off in reset.
E-stop sense = its own 2nd NC contact (fail-safe High), edge-latched; 7.5R ballast bounds motor stall < 1.0 A.
Motor speed: MCPWM on IN1/IN2 with PWMA/PWMB high (drive/coast). Servo /OE High before ACT_EN Low.
