efekrkyn/UGV-01/UGV-01/electronics/ugv_mcu_01/pwr_mcu_interface.kicad_sch

## KiCad design UGV-01/electronics/ugv_mcu_01/pwr_mcu_interface.kicad_sch (2026-09-27)

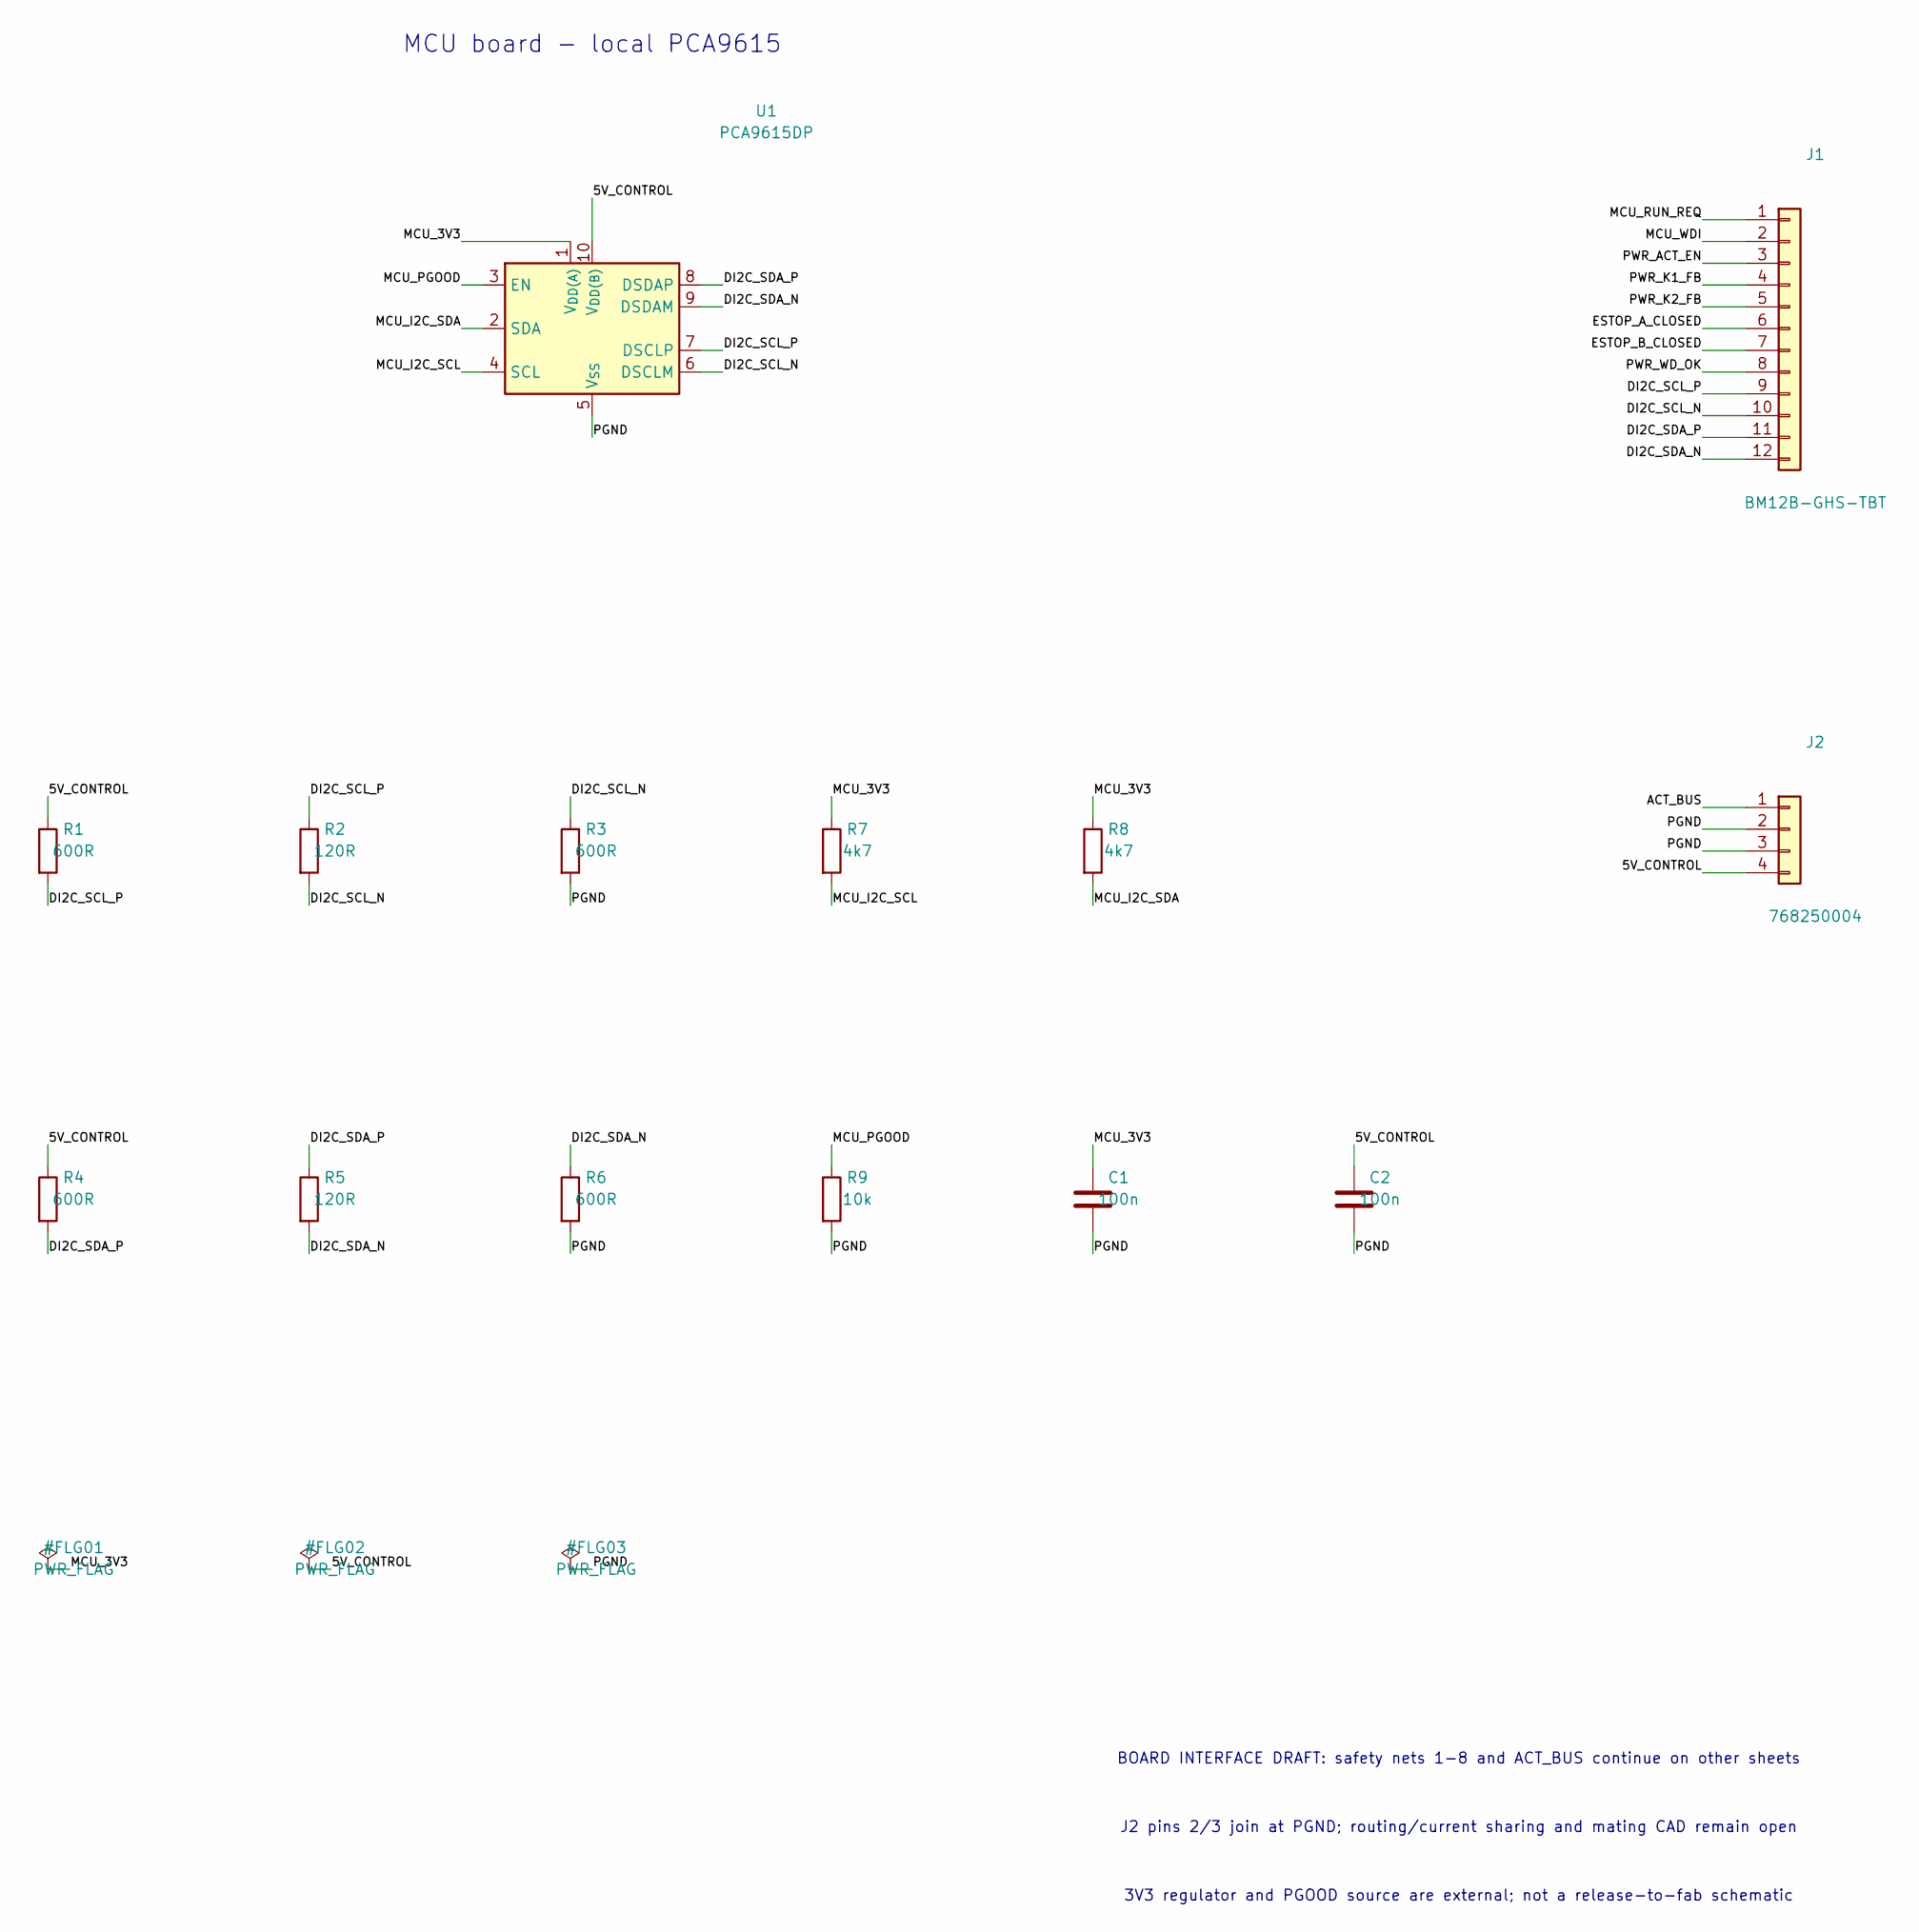
[picture p112: schematic pwr_mcu_interface.kicad_sch]

Parts:
C1, C2: 100n; C_0603_1608Metric
J1: BM12B-GHS-TBT; JST_GH_BM12B-GHS-TBT_1x12-1MP_P1.25mm_Vertical
J2: 768250004; Molex_Mega-Fit_76825-0004_2x02_P5.70mm_Horizontal
R1, R3, R4, R6: 600R; R_0603_1608Metric
R2, R5: 120R; R_0603_1608Metric
R7, R8: 4k7; R_0603_1608Metric
R9: 10k; R_0603_1608Metric
U1: PCA9615DP; TSSOP-10_3x3mm_P0.5mm

Connections:
5V_CONTROL: C2.1, J2.4, R1.1, R4.1, U1.10 (V_{DD(B)})
ACT_BUS: J2.1
DI2C_SCL_N: J1.10, R2.2, R3.1, U1.6 (DSCLM)
DI2C_SCL_P: J1.9, R1.2, R2.1, U1.7 (DSCLP)
DI2C_SDA_N: J1.12, R5.2, R6.1, U1.9 (DSDAM)
DI2C_SDA_P: J1.11, R4.2, R5.1, U1.8 (DSDAP)
ESTOP_A_CLOSED: J1.6
ESTOP_B_CLOSED: J1.7
MCU_3V3: C1.1, R7.1, R8.1, U1.1 (V_{DD(A)})
MCU_I2C_SCL: R7.2, U1.4 (SCL)
MCU_I2C_SDA: R8.2, U1.2 (SDA)
MCU_PGOOD: R9.1, U1.3 (EN)
MCU_RUN_REQ: J1.1
MCU_WDI: J1.2
PGND: C1.2, C2.2, J2.2, J2.3, R3.2, R6.2, R9.2, U1.5 (V_{SS})
PWR_ACT_EN: J1.3
PWR_K1_FB: J1.4
PWR_K2_FB: J1.5
PWR_WD_OK: J1.8

Notes on the sheet:
MCU board - local PCA9615
BOARD INTERFACE DRAFT: safety nets 1-8 and ACT_BUS continue on other sheets
J2 pins 2/3 join at PGND; routing/current sharing and mating CAD remain open
3V3 regulator and PGOOD source are external; not a release-to-fab schematic
