efekrkyn/UGV-01/UGV-01/electronics/ugv_mcu_01/servo_light.kicad_sch

## KiCad design UGV-01/electronics/ugv_mcu_01/servo_light.kicad_sch (2026-09-27)

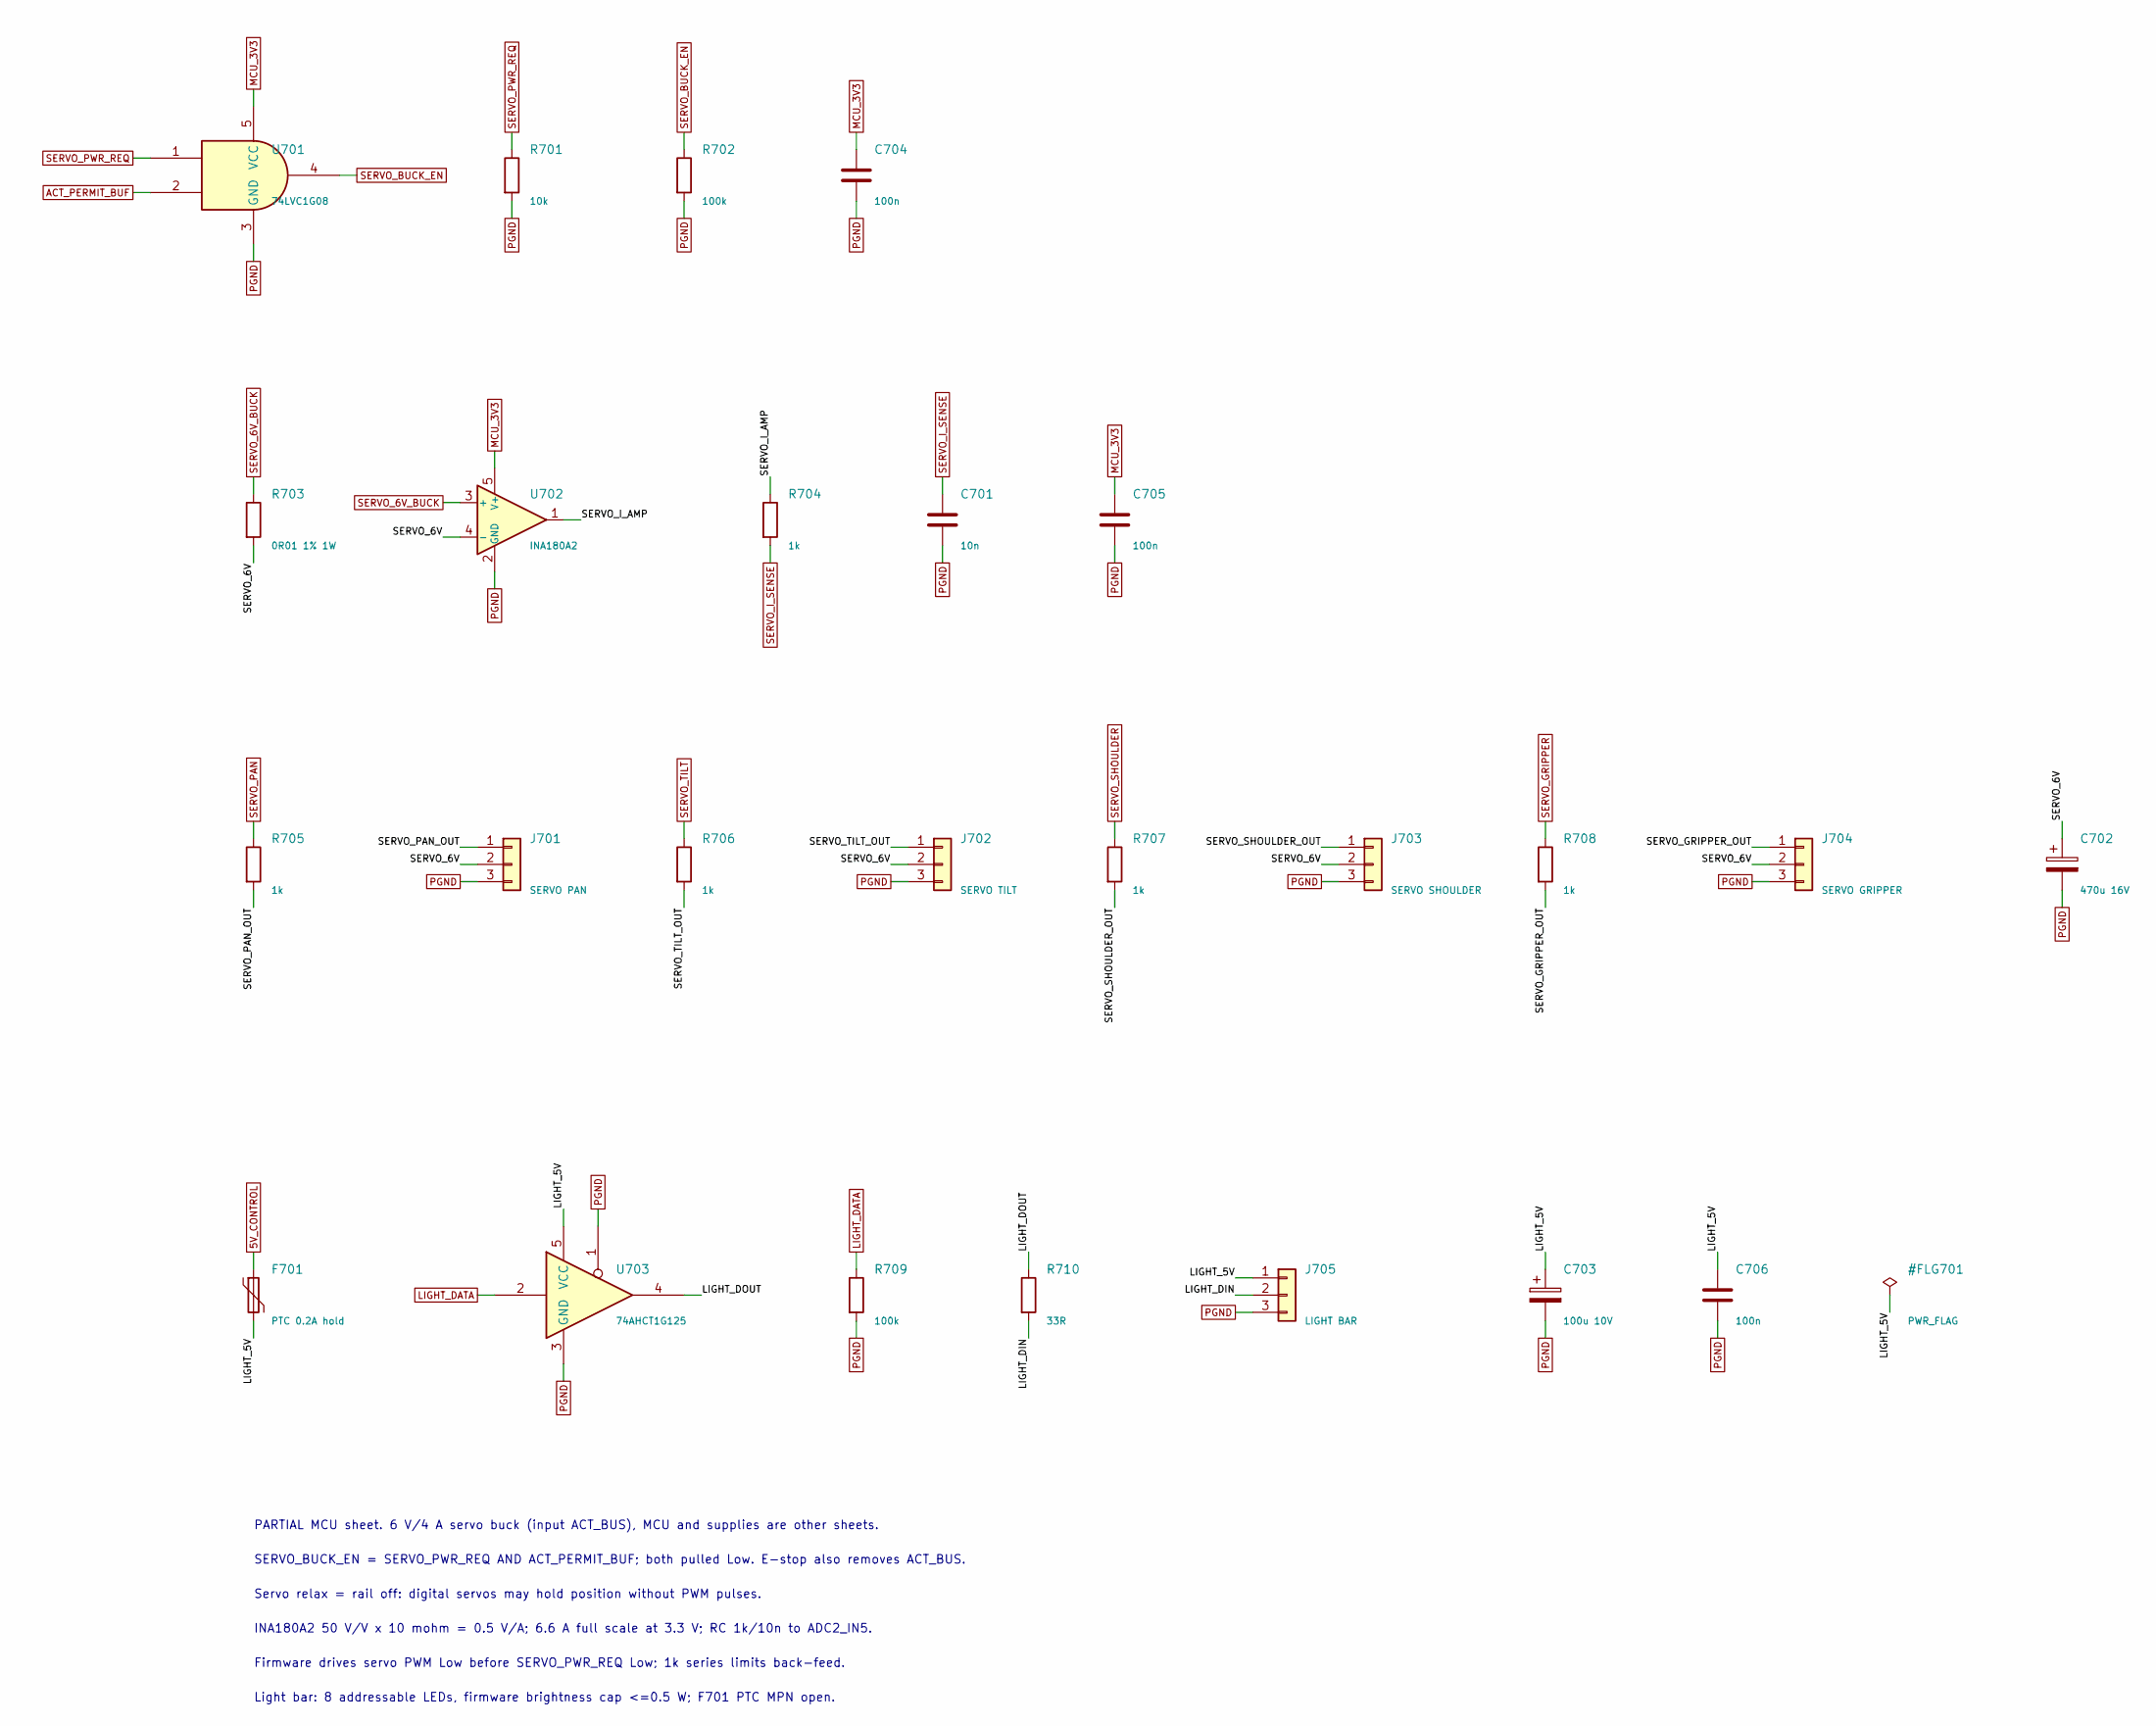
[picture p113: schematic servo_light.kicad_sch]

Parts:
C701: 10n; C_0603_1608Metric
C702: 470u 16V; CP_Elec_8x10
C703: 100u 10V; CP_Elec_6.3x7.7
C704, C705, C706: 100n; C_0603_1608Metric
F701: PTC 0.2A hold; Fuse_1206_3216Metric
J701: SERVO PAN; PinHeader_1x03_P2.54mm_Vertical
J702: SERVO TILT; PinHeader_1x03_P2.54mm_Vertical
J703: SERVO SHOULDER; PinHeader_1x03_P2.54mm_Vertical
J704: SERVO GRIPPER; PinHeader_1x03_P2.54mm_Vertical
J705: LIGHT BAR; JST_PH_B3B-PH-K_1x03_P2.00mm_Vertical
R701: 10k; R_0603_1608Metric
R702, R709: 100k; R_0603_1608Metric
R703: 0R01 1% 1W; R_2512_6332Metric
R704, R705, R706, R707, R708: 1k; R_0603_1608Metric
R710: 33R; R_0603_1608Metric
U701: 74LVC1G08; SOT-23-5
U702: INA180A2; SOT-23-5
U703: 74AHCT1G125; SOT-23-5

Connections:
5V_CONTROL: F701.1
ACT_PERMIT_BUF: U701.2
LIGHT_5V: C703.1, C706.1, F701.2, J705.1, U703.5 (VCC)
LIGHT_DATA: R709.1, U703.2
LIGHT_DIN: J705.2, R710.2
LIGHT_DOUT: R710.1, U703.4
MCU_3V3: C704.1, C705.1, U701.5 (VCC), U702.5 (V+)
PGND: C701.2, C702.2, C703.2, C704.2, C705.2, C706.2, J701.3, J702.3, J703.3, J704.3, J705.3, R701.2, R702.2, R709.2, U701.3 (GND), U702.2 (GND), U703.1, U703.3 (GND)
SERVO_6V: C702.1, J701.2, J702.2, J703.2, J704.2, R703.2, U702.4 (-)
SERVO_6V_BUCK: R703.1, U702.3 (+)
SERVO_BUCK_EN: R702.1, U701.4
SERVO_GRIPPER: R708.1
SERVO_GRIPPER_OUT: J704.1, R708.2
SERVO_I_AMP: R704.1, U702.1
SERVO_I_SENSE: C701.1, R704.2
SERVO_PAN: R705.1
SERVO_PAN_OUT: J701.1, R705.2
SERVO_PWR_REQ: R701.1, U701.1
SERVO_SHOULDER: R707.1
SERVO_SHOULDER_OUT: J703.1, R707.2
SERVO_TILT: R706.1
SERVO_TILT_OUT: J702.1, R706.2

Notes on the sheet:
PARTIAL MCU sheet. 6 V/4 A servo buck (input ACT_BUS), MCU and supplies are other sheets.
SERVO_BUCK_EN = SERVO_PWR_REQ AND ACT_PERMIT_BUF; both pulled Low. E-stop also removes ACT_BUS.
Servo relax = rail off: digital servos may hold position without PWM pulses.
INA180A2 50 V/V x 10 mohm = 0.5 V/A; 6.6 A full scale at 3.3 V; RC 1k/10n to ADC2_IN5.
Firmware drives servo PWM Low before SERVO_PWR_REQ Low; 1k series limits back-feed.
Light bar: 8 addressable LEDs, firmware brightness cap <=0.5 W; F701 PTC MPN open.
