efekrkyn/UGV-01/UGV-01/electronics/ugv_mcu_01/status_receiver.kicad_sch

## KiCad design UGV-01/electronics/ugv_mcu_01/status_receiver.kicad_sch (2026-09-27)

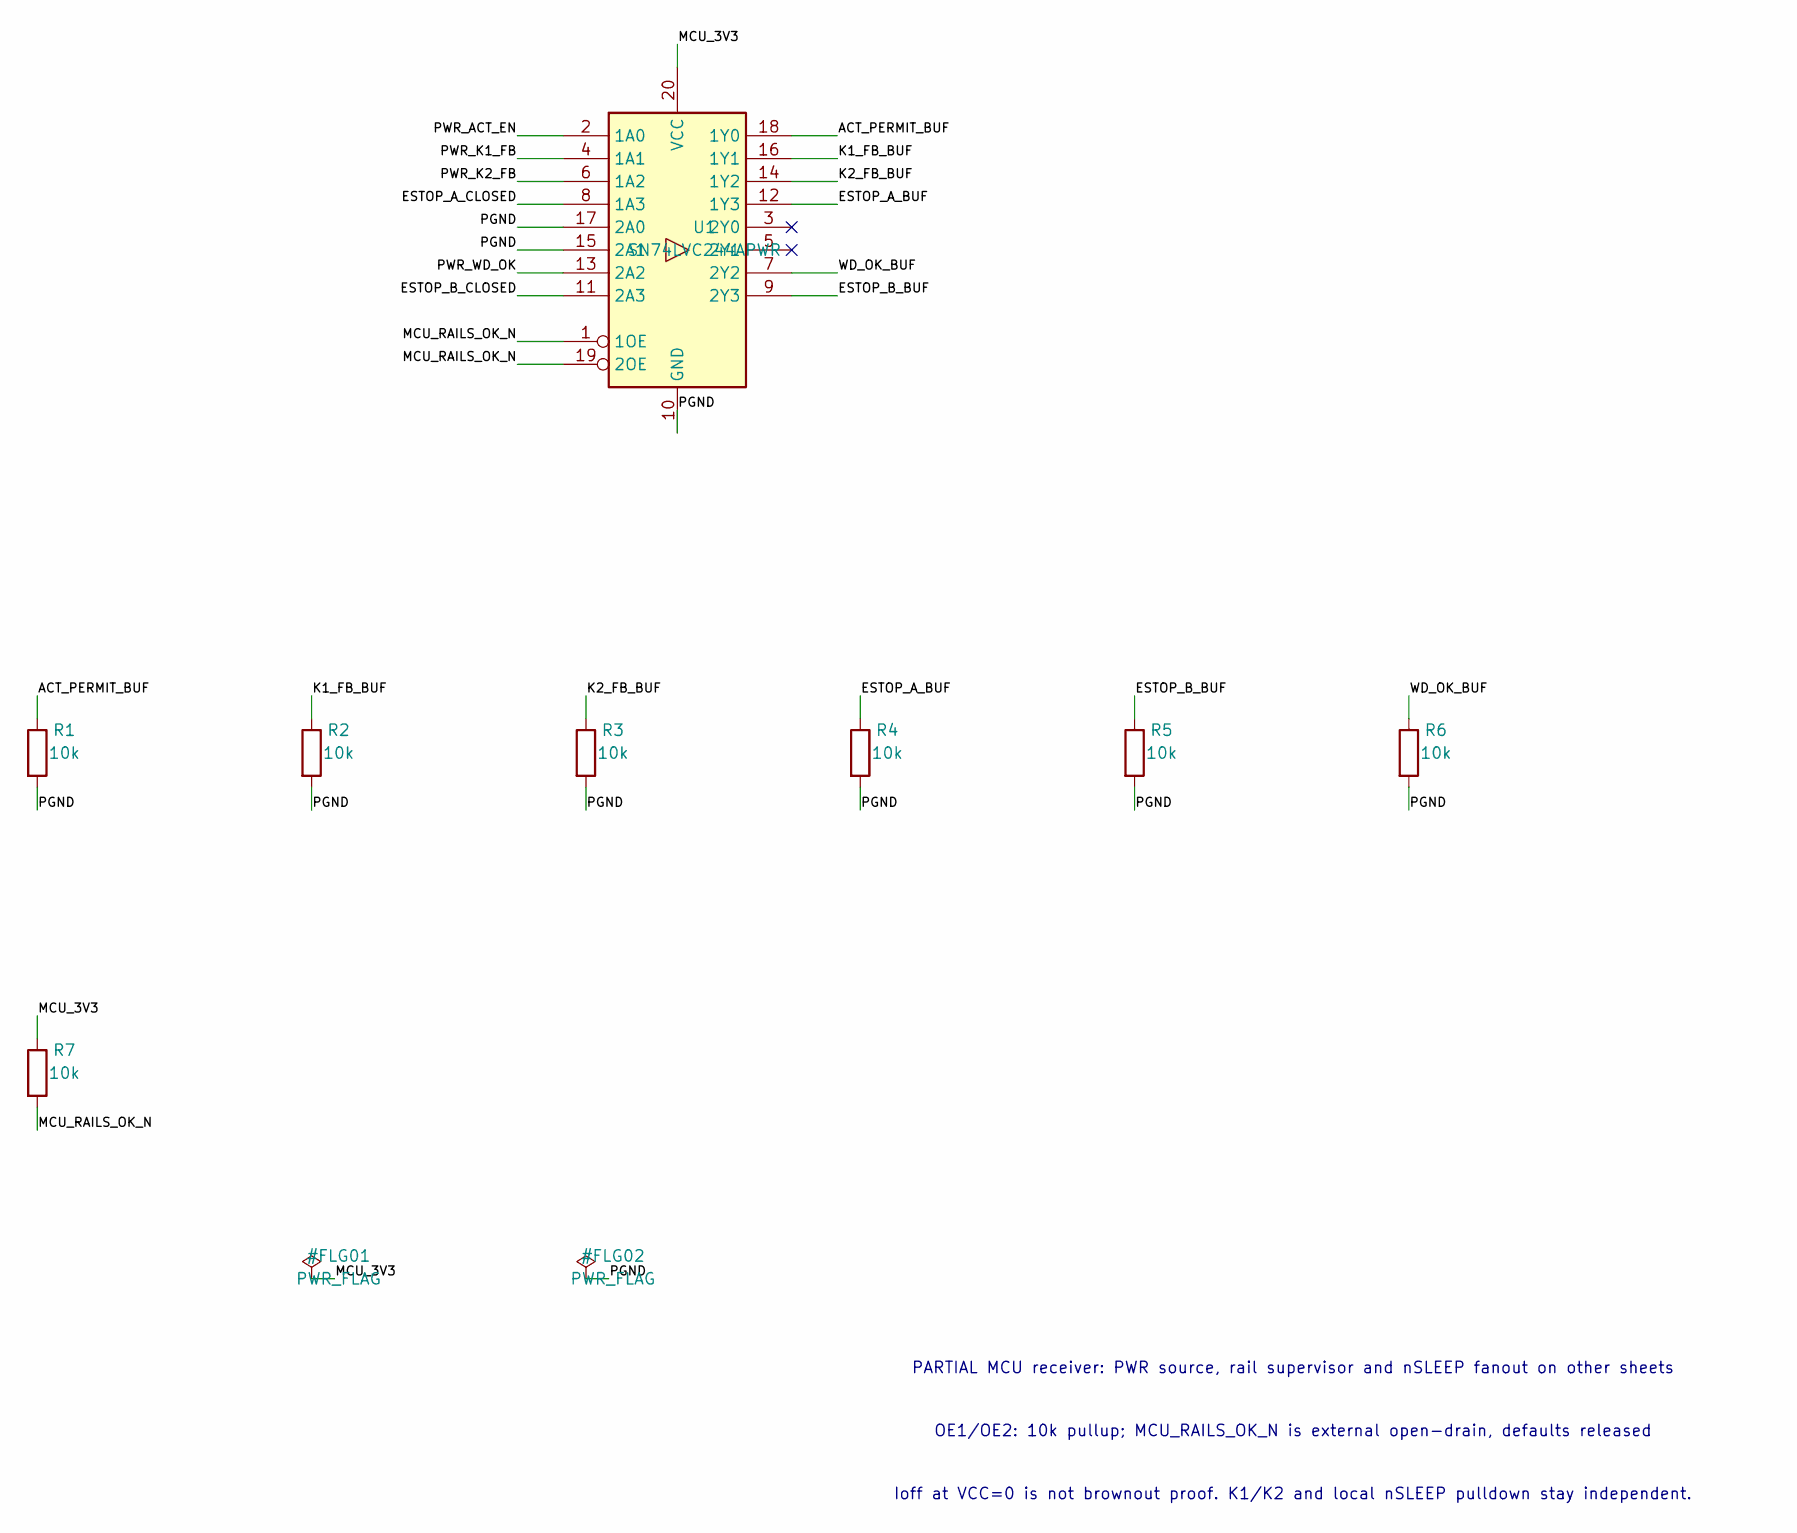
[picture p114: schematic status_receiver.kicad_sch]

Parts:
R1, R2, R3, R4, R5, R6, R7: 10k; R_0603_1608Metric
U1: SN74LVC244APWR; TSSOP-20_4.4x6.5mm_P0.65mm

Connections:
ACT_PERMIT_BUF: R1.1, U1.18 (1Y0)
ESTOP_A_BUF: R4.1, U1.12 (1Y3)
ESTOP_A_CLOSED: U1.8 (1A3)
ESTOP_B_BUF: R5.1, U1.9 (2Y3)
ESTOP_B_CLOSED: U1.11 (2A3)
K1_FB_BUF: R2.1, U1.16 (1Y1)
K2_FB_BUF: R3.1, U1.14 (1Y2)
MCU_3V3: R7.1, U1.20 (VCC)
MCU_RAILS_OK_N: R7.2, U1.1 (1OE), U1.19 (2OE)
PGND: R1.2, R2.2, R3.2, R4.2, R5.2, R6.2, U1.10 (GND), U1.15 (2A1), U1.17 (2A0)
PWR_ACT_EN: U1.2 (1A0)
PWR_K1_FB: U1.4 (1A1)
PWR_K2_FB: U1.6 (1A2)
PWR_WD_OK: U1.13 (2A2)
WD_OK_BUF: R6.1, U1.7 (2Y2)

Notes on the sheet:
PARTIAL MCU receiver: PWR source, rail supervisor and nSLEEP fanout on other sheets
OE1/OE2: 10k pullup; MCU_RAILS_OK_N is external open-drain, defaults released
Ioff at VCC=0 is not brownout proof. K1/K2 and local nSLEEP pulldown stay independent.
