efekrkyn/UGV-01/UGV-01/electronics/ugv_pwr_01/actuator_path.kicad_sch

## KiCad design UGV-01/electronics/ugv_pwr_01/actuator_path.kicad_sch (2026-09-27)

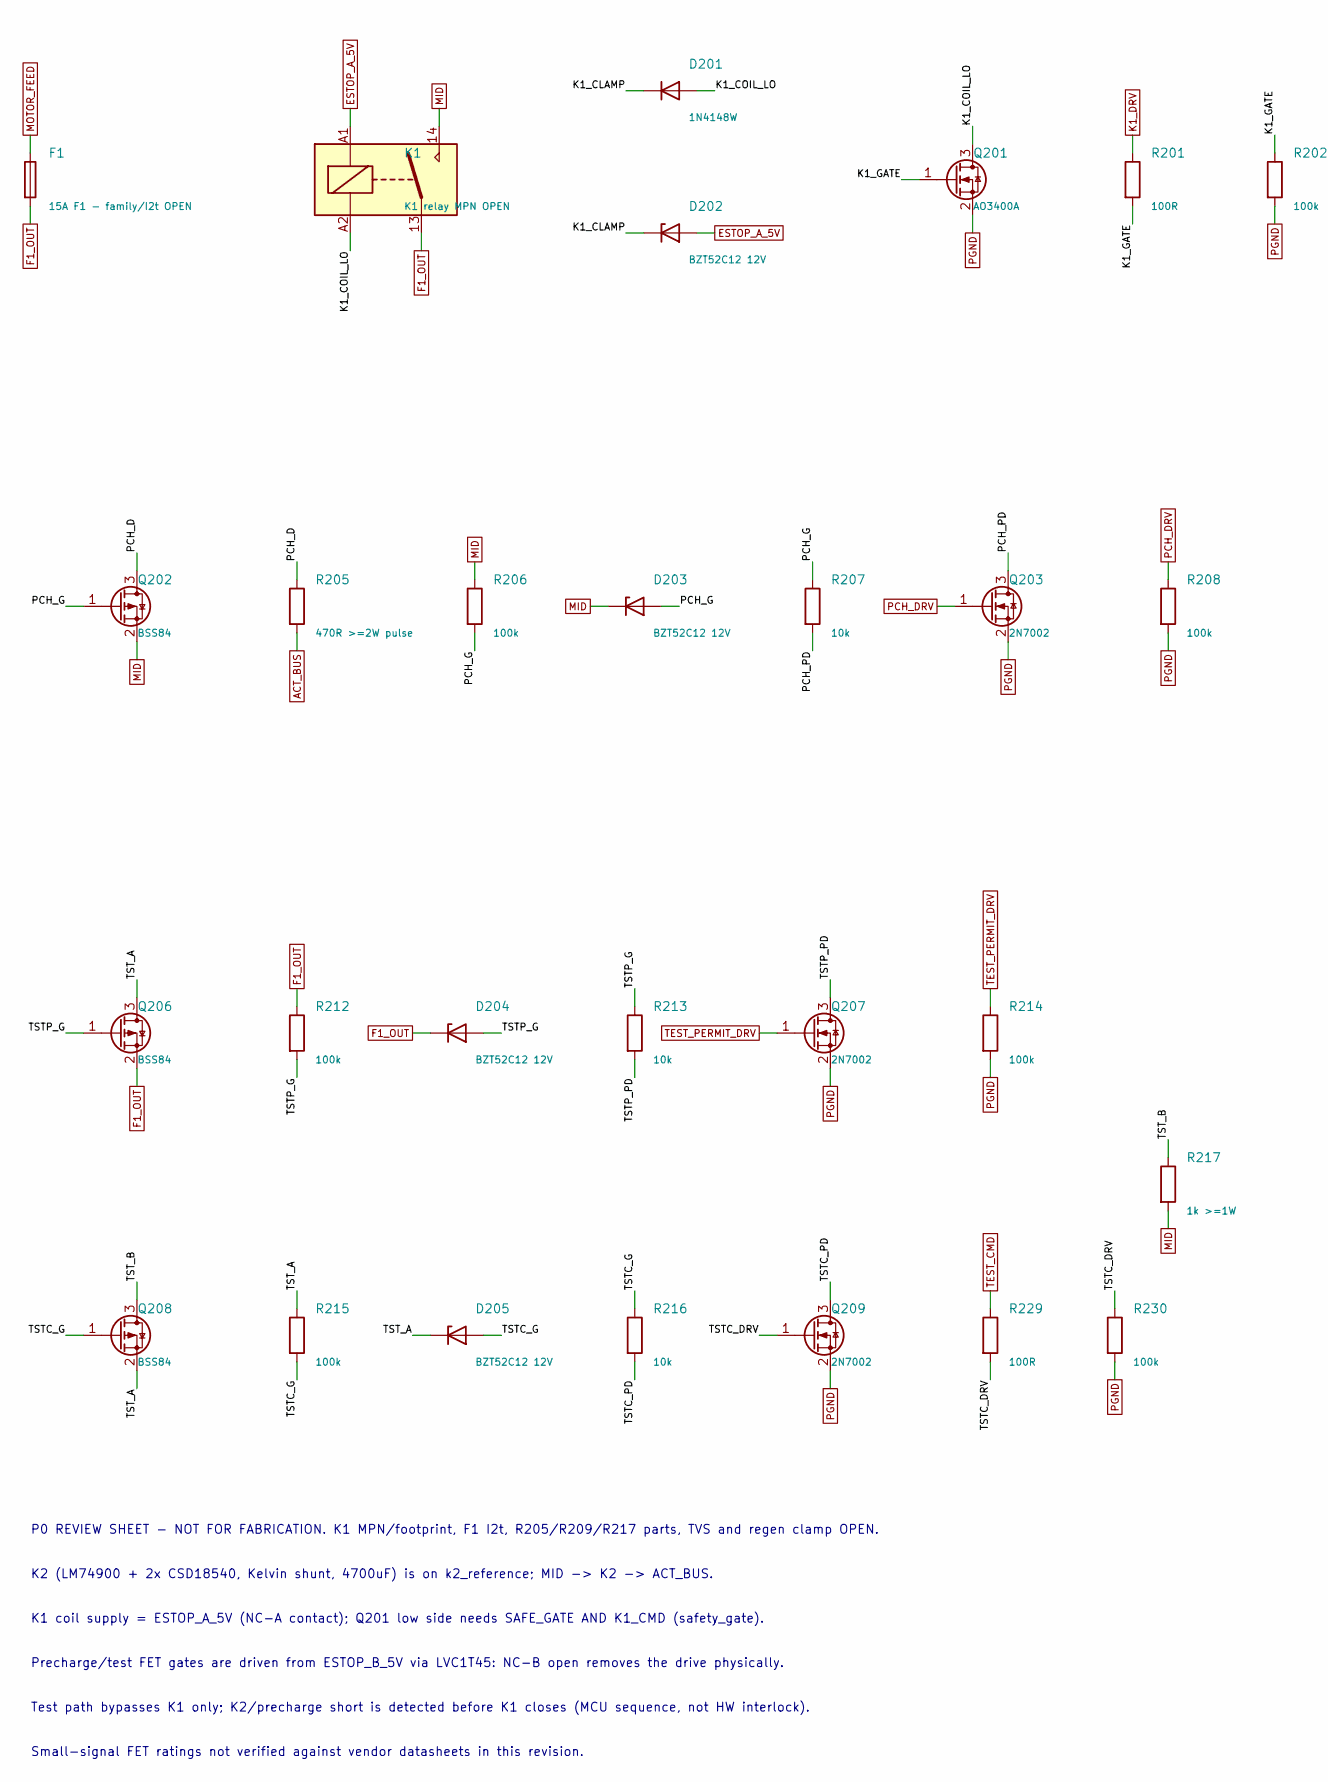
[picture p115: schematic actuator_path.kicad_sch, part in row 1, column 1]

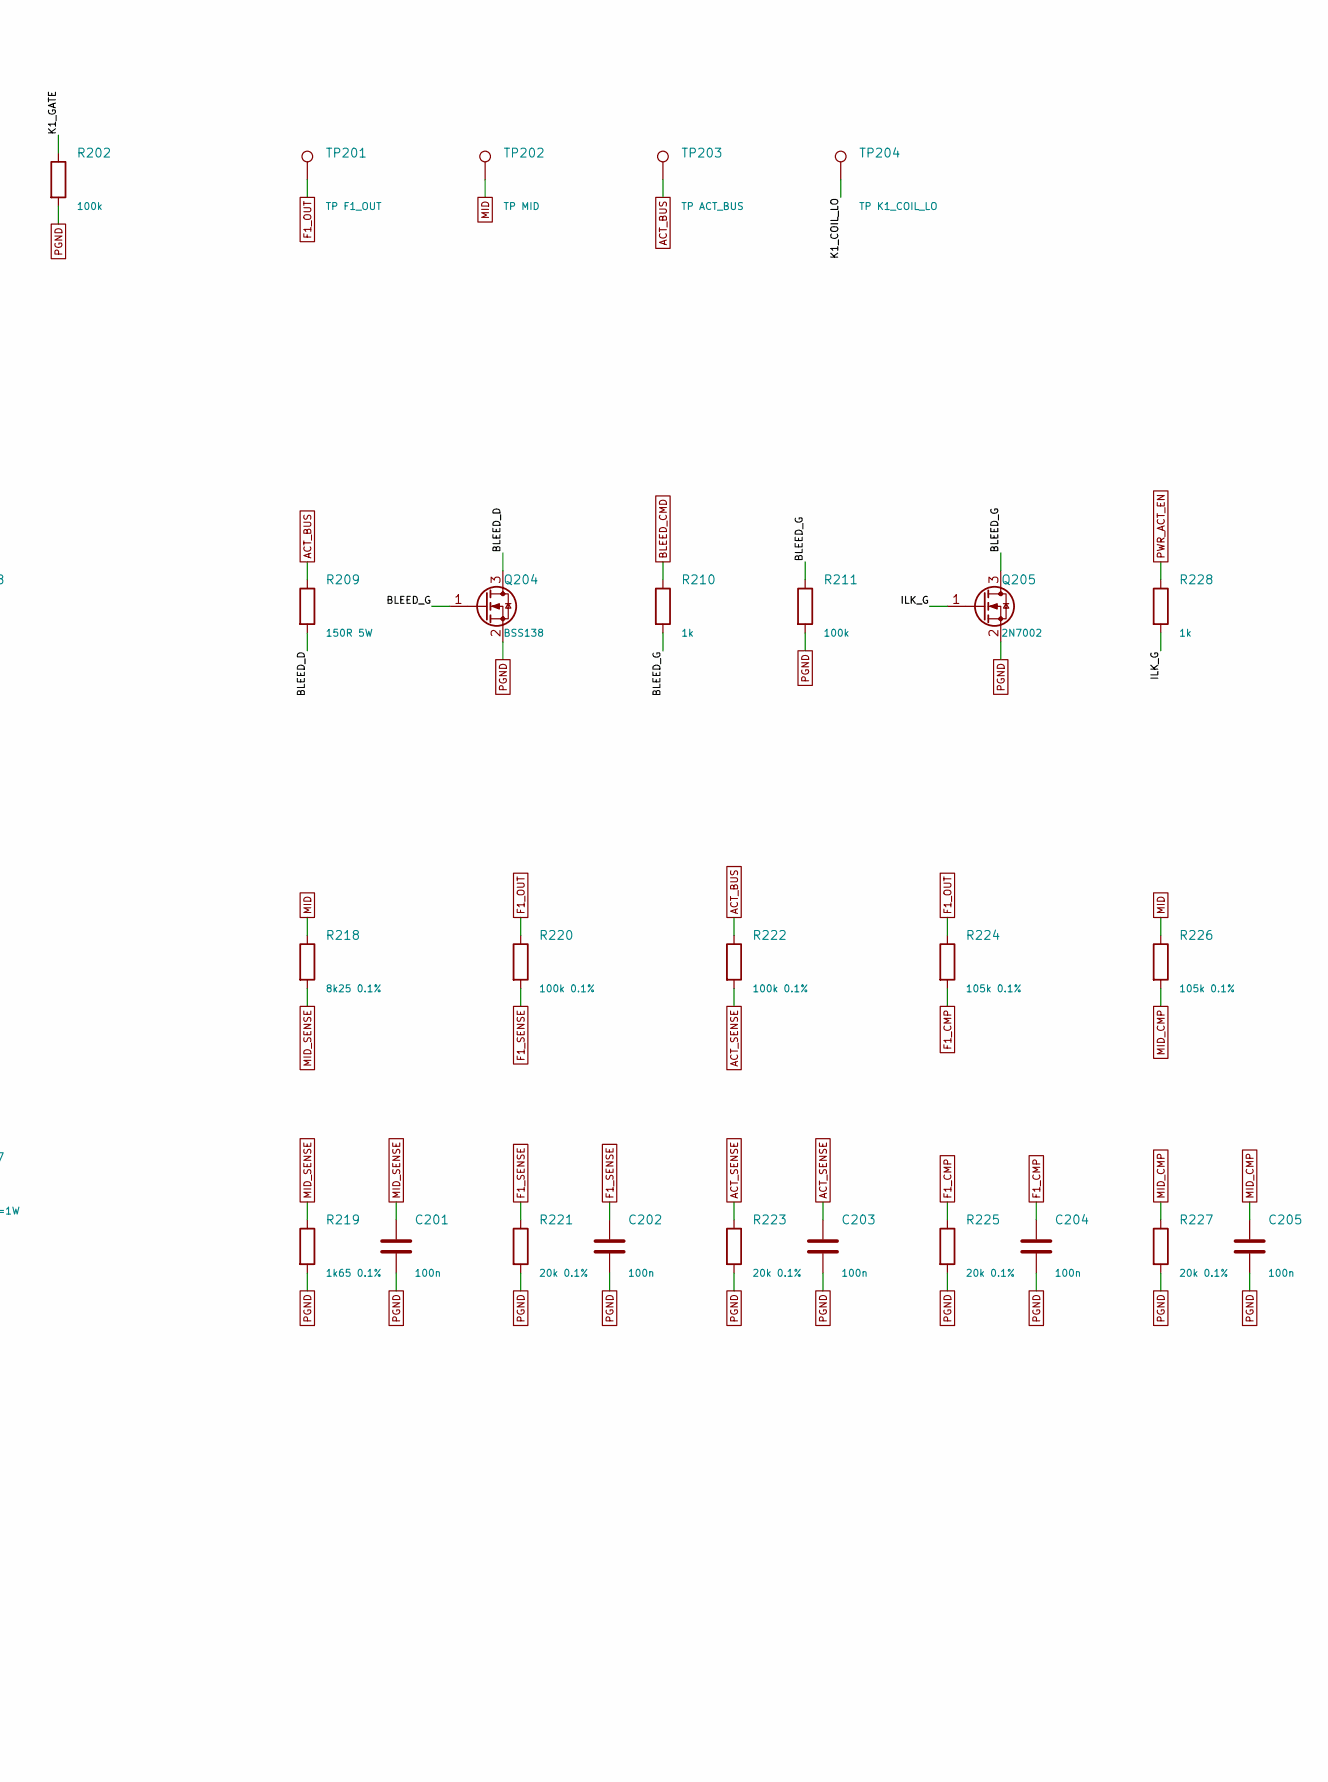
[picture p116: schematic actuator_path.kicad_sch, part in row 1, column 2]

Parts:
C201, C202, C203, C204, C205: 100n; C_0603_1608Metric
D201: 1N4148W; D_SOD-123
D202, D203, D204, D205: BZT52C12 12V; D_SOD-123
F1: 15A F1 - family/I2t OPEN
K1: K1 relay MPN OPEN
Q201: AO3400A; SOT-23
Q202, Q206, Q208: BSS84; SOT-23
Q203, Q205, Q207, Q209: 2N7002; SOT-23
Q204: BSS138; SOT-23
R201, R229: 100R; R_0603_1608Metric
R202, R206, R208, R211, R212, R214, R215, R230: 100k; R_0603_1608Metric
R205: 470R >=2W pulse
R207, R213, R216: 10k; R_0603_1608Metric
R209: 150R 5W
R210, R228: 1k; R_0603_1608Metric
R217: 1k >=1W
R218: 8k25 0.1%; R_0603_1608Metric
R219: 1k65 0.1%; R_0603_1608Metric
R220, R222: 100k 0.1%; R_0603_1608Metric
R221, R223, R225, R227: 20k 0.1%; R_0603_1608Metric
R224, R226: 105k 0.1%; R_0603_1608Metric
TP201: TP F1_OUT; TestPoint_Pad_D1.5mm
TP202: TP MID; TestPoint_Pad_D1.5mm
TP203: TP ACT_BUS; TestPoint_Pad_D1.5mm
TP204: TP K1_COIL_LO; TestPoint_Pad_D1.5mm

Connections:
ACT_BUS: R205.2, R209.1, R222.1, TP203.1
ACT_SENSE: C203.1, R222.2, R223.1
BLEED_CMD: R210.1
BLEED_D: Q204.3 (D), R209.2
BLEED_G: Q204.1 (G), Q205.3 (D), R210.2, R211.1
ESTOP_A_5V: D202.2 (A), K1.A1
F1_CMP: C204.1, R224.2, R225.1
F1_OUT: D204.1 (K), F1.2, K1.13, Q206.2 (S), R212.1, R220.1, R224.1, TP201.1
F1_SENSE: C202.1, R220.2, R221.1
ILK_G: Q205.1 (G), R228.2
K1_CLAMP: D201.1 (K), D202.1 (K)
K1_COIL_LO: D201.2 (A), K1.A2, Q201.3 (D), TP204.1
K1_DRV: R201.1
K1_GATE: Q201.1 (G), R201.2, R202.1
MID: D203.1 (K), K1.14, Q202.2 (S), R206.1, R217.2, R218.1, R226.1, TP202.1
MID_CMP: C205.1, R226.2, R227.1
MID_SENSE: C201.1, R218.2, R219.1
MOTOR_FEED: F1.1
PCH_D: Q202.3 (D), R205.1
PCH_DRV: Q203.1 (G), R208.1
PCH_G: D203.2 (A), Q202.1 (G), R206.2, R207.1
PCH_PD: Q203.3 (D), R207.2
PGND: C201.2, C202.2, C203.2, C204.2, C205.2, Q201.2 (S), Q203.2 (S), Q204.2 (S), Q205.2 (S), Q207.2 (S), Q209.2 (S), R202.2, R208.2, R211.2, R214.2, R219.2, R221.2, R223.2, R225.2, R227.2, R230.2
PWR_ACT_EN: R228.1
TEST_CMD: R229.1
TEST_PERMIT_DRV: Q207.1 (G), R214.1
TSTC_DRV: Q209.1 (G), R229.2, R230.1
TSTC_G: D205.2 (A), Q208.1 (G), R215.2, R216.1
TSTC_PD: Q209.3 (D), R216.2
TSTP_G: D204.2 (A), Q206.1 (G), R212.2, R213.1
TSTP_PD: Q207.3 (D), R213.2
TST_A: D205.1 (K), Q206.3 (D), Q208.2 (S), R215.1
TST_B: Q208.3 (D), R217.1

Notes on the sheet:
P0 REVIEW SHEET - NOT FOR FABRICATION. K1 MPN/footprint, F1 I2t, R205/R209/R217 parts, TVS and regen clamp OPEN.
K2 (LM74900 + 2x CSD18540, Kelvin shunt, 4700uF) is on k2_reference; MID -> K2 -> ACT_BUS.
K1 coil supply = ESTOP_A_5V (NC-A contact); Q201 low side needs SAFE_GATE AND K1_CMD (safety_gate).
Precharge/test FET gates are driven from ESTOP_B_5V via LVC1T45: NC-B open removes the drive physically.
Test path bypasses K1 only; K2/precharge short is detected before K1 closes (MCU sequence, not HW interlock).
Small-signal FET ratings not verified against vendor datasheets in this revision.
