efekrkyn/UGV-01/UGV-01/electronics/ugv_pwr_01/arming_io.kicad_sch

## KiCad design UGV-01/electronics/ugv_pwr_01/arming_io.kicad_sch (2026-09-27)

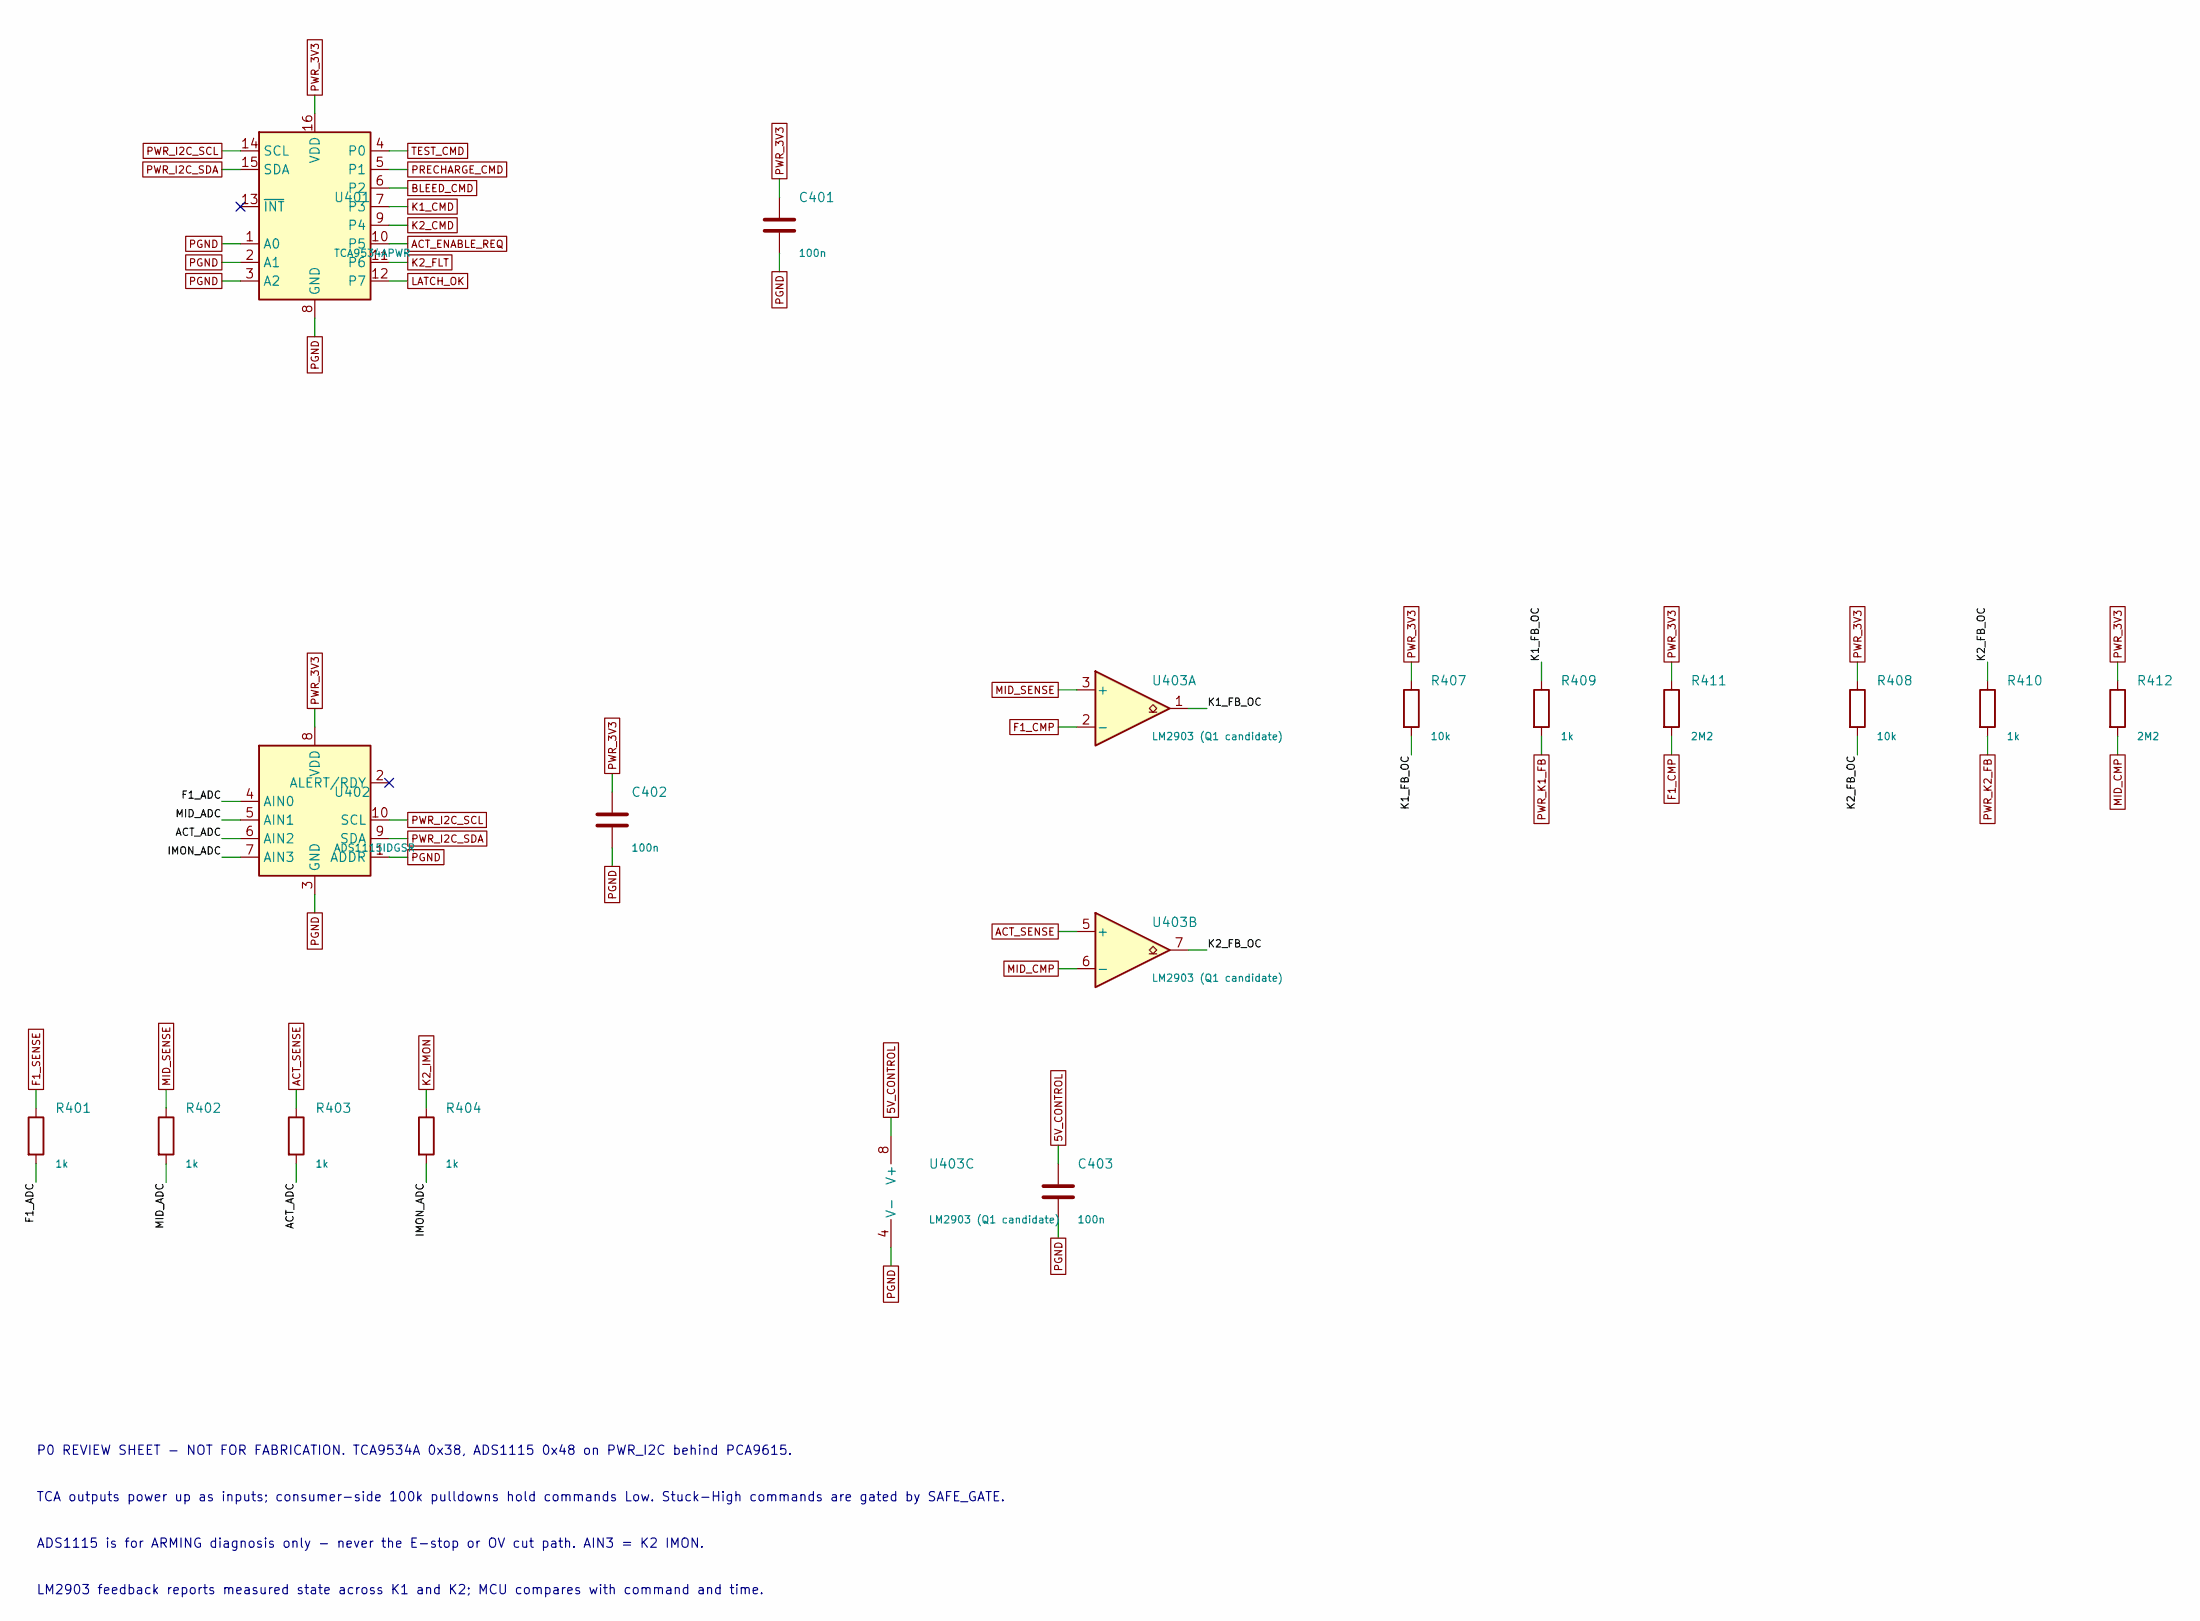
[picture p117: schematic arming_io.kicad_sch]

Parts:
C401, C402, C403: 100n; C_0603_1608Metric
R401, R402, R403, R404, R409, R410: 1k; R_0603_1608Metric
R407, R408: 10k; R_0603_1608Metric
R411, R412: 2M2; R_0603_1608Metric
U401: TCA9534APWR; TSSOP-16_4.4x5mm_P0.65mm
U402: ADS1115IDGSR; TSSOP-10_3x3mm_P0.5mm
U403: LM2903 (Q1 candidate); SOIC-8_3.9x4.9mm_P1.27mm

Connections:
5V_CONTROL: C403.1, U403.8 (V+)
ACT_ADC: R403.2, U402.6 (AIN2)
ACT_ENABLE_REQ: U401.10 (P5)
ACT_SENSE: R403.1, U403.5 (+)
BLEED_CMD: U401.6 (P2)
F1_ADC: R401.2, U402.4 (AIN0)
F1_CMP: R411.2, U403.2 (-)
F1_SENSE: R401.1
IMON_ADC: R404.2, U402.7 (AIN3)
K1_CMD: U401.7 (P3)
K1_FB_OC: R407.2, R409.1, U403.1
K2_CMD: U401.9 (P4)
K2_FB_OC: R408.2, R410.1, U403.7
K2_FLT: U401.11 (P6)
K2_IMON: R404.1
LATCH_OK: U401.12 (P7)
MID_ADC: R402.2, U402.5 (AIN1)
MID_CMP: R412.2, U403.6 (-)
MID_SENSE: R402.1, U403.3 (+)
PGND: C401.2, C402.2, C403.2, U401.1 (A0), U401.2 (A1), U401.3 (A2), U401.8 (GND), U402.1 (ADDR), U402.3 (GND), U403.4 (V-)
PRECHARGE_CMD: U401.5 (P1)
PWR_3V3: C401.1, C402.1, R407.1, R408.1, R411.1, R412.1, U401.16 (VDD), U402.8 (VDD)
PWR_I2C_SCL: U401.14 (SCL), U402.10 (SCL)
PWR_I2C_SDA: U401.15 (SDA), U402.9 (SDA)
PWR_K1_FB: R409.2
PWR_K2_FB: R410.2
TEST_CMD: U401.4 (P0)

Notes on the sheet:
P0 REVIEW SHEET - NOT FOR FABRICATION. TCA9534A 0x38, ADS1115 0x48 on PWR_I2C behind PCA9615.
TCA outputs power up as inputs; consumer-side 100k pulldowns hold commands Low. Stuck-High commands are gated by SAFE_GATE.
ADS1115 is for ARMING diagnosis only - never the E-stop or OV cut path. AIN3 = K2 IMON.
LM2903 feedback reports measured state across K1 and K2; MCU compares with command and time.
