efekrkyn/UGV-01/UGV-01/electronics/ugv_pwr_01/k2_reference.kicad_sch

## KiCad design UGV-01/electronics/ugv_pwr_01/k2_reference.kicad_sch (2026-09-27)

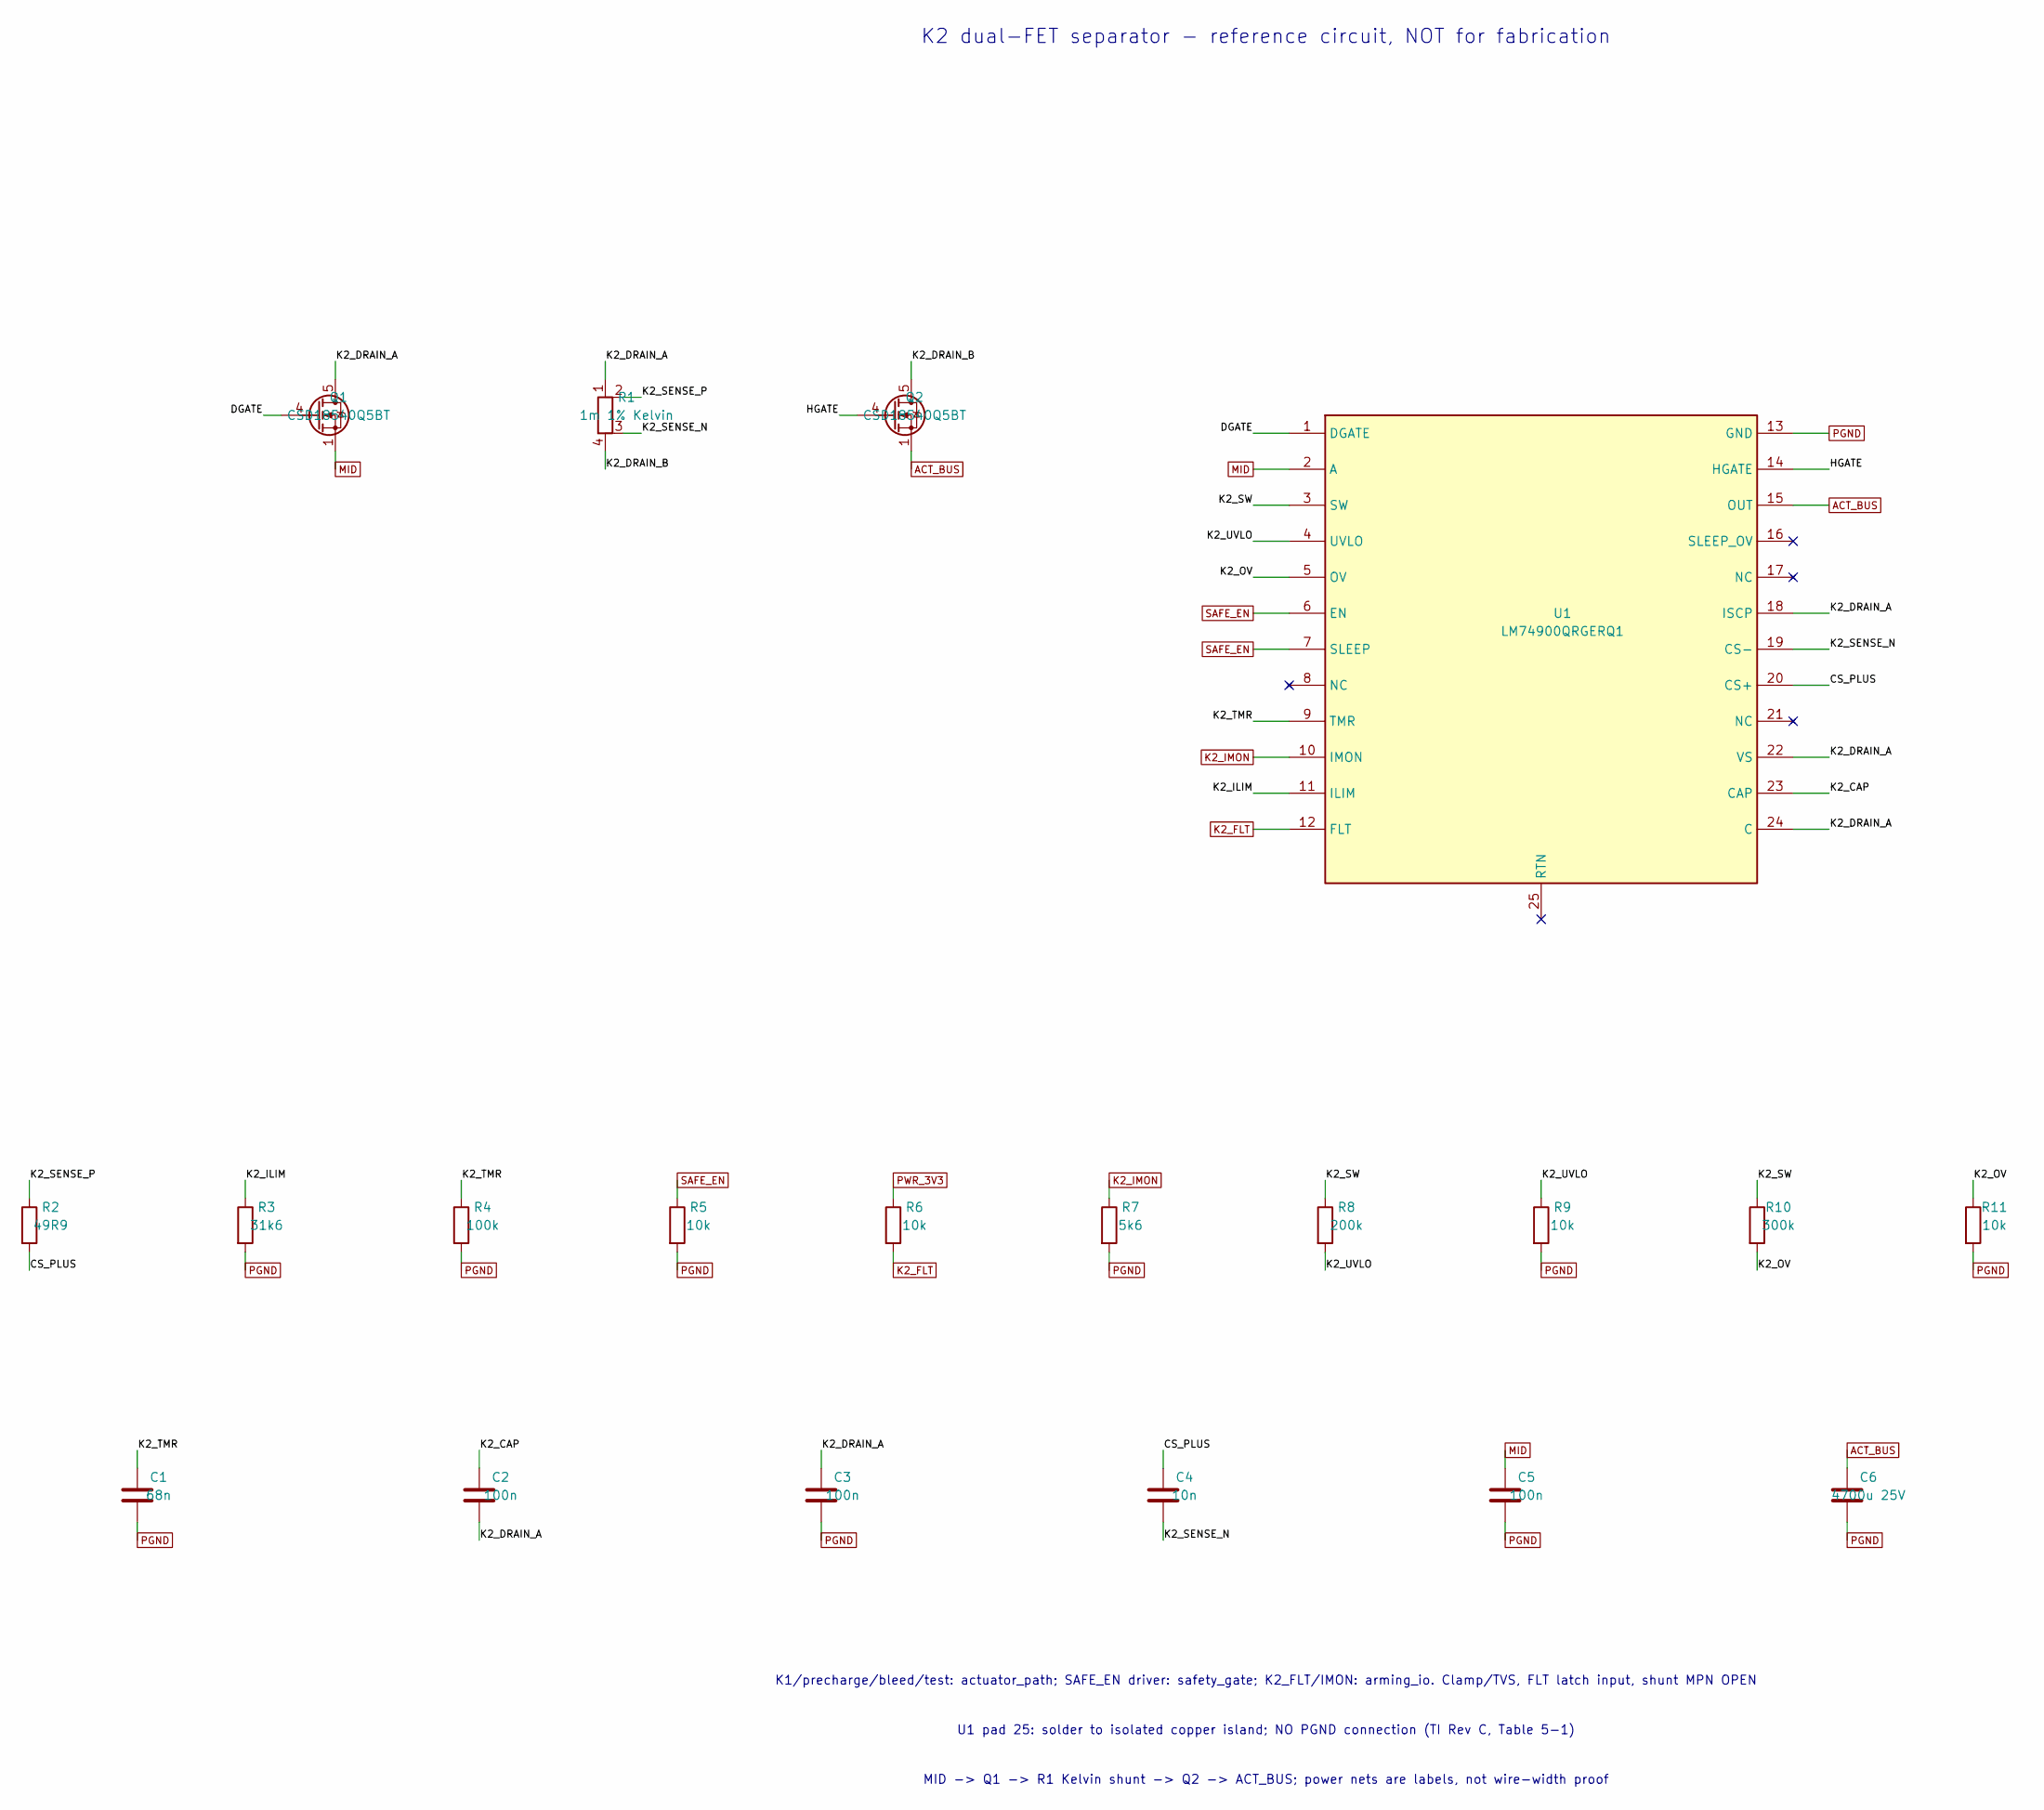
[picture p118: schematic k2_reference.kicad_sch]

Parts:
C1: 68n
C2, C3, C5: 100n
C4: 10n
C6: 4700u 25V
Q1, Q2: CSD18540Q5BT; TDSON-8-1
R1: 1m 1% Kelvin
R2: 49R9; R_0603_1608Metric
R3: 31k6; R_0603_1608Metric
R4: 100k; R_0603_1608Metric
R5, R6, R9, R11: 10k; R_0603_1608Metric
R7: 5k6; R_0603_1608Metric
R8: 200k; R_0603_1608Metric
R10: 300k; R_0603_1608Metric
U1: LM74900QRGERQ1; Texas_RGE0024C_VQFN-24-1EP_4x4mm_P0.5mm_EP2.1x2.1mm

Connections:
ACT_BUS: C6.1, Q2.1 (S), Q2.2 (S), Q2.3 (S), U1.15 (OUT)
CS_PLUS: C4.1, R2.2, U1.20 (CS+)
DGATE: Q1.4 (G), U1.1 (DGATE)
HGATE: Q2.4 (G), U1.14 (HGATE)
K2_CAP: C2.1, U1.23 (CAP)
K2_DRAIN_A: C2.2, C3.1, Q1.5 (D), R1.1, U1.18 (ISCP), U1.22 (VS), U1.24 (C)
K2_DRAIN_B: Q2.5 (D), R1.4
K2_FLT: R6.2, U1.12 (FLT)
K2_ILIM: R3.1, U1.11 (ILIM)
K2_IMON: R7.1, U1.10 (IMON)
K2_OV: R10.2, R11.1, U1.5 (OV)
K2_SENSE_N: C4.2, R1.3, U1.19 (CS-)
K2_SENSE_P: R1.2, R2.1
K2_SW: R8.1, R10.1, U1.3 (SW)
K2_TMR: C1.1, R4.1, U1.9 (TMR)
K2_UVLO: R8.2, R9.1, U1.4 (UVLO)
MID: C5.1, Q1.1 (S), Q1.2 (S), Q1.3 (S), U1.2 (A)
PGND: C1.2, C3.2, C5.2, C6.2, R3.2, R4.2, R5.2, R7.2, R9.2, R11.2, U1.13 (GND)
PWR_3V3: R6.1
SAFE_EN: R5.1, U1.6 (EN), U1.7 (SLEEP)

Notes on the sheet:
K2 dual-FET separator - reference circuit, NOT for fabrication
K1/precharge/bleed/test: actuator_path; SAFE_EN driver: safety_gate; K2_FLT/IMON: arming_io. Clamp/TVS, FLT latch input, shunt MPN OPEN
U1 pad 25: solder to isolated copper island; NO PGND connection (TI Rev C, Table 5-1)
MID -> Q1 -> R1 Kelvin shunt -> Q2 -> ACT_BUS; power nets are labels, not wire-width proof
