efekrkyn/UGV-01/UGV-01/electronics/ugv_pwr_01/pwr_mcu_interface.kicad_sch

## KiCad design UGV-01/electronics/ugv_pwr_01/pwr_mcu_interface.kicad_sch (2026-09-27)

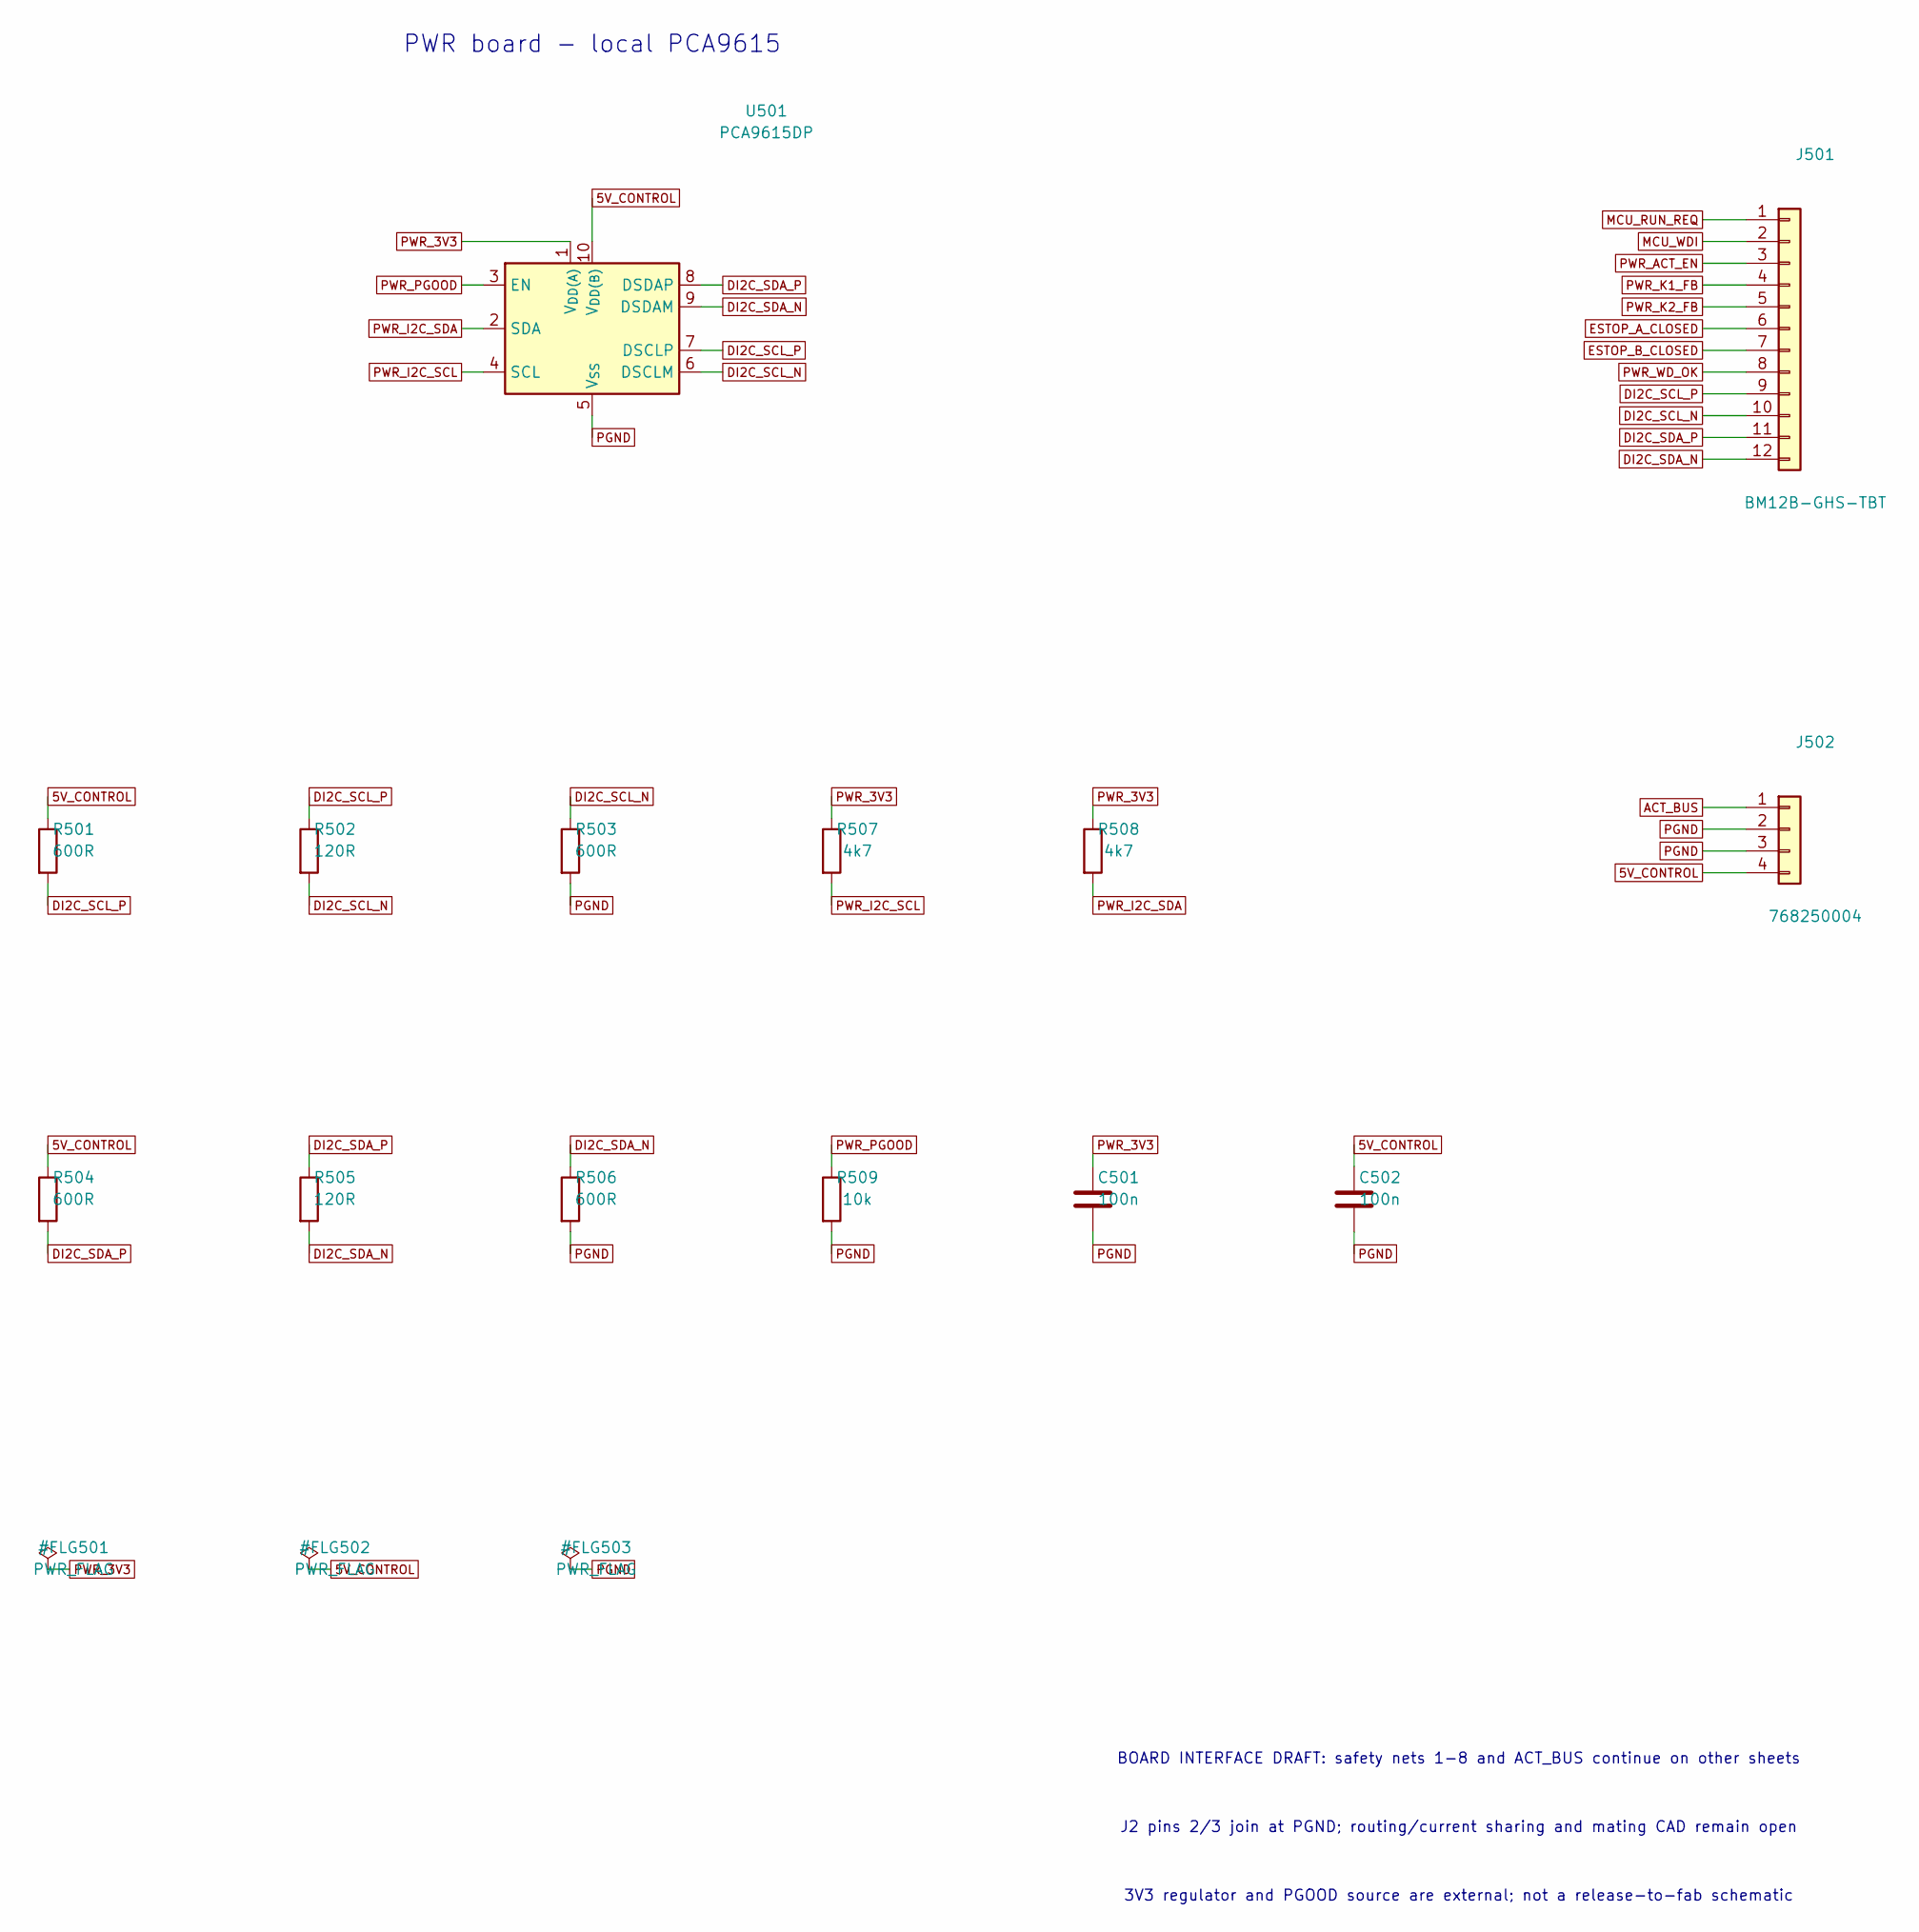
[picture p119: schematic pwr_mcu_interface.kicad_sch]

Parts:
C501, C502: 100n; C_0603_1608Metric
J501: BM12B-GHS-TBT; JST_GH_BM12B-GHS-TBT_1x12-1MP_P1.25mm_Vertical
J502: 768250004; Molex_Mega-Fit_76825-0004_2x02_P5.70mm_Horizontal
R501, R503, R504, R506: 600R; R_0603_1608Metric
R502, R505: 120R; R_0603_1608Metric
R507, R508: 4k7; R_0603_1608Metric
R509: 10k; R_0603_1608Metric
U501: PCA9615DP; TSSOP-10_3x3mm_P0.5mm

Connections:
5V_CONTROL: C502.1, J502.4, R501.1, R504.1, U501.10 (V_{DD(B)})
ACT_BUS: J502.1
DI2C_SCL_N: J501.10, R502.2, R503.1, U501.6 (DSCLM)
DI2C_SCL_P: J501.9, R501.2, R502.1, U501.7 (DSCLP)
DI2C_SDA_N: J501.12, R505.2, R506.1, U501.9 (DSDAM)
DI2C_SDA_P: J501.11, R504.2, R505.1, U501.8 (DSDAP)
ESTOP_A_CLOSED: J501.6
ESTOP_B_CLOSED: J501.7
MCU_RUN_REQ: J501.1
MCU_WDI: J501.2
PGND: C501.2, C502.2, J502.2, J502.3, R503.2, R506.2, R509.2, U501.5 (V_{SS})
PWR_3V3: C501.1, R507.1, R508.1, U501.1 (V_{DD(A)})
PWR_ACT_EN: J501.3
PWR_I2C_SCL: R507.2, U501.4 (SCL)
PWR_I2C_SDA: R508.2, U501.2 (SDA)
PWR_K1_FB: J501.4
PWR_K2_FB: J501.5
PWR_PGOOD: R509.1, U501.3 (EN)
PWR_WD_OK: J501.8

Notes on the sheet:
PWR board - local PCA9615
BOARD INTERFACE DRAFT: safety nets 1-8 and ACT_BUS continue on other sheets
J2 pins 2/3 join at PGND; routing/current sharing and mating CAD remain open
3V3 regulator and PGOOD source are external; not a release-to-fab schematic
