efekrkyn/UGV-01/UGV-01/electronics/ugv_pwr_01/safety_gate.kicad_sch

## KiCad design UGV-01/electronics/ugv_pwr_01/safety_gate.kicad_sch (2026-09-27)

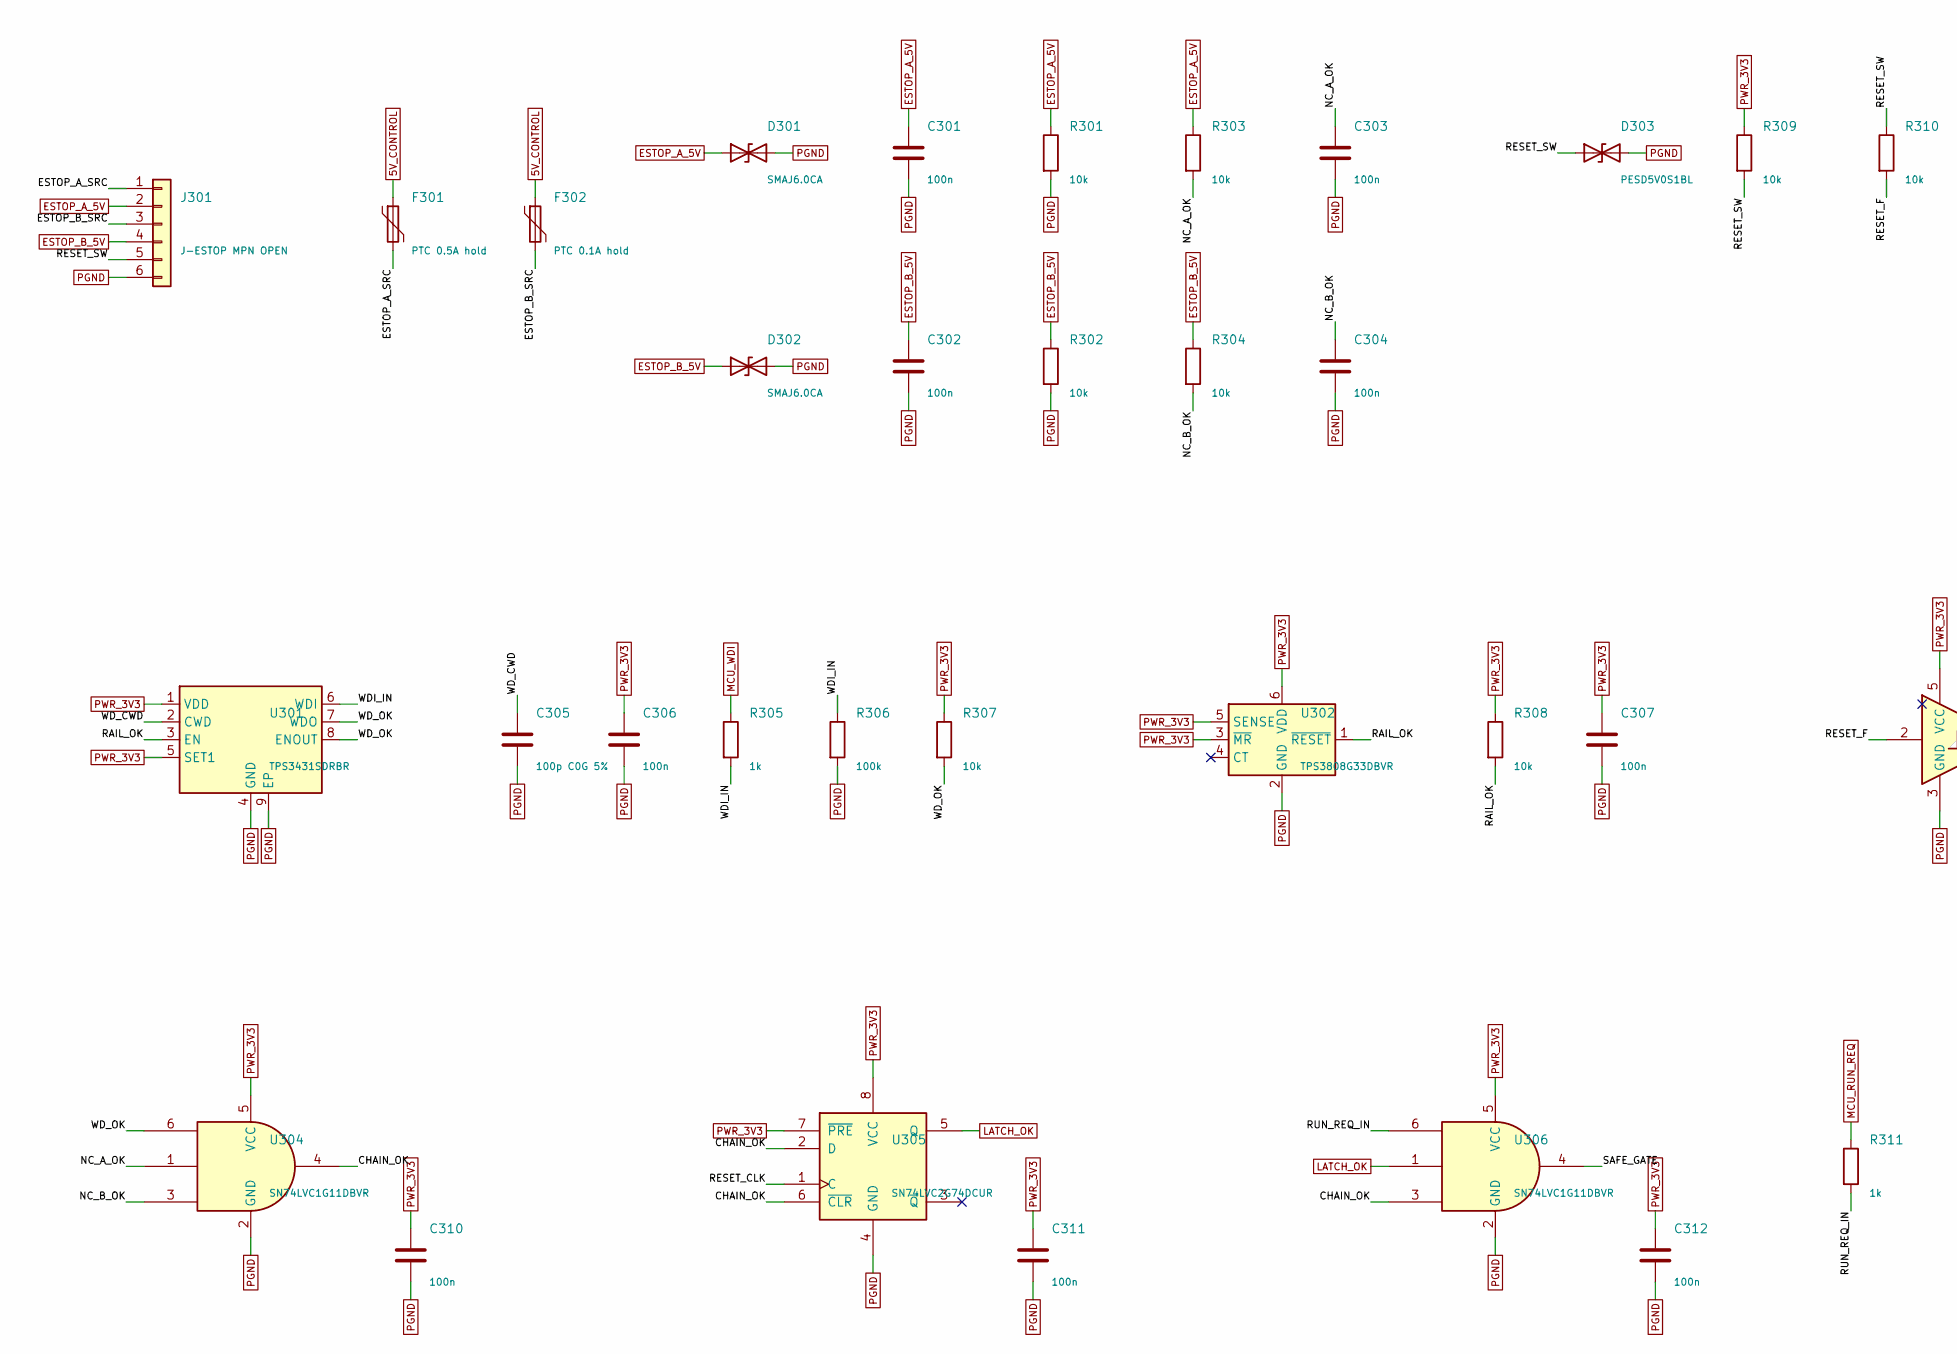
[picture p120: schematic safety_gate.kicad_sch, part in row 1, column 1]

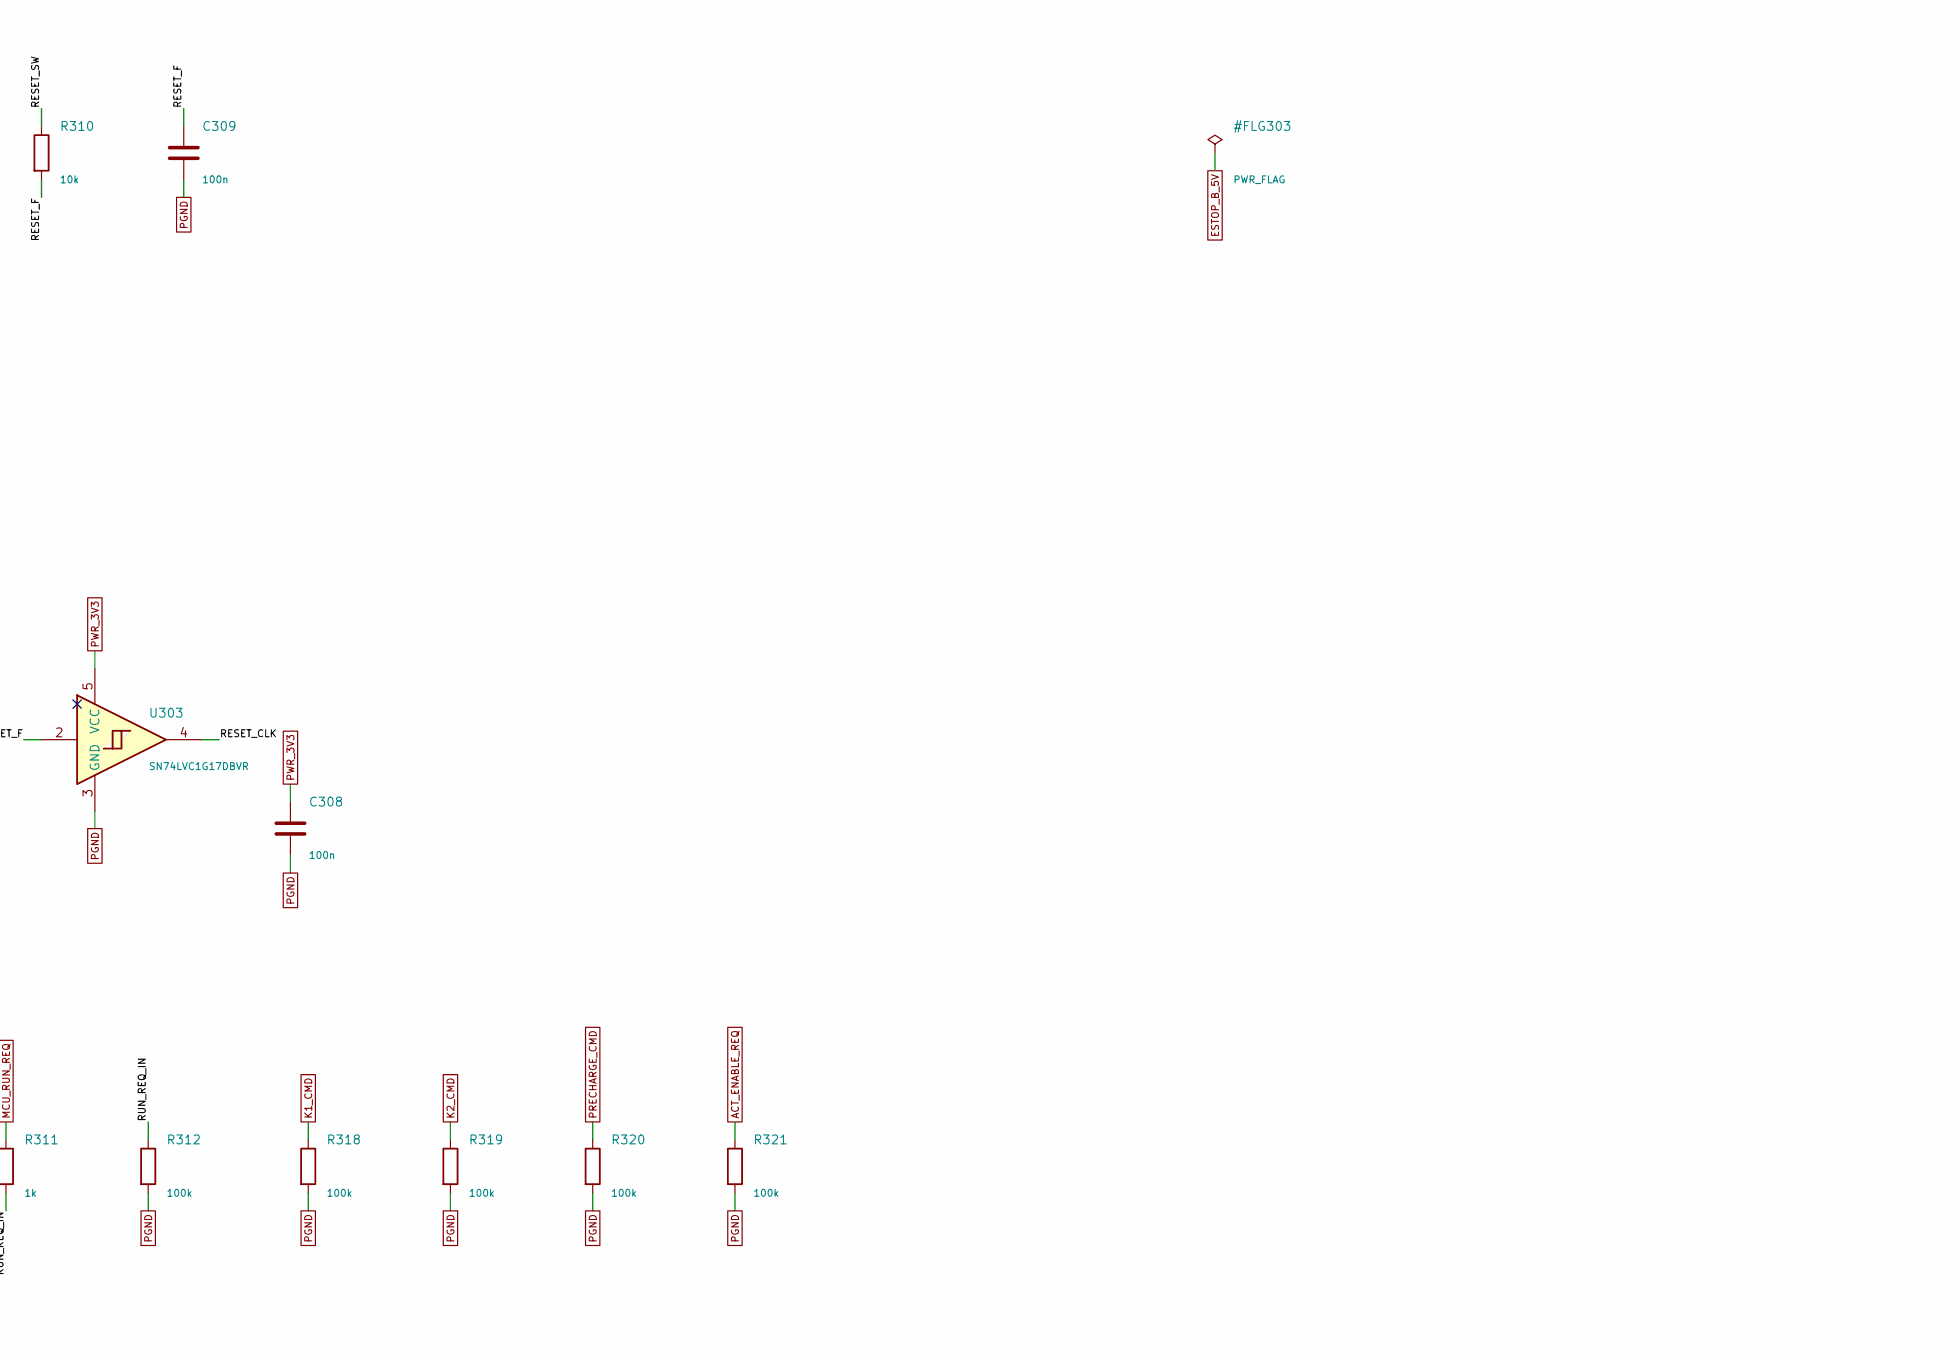
[picture p121: schematic safety_gate.kicad_sch, part in row 1, column 2]

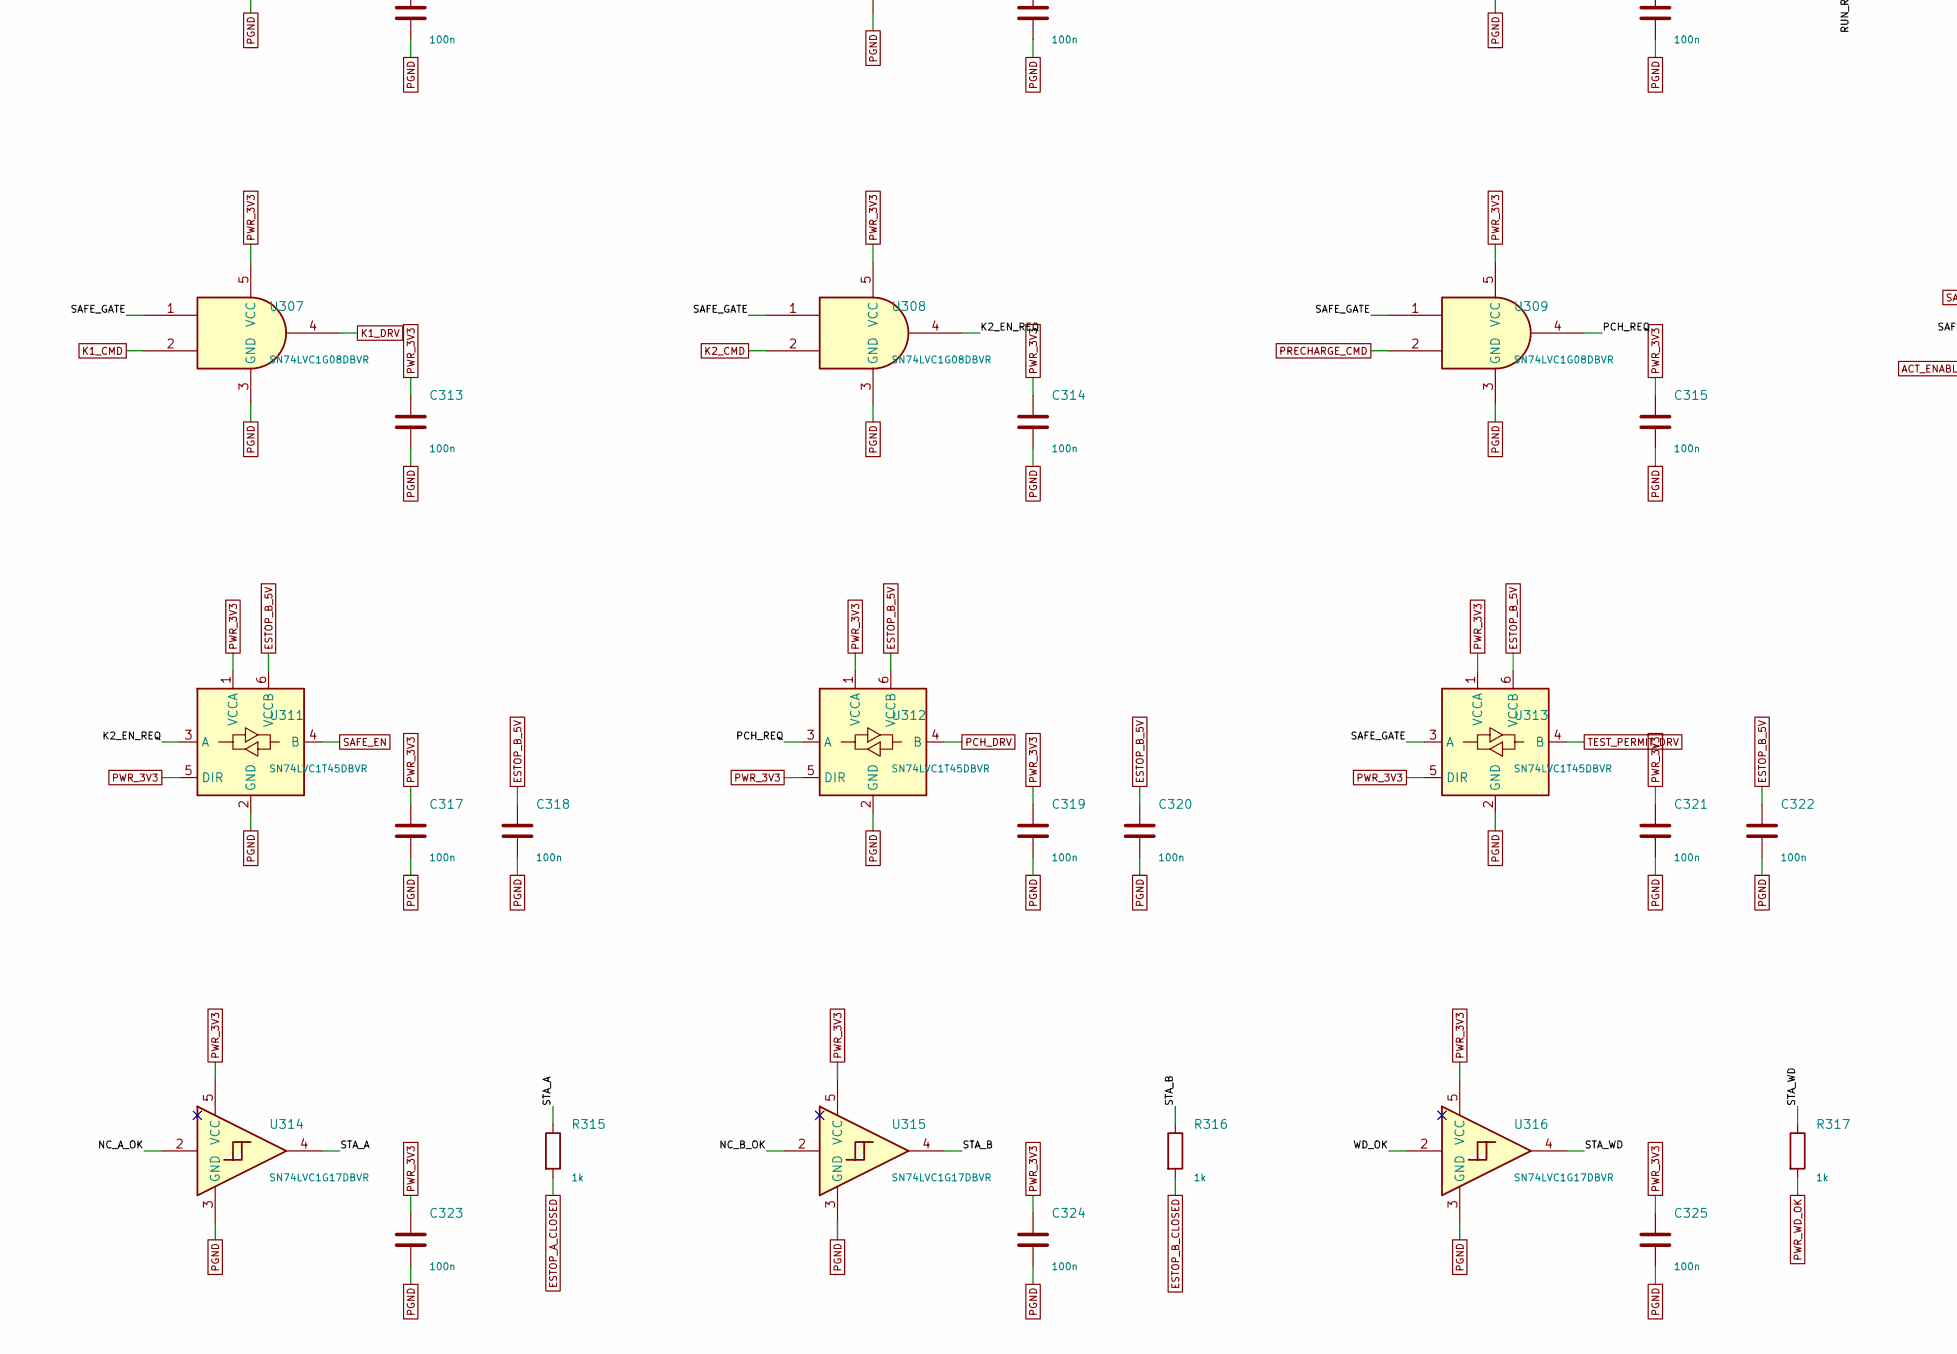
[picture p122: schematic safety_gate.kicad_sch, part in row 2, column 1]

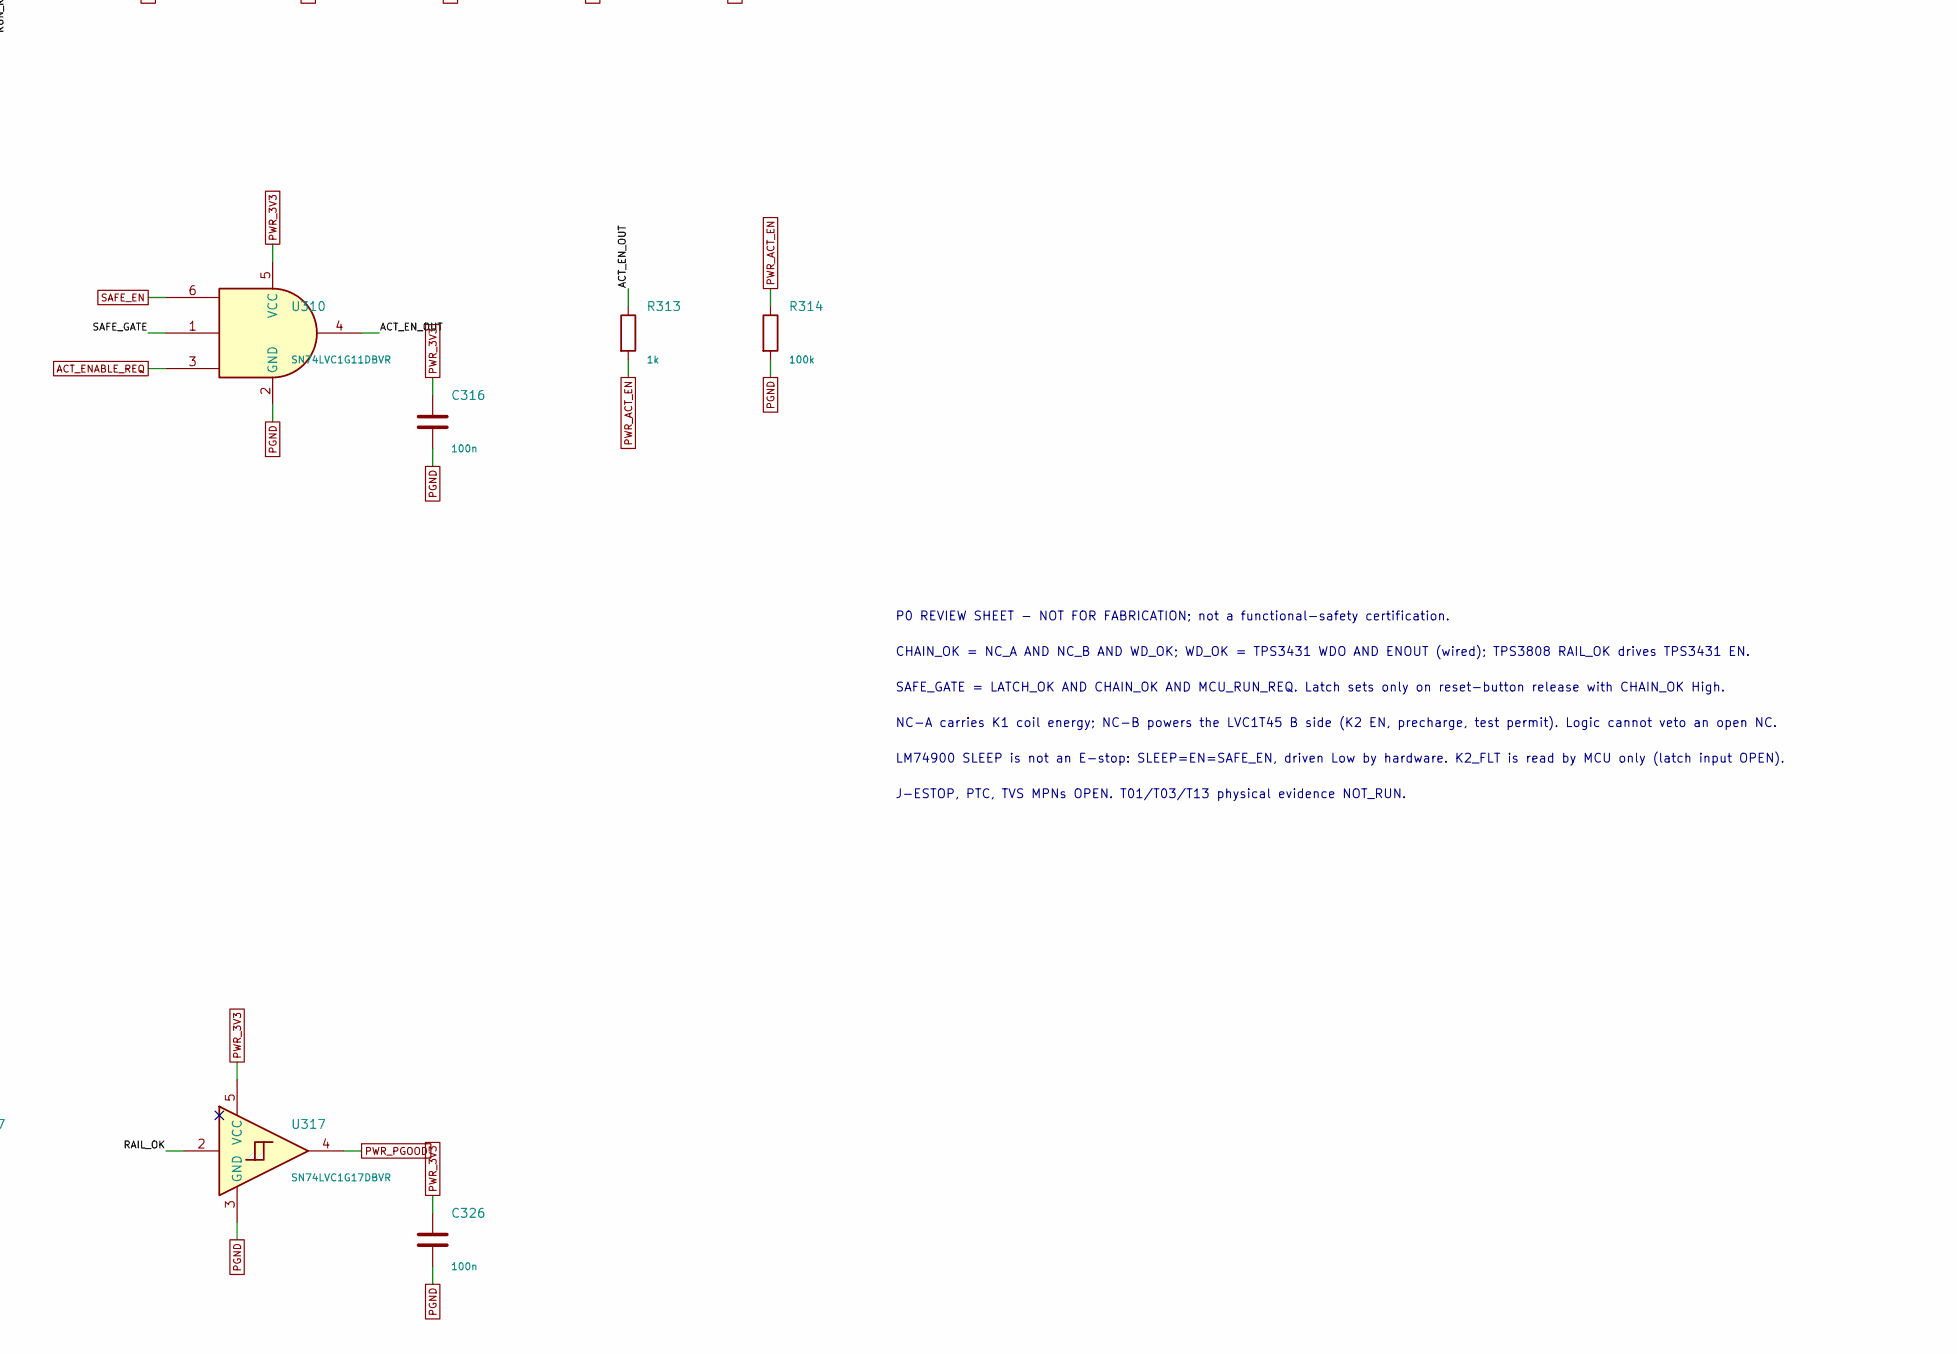
[picture p123: schematic safety_gate.kicad_sch, part in row 2, column 2]

Parts:
C301, C302, C303, C304, C306, C307, C308, C309, C310, C311, C312, C313, C314, C315, C316, C317, C318, C319, C320, C321, C322, C323, C324, C325, C326: 100n; C_0603_1608Metric
C305: 100p C0G 5%; C_0603_1608Metric
D301, D302: SMAJ6.0CA
D303: PESD5V0S1BL; D_SOD-323
F301: PTC 0.5A hold
F302: PTC 0.1A hold
J301: J-ESTOP MPN OPEN
R301, R302, R303, R304, R307, R308, R309, R310: 10k; R_0603_1608Metric
R305, R311, R313, R315, R316, R317: 1k; R_0603_1608Metric
R306, R312, R314, R318, R319, R320, R321: 100k; R_0603_1608Metric
U301: TPS3431SDRBR; VSON-8-1EP_3x3mm_P0.65mm_EP1.65x2.4mm
U302: TPS3808G33DBVR; SOT-23-6
U303, U314, U315, U316, U317: SN74LVC1G17DBVR; SOT-23-5
U304, U306, U310: SN74LVC1G11DBVR; SOT-23-6
U305: SN74LVC2G74DCUR; VSSOP-8_2.3x2mm_P0.5mm
U307, U308, U309: SN74LVC1G08DBVR; SOT-23-5
U311, U312, U313: SN74LVC1T45DBVR; SOT-23-6

Connections:
5V_CONTROL: F301.1, F302.1
ACT_ENABLE_REQ: R321.1, U310.3
ACT_EN_OUT: R313.1, U310.4
CHAIN_OK: U304.4, U305.2 (D), U305.6 (~CLR), U306.3
ESTOP_A_5V: C301.1, D301.1 (A1), J301.2, R301.1, R303.1
ESTOP_A_CLOSED: R315.2
ESTOP_A_SRC: F301.2, J301.1
ESTOP_B_5V: C302.1, C318.1, C320.1, C322.1, D302.1 (A1), J301.4, R302.1, R304.1, U311.6 (VCCB), U312.6 (VCCB), U313.6 (VCCB)
ESTOP_B_CLOSED: R316.2
ESTOP_B_SRC: F302.2, J301.3
K1_CMD: R318.1, U307.2
K1_DRV: U307.4
K2_CMD: R319.1, U308.2
K2_EN_REQ: U308.4, U311.3 (A)
LATCH_OK: U305.5 (Q), U306.1
MCU_RUN_REQ: R311.1
MCU_WDI: R305.1
NC_A_OK: C303.1, R303.2, U304.1, U314.2
NC_B_OK: C304.1, R304.2, U304.3, U315.2
PCH_DRV: U312.4 (B)
PCH_REQ: U309.4, U312.3 (A)
PGND: C301.2, C302.2, C303.2, C304.2, C305.2, C306.2, C307.2, C308.2, C309.2, C310.2, C311.2, C312.2, C313.2, C314.2, C315.2, C316.2, C317.2, C318.2, C319.2, C320.2, C321.2, C322.2, C323.2, C324.2, C325.2, C326.2, D301.2 (A2), D302.2 (A2), D303.2 (A2), J301.6, R301.2, R302.2, R306.2, R312.2, R314.2, R318.2, R319.2, R320.2, R321.2, U301.4 (GND), U301.9 (EP), U302.2 (GND), U303.3 (GND), U304.2 (GND), U305.4 (GND), U306.2 (GND), U307.3 (GND), U308.3 (GND), U309.3 (GND), U310.2 (GND), U311.2 (GND), U312.2 (GND), U313.2 (GND), U314.3 (GND), U315.3 (GND), U316.3 (GND), U317.3 (GND)
PRECHARGE_CMD: R320.1, U309.2
PWR_3V3: C306.1, C307.1, C308.1, C310.1, C311.1, C312.1, C313.1, C314.1, C315.1, C316.1, C317.1, C319.1, C321.1, C323.1, C324.1, C325.1, C326.1, R307.1, R308.1, R309.1, U301.1 (VDD), U301.5 (SET1), U302.3 (~MR), U302.5 (SENSE), U302.6 (VDD), U303.5 (VCC), U304.5 (VCC), U305.7 (~PRE), U305.8 (VCC), U306.5 (VCC), U307.5 (VCC), U308.5 (VCC), U309.5 (VCC), U310.5 (VCC), U311.1 (VCCA), U311.5 (DIR), U312.1 (VCCA), U312.5 (DIR), U313.1 (VCCA), U313.5 (DIR), U314.5 (VCC), U315.5 (VCC), U316.5 (VCC), U317.5 (VCC)
PWR_ACT_EN: R313.2, R314.1
PWR_PGOOD: U317.4
PWR_WD_OK: R317.2
RAIL_OK: R308.2, U301.3 (EN), U302.1 (~RESET), U317.2
RESET_CLK: U303.4, U305.1 (C)
RESET_F: C309.1, R310.2, U303.2
RESET_SW: D303.1 (A1), J301.5, R309.2, R310.1
RUN_REQ_IN: R311.2, R312.1, U306.6
SAFE_EN: U310.6, U311.4 (B)
SAFE_GATE: U306.4, U307.1, U308.1, U309.1, U310.1, U313.3 (A)
STA_A: R315.1, U314.4
STA_B: R316.1, U315.4
STA_WD: R317.1, U316.4
TEST_PERMIT_DRV: U313.4 (B)
WDI_IN: R305.2, R306.1, U301.6 (WDI)
WD_CWD: C305.1, U301.2 (CWD)
WD_OK: R307.2, U301.7 (WDO), U301.8 (ENOUT), U304.6, U316.2

Notes on the sheet:
P0 REVIEW SHEET - NOT FOR FABRICATION; not a functional-safety certification.
CHAIN_OK = NC_A AND NC_B AND WD_OK; WD_OK = TPS3431 WDO AND ENOUT (wired); TPS3808 RAIL_OK drives TPS3431 EN.
SAFE_GATE = LATCH_OK AND CHAIN_OK AND MCU_RUN_REQ. Latch sets only on reset-button release with CHAIN_OK High.
NC-A carries K1 coil energy; NC-B powers the LVC1T45 B side (K2 EN, precharge, test permit). Logic cannot veto an open NC.
LM74900 SLEEP is not an E-stop: SLEEP=EN=SAFE_EN, driven Low by hardware. K2_FLT is read by MCU only (latch input OPEN).
J-ESTOP, PTC, TVS MPNs OPEN. T01/T03/T13 physical evidence NOT_RUN.
