efekrkyn/UGV-01/UGV-01/firmware/lite/hmac_sha256.c

#include "hmac_sha256.h"

#include <string.h>

typedef struct {
    uint32_t h[8];
    uint64_t bytes;
    uint8_t buf[64];
    size_t used;
} Sha256;

static const uint32_t K[64] = {
    0x428a2f98, 0x71374491, 0xb5c0fbcf, 0xe9b5dba5, 0x3956c25b, 0x59f111f1, 0x923f82a4, 0xab1c5ed5,
    0xd807aa98, 0x12835b01, 0x243185be, 0x550c7dc3, 0x72be5d74, 0x80deb1fe, 0x9bdc06a7, 0xc19bf174,
    0xe49b69c1, 0xefbe4786, 0x0fc19dc6, 0x240ca1cc, 0x2de92c6f, 0x4a7484aa, 0x5cb0a9dc, 0x76f988da,
    0x983e5152, 0xa831c66d, 0xb00327c8, 0xbf597fc7, 0xc6e00bf3, 0xd5a79147, 0x06ca6351, 0x14292967,
    0x27b70a85, 0x2e1b2138, 0x4d2c6dfc, 0x53380d13, 0x650a7354, 0x766a0abb, 0x81c2c92e, 0x92722c85,
    0xa2bfe8a1, 0xa81a664b, 0xc24b8b70, 0xc76c51a3, 0xd192e819, 0xd6990624, 0xf40e3585, 0x106aa070,
    0x19a4c116, 0x1e376c08, 0x2748774c, 0x34b0bcb5, 0x391c0cb3, 0x4ed8aa4a, 0x5b9cca4f, 0x682e6ff3,
    0x748f82ee, 0x78a5636f, 0x84c87814, 0x8cc70208, 0x90befffa, 0xa4506ceb, 0xbef9a3f7, 0xc67178f2,
};

static uint32_t ror(uint32_t x, int n) { return (x >> n) | (x << (32 - n)); }

static void block(Sha256 *s, const uint8_t *p) {
    uint32_t w[64], v[8];
    for (int i = 0; i < 16; ++i)
        w[i] = (uint32_t)p[4 * i] << 24 | (uint32_t)p[4 * i + 1] << 16 | (uint32_t)p[4 * i + 2] << 8 | p[4 * i + 3];
    for (int i = 16; i < 64; ++i) {
        const uint32_t s0 = ror(w[i - 15], 7) ^ ror(w[i - 15], 18) ^ (w[i - 15] >> 3);
        const uint32_t s1 = ror(w[i - 2], 17) ^ ror(w[i - 2], 19) ^ (w[i - 2] >> 10);
        w[i] = w[i - 16] + s0 + w[i - 7] + s1;
    }
    memcpy(v, s->h, sizeof v);
    for (int i = 0; i < 64; ++i) {
        const uint32_t t1 = v[7] + (ror(v[4], 6) ^ ror(v[4], 11) ^ ror(v[4], 25)) +
                            ((v[4] & v[5]) ^ (~v[4] & v[6])) + K[i] + w[i];
        const uint32_t t2 = (ror(v[0], 2) ^ ror(v[0], 13) ^ ror(v[0], 22)) +
                            ((v[0] & v[1]) ^ (v[0] & v[2]) ^ (v[1] & v[2]));
        memmove(v + 1, v, 7 * sizeof v[0]);
        v[4] += t1;
        v[0] = t1 + t2;
    }
    for (int i = 0; i < 8; ++i) s->h[i] += v[i];
}

static void init(Sha256 *s) {
    static const uint32_t H0[8] = {0x6a09e667, 0xbb67ae85, 0x3c6ef372, 0xa54ff53a,
                                   0x510e527f, 0x9b05688c, 0x1f83d9ab, 0x5be0cd19};
    memcpy(s->h, H0, sizeof H0);
    s->bytes = 0;
    s->used = 0;
}

static void update(Sha256 *s, const uint8_t *data, size_t len) {
    s->bytes += len;
    while (len--) {
        s->buf[s->used++] = *data++;
        if (s->used == 64) {
            block(s, s->buf);
            s->used = 0;
        }
    }
}

static void final(Sha256 *s, uint8_t out[32]) {
    const uint64_t bits = s->bytes * 8;
    const uint8_t one = 0x80, zero = 0;
    update(s, &one, 1);
    while (s->used != 56) update(s, &zero, 1);
    for (int i = 7; i >= 0; --i) {
        const uint8_t b = (uint8_t)(bits >> (8 * i));
        update(s, &b, 1);
    }
    for (int i = 0; i < 8; ++i)
        for (int j = 0; j < 4; ++j) out[4 * i + j] = (uint8_t)(s->h[i] >> (24 - 8 * j));
}

void ugv_sha256(const uint8_t *data, size_t len, uint8_t out[32]) {
    Sha256 s;
    init(&s);
    update(&s, data, len);
    final(&s, out);
}

void ugv_hmac_sha256(const uint8_t *key, size_t key_len, const uint8_t *data, size_t len, uint8_t out[32]) {
    uint8_t k[64] = {0}, pad[64], inner[32];
    if (key_len > 64)
        ugv_sha256(key, key_len, k);
    else
        memcpy(k, key, key_len);
    Sha256 s;
    for (int i = 0; i < 64; ++i) pad[i] = k[i] ^ 0x36;
    init(&s);
    update(&s, pad, 64);
    update(&s, data, len);
    final(&s, inner);
    for (int i = 0; i < 64; ++i) pad[i] = k[i] ^ 0x5c;
    init(&s);
    update(&s, pad, 64);
    update(&s, inner, 32);
    final(&s, out);
}
