efekrkyn/UGV-01/(commit log)

2026-09-27 UGV-01 A3 Lite: tasarım, firmware, AI ve tanıtım filmi
    - M3 gövde ve 5 eksenli kol: parametrik CadQuery CAD (96 STEP, 67 baskı
    parçası), kol duruş grafiği ve 1° çarpışma taraması, baskı planı ve STL'ler
    - ESP32-S3 firmware (L4a/L4b donanımsız kısmı): imzalı UDP, lite_core,
    PI hız döngüsü, kol yolu, VL53L0X çifti, ESP32-CAM göz firmware'i,
    ESP-IDF 5.3.2 ile uyarısız derlenir; NVS kurulum yardımcısı
    - MacBook tarafı: ağ geçidi, AI yürütücü (deepseek-flash / Claude), panel
    - Bağımsız M3 incelemesi N3-N8 kapatıldı (DD90), firmware öz incelemesi (DD91)
    - media/film: kodla üretilen 91 s tanıtım filmi (gerçek CAD, özgün swing)
    - 36 masaüstü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
    [REF-6000-2RSH-1.step, REF-6000-2RSH-2.step, REF-BALLAST-1.step, REF-BALLAST-2.step, REF-BALLAST-3.step, REF-BALLAST-4.step, REF-BATTERY.step, REF-BEARING-PAN.step]
2026-09-30 Kod incelemesi: DD92–DD95 düzeltmeleri ve kapanış kayıtları
    - DD92/DD93: 29.09 tam inceleme bulguları (A01–A08, M01–M03), ikiz dişli pençe
    - DD94: DD92/DD93 doğrulaması R01–R06 ve G01 (kör ToF sürünmesi, pençe durumu
    uzlaştırması, ACK penceresi, sol kol taklitleri, çene B burcu, kavrama noktası)
    - DD95: DD94 incelemesi (gevşek pençe başarı sayılmaz, yeniden kurma yarışı,
    kavrama tablosu, pasif twist boşluğu, kör mod panel bildirimi)
    - Codex inceleme raporları ve kanıtları değiştirilmeden eklendi
    - 34/34 masaüstü kontrolü, ESP32-S3 ve ESP32-CAM derlemeleri; fiziksel testler NOT_RUN
    [REF-BALLAST-1.step, REF-BALLAST-2.step, REF-BALLAST-3.step, REF-BALLAST-4.step, REF-BATTERY.step, REF-BEARING-PAN.step, REF-BEARING-SHOULDER-+1.step, REF-BEARING-SHOULDER--1.step]
